brentius/cansat-sync/wiki/references/README.md

# Reference material

[PDR mark scheme](pdr_mark_scheme_reference.pdf) is the retained local reference copy. Confirm its season and applicability before treating it as current competition requirements. The [archived review materials](../history/working_materials/README.md) contain a duplicate PDF and page images, preserved for provenance.

The project's external reference folder is [CANSAT 2027 on Google Drive](https://drive.google.com/drive/folders/1ugYnjOalW-hIZqXO9nSJtGS6KleoJ3KW). It is not a local mount or automatic sync. This housekeeping pass did not fetch or verify its contents.

Keep source documents here and interpretation in the main wiki. Record source dates and applicability when adding references.
