brentius/cansat-sync/wiki/history/working_materials/proposal_body.md

# Mission Proposal: Terrain-Relative Navigation and Wind Profiling

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

## 1. Summary

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

## 2. Motivation and framing

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

## 3. Scientific value

### Questions and hypotheses

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

### Physical model and limits

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

$$
\mathbf w(s)=\mathbf u(s)+\ell_\tau\,\frac{d\mathbf u}{ds}.
$$

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

## 4. Mission objectives and success levels

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

**T4 — stretch:** demonstrate uncertainty-aware safe-target selection without steering or an actual divert.

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

## 5. Ambition ladder

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

## 6. Rules and preliminary compliance

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

## 7. Concept of operations

| Phase | Intended activity | Verification dependency |
|---|---|---|
| Preparation | Obtain launch-site orthoimage, calibrate camera/extrinsics/probe, build maps/prediction tables, configure radio and ground logs | Real imagery, calibrated build and confirmed rules/channel |
| Pad waiting, up to 3 h | STM32 primary/housekeeping logs; Pi idle or controlled startup; independent GNSS and ground anemometer available as planned | Endurance, boot and ground-support rehearsal; no GNSS pose seeding of TRN |
| Ascent | High-rate STM32 IMU/pressure logging and capture; retain event history; camera start policy tested | Firmware/event detection and shock qualification outstanding |
| Ejection and inflation | Trigger camera; log full-field frames and STM32 trigger times; establish swing-averaged tilt reference | Settling/event definitions and frame association measured |
| First fix | Search unknown heading/position, refine pose and confirm agreement over two distinct images | T1 clock starts at defined canopy settling; no promise of a fixed three-image sequence |
| Tracking above 80 m | Fine matcher -> 17-state filter; selected prediction/validity summary to STM32; 1 Hz primary-priority telemetry | Fine matcher, handoff and integrated application remain open |
| Lower altitude | Retain valid available estimates and conservative prediction; proposed visual odometry tested before use | Below-80 m vision is a development item, not an existing switch-over capability |
| Touchdown/recovery | Detect/log candidate touchdown; beacon; save ground records before attempting recovery | Accelerometer/contact and independent GNSS/time evidence cross-checked |
| Analysis | Synchronise records; score primary, acquisition, tracking, wind and prediction; label missing/invalid observations | Raw logs retained; simulation truth never substituted for missing flight measurements |

## 8. System architecture

### Hardware/data path

```mermaid
flowchart TD
  BAT[Protected 2S pack / master switch / protection] --> AON[Independent 3.3 V supply]
  BAT --> PI5[5.1 V buck / controlled Pi load switch]
  AON --> MCU[STM32F405 on MAIN]
  AON --> RF[Top RF: MAX-M10S and E22]
  AON --> TEMP[Quiet 3.0 V: external NTC / OPA333 / ADS1115]
  IMU[BMI088 and MS5611 on MAIN] --> MCU
  TEMP --> MCU
  RF -->|GNSS PVT and PPS; radio interface| MCU
  MCU --> NOR[Independent SPI NOR sensor/event log]
  PI5 --> PI[Side-mounted Pi Zero 2 W]
  MCU -->|Buffered UART 230400; captures/integrals| PI
  PI -->|Selected navigation/prediction and heartbeat| MCU
  MCU -->|Level-shifted XTR; TIM2 capture| CAM[Bottom IMX296 GS camera]
  CAM -->|Zero-specific CSI cable| PI
  PI --> SD[256 GB microSD: images / maps / processed log]
  MCU -->|40-byte primary-priority packet via E22| GROUND[Receiver / laptop / graph and map logs]
```

### Primary software path

```mermaid
flowchart LR
  S[MS5611 and external NTC readout] --> C[STM32: calibration / compensation / timestamps]
  C --> L[Independent sensor log]
  C --> P[1 Hz packet: temperature and pressure]
  P --> R[E22 radio]
  R --> G[Ground decode / CRC / timestamps / save]
  G --> A[Pressure and temperature graphs / altitude analysis]
```

### Secondary software path

```mermaid
flowchart TD
  MAP[Prepared site map and calibrated optics] --> ACQ[Coarse heading/position search / pose solve / confirmation]
  IMG[CSI frames linked to STM32 trigger times] --> ACQ
  ACQ -->|Confirmed first pose; handoff to implement| NAV[17-state ESKF]
  IMG --> MATCH[Fine matcher: integration outstanding]
  MAP --> MATCH
  MATCH --> NAV
  I[STM32 cumulative IMU integrals and pressure] --> NAV
  NAV --> PRED[TRN wind / landing predictor]
  NAV --> LOG[Pi navigation/quality log]
  PRED --> LOG
  LOG --> SCI[Post-flight smoothing / S1 and conditional S2-S4]
  GNSS[Separate GNSS PVT reference] --> COMP[GNSS comparison predictor and truth log]
  COMP --> SCI
  PRED --> TX[Selected summary to STM32 radio packet]
```

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

## 9. Map preparation

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

## 10. Map-relative localisation

### Rectification and optics

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

### Acquisition implementation

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

### Tracking and low altitude

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

## 11. Navigation filter

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

## 12. Error budget and uncertainty

The first-order design model is

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

## 13. Landing prediction

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

## 14. Safe-target selection — stretch

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

## 15. Hardware, mechanics and budgets

| Assembly | Selected parts / function |
|---|---|
| MAIN | STM32F405; BMI088; MS5611; ADS1115/OPA333/150 kOhm temperature readout; independent converters/quiet LDO; Pi switch/buffers; W25Q128; sounder/LEDs |
| RF | MAX-M10S and active GNSS antenna feed; E22-900M22S and FPC radio antenna |
| Bottom | Official IMX296 GS camera, Edmund lens/adapter/lock nut; CSI directly to Pi, XTR from STM32 |
| Side | Pi Zero 2 W, Zero CSI cable and 256 GB microSD; buffered UART and switched power from MAIN |
| Power / harness | Protected KeepPower 2S pack, accessible E-Switch master switch, XT30 harness, GH connectors, MAIN J4 Wuerth 61202021621 and keyed IDC ribbon mates |
| Mechanics / recovery | Enclosure/frame, optics/window/probe shield, fasteners, cable retention, passive canopy/lines/swivel/hardpoint: not completely designed or qualified |

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

## 16. Software and implementation status

| Function | Target / candidate implementation | Status |
|---|---|---|
| STM32 sensor/timing/power/radio firmware | C/C++; captured sensor/PPS/XTR timing, watchdog, independent logging/1 Hz telemetry | Not implemented |
| Pi sensor/time link | `link.py`, cumulative IMU differencing, trigger association; 230400 baud | Python reference/golden vectors; laptop only |
| First fix | `coarse.py`, `firstfix.py`; 1 m/px map and two-image confirmation | Synthetic validation; Pi timing and real terrain outstanding |
| Tracking/navigation | Fine matcher + `eskf.py`; nominal 100 Hz propagation, image updates as budget allows | Filter exists; fine matcher/handoff/full flight application incomplete |
| Wind / landing | `windprofile.py`, `landing.py`; selected predictor to STM32 | Synthetic component/closed-loop studies; hardware untested |
| Radio/ground data | `telemetry.py` defines 40-byte packet | Reference encode/decode; actual radio/ground integration incomplete |
| Capture/logging/ground UI | Camera setup, bounded queues, save raw frames/quality; laptop graphs/maps | Full application and sustained writes unverified |
| Low-altitude odometry / T4 | Optional future modules | Not implemented flight capability |

Python/NumPy is the current candidate navigation stack. OpenCV or a compiled implementation may support calibrated image processing after profiling; they are not evidence of target execution. Capture cadence, matcher latency, filter update timing and logging throughput must be budgeted independently. Temperature readout also has an unresolved constraint: the <=6% excitation goal conflicts with the study's 128 SPS/10 Hz paired-read bench schedule (~19.41% duty). Resolve settling/rate/self-heating before firmware adoption.

## 17. Verification campaign

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

## 18. Risks and degradation

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

## 19. Results analysis

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

## 20. Roles and support

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

## 21. Schedule and decision gates

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

## 22. PDR and outreach evidence

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

## 23. Outstanding decisions and evidence

- Confirm current-season rulebook/rubric/deadlines, regional/final launch sites, channel allocation and parachute mass treatment.
- Obtain representative orthoimages and check permissions/datum/extent; nearest atmospheric reference sources remain to be selected.
- Prove selected lens/adapter infinity focus, retention, envelope and calibrated ray mapping.
- Measure Pi capture/matching/logging worst-case performance; finish firmware, fine matcher and acquisition-filter handoff.
- Choose/qualify passive canopy and complete mechanical/material/access design; weigh full assembly and obtain delivered flight quotes.
- Resolve thermistor pulse/read schedule against <=6% duty, installed response and science precision; no TMP117 substitution without redesign.
- Secure/select the ground reference instrument/support and calibrate any proposed lateral-force airspeed correction.
- Test GNSS receiver dynamics and independent touchdown scoring; a GNSS feed defined by the protocol is not yet integrated hardware.
- Agree actual student ownership, available hours, support and outreach dates.

## Mathematical appendices: interpretation for the current design

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

---
