brentius/cansat-sync/wiki/mainboard_placement.md

# MAIN placement — 4 October 2026

**Historical placement snapshot (4 October 2026).** These coordinates and zero-routing statements describe that saved review state only. The later 11 October inspection recorded discrepancies between this note and the then-saved PCB; consult [the current mass/power report's discrepancy register](mass_power_budget.md) and inspect the current board before using dimensions or coordinates for manufacture. The purchasing authority is the [flight-computer BOM](flight_computer_bom.md); see [design baseline](design_baseline.md).

Updated `pcb/cansat_control/cansat_control.kicad_pcb`. This is component placement only: **zero track segments and zero routed vias**. All 124 original components remain on the front side, with their original footprint assignments, pad geometry, component IDs and net assignments.

## Mechanical arrangement

- Expanded the original 40 × 60 mm board to the authorised **44 × 65 mm** to accommodate the shrouded RF header, harness access, mounting clearances and local circuit groups on one assembly side.
- Outline: X = 78–122 mm, Y = 67.5–132.5 mm. Geometric centre: (100, 100) mm.
- BMI088 U2: **(100, 95) mm**, exactly **5 mm toward the top** from the centre and centred left-to-right, following the user's final correction. Orientation is 270° (KiCad may display −90°); use the final assembly orientation when defining sensor-to-camera/body axes.
- H1/H2/H3/H4: (81, 70.5), (119, 70.5), (81, 129.5), (119, 129.5) mm. Hole centres retain the original **3 mm edge inset**, now symmetric on the enlarged board. The mounting pattern is 38 × 59 mm; update any mating mechanical model to these coordinates.
- Every footprint courtyard is inside the outline, and every copper-pad bounding box has at least 0.5 mm edge clearance. There are no overlapping front-side courtyards.

## Placement intent

The RF ribbon connector spans the top region. Camera and optional compass connectors and the debug pads are accessible above it. The analogue temperature circuit and flash occupy the upper-left region, with the pressure sensor above the IMU. The MCU sits below the IMU, with the crystal to its right and VCAP/decoupling capacitors at their associated pin banks. Clock source resistors remain close to their MCU source pins.

The 3.3 V buck is at the upper right; the 5.1 V buck, input protection and Pi load switch occupy the lower region. Both converters have adjacent inductors and input/output capacitor groups. The Pi harness is on the right and the recovery sounder is on the left. These placements reserve short local power/clock connections; routing and return-current paths still need to be designed.

Small component references are available on F.Fab. Major devices and connectors have visible silkscreen references. No package substitutions or schematic edits were made.
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
