brentius/cansat-sync/wiki/mathematics_simulation_audit.md

# Mathematical simulation and feasibility audit

1 October 2026. All physical results below are **simulated**, unless explicitly labelled as measured host timings. No flight measurements were available.

The tested mathematics is consistent under its stated models. The core estimation calculations are small enough to be credible CanSat candidates, and an excessive-memory reference matcher has been fixed. **Real-flight feasibility is not established:** canopy/suspension response, terrain/map errors, correspondence integrity, sensor timing and compute throughput on the current Raspberry Pi Zero 2 W remain unmeasured. The independent models are not a complete image-to-navigation-to-wind flight pipeline. Current component choices and the distinction between current design targets and unverified
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
