brentius/cansat-sync/sim/maths/attachment_audit/coverage-50.png

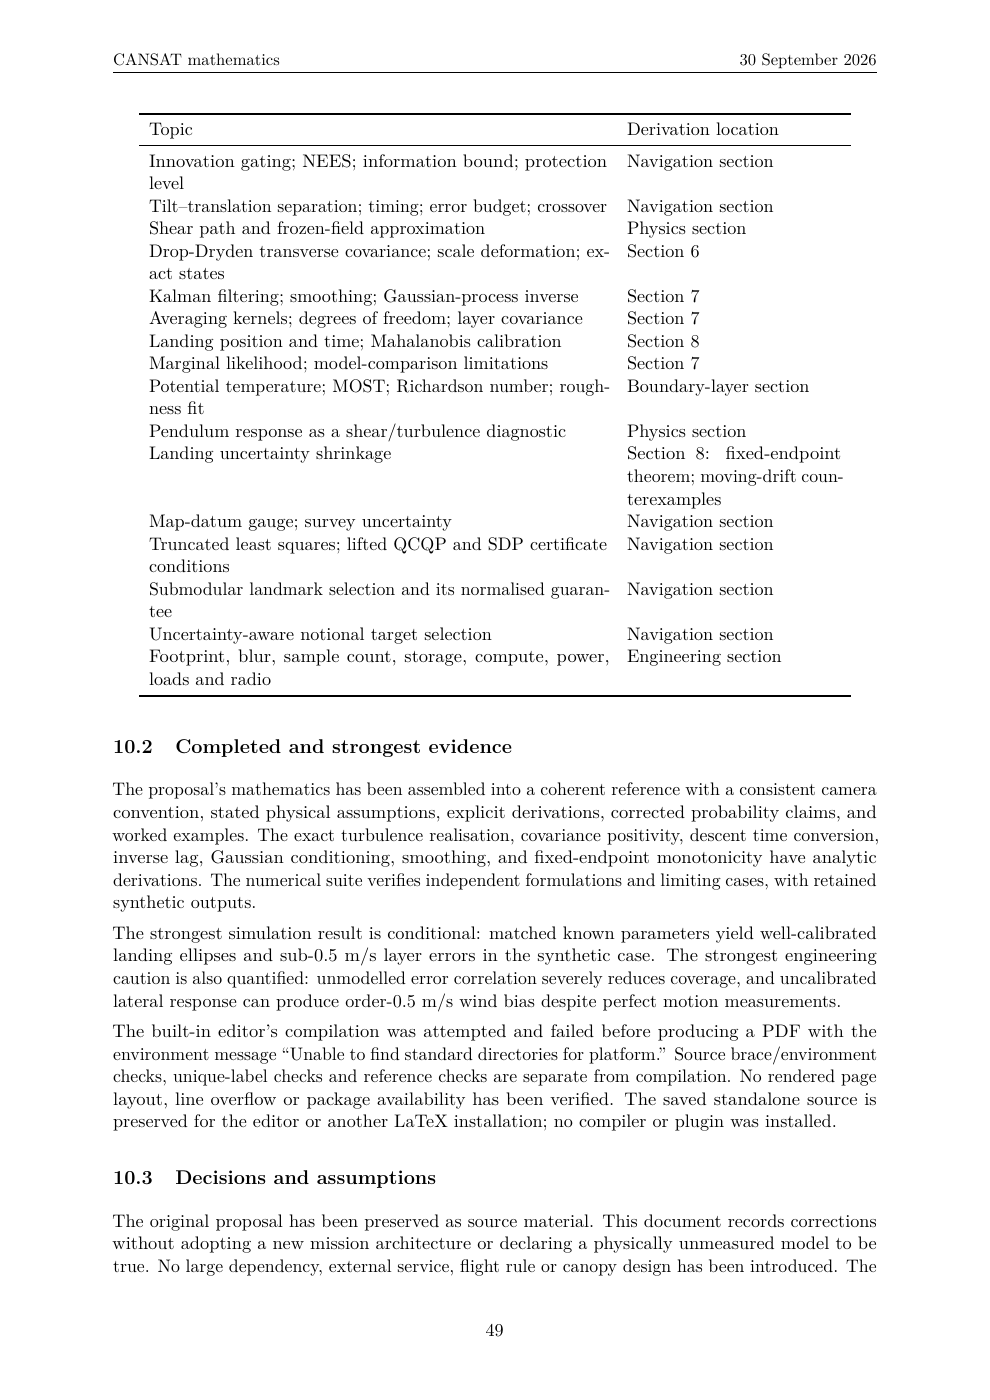
sim/maths/attachment_audit/coverage-50.png
