brentius/cansat-sync/sim/maths/attachment_audit/navigation-22.png

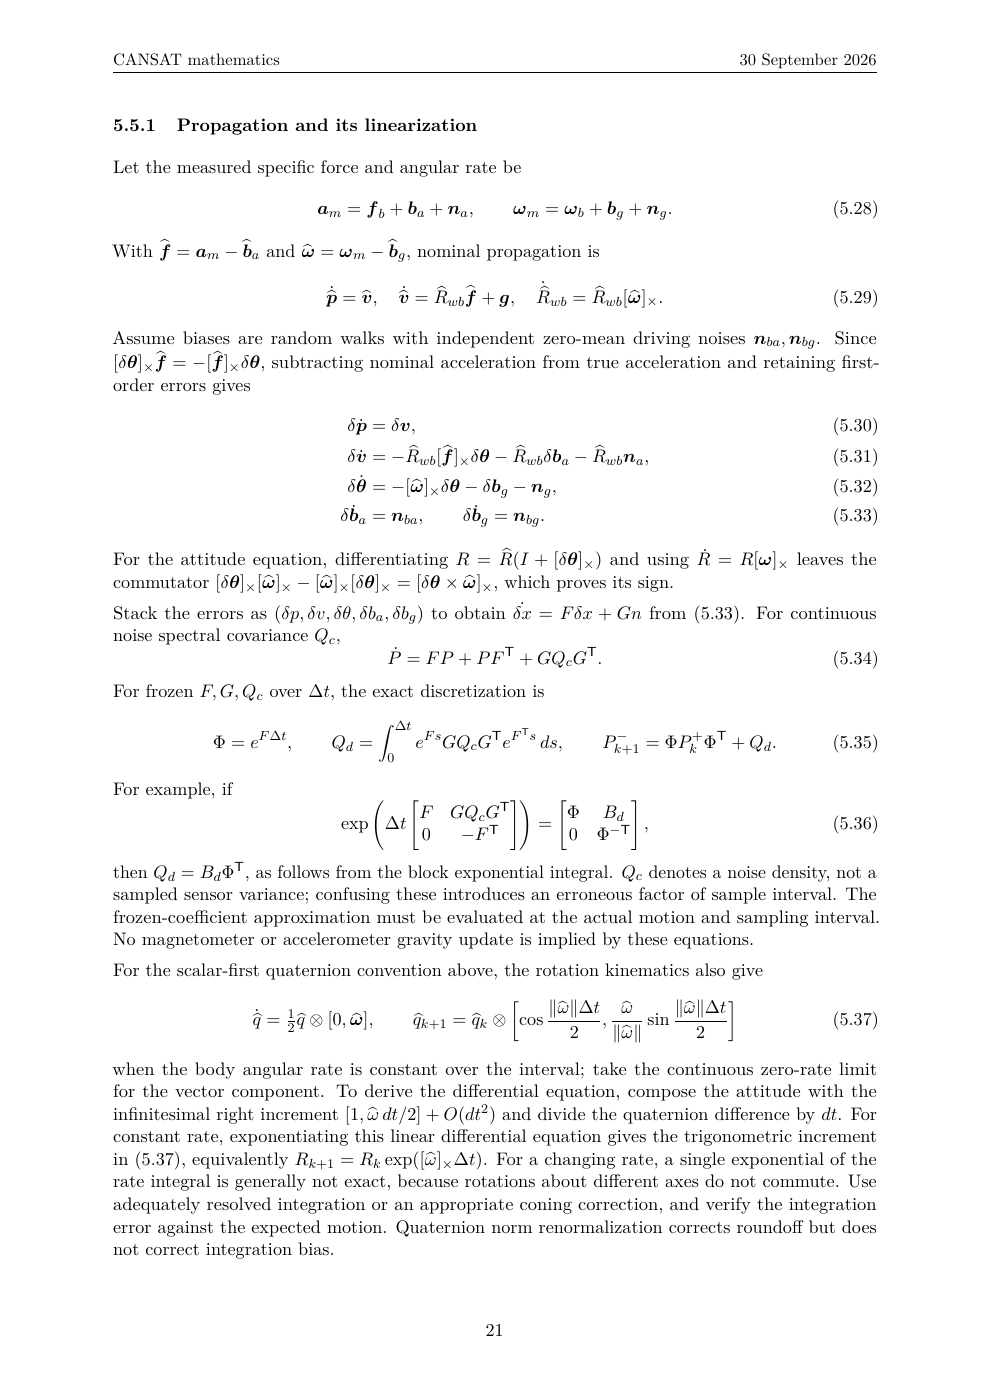
sim/maths/attachment_audit/navigation-22.png
