brentius/cansat-sync/sim/maths/attachment_audit/turbulence-34.png

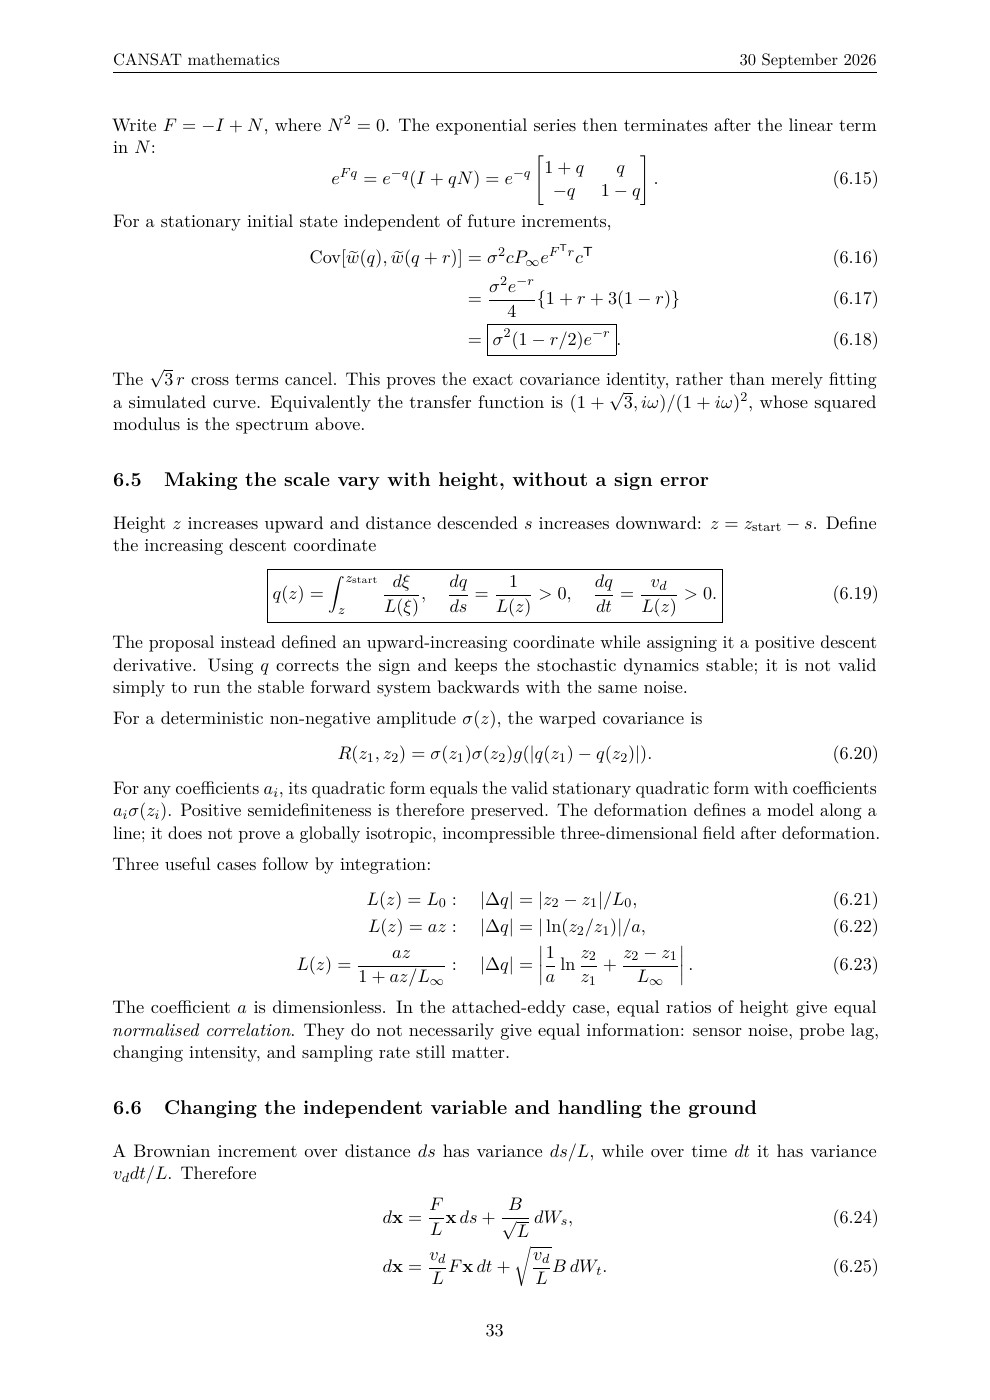
sim/maths/attachment_audit/turbulence-34.png
