brentius/cansat-sync/wiki/history/working_materials/README.md

# Archived working materials

Moved out of the repository-root `tmp/` directory on 26 October 2026. These are retained editorial and review artifacts, not current design authority. All seven original files were moved without changing their bytes; [the relocation manifest](relocation_manifest.json) records their original paths and SHA-256 hashes.

- `proposal_body.md`: retained proposal draft. Its relative links were written for `wiki/` and are preserved as originally saved. Read the [current proposal](../../trn_secondary_mission_proposal.md) for live work.
- `pdfs/pdr_mark_scheme.pdf`: retained review copy, byte-identical at relocation to the [reference PDF](../../references/pdr_mark_scheme_reference.pdf).
- `pdfs/rubric-1.png` through `rubric-5.png`: retained rubric page images.

The archive date describes this relocation, not the creation date or rules season of the source material. The rubric's applicability to the current season still needs confirmation.
