brentius/cansat-sync/wiki/flight_computer_bom.md

# Flight computer component BOM

**Board allocation revised 22 October 2026:** the user selected separate **POWER** and **MAIN** PCBs. The [all-board BOM summary](board_bom_summary.md) assigns every existing fitted control-board component exactly once: POWER 35, MAIN 76, plus the separately planned RF electronics. It defines the required POWER–MAIN signals and additional interconnect allowance. The older "Middle MAIN" component tables below retain their combined-board selections and purchasing allowances; use the summary for the revised per-board allocation and exact saved quantities. The saved KiCad control project has not yet been split into two designs.

Prepared 1 October 2026; revised 3 October 2026 against the **installed KiCad 10.0 stock libraries**. This remains the purchasing baseline; the [design baseline](design_baseline.md) summarises current cross-document authority and status. Dated inventory and price observations below are historical snapshots, not live availability. Main computer: Raspberry Pi Zero 2 W. Timing and primary telemetry controller: STM32F405RGT6.

This is a component-selection BOM for your KiCad design, with the necessary support parts included. It is not an assembly upload or a validated schematic. Quantities marked **allowance** need reconciliation against your final schematic; converter capacitor effective values, crystal loading and optical focus still need checking in the actual layout.

The companion [schematic connection guide](flight_computer_connections.md) groups these parts into functional sheets and specifies IC pins, STM32 allocation, power nets and connector pinouts. The user's chosen physical arrangement is a circular top RF board, middle main board, bottom camera module and Pi mounted separately along the side.

**Temperature budget correction:** FP07 is excluded at the user's approximately $200 quote. The analogue prototype now uses TE GA10K3MCD1 at £12.468 including VAT before shipping, conditional on installed air-response testing. A stocked ~$1 TMP117 digital redesign and other choices are detailed in [budget temperature options](temperature_options.md). The **£400 limit is for the whole CanSat**; sensor cost, PCB assembly fees, optics, mechanics, VAT and delivery all need inclusion.

## Physical board allocation

| Assembly | Parts assigned to it |
|---|---|
| POWER PCB | Input fuse/reverse protection/clamp/TVS, both bucks and support, quiet 3.0 V LDO, Pi load switch and battery-voltage divider/filter; 35 existing fitted parts allocated |
| MAIN PCB | STM32 and support, UART buffers, BMI088 and its ferrite, MS5611, temperature ADC/buffer/excitation circuit, SPI flash, buzzer/LEDs and Pi/camera/probe/RF connectors; 76 existing fitted parts allocated |
| Top RF PCB | MAX-M10S, GNSS ferrite/decoupling, complete antenna bias/DC-block network and U.FL; E22 radio with its local supply capacitors and CS/reset/TXEN/RXEN default resistors |
| Bottom camera module | Existing camera/lens assembly; CSI goes directly to Pi, trigger/GND goes to MAIN |
| Side-mounted Pi | Existing Pi Zero 2 W and microSD; power/buffered UART from MAIN |

The older purchasing tables separate the **combined control-board allowance** from RF. The [all-board BOM summary](board_bom_summary.md) now partitions the saved control quantities into POWER and MAIN; do not add those split quantities again to the older combined allowance. The [RF PCB BOM](#top-rf-pcb-gnss-and-radio-bom) includes its complete local support network. The [PCB and inter-board hardware allowance](#pcb-fabrication-and-inter-board-hardware) now covers three fabricated boards and the additional POWER–MAIN interconnect. MAIN J4 is the selected Würth 61202021621 shrouded 2×10 connector; the compatible RF-side half, stack height/cable, mating details, cost and availability remain **not selected or checked**. Inventory snapshots retain their stated dates.

## Mission basis

The local [secondary mission proposal](trn_secondary_mission_proposal.md) calls for GPS-denied terrain-relative navigation during a roughly 30-second, 300–400 m parachute descent: 5 Hz global-shutter imagery, 100 Hz navigation, independent GNSS truth, and fast air-temperature measurements. The supplied [UK guidelines in Drive](https://drive.google.com/file/d/1LubKeC729i9NbmgHwG-wzu4gwhDO1PfJ/view) require 1 Hz temperature/pressure telemetry, three hours of continuous operation, a 66 mm diameter × 115 mm body, 300–350 g total mass, survival of 20 g, and a £400 flight budget. The document is for 2025–26; confirm the 2026–27 rules before freezing the design.

| Constraint | Design consequence |
|---|---|
| Pi Zero 2 W selected by the user | Pi handles camera, image processing and SD logging; the STM32 handles timing, sensors and radio. Its 512 MB RAM makes bounded image/map buffers essential. Achieving 5 Hz TRN remains a benchmark requirement. |
| Primary mission survives vision failure | Separate battery-fed 3.3 V converter powers the STM32, primary sensors and radio. The STM32 can switch off/restart the Pi branch. A shared battery or STM32 failure remains a common failure mode. |
| Camera/IMU alignment target ≤0.5 ms | Hardware camera trigger, IMU data-ready capture and GNSS PPS capture use STM32 timers. Linux arrival timestamps are insufficient. |
| Three-hour endurance | Approximately 24 Wh protected 2S Li-ion pack; efficient buck conversion. This supports a roughly 6 W average load after a conservative combined 20% energy/conversion derating. Runtime is not established until measured. |
| Scientific temperature profile | A small external NTC probe in ventilated, radiation-shielded air, thermally separated from the Pi. Qualify its installed response and calibration; barometer die temperature is only for pressure compensation. |
| Narrow cylindrical enclosure | Mount the 65 × 30 mm Pi vertically: its rectangular diagonal exceeds 66 mm. Use a welded battery pack, retained cables and mechanically secured optics. Fit must be checked in your mechanical model. |
| Passive descent | No motor, servo or deployment drivers are included. |

Power path: **protected 2S pack → master switch → fuse/reverse protection → independent 5.1 V and 3.3 V bucks**. The 5.1 V branch supplies Pi/camera through a controllable load switch. A 3.0 V LDO from the always-on 3.3 V rail supplies the thermistor ADC and buffer.

## JLCPCB stock-check method

Unless explicitly marked **3 Oct**, counts below were read from the live JLCPCB Assembly Parts Library on **1 October 2026**. The replacement BMI088, AO3401A, CUI buzzer, optional LIS3MDL, added gate-clamp Zener and 47 pF GNSS capacitor were checked on **3 October 2026**. Counts are available inventory snapshots, not reserved quantities. Prices are displayed one-unit USD prices, excluding assembly, extended-part fees, shipping and tax. Use the specified manufacturer as well as the part number: cheaper listings with a similar sensor name were sometimes from a different manufacturer. Every selected electronic component below has a checked JLC code; unselected PCB/inter-board hardware is explicitly marked TBD, and offboard purchased assemblies are listed separately.

## KiCad stock-library selection

I checked the actual files under `C:/Users/b_yee23/AppData/Local/Programs/KiCad/10.0/share/kicad/`, and the configured global symbol table includes those default libraries. All **60 unique stock symbol/footprint identifiers** in the assignments below were verified as present. These names therefore refer to your installed library, rather than an online library version that might differ.

Changes for this revision:

- **BMI088 replaces ICM-42688-P** as the baseline IMU: stock symbol and footprint, lower price, vibration robustness and ±24 g launch measurement. The ICM remains a lower-noise alternative requiring a custom symbol/footprint. BMI088 gyro noise is higher; validate attitude performance rather than assuming equal performance.
- **AO3401A replaces AO3407A** for both P-channel MOSFET positions. It has an exact stock symbol, the same SOT-23 G/S/D pin numbering, and ratings suitable for the expected load after thermal/drop review.
- **CMT-8504-100-SMT-TR replaces MLT8530** for recovery audio: an exact stock footprint is installed. Drive at 4 kHz; its 100 dB rating applies at 5 V, not at the selected 3.3 V supply.
- **LIS3MDLTR replaces MMC5983MA** as the optional compass: exact stock symbol/footprint and sufficient range for a calibrated yaw aid. It does not provide the same resolution/noise as the MMC5983MA.

The **TPS22965** remains a custom-symbol exception to retain the 3 A Pi branch's current headroom and controlled ramp. Its standard TI DSG footprint is installed. The stocked-library TPS22917 is limited to 2 A; TPS22993 cannot switch 5.1 V. The **E22-900M22S** remains a custom-symbol/custom-footprint exception: the stock-library RFM95W-868S2 alternative has **zero JLC stock** in the checked listings on 3 October (including C7279189 and C22365863). Do not replace it with the stock RFM95 symbol; the module pinouts and radio drivers differ.

### MAIN and RF IC symbol and footprint assignments

All listed stock symbol and footprint identifiers below were found in the installed library files. A generic or family symbol is appropriate where its pinout matches; set **Value**, **Manufacturer Part Number** and **JLCPCB Part #** to the purchased component, not to the alias name. Library presence is not a substitute for the final datasheet/land-pattern review.

| Purchased part | Stock schematic symbol | Stock footprint / remaining work |
|---|---|---|
| STM32F405RGT6 | `MCU_ST_STM32F4:STM32F405RGTx` | `Package_QFP:LQFP-64_10x10mm_P0.5mm` |
| TPS62130RGTR | `Regulator_Switching:TPS62130` | `Package_DFN_QFN:VQFN-16-1EP_3x3mm_P0.5mm_EP1.68x1.68mm_ThermalVias` |
| TPS62162DSGR | `Regulator_Switching:TPS62162DSG` | `Package_SON:Texas_DSG0008A_WSON-8-1EP_2x2mm_P0.5mm_EP0.9x1.6mm_ThermalVias` |
| TPS7A2030PDBVR | `Regulator_Linear:TPS7A20xxxDBV` | `Package_TO_SOT_SMD:SOT-23-5`; family symbol, set the 3.0 V MPN explicitly |
| TPS22965DSGR | **No exact stock symbol found; custom symbol required** | `Package_SON:Texas_DSG0008A_WSON-8-1EP_2x2mm_P0.5mm_EP0.9x1.6mm_ThermalVias`; include exposed pad 9 and its datasheet connection in the custom symbol |
| SN74LVC2G125DCUR | `74xGxx:74LVC2G125` | `Package_SO:VSSOP-8_2.3x2mm_P0.5mm`; manually assign this **DCU** footprint—the generic symbol has no default. Place both buffer units and the power unit. |
| BMI088 | `Sensor_Motion:BMI088` | `Package_LGA:Bosch_LGA-16_4.5x3mm_P0.5mm_LayoutBorder7x1y_ClockwisePinNumbering` |
| MS561101BA03-50 | `Sensor_Pressure:MS5611-01BA` | `Package_LGA:LGA-8_3x5mm_P1.25mm`; JLC's package label says QFN, but the manufacturer's leadless land pattern is represented by this LGA footprint |
| ADS1115IDGSR | `Analog_ADC:ADS1115IDGS` | `Package_SO:TSSOP-10_3x3mm_P0.5mm`; TI calls DG(S) VSSOP, whereas KiCad names this body/pitch TSSOP |
| OPA333AIDBVR | `Amplifier_Operational:OPA333xxDBV` | `Package_TO_SOT_SMD:SOT-23-5` |
| MAX-M10S-00B | `RF_GPS:MAX-M10S` | `RF_GPS:ublox_MAX` |
| E22-900M22S | **No exact stock symbol found; custom module symbol required** | **No exact stock footprint found; use the Ebyte module's recommended pad drawing**. Resolve the manufacturer pad-12 discrepancy flagged in the connection guide against the purchased module revision. |
| W25Q128JVSIQ | `Memory_Flash:W25Q128JVS` | `Package_SO:SOIC-8_5.3x5.3mm_P1.27mm`; use this wide-body footprint, not the common 3.9 mm SOIC-8 |
| Optional LIS3MDLTR | `Sensor_Magnetic:LIS3MDL` | `Package_LGA:LGA-12_2x2mm_P0.5mm` |

### Support-part assignments

The generic stock symbols below deliberately retain the exact electrical component selections in the purchasing tables.

| BOM parts | Stock symbol | Stock footprint |
|---|---|---|
| All Yageo 0603 resistors, including precision 150 kΩ | `Device:R` | `Resistor_SMD:R_0603_1608Metric` |
| All 0603 MLCCs, including C0G crystal/RF capacitors | `Device:C` | `Capacitor_SMD:C_0603_1608Metric` |
| All 0805 MLCCs | `Device:C` | `Capacitor_SMD:C_0805_2012Metric` |
| MWSA0402S-2R2MT, both bucks | `Device:L` | `Inductor_SMD:L_Sunlord_MWSA0402S` |
| 0451005.MRL fuse | `Device:Fuse` | `Fuse:Fuse_Littelfuse-NANO2-451_453` |
| AO3401A, both P-channel positions | `Transistor_FET:AO3401A` | `Package_TO_SOT_SMD:SOT-23`; pin 1 gate, 2 source, 3 drain |
| AO3400A buzzer switch | `Transistor_FET:AO3400A` | `Package_TO_SOT_SMD:SOT-23`; pin 1 gate, 2 source, 3 drain |
| SMF9.0A unidirectional TVS | `Device:D_Zener` | `Diode_SMD:D_SOD-123F`; set Value to SMF9.0A and retain correct cathode/anode orientation |
| BZT52C8V2 gate-clamp Zener | `Device:D_Zener` | `Diode_SMD:D_SOD-123`; cathode to reverse-protection MOSFET source, anode to its gate |
| BLM21PG221SN1D ferrites | `Device:L_Ferrite` | `Inductor_SMD:L_0805_2012Metric` |
| X50328MSB2GI two-pin crystal | `Device:Crystal` | `Crystal:Crystal_SMD_5032-2Pin_5.0x3.2mm`; do not select the four-pin variant |
| LQG15HS27NJ02D RF choke | `Device:L` | `Inductor_SMD:L_0402_1005Metric` |
| U.FL-R-SMT-1(80) | `Connector:Conn_Coaxial` | `Connector_Coaxial:U.FL_Hirose_U.FL-R-SMT-1_Vertical` |
| BM08B-GHS-TBT(LF)(SN) | `Connector_Generic:Conn_01x08` | `Connector_JST:JST_GH_BM08B-GHS-TBT_1x08-1MP_P1.25mm_Vertical` |
| BM04B-GHS-TBT(LF)(SN), probe/trigger and optional compass | `Connector_Generic:Conn_01x04` | `Connector_JST:JST_GH_BM04B-GHS-TBT_1x04-1MP_P1.25mm_Vertical` |
| Red 0603 LEDs | `Device:LED` | `LED_SMD:LED_0603_1608Metric` |
| CMT-8504-100-SMT-TR | `Device:Buzzer` | `Buzzer_Beeper:MagneticBuzzer_CUI_CMT-8504-100-SMT` |
| SS14 flyback diode | `Diode:SS14` | `Diode_SMD:D_SMA` |
| SWD/rail/reset test pads | `Connector:TestPoint` | `TestPoint:TestPoint_Pad_D1.0mm`; no purchased header |

Battery, Pi, camera, antennas, master switch and thermistor probe are **offboard assemblies**. Represent the pack with `Device:Battery`, master switch with `Switch:SW_SPDT`, and probe with `Device:Thermistor_NTC`, connected through the harness symbols. They need no invented component footprints on the main PCB. The GH housings/crimp contacts are cable parts, not PCB footprints. XT30U-M/F are cable connectors in this BOM; represent their board wiring with suitable wire pads/test points, rather than silently substituting a board-mount XT30 variant.

## Middle MAIN PCB: processors, converters and sensors

All rows have quantity 1 unless shown otherwise. E = Extended assembly part; B = Basic.

| Function | Exact component / package | JLCPCB code, stock, unit price | Why this component |
|---|---|---|---|
| Timing/telemetry MCU | **ST STM32F405RGT6**, LQFP-64 | [C15742](https://jlcpcb.com/partdetail/STMicroelectronics-STM32F405RGT6/C15742): **4,190**, $5.9532, E | 168 MHz Cortex-M4F, 1 MB flash, 192 KB RAM; timers, DMA, SPI and UART capacity comfortably cover timestamping, sensor acquisition, flash logging and independent radio telemetry. More capable than strictly necessary, but well stocked and inexpensive. Use its independent watchdog. [ST specifications](https://www.st.com/content/st_com/en/products/microcontrollers-microprocessors/stm32-32-bit-arm-cortex-mcus/stm32-high-performance-mcus/stm32f4-series/stm32f405-415/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). |
| Pi/camera supply | **TI TPS62130RGTR**, VQFN-16 | [C43590](https://jlcpcb.com/partdetail/TexasInstruments-TPS62130RGTR/C43590): **30,139**, $1.3071, E | Synchronous buck, up to 3 A, compatible with the complete 2S input range. Set about 5.1 V to allow cable drop. Low loss compared with a linear regulator. [TI reference design](https://www.ti.com/product/TPS62130). |
| Independent digital supply | **TI TPS62162DSGR**, WSON-8 | [C40256](https://jlcpcb.com/partdetail/TexasInstruments-TPS62162DSGR/C40256): **6,697**, $1.2794, E | Fixed 3.3 V, 1 A synchronous buck directly from the battery. Keeps STM32, radio and primary sensing operating when the Pi branch is disabled. [TI specifications](https://www.ti.com/product/TPS62162). |
| Quiet temperature supply | **TI TPS7A2030PDBVR**, SOT-23-5 | [C963429](https://jlcpcb.com/partdetail/TexasInstruments-TPS7A2030PDBVR/C963429): **5,909**, $0.2309, E | Fixed 3.0 V low-noise LDO from 3.3 V; powers the ADC and thermistor buffer with little heat. [TI specifications](https://www.ti.com/product/TPS7A20). |
| Pi restart switch | **TI TPS22965DSGR**, WSON-8 | [C122837](https://jlcpcb.com/partdetail/TexasInstruments-TPS22965DSGR/C122837): **16,055**, $0.2468, E | Low-resistance 6 A load switch with adjustable rise time; STM32 controls Pi power and camera power together. Connect its bias supply within the datasheet limits, not to raw 2S. [TI specifications](https://www.ti.com/product/TPS22965). |
| Pi UART isolation | **TI SN74LVC2G125DCUR**, VSSOP-8 | [C21404](https://jlcpcb.com/partdetail/TexasInstruments-SN74LVC2G125DCUR/C21404): **4,894**, $0.2067, E | Two tri-state buffers, one per UART direction. Disable both while the Pi is off to prevent signal-pin back-powering. [TI specifications](https://www.ti.com/product/SN74LVC2G125). |
| IMU, baseline | **Bosch BMI088**, LGA-16, 4.5 × 3 mm | [C194919](https://jlcpcb.com/partdetail/BoschSensortec-BMI088/C194919): **4,457**, $6.7920, E, **3 Oct** | Exact KiCad stock symbol/footprint, vibration robustness, stable gyro bias and ±24 g acceleration range. Suitable for both descent navigation and nominal 20 g launch measurement. Gyro noise is 0.014°/s/√Hz, higher than the original ICM choice; validate the attitude target. Use gyro at about 1 kHz, timestamp both sensor data-ready signals and fuse at 100 Hz. Accel and gyro have separate chip-selects/ODRs; implement Bosch's synchronisation method or timestamp/resample explicitly. [Bosch specifications](https://www.bosch-sensortec.com/en/products/motion-sensors/imus/bmi088), [datasheet](https://www.bosch-sensortec.com/media/boschsensortec/downloads/datasheets/bst-bmi088-ds001.pdf). |
| Pressure, baseline | **TE MS561101BA03-50**, QFN-8, 5 × 3 mm | [C15639](https://jlcpcb.com/partdetail/TEConnectivity-MS561101BA0350/C15639): **1,700**, $6.7059, E | MS5611-01BA03 supplied in the -50 packaging variant. OSR4096 provides 0.012 mbar RMS resolution, approximately 0.10 m near sea level, with 9.04 ms maximum conversion time. Suitable for 50 Hz pressure with slower temperature-compensation updates. Use factory coefficients, PROM CRC and second-order compensation. Internal temperature does not replace the air probe. [TE datasheet](https://www.te.com/commerce/DocumentDelivery/DDEController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). |
| Thermistor ADC | **TI ADS1115IDGSR**, VSSOP-10 | [C37593](https://jlcpcb.com/partdetail/TexasInstruments-ADS1115IDGSR/C37593): **26,547**, $1.2193, E | 16-bit ADC with PGA and up to 860 conversions/s. Measure both excitation voltage and buffered divider voltage so supply drift largely cancels. Enough resolution and rate for the ≤0.1 K relative-temperature goal after calibration. [TI datasheet](https://www.ti.com/lit/ds/symlink/ads1115.pdf). |
| Thermistor buffer | **TI OPA333AIDBVR**, SOT-23-5 | [C30878](https://jlcpcb.com/partdetail/TexasInstruments-OPA333AIDBVR/C30878): **3,884**, $1.3054, E | Low-offset, low-drift unity-gain buffer stops the ADC's input loading from disturbing the high-resistance thermistor divider. [TI specifications](https://www.ti.com/product/OPA333). |
| Independent flight log | **Winbond W25Q128JVSIQ**, wide SOIC-8, 208 mil | [C97521](https://jlcpcb.com/partdetail/WinbondElec-W25Q128JVSIQ/C97521): **51,390**, $2.5523, B | 16 MB SPI NOR records sensors and fault events independently of Linux. Use a rolling preflight buffer and preserve the descent log; it is not enough for three hours of uncompressed 1 kHz logging. [Winbond family](https://www.winbond.com/hq/product/code-storage-flash-memory/serial-nor-flash/). |

## Middle MAIN PCB: electrical support BOM

Counts in this table are **for MAIN only**. Small resistor/capacitor counts marked allowance include reserve positions for decoupling, straps and damping; remove unused positions when assigning designators. RF quantities are listed separately below; the combined quantities of existing components are unchanged. These are real purchasable MPNs, not generic values.

| Qty | Exact component | Value / role and justification | JLCPCB code / checked stock |
|---|---|---|---|
| 2 | Sunlord **MWSA0402S-2R2MT** | Shielded 2.2 µH, 4.5 A rated, 5 A saturation; one per buck. Check ripple, thermal rise and converter frequency against TI's reference circuits. | [C408335](https://jlcpcb.com/partdetail/Sunlord-MWSA0402S2R2MT/C408335), **20,270**, E |
| 1 | Littelfuse **0451005.MRL** | 5 A fuse, **2410** package, battery input fault protection. Not 1206. | [C48467](https://jlcpcb.com/partdetail/Littelfuse-0451005MRL/C48467), **34,890**, E |
| 2 | AOS **AO3401A** | P-channel SOT-23 MOSFET: one reverse-battery protection device; one pulsed thermistor excitation switch. Exact stock symbol. 30 V rating, ≤60 mΩ at −4.5 V gate drive and ≤85 mΩ at −2.5 V. Check reverse-protection voltage drop and temperature at peak input current; its catalogue 4 A rating is not an unconditional board-level current rating. [AOS datasheet](https://www.aosmd.com/sites/default/files/res/datasheets/AO3401A.pdf). | [C15127](https://jlcpcb.com/partdetail/Alpha_OmegaSemicon-AO3401A/C15127), **764,818**, $0.1017, **B, 3 Oct** |
| 1 | MDD **BZT52C8V2** | 8.2 V gate-to-source clamp for the reverse-protection AO3401A, whose gate limit is ±12 V. SOD-123; cathode to source, anode to gate, with the 100 kΩ gate-to-ground resistor. | [C173432](https://jlcpcb.com/partdetail/184821-BZT52C8V2/C173432), **101,308**, $0.0150, **E, 3 Oct** |
| 1 | MDD **SMF9.0A** | 9 V standoff TVS, SOD-123FL; reduces input transients. Its quoted clamp does not by itself prove the complete input survives every surge. | [C123798](https://jlcpcb.com/partdetail/MDD_Microdiode_Semiconductor-SMF90A/C123798), **410**, E |
| 1 | Murata **BLM21PG221SN1D** | 0805 ferrite, 220 Ω at 100 MHz, 2 A; filtered BMI088 supply branch with local capacitors. | [C85840](https://jlcpcb.com/partdetail/MurataElectronics-BLM21PG221SN1D/C85840), **310,648**, E |
| 1 | YXC **X50328MSB2GI** | 8 MHz, 20 pF load, two-pin 5032 crystal; stable MCU timer reference with PPS calibration. No RTC crystal is needed for this mission. | [C115962](https://jlcpcb.com/partdetail/YXC_CrystalOscillators-X50328MSB2GI/C115962), **167,479**, B |
| 2 | Walsin **0603N330J500CT** | 33 pF C0G, 0603, crystal loading starting value. Two 33 pF capacitors give 16.5 pF plus board stray capacitance; final value requires layout/startup review. | [C302065](https://jlcpcb.com/partdetail/Walsin_TechCorp-0603N330J500CT/C302065), **2,295**, E |
| 23 allowance | Samsung **CL10B104KB8NNNC** | 100 nF, 50 V X7R, 0603; local IC supply decoupling. Include every STM32 VDD and VDDA pin and every module supply specified by its manufacturer. | [C1591](https://jlcpcb.com/partdetail/1943-CL10B104KB8NNNC/C1591), **1,744,951**, E |
| 8 allowance | Samsung **CL10A225KP8NNNC** | 2.2 µF, 10 V X5R, 0603; includes **two dedicated STM32 VCAP capacitors**, LDO output and local bulk. Verify effective LDO output capacitance; VCAP must follow ST's reference circuit. | [C1607](https://jlcpcb.com/partdetail/1959-CL10A225KP8NNNC/C1607), **195,011**, E |
| 1 | Samsung **CL21A475KOFNNNE** | **4.7 µF, 16 V X5R, ±10%, 0805**, actual C5 at STM32 VDD. Added 4 October to correct the earlier 2.2 µF VDD-bulk selection to ST's supply scheme; both VCAP capacitors remain 2.2 µF. [Manufacturer specification](https://product.samsungsem.com/mlcc/CL21A475KOFNNN.do), [ST supply scheme](https://www.st.com/resource/en/datasheet/stm32f405rg.pdf). | [LCSC C1746](https://www.lcsc.com/product-detail/C1746.html); part-code mapping checked 4 October. JLC assembly stock/price not independently confirmed. |
| 4 allowance | Samsung **CL10A105KB8NNNC** | 1 µF, 50 V X5R, 0603; LDO input, ADC/barometer bulk and STM32 VDDA decoupling. | [C15849](https://jlcpcb.com/partdetail/16531-CL10A105KB8NNNC/C15849), **6,286,584**, B |
| 4 allowance | Samsung **CL21A106KAYNNNE** | 10 µF, 25 V X5R, 0805; two input capacitors per buck. Check effective capacitance and input ripple. | [C15850](https://jlcpcb.com/partdetail/16532-CL21A106KAYNNNE/C15850), **5,007,032**, B |
| 6 allowance | Samsung **CL21A226MAYNNNE** | 22 µF, 25 V X5R, 0805; two output capacitors per buck and two on the switched Pi supply. Verify effective capacitance and startup/inrush. | [C602037](https://jlcpcb.com/partdetail/631473-CL21A226MAYNNNE/C602037), **83,259**, E |
| 4 allowance | Samsung **CL10B103KB8NNNC** | 10 nF, 50 V X7R, 0603; TPS62130 soft start, load-switch rise-time control, buffered ADC input and battery ADC filtering. Timing values need checking against the final circuit. | [C1589](https://jlcpcb.com/partdetail/1941-CL10B103KB8NNNC/C1589), **1,907,336**, E |
| 1 optional DNP | Walsin **0603N101J500CT** | 100 pF C0G, 0603; reserve buck feed-forward position only if required by TI. Not the GNSS DC block. | [C335544](https://jlcpcb.com/partdetail/Walsin_TechCorp-0603N101J500CT/C335544), **502,070**, E |
| 1 | Yageo **RC0603FR-07806KL** | 806 kΩ, 1%; upper 5.1 V feedback resistor. | [C185311](https://jlcpcb.com/partdetail/YAGEO-RC0603FR07806KL/C185311), **4,642**, E |
| 1 | Yageo **RC0603FR-07150KL** | 150 kΩ, 1%; lower feedback resistor. With 0.8 V reference: 0.8 × (1 + 806/150) = **5.099 V nominal**, including neither tolerance nor regulator error. | [C114660](https://jlcpcb.com/partdetail/YAGEO-RC0603FR07150KL/C114660), **1,106,977**, E |
| 1 | Yageo **RT0603BRD07150KL** | 150 kΩ, **0.1%, 25 ppm/K**; thermistor divider reference, not the looser regulator resistor. | [C326734](https://jlcpcb.com/partdetail/YAGEO-RT0603BRD07150KL/C326734), **17,891**, E |
| 16 allowance | Yageo **RC0603FR-0710KL** | 10 kΩ, 1%; reset, BOOT0/BOOT1, SPI chip-select/WP/HOLD, power-enable/OE, data-ready and power-good defaults. Select default directions deliberately. | [C98220](https://jlcpcb.com/partdetail/YAGEO-RC0603FR0710KL/C98220), **12,185,377**, E |
| 6 allowance | Yageo **RC0603FR-074K7L** | 4.7 kΩ, 1%; two pull-ups on each I²C bus plus ADC ready pull-up. The optional compass shares the pressure bus and its existing pull-ups. Check rise time for your trace/cable capacitance. | [C99782](https://jlcpcb.com/partdetail/YAGEO-RC0603FR074K7L/C99782), **9,331,383**, E |
| 1 | Yageo **RC0603FR-071K5L** | 1.5 kΩ; camera XTR series divider resistor. | [C114668](https://jlcpcb.com/partdetail/YAGEO-RC0603FR071K5L/C114668), **922,091**, E |
| 1 | Yageo **RC0603FR-071K8L** | 1.8 kΩ; XTR divider to ground: 3.3 × 1.8/(1.5+1.8) = **1.8 V**. | [C185354](https://jlcpcb.com/partdetail/YAGEO-RC0603FR071K8L/C185354), **577,230**, E |
| 4 allowance | Yageo **RC0603FR-0733RL** | 33 Ω; two SPI clock damping resistors, buzzer MOSFET gate resistor and one reserve position. | [C108661](https://jlcpcb.com/partdetail/YAGEO-RC0603FR0733RL/C108661), **822,732**, E |
| 5 allowance | Yageo **RC0603FR-07100KL** | 100 kΩ; reverse, temperature and buzzer MOSFET defaults, battery divider upper leg and Pi-TX buffer input pulldown. | [C14675](https://jlcpcb.com/partdetail/YAGEO-RC0603FR07100KL/C14675), **8,549,274**, E |
| 1 | Yageo **RC0603FR-0747KL** | 47 kΩ; battery divider lower leg. 8.4 V input becomes 2.69 V; RC-filter before STM32 ADC and use adequate sample time. | [C105579](https://jlcpcb.com/partdetail/YAGEO-RC0603FR0747KL/C105579), **363,001**, E |
| 3 | Yageo **RC0603FR-07330RL** | 330 Ω; two LED current limits and one buffer-to-ADC isolation resistor. | [C105881](https://jlcpcb.com/partdetail/YAGEO-RC0603FR07330RL/C105881), **1,720,504**, E |
| 1 | Yageo **RC0603FR-0710RL** | 10 Ω, 0603; STM32 VDDA supply-filter resistor. | [C109318](https://jlcpcb.com/partdetail/YAGEO-RC0603FR0710RL/C109318), **5,941,076**, E |
| 1 | JST **BM08B-GHS-TBT(LF)(SN)** | Locking 8-pin Pi harness: three 5.1 V contacts, three grounds, UART TX/RX. GH is rated 1 A/contact; parallel conductors are intentional, not a claim that one contact carries 3 A. | [C133062](https://jlcpcb.com/partdetail/JST-BM08B_GHS_TBT_LF_SN/C133062), **14,397**, E |
| 2 | JST **BM04B-GHS-TBT(LF)(SN)** | Locking 4-pin connectors for camera trigger and thermistor probe. Spare positions permit clean grounding/strain relief. | [C161692](https://jlcpcb.com/partdetail/JST-BM04B_GHS_TBT_LF_SN/C161692), **14,334**, E |
| 2 | Everlight **19-217/R6C-AL1M2VY/6T** | Red 0603 status LEDs; low forward voltage works comfortably from 3.3 V. Distinct blink patterns avoid a display. | [C2986060](https://jlcpcb.com/partdetail/EverlightElec-19_217_R6C_AL1M2VY6T/C2986060), **251,813**, E |
| 1 | CUI / Same Sky **CMT-8504-100-SMT-TR** | Magnetic **4 kHz** recovery sounder with an exact stock footprint. Operates over 1–6 V, so retain the independent 3.3 V supply. Its 100 dB/150 mA specifications are at 5 V: verify actual loudness and current at 3.3 V. Keep away from the compass and allow its 4.5 mm maximum height. [Manufacturer datasheet](https://www.sameskydevices.com/product/resource/cmt-8504-100-smt-tr.pdf). | [C22359707](https://jlcpcb.com/partdetail/CUI-CMT_8504_100_SMTTR/C22359707), **64**, $2.5214, **E, 3 Oct** |
| 1 | AOS **AO3400A** | Logic-level N-channel SOT-23 buzzer switch; avoids loading the MCU pin with the sounder's drive current. Size the 3.3 V rail and local bulk for buzzer pulses. | [C20917](https://jlcpcb.com/partdetail/Alpha_OmegaSemicon-AO3400A/C20917), **967,679**, B |
| 1 | MDD **SS14** | SMA Schottky flyback diode across the magnetic sounder. | [C2480](https://jlcpcb.com/partdetail/MDD_Microdiode_Semiconductor-SS14/C2480), **1,172,259**, B |

All Yageo RC0603 parts above are 0603, 1%, 0.1 W. Keep manufacturer value/voltage/dielectric specifications when substituting cheaper Basic passives. Exposed SWD, reset, ground and rail **test pads** require no purchased header. Do not omit STM32 analogue supply filtering, VCAP parts, thermal pads, regulator pin straps or GNSS supply decoupling when drawing the schematic.

## Top RF PCB: GNSS and radio BOM

Build **one circular RF PCB** at the top of the CanSat. The following components belong on RF, not on MAIN. The old connection-guide names U11/U12 were proposal designators, not current RF references; the saved RF schematic uses RF U1 MAX-M10S and RF U2 E22-900M22S. Each separate KiCad project should carry its own fabrication BOM. There is no second MCU or converter on RF: MAIN supplies +3V3_AON and the STM32 interface signals through the inter-board connector.

### RF receiver and radio modules

Quantity **1 each**. Stock/price dates follow the JLC method above; moving the modules has not refreshed their 1 October inventory snapshots.

| Function | Exact component / package | JLCPCB code, stock, unit price | Why this component |
|---|---|---|---|
| GNSS truth/PPS | **u-blox MAX-M10S-00B**, LCC module | [C4153167](https://jlcpcb.com/partdetail/UBLOX-MAX_M10S00B/C4153167): **665**, $10.7732, E | Low-power multi-GNSS receiver, UART navigation/velocity output and time pulse. Configure an appropriate airborne dynamic model and capture PPS in the STM32. Log velocity as independent wind truth; do not feed GNSS position into the GPS-denied estimator. Dynamic launch validity and velocity accuracy require checking. [u-blox datasheet](https://content.u-blox.com/sites/default/files/MAX-M10S_DataSheet_UBX-20035208.pdf). |
| Telemetry radio | **Ebyte E22-900M22S**, SX1262 SPI module, 20 × 14 mm | [C411293](https://jlcpcb.com/partdetail/Chengdu_Ebyte_ElecTech-E22900M22S/C411293): **408**, $6.9140, E | Integrates the RF matching and oscillator that otherwise complicate the PCB. STM32 handles BUSY/DIO/TXEN/RXEN according to the module manual. Tunable around UK sub-GHz channels; supply must support its transmit pulses. Send compact data, not images. [Ebyte product information](https://www.ebyte.com/product/435.html). |

### RF local support parts

These are quantities **per RF PCB**, already deducted from MAIN's original whole-set allowances. All RF electronic components in this table were stocked in the stated dated checks; the inter-board connector is still TBD in the hardware table.

| Qty | Exact component | Value / role and justification | JLCPCB code / checked stock |
|---|---|---|---|
| 1 | Murata **BLM21PG221SN1D** | 0805 ferrite, 220 Ω at 100 MHz, 2 A; +3V3_AON → +3V3_GNSS filtering. Keep the GNSS capacitors downstream; do not put a ferrite in GND. | [C85840](https://jlcpcb.com/partdetail/MurataElectronics-BLM21PG221SN1D/C85840), **310,648**, E |
| 3 | Samsung **CL10B104KB8NNNC** | 100 nF, 50 V X7R, 0603; two on MAX-M10S (VCC and V_IO) and one beside E22 VCC. Fit locally on RF rather than relying on MAIN decoupling. | [C1591](https://jlcpcb.com/partdetail/1943-CL10B104KB8NNNC/C1591), **1,744,951**, E |
| 2 | Samsung **CL21A106KAYNNNE** | 10 µF, 25 V X5R, 0805; one GNSS bulk capacitor after its ferrite and one radio bulk capacitor. | [C15850](https://jlcpcb.com/partdetail/16532-CL21A106KAYNNNE/C15850), **5,007,032**, B |
| 1 | Samsung **CL21A226MAYNNNE** | 22 µF, 25 V X5R, 0805; local E22 transmit-burst bulk, in parallel with its 10 µF and 100 nF. Verify supply droop at transmit power. | [C602037](https://jlcpcb.com/partdetail/631473-CL21A226MAYNNNE/C602037), **83,259**, E |
| 1 | Samsung **CL10B103KB8NNNC** | 10 nF, 50 V X7R, 0603; GNSS active-antenna bias decoupling at GNSS_ANT_BIAS. | [C1589](https://jlcpcb.com/partdetail/1941-CL10B103KB8NNNC/C1589), **1,907,336**, E |
| 1 | Walsin **0603N470J500CT** | 47 pF, 50 V C0G/NP0, 0603; GNSS antenna DC block following the u-blox integration manual's reference value. | [C302069](https://jlcpcb.com/partdetail/Walsin_TechCorp-0603N470J500CT/C302069), **19,504**, $0.0089, **E, 3 Oct** |
| 4 | Yageo **RC0603FR-0710KL** | 10 kΩ, 1%; two pull-ups (RADIO_CS_N and RADIO_RESET_N) and two pull-downs (RADIO_TXEN and RADIO_RXEN). Fit on RF so the radio has safe defaults with the connector unplugged. | [C98220](https://jlcpcb.com/partdetail/YAGEO-RC0603FR0710KL/C98220), **12,185,377**, E |
| 1 | Yageo **RC0603FR-0710RL** | 10 Ω, 0603; MAX-M10S VCC_RF active-antenna bias-feed resistor per u-blox reference. It is not complete short-circuit protection. | [C109318](https://jlcpcb.com/partdetail/YAGEO-RC0603FR0710RL/C109318), **5,941,076**, E |
| 1 | Murata **LQG15HS27NJ02D** | 27 nH, 0402 RF choke; GNSS antenna bias network. Follow the u-blox RF layout and verify impedance at GNSS frequencies. | [C12669](https://jlcpcb.com/partdetail/MurataElectronics-LQG15HS27NJ02D/C12669), **139,883**, E |
| 1 | Hirose **U.FL-R-SMT-1(80)** | GNSS antenna connector. Ebyte module already has its own antenna socket; do not add another blindly. | [C88374](https://jlcpcb.com/partdetail/HRS_Hirose-U_FL_R_SMT_1_80/C88374), **84,519**, E |

The GNSS module uses the installed `RF_GPS:MAX-M10S` symbol and `RF_GPS:ublox_MAX` footprint. Its passives, ferrite/choke and U.FL use the installed stock assignments above. The E22 needs its own symbol/footprint; **resolve its pad-12 documentation discrepancy against the purchased revision before fabrication**. The E22 already contains its RF matching network, oscillator and antenna socket; this BOM adds no second radio antenna socket, TCXO or external matching network.

Connect the active GNSS antenna to the new RF-board U.FL and the radio FPC antenna to the E22's existing socket. Those two antenna assemblies are purchased once in the offboard table below. Keep both antenna coax connections on RF; the inter-board connector carries only power, ground and digital signals. Keep a continuous ground reference beneath the GNSS feed, and select a manufacturable stack-up/trace geometry for 50 Ω. The GNSS patch looks upward under an RF-transparent lid; the radio FPC remains against the non-metallic side with clearance from cells/Pi. Validate GNSS reception during radio bursts in the assembled CanSat.

**RF module subtotal: $17.6872 ≈ $17.69**, before these support parts, connectors, fabrication, assembly fees, antennas, VAT and delivery. This is a reallocation of the existing GNSS/radio cost, not an extra $17.69 added to the previous IC total.

## PCB fabrication and inter-board hardware

These are purchasing/quote lines for the selected three-board implementation, not JLC component-stock claims. Keep them in the whole-CanSat £400 budget.

| Qty per flight set | Item / allocation | Specification and justification | Selection / cost status |
|---|---|---|---|
| 1 | POWER bare PCB and its assembly | Input protection, supply conversion, Pi load switch and battery-voltage divider/filter; new outline, retention and POWER–MAIN interconnect required. | New fabrication + assembly quote TBD; separate board charges apply |
| 1 | MAIN bare PCB and its assembly | STM32/sensors/logging/recovery and harness connectors; migrate the retained circuits from the combined control project and review outline/holes. | Fabrication + assembly quote TBD; include extended-part fees and any minimum panel/order quantity |
| 1 | Circular top RF bare PCB and its assembly | GNSS/radio and every RF support part listed above. Diameter must fit the actual internal enclosure clearance; 66 mm is the stated external body limit, not an automatic PCB diameter. Select stack-up for the GNSS feed and ground continuity. | Fabrication + assembly quote TBD; separate board design/assembly charges may apply |
| 1 MAIN header; RF mating half/cable TBD | **Würth 61202021621** shrouded 2×10 MAIN J4 | MAIN footprint `Cansat:WR-BHD_61202021621_2x10_P2.54mm` uses manufacturer-recommended 1.1 mm holes. The saved MAIN contact mapping is in the connection guide and completion record. Current rating, matching RF-side half and complete harness remain to be checked against peak load and mechanical spacing. | MAIN header selected; compatible RF MPN/footprint, assembly, JLC availability, cost and cable TBD |
| 1 assembly | POWER–MAIN interconnect, both board endpoints and cable if used | Carries 3.3 V, quiet 3.0 V, switched 5.1 V, ground, Pi enable, converter power-good and battery ADC signals; see the summary for direction and allocation. | MPNs, pinout, current rating, additional local capacitance and cost TBD |
| 1 installed support set | MAIN-to-RF standoffs / screws / retention | Support RF mechanically under launch loads; the electrical connector is not its only retention. Match spacing to connector height and antenna clearance. Do not double-count these in the offboard materials allowance. | Counts, lengths, material, mass and cost TBD from enclosure design; external hardware |
| No purchased part | RF ground / supply test pads | Add GND, +3V3_AON and +3V3_GNSS probe pads for bring-up. Use stock `Connector:TestPoint` / `TestPoint:TestPoint_Pad_D1.0mm`. | Copper features only; no extra header/assembly purchase |

The [physical connection guide](flight_computer_connections.md) specifies the 20 MAIN J4 contacts. The RF-side mating connector and harness endpoint are still unresolved. Leave the SPI clock's 33 Ω source resistor on MAIN; do not purchase another copy on RF. SPI flash also stays on MAIN. The GH parts below remain the Pi/camera/probe harness only.

## Offboard assemblies and hand-fitted parts

These are purchased separately rather than treated as JLC surface-mount assembly parts. External retail stock is not included in the JLC snapshot.

| Qty | Component | Selection and justification | JLC status |
|---|---|---|---|
| 1 | **Raspberry Pi Zero 2 W**, unheadered | Main computer requested by you. Four Cortex-A53 cores and CSI camera interface; omit a tall 40-pin header and retain the power/UART harness mechanically. [Official product](https://www.raspberrypi.com/products/raspberry-pi-zero-2-w/). | Separate assembled board |
| 1 | **Official Raspberry Pi Global Shutter Camera**, Sony IMX296 | Documented external XTR trigger gives a much clearer timing path than an unspecified OV9281 board. 1456 × 1088 sensor; heavier than the September proposal's ~15 g camera, about 34 g before lens. [Official camera](https://www.raspberrypi.com/products/raspberry-pi-global-shutter-camera/). | Separate assembled board |
| 1 | **Pi Zero camera adapter cable**, 150 mm, 22-pin 0.5 mm to 15-pin 1.0 mm CSI | The standard camera-supplied 15-to-15-pin cable does not connect to Pi Zero. Purchase the Zero-specific cable and secure both latches. [Raspberry Pi camera connection documentation](https://www.raspberrypi.com/documentation/accessories/camera.html). | Separate cable |
| 1 | **Edmund Optics #34-711**, 2.5 mm f/2 high-resolution M12 lens | 6.5 mm image circle covers the approximately 6.3 mm IMX296 diagonal; 18 mm lens length suits the small envelope. The simple pinhole/rectilinear estimate is about 90° horizontal; the manufacturer's 125° figure for a different, unspecified sensor width and the stated -36% TV distortion indicate a strongly barrel-distorted mapping. Current optical analysis estimates roughly 110–115° horizontal on the IMX296; use an appropriate fisheye calibration and measure the installed field rather than treating either estimate as a calibrated result. This is a provisional optical choice until infinity focus and adapter clearance are demonstrated. [Lens specifications](https://www.edmundoptics.com/p/2.5mm-fl-high-resolution-f2-micro-video-lens/3949/?PrintPDF=true). | Separate optics |
| 1 each | **Edmund #53-675 C-to-M12 adapter + #64-102 M12 lock nut** | Fits the M12 lens to the camera's supplied C/CS hardware and mechanically locks focus. Verify insertion depth/back focus with the camera before committing the enclosure. [Adapter and accessories](https://www.edmundoptics.com/f/Micro-Video-Imaging-Lens-Accessories/13898/). | Separate optics |
| 1 | **KeepPower protected NCR18650GA 2S1P pack**, supplier SKU **C3-302** | A finished welded, protected pack with two Sanyo GA cells; supplier specifies 7.2 V, minimum 3.3 Ah, 5 A continuous, about 100 g and maximum 19.5 × 37.5 × 67.8 mm. Approximately 23.8 Wh using minimum pack capacity. Protection circuitry is included; do not separately buy loose cells/holders. Balancing is not established by the listing, so use the supplier-approved charging arrangement. [Exact pack listing](https://illumn.com/batteries/18650-keeppower-2s1p-battery-pack-ncr18650ga-3500mah-7-2v.html), [Panasonic cell specifications](https://energy.panasonic.com/eu/business/products/lithium-ion/models/NCR18650GA). | Separate battery; UK sourcing/landed cost needs confirmation |
| 1 pair | **Amass XT30U-M / XT30U-F**, solder connectors | Positive-latching friction power pair, comfortably above expected battery current. Put recessed female contacts on the battery output and add strain relief/insulation. Connect flight-board side through the accessible switch. | Hand-fitted harness |
| 1 | **E-Switch 100SP1T1B1M2QEH**, SPDT toggle used as SPST | Accessible master battery disconnect. Panel-retain inside the permitted body envelope, not as a protrusion through a side wall. Rated DC switching capacity must cover measured input current. | [C273351](https://jlcpcb.com/partdetail/ESwitch-100SP1T1B1M2QEH/C273351): **only 1**, $5.3517; obtain externally for a batch |
| 1 prototype; flight use conditional on qualification | **TE GA10K3MCD1**, 10 kΩ wired micro NTC probe | Budget replacement for FP07. Small 0.5 mm maximum tip with 152 mm fine leads; TE's **200 ms response is in liquid**, so ≤1 s response in the actual shield/airflow is unverified. Keep the existing 150 kΩ reference/ADC/buffer, and calibrate this probe's R(T). [TE specifications](https://www.te.com/en/product-GA10K3MCD1.html), [response condition](https://www.te.com/en/product-CAT-NTC0065.html). [DigiKey UK](https://www.digikey.co.uk/en/products/detail/te-connectivity-measurement-specialties/GA10K3MCD1/5277239): **£10.39 ex VAT / £12.468 inc VAT**, **6,574** shown, checked 3 Oct; delivery extra. | JLC [C3153883](https://jlcpcb.com/partdetail/TEConnectivity-GA10K3MCD1/C3153883): **4**, **$23.8646**, Extended, checked **3 Oct**; external probe, better priced at the checked UK distributor |
| 1 | **Taoglas AGGP.25F.07.0060A**, active GNSS patch/U.FL | Active 25 mm patch simplifies reception on a small board. Follow its ground-plane and mounting guidance and the u-blox antenna-bias reference. Mount looking upward under an RF-transparent lid, away from the converter/Pi. [Antenna datasheet](https://www.taoglas.com/datasheets/AGGP.25F.07.0060A.pdf). | Separate antenna assembly |
| 1 | **Taoglas FXP895.07.0200C**, 868/915 MHz FPC/U.FL | 69.3 × 20 × 0.2 mm, 2 g flexible antenna with 200 mm cable. Fits vertically against a non-metallic body; it will not work correctly behind a metal can wall. Keep clear of cells/PCB and verify the finished antenna match/link. [Manufacturer datasheet](https://www.taoglas.com/datasheets/FXP895.07.0200C.pdf). | Separate antenna assembly |
| 1 | **SanDisk High Endurance 256 GB**, **SDSQQNR-256G-GN6IA** | Pi OS/maps plus raw frames. Full-frame 5 Hz RAW10 is about 9.9 MB/s tightly packed, or 15.8 MB/s in 16-bit storage, before padding/metadata. Three hours at the latter rate is ~171 GB, so 256 GB covers extended tests. V30 rating is useful, but verify sustained logging through the actual Pi interface. [Manufacturer specifications](https://www.sandisk.com/en-ca/products/memory-cards/microsd-cards/sandisk-high-endurance-uhs-i-microsd?sku=SDSQQNR-256G-GN6IA). | Separate storage |
| 1 + 2 | **JST GHR-08V-S** + **GHR-04V-S** housings | Mates for Pi, trigger and probe connectors; genuine GH housings rather than incompatible lookalikes. | External harness parts; no JLC stock claim |
| 16 + spares | **JST SSHL-002T-P0.2** contacts | Crimped GH harness contacts; use the wire gauge allowed by JST and use equal-length parallel power wires. | External harness parts; no JLC stock claim |
| As needed | 26–28 AWG signal wire, power wire sized to XT30/input current, heat-shrink, cable clamps, non-metallic spacers, battery cradle | Wiring and mechanical retention are part of the flight-computer BOM even though cut lengths and fixing counts depend on your enclosure. Avoid spring battery holders for a 20 g launch. | Local mechanical/harness materials |
| 1 fabricated | White ventilated probe radiation shield | Prevent solar/radiant heating without isolating the bead from airflow. Keep within the allowed envelope; validate response in the final installation. | Local fabrication |

The selected battery is a purchase assembly with included protection, not a proposed DIY battery-management circuit. If its sourcing is impractical, a UK pack assembler can supply an equivalent matched-cell, side-by-side **2S1P GA pack, ≥3.3 Ah minimum, ≥5 A discharge, cell-level protection, approximately ≤70 × 40 × 23 mm**. Obtain the pack's actual charging specification and connector arrangement rather than treating all 2S packs as interchangeable.

Charging is offboard, outside the flight BOM. Use a pack-approved **8.4 V CC/CV lithium-ion charger**, no more than the pack's specified 1.7 A standard charge current. A **SkyRC B6neo** can serve as ground charging equipment if the pack is supplied with an appropriate balance harness and its per-cell settings match the pack specification; the listed two-wire pack does not automatically provide that harness. No charger IC or USB power-sharing circuit is needed on the flight PCB.

## Alternatives considered and optional parts

These replace a baseline part or add a stated capability; do not populate every option by default.

| Part | Checked JLC availability | Assessment |
|---|---|---|
| **MS5611**, selected | TE **C15639: 1,700**, $6.7059 | Good altimeter-oriented choice. Its 0.012 mbar RMS is ~10 cm resolution, but absolute error can be ±1.5 mbar at the specified 25°C point, roughly ±12 m near sea level. Tare before launch; it does not guarantee the mission's ~0.5 m relative altitude target across temperature. Use pressure-temperature calibration and validate the installed port. |
| **Bosch BMP388** | [C779278](https://jlcpcb.com/partdetail/BoschSensortec-BMP388/C779278): **5,788**, $5.7695 | Smaller, FIFO-equipped, 1.2 Pa full-bandwidth noise at highest resolution, broadly comparable with MS5611's 1.2 Pa. Its advertised 0.03 Pa noise uses very low bandwidth and cannot be compared directly with a rapidly updated MS5611. Bosch says it is unavailable for new designs and recommends BMP390, which moves it to fallback status. [Bosch datasheet](https://www.bosch-sensortec.com/media/boschsensortec/downloads/datasheets/bst-bmp388-ds001.pdf), [product/lifecycle notice](https://www.bosch-sensortec.com/products/environmental-sensors/pressure-sensors/bmp388/). |
| **Bosch BMP390 / BMP390L** | Genuine Bosch **C5124834 / C2684802: 0 / 0** | Attractive successor with ±3 Pa typical relative accuracy under its specified conditions; unavailable in the checked JLC inventory. Reconsider if stock appears. [Bosch specifications](https://www.bosch-sensortec.com/en/products/environmental-sensors/pressure-sensors/bmp390). |
| **TDK ICM-42688-P** | [C1850418](https://jlcpcb.com/partdetail/TDKInvenSense-ICM_42688P/C1850418): **4,938**, $19.4364, **1 Oct** | Original IMU option: approximately 2.8 mdps/√Hz gyro noise, FIFO and FSYNC; retain as a performance upgrade if BMI088 misses the attitude target. **No exact symbol or footprint found in the installed stock libraries.** It clips acceleration above ±16 g and uses a different driver/pinout. Specify genuine TDK. [TDK datasheet](https://product.tdk.com/system/files/dam/doc/product/sensor/mortion-inertial/imu/data_sheet/ds-000347-icm-42688-p-v1.6.pdf). |
| **ST LIS3MDLTR** | [C478483](https://jlcpcb.com/partdetail/STMicroelectronics-LIS3MDLTR/C478483): **7,673**, $3.7407, **3 Oct** | Optional yaw aid with exact stock symbol and footprint, on a separate daughterboard away from steel cells, converter inductors and buzzer. Supports ±4/8/12/16 gauss, I²C/SPI and 3.3 V operation. Add one GH 4-pin connector/housing and four contacts. Add two 100 nF CL10B104KB8NNNC capacitors (C1 pin 4 to ground, plus VDD decoupling) and one 1 µF CL10A105KB8NNNC bulk capacitor; verify effective bulk capacitance against ST's application circuit. Calibrate hard/soft-iron distortion in the assembled can; magnetic heading is not guaranteed near launch hardware. [ST datasheet](https://www.st.com/resource/en/datasheet/lis3mdl.pdf). |
| **ADI ADXL375BCCZ** | [C579466](https://jlcpcb.com/partdetail/AnalogDevices-ADXL375BCCZ/C579466): **191**, $22.0179 | Optional ±200 g impact/launch recorder if you need measurements above BMI088's ±24 g range. **No exact stock symbol found.** Add its datasheet decoupling and SPI chip-select. Not needed to measure a nominal 20 g launch with BMI088. [ADI specifications](https://www.analog.com/en/products/adxl375.html). |

A BME280 remains adequate for basic primary telemetry, but adding humidity does not solve fast air-temperature response. The external thermistor is retained whichever barometer you select. A second barometer is not needed for this passive mission unless you explicitly want sensor redundancy. A six-axis IMU cannot establish absolute yaw by itself: initialise yaw from a tested magnetometer, a known starting orientation propagated through launch, or a vision orientation search. Include the LIS3MDL daughterboard if the latter approaches do not meet the first-fix target.

## Connections and operating choices that affect the BOM

1. **Timing:** STM32 timer output drives camera XTR through the 1.5 kΩ/1.8 kΩ divider. The official camera requires 1.8 V trigger logic; exposure duration is trigger-low duration plus 14.26 µs. About 485.74 µs low therefore requests 500 µs exposure. Drive trigger inactive/low as appropriate while camera power is absent to avoid back-powering. Apply the documented R11 change only if the camera revision has Q2 populated. Verify exposure timing/frame association with a scope and an optical timing target. [Official trigger documentation](https://www.raspberrypi.com/documentation/accessories/camera.html).
2. **Sensor buses:** dedicate an SPI bus to BMI088, with **separate accelerometer/gyroscope chip-selects and captured data-ready inputs**. Apply Bosch's data-synchronisation configuration or log the two sample streams with separate timestamps; they are not automatically simultaneous. Use separate chip-selects for top-board radio and middle-board flash on SPI2, and validate the short inter-board SPI connection. Put MS5611 on a 3.3 V I²C bus, ADS1115 on a separate bus pulled to its 3.0 V supply. Optional LIS3MDL shares the MS5611 bus. Capture PPS and maintain sequence-numbered, CRC-protected UART packets to Pi. The [STM32-to-Pi link protocol](stm32_pi_link_protocol.md) defines the current framing and recommends 230400 baud; consider 460800 only after a full-load bench test. This supersedes the guide's earlier 921600-baud example. The [connection guide](flight_computer_connections.md) records proposed RF contact mapping; verify the RF endpoint against its saved schematic.
3. **Thermistor:** 3.0 V pulsed excitation → precision 150 kΩ resistor → TE 10 kΩ probe → ground; buffer the divider node. Measure excitation and divider during each pulse. At 25°C the calculated probe dissipation is **3.52 µW** while on; worst-case over resistance is **15 µW**. Duty cycling to ≤6% reduces average self-heating. Allow actual analogue settling and ADC conversions before switching off; validate the temperature range, installed air response and calibration. This probe needs its own R(T) calibration, not FP07 coefficients. See the linked digital option before populating temperature-only electronics if changing implementation.
4. **Pressure port:** use a static-pressure vent protected from direct flow and light. At 10 m/s, air dynamic pressure is about 60 Pa, equivalent to roughly 5 m altitude near sea level—far larger than sensor noise. An airtight box or ram-facing hole defeats either barometer. Timestamp conversion timing and avoid aggressive filters that lag the descent. Confirm JLC's assembly profile meets MS5611's 250°C/40-second solder limit, keep washing/coating out of the port, and allow post-reflow recovery before pressure calibration.
5. **GNSS RF:** use the active-antenna feed circuit and placement from the [u-blox integration manual](https://content.u-blox.com/sites/default/files/MAX-M10S_IntegrationManual_UBX-20053088.pdf). Confirm antenna current is within VCC_RF capability, logic configuration is 3.3 V, and backup supply wiring follows the manual. No separate backup battery is needed. Maintain GNSS as a separately labelled truth data stream.
6. **Radio:** the earlier proposal used **869.525 MHz, LoRa SF7, BW125 kHz, CR4/5, explicit header, CRC, eight-symbol preamble** with a 32-byte payload at 1 Hz (71.936 ms, 7.1936% duty). Current `code/cansat/telemetry.py` sends a **40-byte downlink packet**. The 11 October power budget calculates **82.176 ms (8.2176% at 1 Hz)** for 40 bytes with SF7/BW125/CR4/5. Treat the old 32-byte figure as a historical sizing assumption; it is not the current radio payload. The 32-byte Nav payload in the [STM32-to-Pi link protocol](stm32_pi_link_protocol.md) is a different field set on a different link. Ofcom IR2030/1/19 (official PDF, checked 13 October 2026) permits airborne use in 869.40–869.65 MHz subject to conditions, with a 500 mW ERP maximum and a ≤10% duty-cycle alternative to equivalent spectrum-access/interference-mitigation techniques. The candidate 1 Hz/40-byte airtime is below 10% before retries, but channel allocation, total airtime, ERP, equipment conditions and event requirements still need verification; do not treat the estimate as evidence of compliance. Obtain the organiser's channel allocation and budget all transmissions/retries. [Ofcom IR2030, published 7 April 2026](https://www.ofcom.org.uk/siteassets/resources/documents/spectrum/interface-requirements/ir-2030.pdf).
7. **Boot and power:** primary logging/telemetry starts on STM32 without waiting for Linux. Power the Pi at system switch-on after supply checks, finish Linux/service startup before loading, and leave it powered throughout pad waiting and launch. Idle image processing does not mean Pi power-off; default firmware does not power-cycle on UART silence. Disable UART buffers before removing Pi power. Request clean shutdown where possible and retain a read-only OS plus separate data partition. Do not connect a second USB 5 V source in parallel with your buck without power-source isolation. Log low battery and stop heavy processing before pack protection trips.
8. **Camera processing:** capture the full field then resize for matching rather than blindly cropping to 1280 × 800 and losing ground coverage. The proposed camera/lens changes the original 600 × 375 m footprint; rebuild intrinsics and undistortion maps. Bound image queues, store the map in tiles and measure worst-case first-fix time on the selected Pi.

## Mass, power and cost checks

**Power:** the later [11 October mass/power budget](mass_power_budget.md) is the current estimate: 23.1/19.6/14.8 Wh usable energy across low/typical/high cases, 4.3 Wh typical use for three hours with the Pi idle plus flight and a one-hour beacon, and 335 g expected mass. These are calculated/assumed, not weighed or metered; the current estimate supersedes the rough sizing here. The three-hour full-load case remains a separate risk.

**Mass:** roughly 100 g battery, 10–15 g Pi, 34 g camera, plus lens/adapter, both custom PCBs, inter-board connector/supports, antennas, wires and retention. These leave a plausible allocation for enclosure and parachute under 350 g, but the complete mechanical BOM is not yet weighed. Target about **330 g total** and add securely fixed ballast only if below 300 g. The original proposal's ~20 g camera addition no longer applies. Verify the whole camera/lens/pack stack inside 115 mm before manufacturing the PCB.

**Cost:** the mandatory IC/module rows sum to about **$45.49** across both boards: **MAIN $27.80 + RF $17.69** at the checked one-unit prices, before support parts, the inter-board connector and both PCB fabrication/assembly quotes. This is approximately **$12.64 less** than the previous IC selection because BMI088 replaces ICM-42688-P; the stock-footprint buzzer adds approximately $2.31 elsewhere in the support BOM. Prices mix the explicitly dated 1/3 October snapshots. Optics are significant: the referenced lens is $87.40 and adapter $32.75 before tax/shipping, with the lock nut extra. Do not claim compliance with £400 from IC prices alone: obtain an assembly quote including extended-part fees and a landed UK quote for the battery and optics, then include enclosure/parachute and all flight hardware. A cheaper lens is possible only after verifying image-circle coverage, focus and distortion; an arbitrary CCTV lens is not an equivalent substitution.

The remaining engineering gates are the **5 Hz Pi processing benchmark, three-hour full-system runtime, actual optical focus/fit/calibration, final mass/cost, and final schematic/layout review**. The dated component stock checks cover the selected PCB electronic parts; MAIN J4 is selected, while its compatible RF mating part/cable and fabrication/assembly costs remain unresolved or unquoted. These checks are not evidence that the engineering gates have already passed.

## Saved MAIN completion — 4 October 2026

The MAIN schematic now contains 124 board components, including four mounting holes and optional DNP J5. Actual references and completed support-part wiring are recorded in [MAIN completion](mainboard_completion.md); use those saved references rather than the earlier proposed U numbering. U10 is SN74LVC2G125DCUR and actual U11 is W25Q128JVSIQ.

The RF connector choice is now a short ribbon harness with **Würth 61202021621**, shrouded 2×10, 2.54 mm, on MAIN J4. Its project footprint uses the manufacturer's 1.1 mm recommended holes. No JLC availability or price is asserted for this newly selected header. The female keyed IDC mates and cable are separate harness purchases. [Manufacturer drawing](https://www.we-online.com/components/products/datasheet/61202021621.pdf).

Added C43 100 nF / Samsung CL10B104KB8NNNC and C44 22 uF / Samsung CL21A226MAYNNNE locally at the sounder supply, beyond the original guide's passive allowance. C43 is 0603; C44 is 0805. J2 uses BM08B-GHS-TBT(LF)(SN), J3 and DNP J5 use BM04B-GHS-TBT(LF)(SN). All new component footprints are assigned.
