brentius/cansat-sync/wiki/history/working_materials/pdfs/rubric-1.png

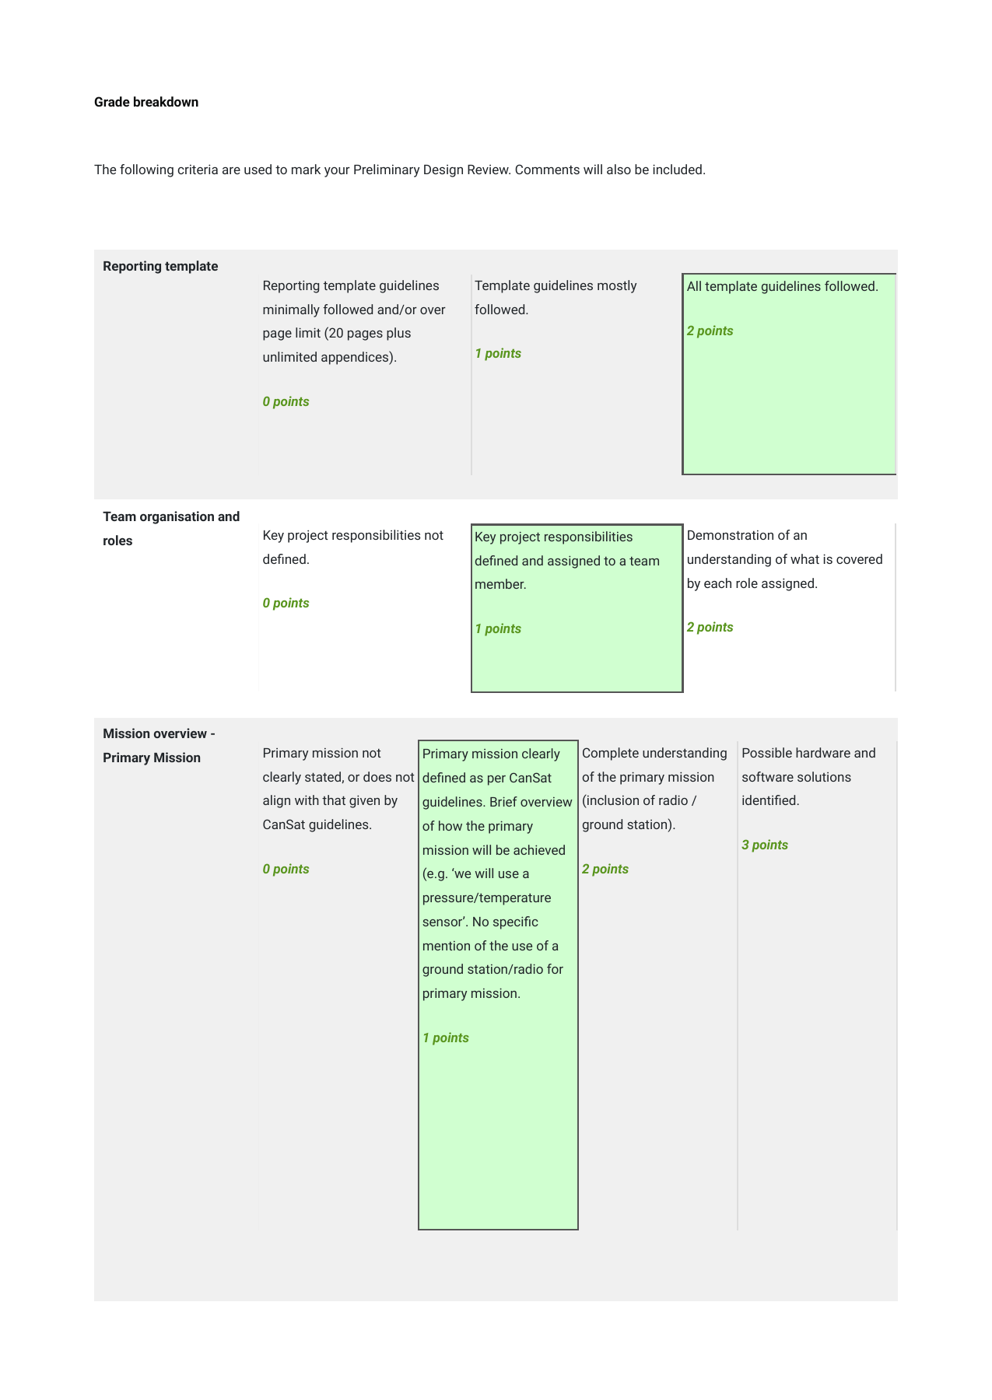
wiki/history/working_materials/pdfs/rubric-1.png
