brentius/cansat-sync/wiki/history/working_materials/pdfs/rubric-2.png

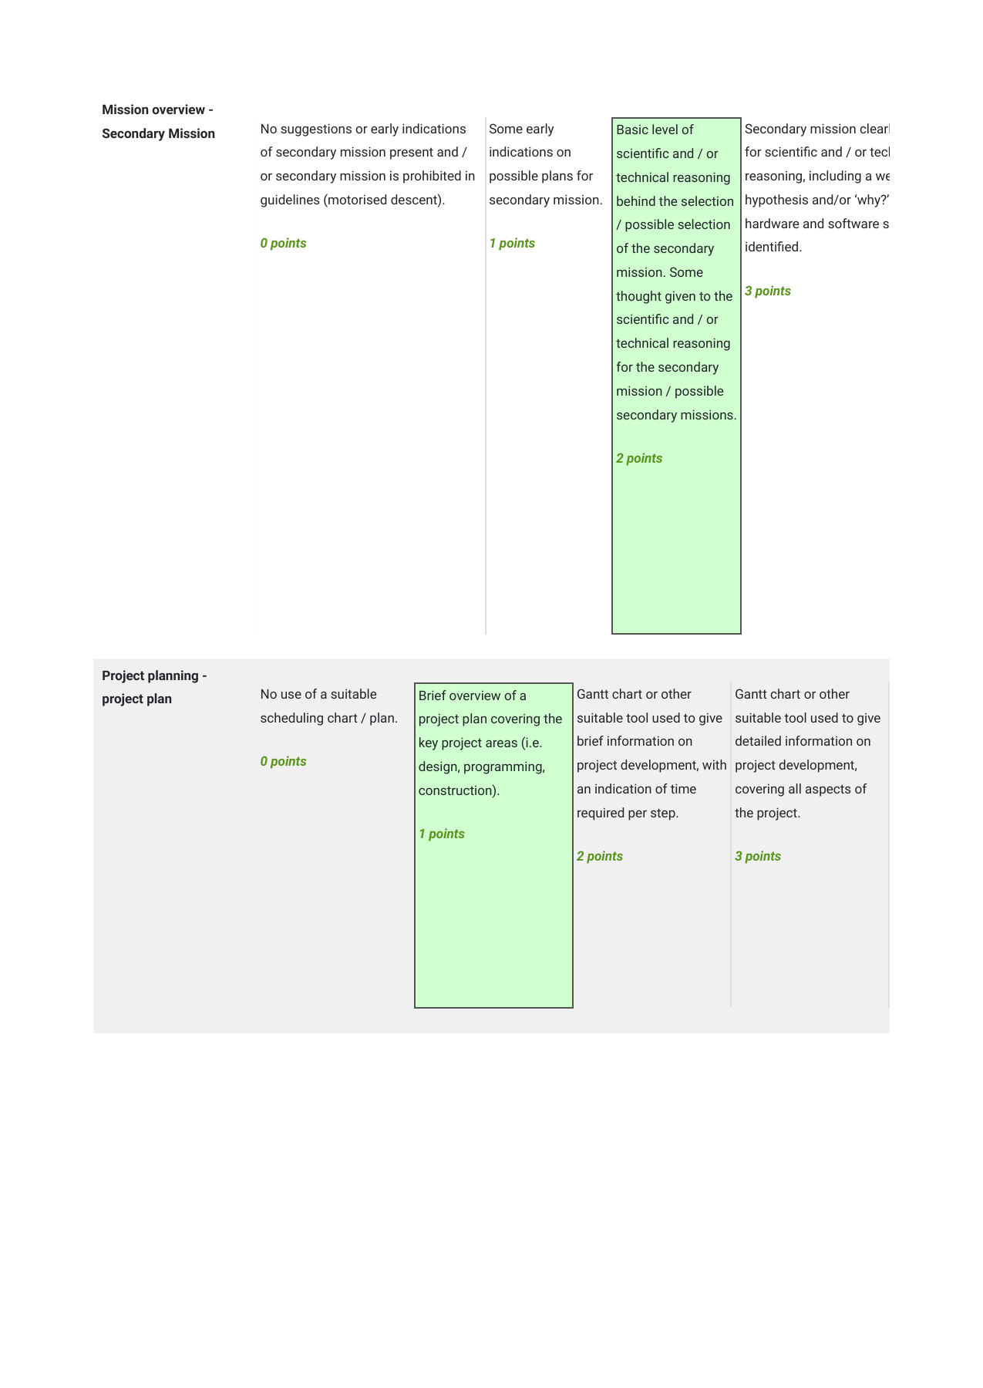
wiki/history/working_materials/pdfs/rubric-2.png
