brentius/cansat-sync/wiki/history/working_materials/pdfs/rubric-3.png

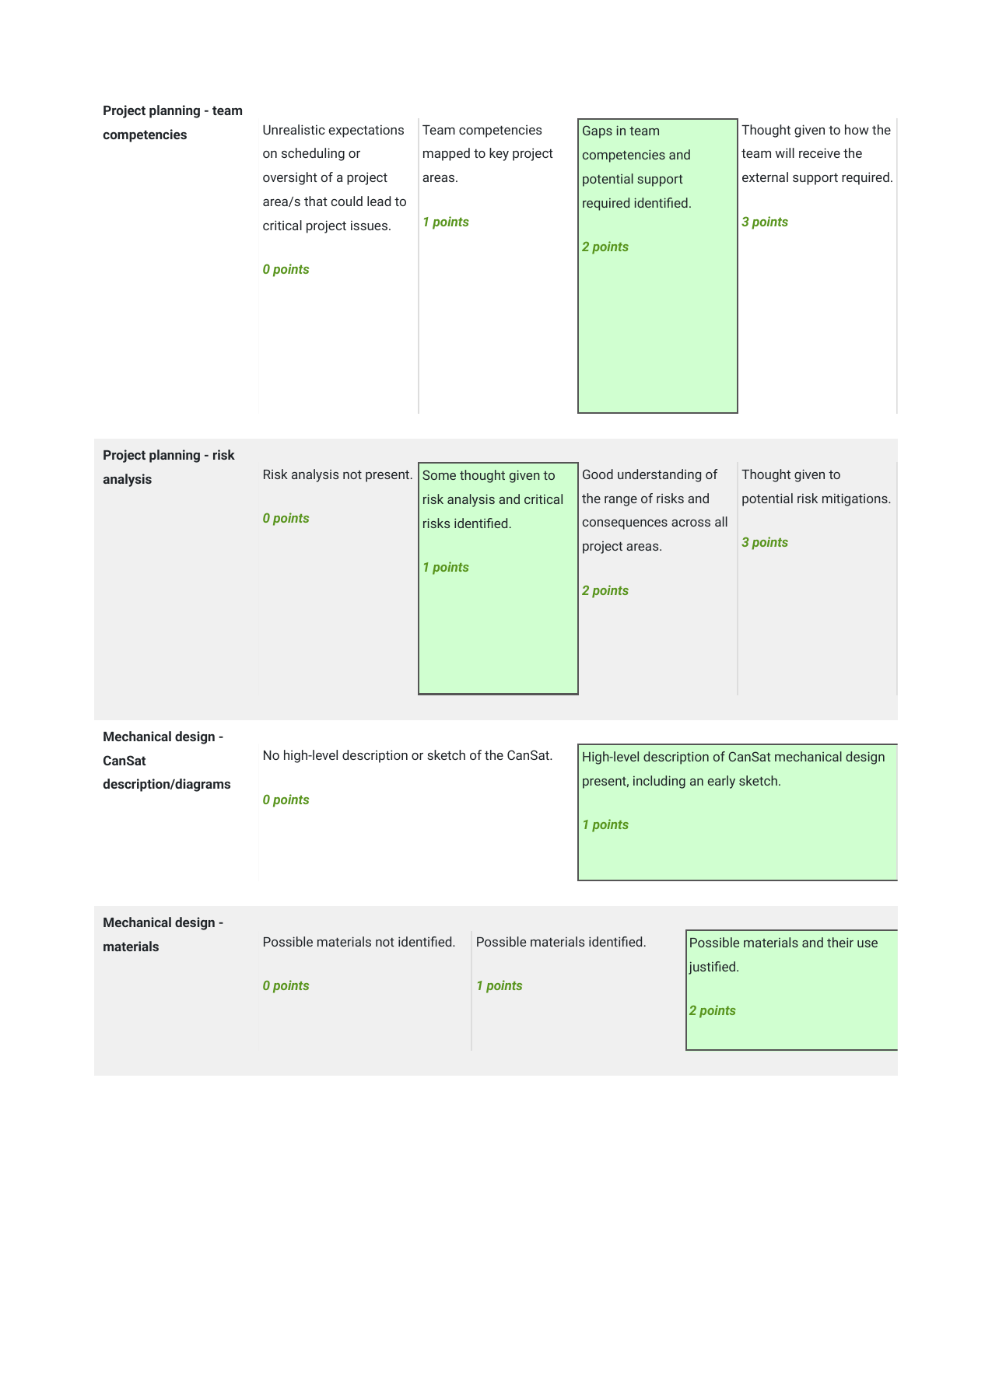
wiki/history/working_materials/pdfs/rubric-3.png
