brentius/cansat-sync/wiki/history/working_materials/pdfs/rubric-4.png

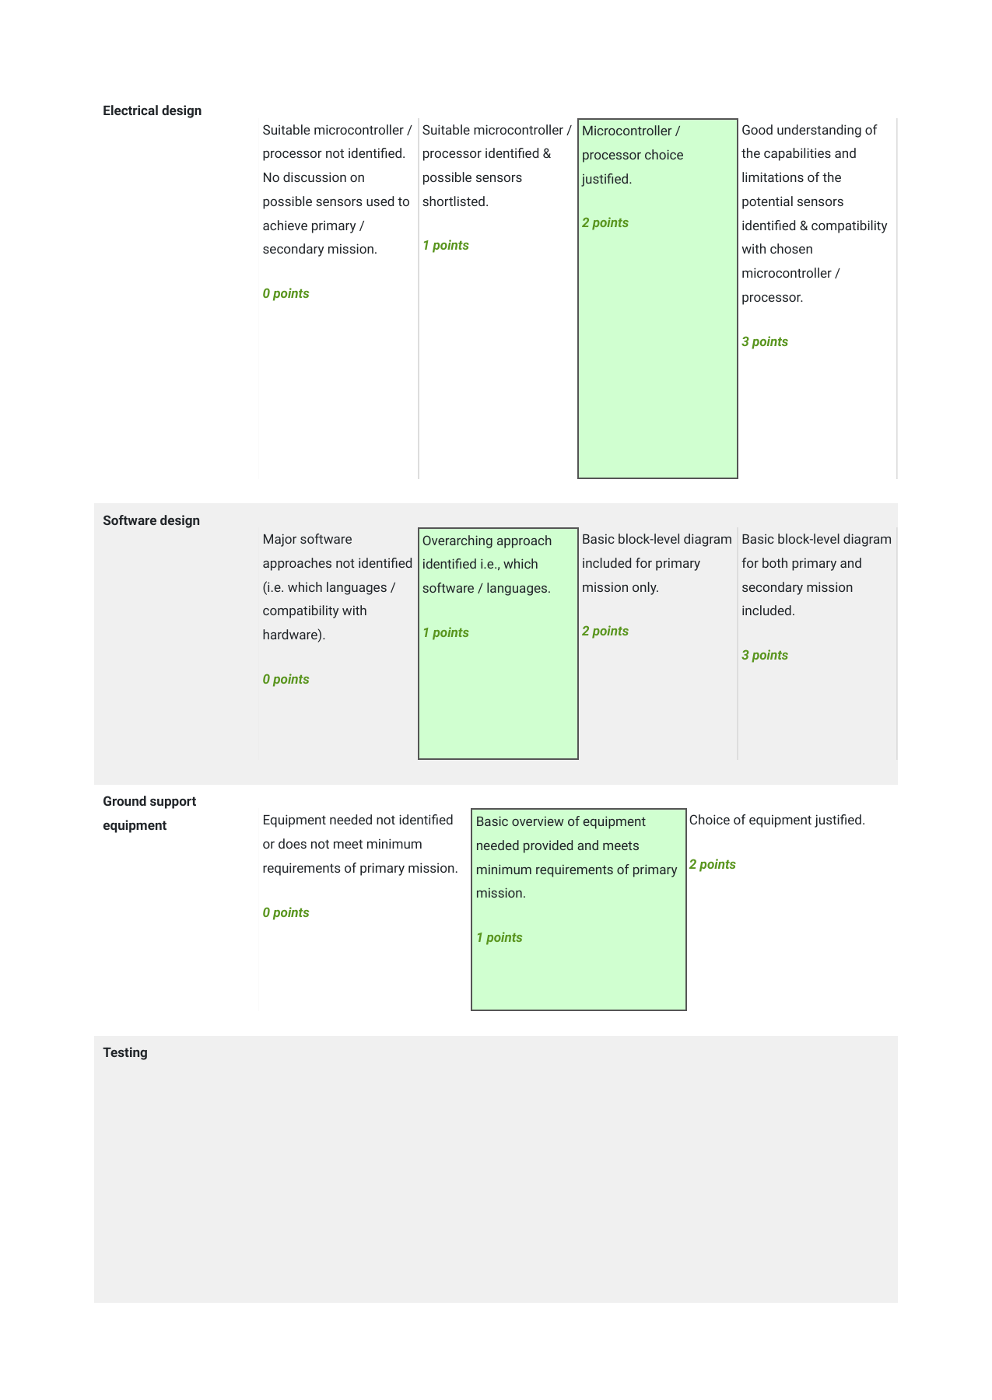
wiki/history/working_materials/pdfs/rubric-4.png
