brentius/cansat-sync/wiki/history/working_materials/pdfs/rubric-5.png

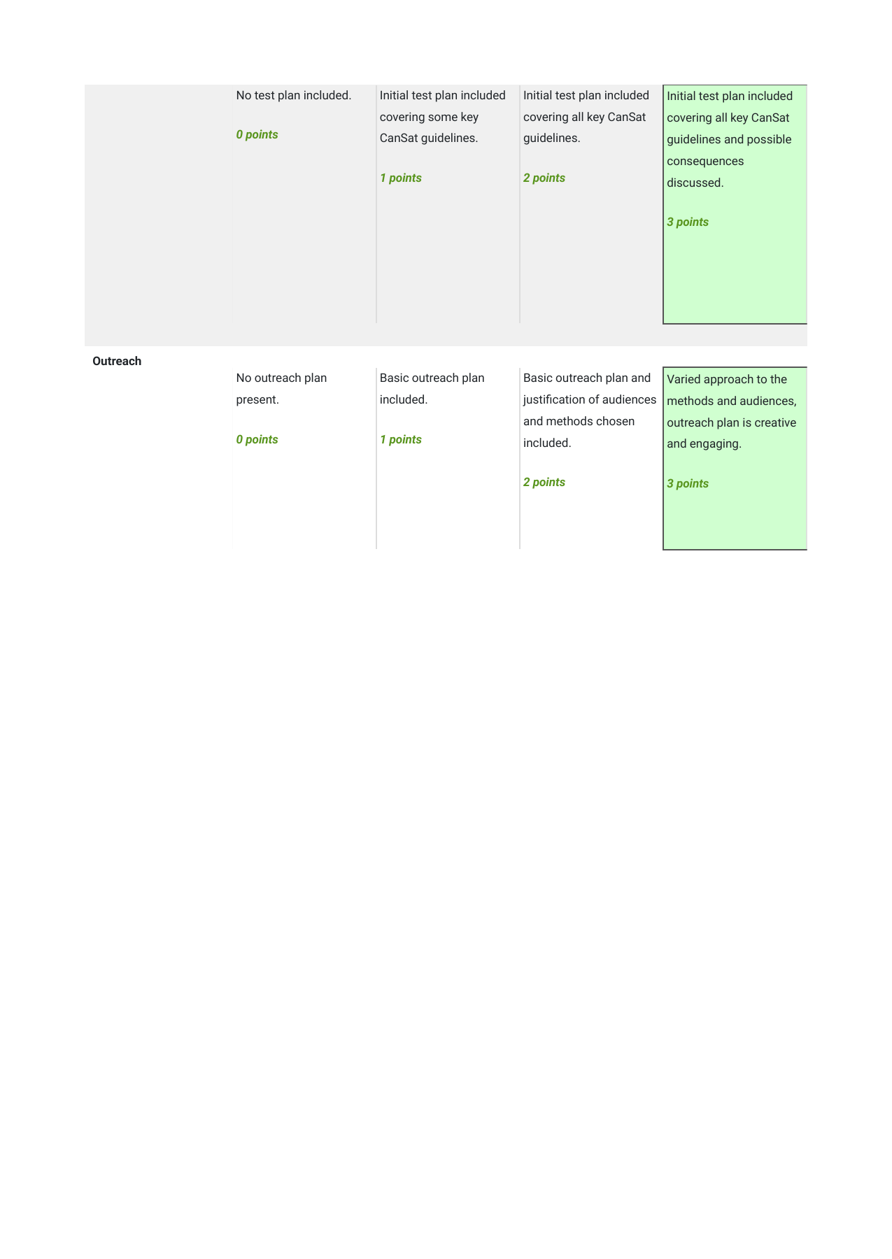
wiki/history/working_materials/pdfs/rubric-5.png
