brentius/cansat-sync/sim/maths/results/attachment_audit/equation_coverage.csv

equation | pdf_page | subsection | family | evidence_level | checks | experiment | restriction
2.1 | 5 | 2.1 Terminal descent and canopy sizing | terminal drag, sizing and sensitivity | representative family check; physical validity conditional | test_feasibility.py:110 test_density_terminal_pressure_and_richardson_jacobians | atmosphere | drag area and mass are uncalibrated
2.2 | 5 | 2.1 Terminal descent and canopy sizing | terminal drag, sizing and sensitivity | representative family check; physical validity conditional | test_feasibility.py:110 test_density_terminal_pressure_and_richardson_jacobians | atmosphere | drag area and mass are uncalibrated
2.3 | 5 | 2.1 Terminal descent and canopy sizing | terminal drag, sizing and sensitivity | representative family check; physical validity conditional | test_feasibility.py:110 test_density_terminal_pressure_and_richardson_jacobians | atmosphere | drag area and mass are uncalibrated
2.4 | 5 | 2.1 Terminal descent and canopy sizing | terminal drag, sizing and sensitivity | representative family check; physical validity conditional | test_feasibility.py:110 test_density_terminal_pressure_and_richardson_jacobians | atmosphere | drag area and mass are uncalibrated
2.5 | 5 | 2.1 Terminal descent and canopy sizing | terminal drag, sizing and sensitivity | representative family check; physical validity conditional | test_feasibility.py:110 test_density_terminal_pressure_and_richardson_jacobians | atmosphere | drag area and mass are uncalibrated
2.6 | 5 | 2.2 Transient and variable descent speed | vertical transient and variable-speed time | representative family check; physical validity conditional | test_models.py:142 test_terminal_descent_vs_ode; test_feasibility.py:196 test_time_height_speed_covariance | atmosphere | instantaneous deployment; quasi-steady density model conditional
2.7 | 5 | 2.2 Transient and variable descent speed | vertical transient and variable-speed time | representative family check; physical validity conditional | test_models.py:142 test_terminal_descent_vs_ode; test_feasibility.py:196 test_time_height_speed_covariance | atmosphere | instantaneous deployment; quasi-steady density model conditional
2.8 | 5 | 2.2 Transient and variable descent speed | vertical transient and variable-speed time | representative family check; physical validity conditional | test_models.py:142 test_terminal_descent_vs_ode; test_feasibility.py:196 test_time_height_speed_covariance | atmosphere | instantaneous deployment; quasi-steady density model conditional
2.9 | 6 | 2.2 Transient and variable descent speed | vertical transient and variable-speed time | representative family check; physical validity conditional | test_models.py:142 test_terminal_descent_vs_ode; test_feasibility.py:196 test_time_height_speed_covariance | atmosphere | instantaneous deployment; quasi-steady density model conditional
2.10 | 6 | 2.2 Transient and variable descent speed | vertical transient and variable-speed time | representative family check; physical validity conditional | test_models.py:142 test_terminal_descent_vs_ode; test_feasibility.py:196 test_time_height_speed_covariance | atmosphere | instantaneous deployment; quasi-steady density model conditional
2.11 | 6 | 2.2 Transient and variable descent speed | vertical transient and variable-speed time | representative family check; physical validity conditional | test_models.py:142 test_terminal_descent_vs_ode; test_feasibility.py:196 test_time_height_speed_covariance | atmosphere | instantaneous deployment; quasi-steady density model conditional
2.12 | 6 | 2.2 Transient and variable descent speed | vertical transient and variable-speed time | representative family check; physical validity conditional | test_models.py:142 test_terminal_descent_vs_ode; test_feasibility.py:196 test_time_height_speed_covariance | atmosphere | instantaneous deployment; quasi-steady density model conditional
2.13 | 6 | 2.3 Pressure altitude: the precise hypsometric equation | hydrostatic height and density | representative family check; physical validity conditional | test_physics_extra.py:100 test_hypsometric_forward_inverse; test_feasibility.py:110 test_density_terminal_pressure_and_richardson_jacobians | atmosphere | hydrostatic dry-air assumptions; common pressure datum
2.14 | 6 | 2.3 Pressure altitude: the precise hypsometric equation | hydrostatic height and density | representative family check; physical validity conditional | test_physics_extra.py:100 test_hypsometric_forward_inverse; test_feasibility.py:110 test_density_terminal_pressure_and_richardson_jacobians | atmosphere | hydrostatic dry-air assumptions; common pressure datum
2.15 | 6 | 2.3 Pressure altitude: the precise hypsometric equation | hydrostatic height and density | representative family check; physical validity conditional | test_physics_extra.py:100 test_hypsometric_forward_inverse; test_feasibility.py:110 test_density_terminal_pressure_and_richardson_jacobians | atmosphere | hydrostatic dry-air assumptions; common pressure datum
2.16 | 6 | 2.3 Pressure altitude: the precise hypsometric equation | hydrostatic height and density | representative family check; physical validity conditional | test_physics_extra.py:100 test_hypsometric_forward_inverse; test_feasibility.py:110 test_density_terminal_pressure_and_richardson_jacobians | atmosphere | hydrostatic dry-air assumptions; common pressure datum
2.17 | 6 | 2.3 Pressure altitude: the precise hypsometric equation | hydrostatic height and density | representative family check; physical validity conditional | test_physics_extra.py:100 test_hypsometric_forward_inverse; test_feasibility.py:110 test_density_terminal_pressure_and_richardson_jacobians | atmosphere | hydrostatic dry-air assumptions; common pressure datum
2.18 | 6 | 2.3 Pressure altitude: the precise hypsometric equation | hydrostatic height and density | representative family check; physical validity conditional | test_physics_extra.py:100 test_hypsometric_forward_inverse; test_feasibility.py:110 test_density_terminal_pressure_and_richardson_jacobians | atmosphere | hydrostatic dry-air assumptions; common pressure datum
2.19 | 7 | 2.3 Pressure altitude: the precise hypsometric equation | hydrostatic height and density | representative family check; physical validity conditional | test_physics_extra.py:100 test_hypsometric_forward_inverse; test_feasibility.py:110 test_density_terminal_pressure_and_richardson_jacobians | atmosphere | hydrostatic dry-air assumptions; common pressure datum
2.20 | 7 | 2.4 Horizontal lag: what follows from isotropic drag | isotropic vector drag and lag | representative family check; physical validity conditional | test_models.py:148 test_nonlinear_horizontal_drag_linear_limit; test_physics_extra.py:63 test_constant_horizontal_lag_against_rk4 | baseline/nonlinear_drag | terminal vertical balance alone does not calibrate lateral lag
2.21 | 7 | 2.4 Horizontal lag: what follows from isotropic drag | isotropic vector drag and lag | representative family check; physical validity conditional | test_models.py:148 test_nonlinear_horizontal_drag_linear_limit; test_physics_extra.py:63 test_constant_horizontal_lag_against_rk4 | baseline/nonlinear_drag | terminal vertical balance alone does not calibrate lateral lag
2.22 | 7 | 2.4 Horizontal lag: what follows from isotropic drag | isotropic vector drag and lag | representative family check; physical validity conditional | test_models.py:148 test_nonlinear_horizontal_drag_linear_limit; test_physics_extra.py:63 test_constant_horizontal_lag_against_rk4 | baseline/nonlinear_drag | terminal vertical balance alone does not calibrate lateral lag
2.23 | 7 | 2.4 Horizontal lag: what follows from isotropic drag | isotropic vector drag and lag | representative family check; physical validity conditional | test_models.py:148 test_nonlinear_horizontal_drag_linear_limit; test_physics_extra.py:63 test_constant_horizontal_lag_against_rk4 | baseline/nonlinear_drag | terminal vertical balance alone does not calibrate lateral lag
2.24 | 7 | 2.5 Why canopy terminal speed does not identify horizontal lag | anisotropic canopy response | representative family check; physical validity conditional | test_physics_extra.py:63 test_constant_horizontal_lag_against_rk4 | baseline/nonlinear_drag | scenario coefficient ratios; no measured canopy law
2.25 | 7 | 2.5 Why canopy terminal speed does not identify horizontal lag | anisotropic canopy response | representative family check; physical validity conditional | test_physics_extra.py:63 test_constant_horizontal_lag_against_rk4 | baseline/nonlinear_drag | scenario coefficient ratios; no measured canopy law
2.26 | 7 | 2.5 Why canopy terminal speed does not identify horizontal lag | anisotropic canopy response | representative family check; physical validity conditional | test_physics_extra.py:63 test_constant_horizontal_lag_against_rk4 | baseline/nonlinear_drag | scenario coefficient ratios; no measured canopy law
2.27 | 8 | 2.6 Frequency response, resolution and pendulum contamination | lag frequency response and sensor lever velocity | representative family check; physical validity conditional | test_feasibility.py:307 test_frequency_lag_response_and_averaging_kernel_eigenvalues; test_feasibility.py:248 test_lever_arm_and_pendulum_specific_force | atmosphere/shared_swing_wind_bias | flexible suspension geometry requires measurement
2.28 | 8 | 2.6 Frequency response, resolution and pendulum contamination | lag frequency response and sensor lever velocity | representative family check; physical validity conditional | test_feasibility.py:307 test_frequency_lag_response_and_averaging_kernel_eigenvalues; test_feasibility.py:248 test_lever_arm_and_pendulum_specific_force | atmosphere/shared_swing_wind_bias | flexible suspension geometry requires measurement
2.29 | 8 | 2.7 Pendulum specific force and the limits of gyro acceleration | pendulum force, forcing and transfer spectrum | representative family check; physical validity conditional | test_feasibility.py:248 test_lever_arm_and_pendulum_specific_force; test_feasibility.py:133 test_forced_pendulum_frequency_response; test_physics_extra.py:149 test_pendulum_constant_forcing_counterexample | atmosphere/shared_swing_wind_bias | linear damping and fixed-pivot model assumed
2.30 | 8 | 2.7 Pendulum specific force and the limits of gyro acceleration | pendulum force, forcing and transfer spectrum | representative family check; physical validity conditional | test_feasibility.py:248 test_lever_arm_and_pendulum_specific_force; test_feasibility.py:133 test_forced_pendulum_frequency_response; test_physics_extra.py:149 test_pendulum_constant_forcing_counterexample | atmosphere/shared_swing_wind_bias | linear damping and fixed-pivot model assumed
2.31 | 8 | 2.7 Pendulum specific force and the limits of gyro acceleration | pendulum force, forcing and transfer spectrum | representative family check; physical validity conditional | test_feasibility.py:248 test_lever_arm_and_pendulum_specific_force; test_feasibility.py:133 test_forced_pendulum_frequency_response; test_physics_extra.py:149 test_pendulum_constant_forcing_counterexample | atmosphere/shared_swing_wind_bias | linear damping and fixed-pivot model assumed
2.32 | 9 | 2.7 Pendulum specific force and the limits of gyro acceleration | pendulum force, forcing and transfer spectrum | representative family check; physical validity conditional | test_feasibility.py:248 test_lever_arm_and_pendulum_specific_force; test_feasibility.py:133 test_forced_pendulum_frequency_response; test_physics_extra.py:149 test_pendulum_constant_forcing_counterexample | atmosphere/shared_swing_wind_bias | linear damping and fixed-pivot model assumed
2.33 | 9 | 2.7 Pendulum specific force and the limits of gyro acceleration | pendulum force, forcing and transfer spectrum | representative family check; physical validity conditional | test_feasibility.py:248 test_lever_arm_and_pendulum_specific_force; test_feasibility.py:133 test_forced_pendulum_frequency_response; test_physics_extra.py:149 test_pendulum_constant_forcing_counterexample | atmosphere/shared_swing_wind_bias | linear damping and fixed-pivot model assumed
2.34 | 9 | 2.8 Shear, the sampling path, and a conditional frozen field | shear trajectory and frozen-field estimates | representative family check; physical validity conditional | test_physics_extra.py:78 test_shear_path_and_lag_are_distinct | baseline/nonlinear_drag | crossing-time scaling is an estimate; not empirical validation
2.35 | 9 | 2.8 Shear, the sampling path, and a conditional frozen field | shear trajectory and frozen-field estimates | representative family check; physical validity conditional | test_physics_extra.py:78 test_shear_path_and_lag_are_distinct | baseline/nonlinear_drag | crossing-time scaling is an estimate; not empirical validation
2.36 | 9 | 2.8 Shear, the sampling path, and a conditional frozen field | shear trajectory and frozen-field estimates | representative family check; physical validity conditional | test_physics_extra.py:78 test_shear_path_and_lag_are_distinct | baseline/nonlinear_drag | crossing-time scaling is an estimate; not empirical validation
2.37 | 9 | 2.8 Shear, the sampling path, and a conditional frozen field | shear trajectory and frozen-field estimates | representative family check; physical validity conditional | test_physics_extra.py:78 test_shear_path_and_lag_are_distinct | baseline/nonlinear_drag | crossing-time scaling is an estimate; not empirical validation
2.38 | 9 | 2.8 Shear, the sampling path, and a conditional frozen field | shear trajectory and frozen-field estimates | representative family check; physical validity conditional | test_physics_extra.py:78 test_shear_path_and_lag_are_distinct | baseline/nonlinear_drag | crossing-time scaling is an estimate; not empirical validation
3.1 | 10 | 3.1 Potential temperature from the first law | potential temperature, buoyancy and sensor lag | representative family check; physical validity conditional | test_physics_extra.py:107 test_dry_adiabatic_potential_temperature_invariant; test_feasibility.py:124 test_thermistor_ramp_and_inverse | atmosphere/thermistor | dry unsaturated parcel model; no thermistor calibration
3.2 | 10 | 3.1 Potential temperature from the first law | potential temperature, buoyancy and sensor lag | representative family check; physical validity conditional | test_physics_extra.py:107 test_dry_adiabatic_potential_temperature_invariant; test_feasibility.py:124 test_thermistor_ramp_and_inverse | atmosphere/thermistor | dry unsaturated parcel model; no thermistor calibration
3.3 | 10 | 3.1 Potential temperature from the first law | potential temperature, buoyancy and sensor lag | representative family check; physical validity conditional | test_physics_extra.py:107 test_dry_adiabatic_potential_temperature_invariant; test_feasibility.py:124 test_thermistor_ramp_and_inverse | atmosphere/thermistor | dry unsaturated parcel model; no thermistor calibration
3.4 | 10 | 3.1 Potential temperature from the first law | potential temperature, buoyancy and sensor lag | representative family check; physical validity conditional | test_physics_extra.py:107 test_dry_adiabatic_potential_temperature_invariant; test_feasibility.py:124 test_thermistor_ramp_and_inverse | atmosphere/thermistor | dry unsaturated parcel model; no thermistor calibration
3.5 | 10 | 3.1 Potential temperature from the first law | potential temperature, buoyancy and sensor lag | representative family check; physical validity conditional | test_physics_extra.py:107 test_dry_adiabatic_potential_temperature_invariant; test_feasibility.py:124 test_thermistor_ramp_and_inverse | atmosphere/thermistor | dry unsaturated parcel model; no thermistor calibration
3.6 | 10 | 3.1 Potential temperature from the first law | potential temperature, buoyancy and sensor lag | representative family check; physical validity conditional | test_physics_extra.py:107 test_dry_adiabatic_potential_temperature_invariant; test_feasibility.py:124 test_thermistor_ramp_and_inverse | atmosphere/thermistor | dry unsaturated parcel model; no thermistor calibration
3.7 | 10 | 3.2 MOST: integration with displacement and the lower boundary | MOST closures and integrated profiles | representative family check; physical validity conditional | test_physics_extra.py:115 test_most_integral_and_derivative; test_physics_extra.py:134 test_most_lower_boundary_and_neutral_limit | atmosphere/roughness | empirical closures; homogeneous constant-flux conditions unverified
3.8 | 10 | 3.2 MOST: integration with displacement and the lower boundary | MOST closures and integrated profiles | representative family check; physical validity conditional | test_physics_extra.py:115 test_most_integral_and_derivative; test_physics_extra.py:134 test_most_lower_boundary_and_neutral_limit | atmosphere/roughness | empirical closures; homogeneous constant-flux conditions unverified
3.9 | 11 | 3.2 MOST: integration with displacement and the lower boundary | MOST closures and integrated profiles | representative family check; physical validity conditional | test_physics_extra.py:115 test_most_integral_and_derivative; test_physics_extra.py:134 test_most_lower_boundary_and_neutral_limit | atmosphere/roughness | empirical closures; homogeneous constant-flux conditions unverified
3.10 | 11 | 3.2 MOST: integration with displacement and the lower boundary | MOST closures and integrated profiles | representative family check; physical validity conditional | test_physics_extra.py:115 test_most_integral_and_derivative; test_physics_extra.py:134 test_most_lower_boundary_and_neutral_limit | atmosphere/roughness | empirical closures; homogeneous constant-flux conditions unverified
3.11 | 11 | 3.2 MOST: integration with displacement and the lower boundary | MOST closures and integrated profiles | representative family check; physical validity conditional | test_physics_extra.py:115 test_most_integral_and_derivative; test_physics_extra.py:134 test_most_lower_boundary_and_neutral_limit | atmosphere/roughness | empirical closures; homogeneous constant-flux conditions unverified
3.12 | 11 | 3.3 Checking the empirical stability corrections | MOST closures and integrated profiles | representative family check; physical validity conditional | test_physics_extra.py:115 test_most_integral_and_derivative; test_physics_extra.py:134 test_most_lower_boundary_and_neutral_limit | atmosphere/roughness | empirical closures; homogeneous constant-flux conditions unverified
3.13 | 11 | 3.3 Checking the empirical stability corrections | MOST closures and integrated profiles | representative family check; physical validity conditional | test_physics_extra.py:115 test_most_integral_and_derivative; test_physics_extra.py:134 test_most_lower_boundary_and_neutral_limit | atmosphere/roughness | empirical closures; homogeneous constant-flux conditions unverified
3.14 | 11 | 3.3 Checking the empirical stability corrections | MOST closures and integrated profiles | representative family check; physical validity conditional | test_physics_extra.py:115 test_most_integral_and_derivative; test_physics_extra.py:134 test_most_lower_boundary_and_neutral_limit | atmosphere/roughness | empirical closures; homogeneous constant-flux conditions unverified
3.15 | 11 | 3.4 Richardson numbers and what the quarter threshold means | Richardson sensitivity and stability theorem algebra | representative family check; physical validity conditional | test_feasibility.py:110 test_density_terminal_pressure_and_richardson_jacobians; test_feasibility.py:159 test_taylor_goldstein_transformation | atmosphere | transformation identity tested; Miles-Howard general proof is analytic, not a simulated physical cutoff
3.16 | 12 | 3.4 Richardson numbers and what the quarter threshold means | Richardson sensitivity and stability theorem algebra | representative family check; physical validity conditional | test_feasibility.py:110 test_density_terminal_pressure_and_richardson_jacobians; test_feasibility.py:159 test_taylor_goldstein_transformation | atmosphere | transformation identity tested; Miles-Howard general proof is analytic, not a simulated physical cutoff
3.17 | 12 | 3.4 Richardson numbers and what the quarter threshold means | Richardson sensitivity and stability theorem algebra | representative family check; physical validity conditional | test_feasibility.py:110 test_density_terminal_pressure_and_richardson_jacobians; test_feasibility.py:159 test_taylor_goldstein_transformation | atmosphere | transformation identity tested; Miles-Howard general proof is analytic, not a simulated physical cutoff
3.18 | 12 | 3.4 Richardson numbers and what the quarter threshold means | Richardson sensitivity and stability theorem algebra | representative family check; physical validity conditional | test_feasibility.py:110 test_density_terminal_pressure_and_richardson_jacobians; test_feasibility.py:159 test_taylor_goldstein_transformation | atmosphere | transformation identity tested; Miles-Howard general proof is analytic, not a simulated physical cutoff
3.19 | 12 | 3.4 Richardson numbers and what the quarter threshold means | Richardson sensitivity and stability theorem algebra | representative family check; physical validity conditional | test_feasibility.py:110 test_density_terminal_pressure_and_richardson_jacobians; test_feasibility.py:159 test_taylor_goldstein_transformation | atmosphere | transformation identity tested; Miles-Howard general proof is analytic, not a simulated physical cutoff
3.20 | 12 | 3.4 Richardson numbers and what the quarter threshold means | Richardson sensitivity and stability theorem algebra | representative family check; physical validity conditional | test_feasibility.py:110 test_density_terminal_pressure_and_richardson_jacobians; test_feasibility.py:159 test_taylor_goldstein_transformation | atmosphere | transformation identity tested; Miles-Howard general proof is analytic, not a simulated physical cutoff
3.21 | 12 | 3.4 Richardson numbers and what the quarter threshold means | Richardson sensitivity and stability theorem algebra | representative family check; physical validity conditional | test_feasibility.py:110 test_density_terminal_pressure_and_richardson_jacobians; test_feasibility.py:159 test_taylor_goldstein_transformation | atmosphere | transformation identity tested; Miles-Howard general proof is analytic, not a simulated physical cutoff
3.22 | 12 | 3.4 Richardson numbers and what the quarter threshold means | Richardson sensitivity and stability theorem algebra | representative family check; physical validity conditional | test_feasibility.py:110 test_density_terminal_pressure_and_richardson_jacobians; test_feasibility.py:159 test_taylor_goldstein_transformation | atmosphere | transformation identity tested; Miles-Howard general proof is analytic, not a simulated physical cutoff
3.23 | 13 | 3.5 Why a temperature lapse does not determine Obukhov length | flux-gradient stability relation | representative family check; physical validity conditional | test_feasibility.py:262 test_stable_most_gradient_relation_and_ill_conditioning | atmosphere | specified Dyer heat closure, gradient Ri not bulk Ri
3.24 | 13 | 3.5 Why a temperature lapse does not determine Obukhov length | flux-gradient stability relation | representative family check; physical validity conditional | test_feasibility.py:262 test_stable_most_gradient_relation_and_ill_conditioning | atmosphere | specified Dyer heat closure, gradient Ri not bulk Ri
3.25 | 13 | 3.5 Why a temperature lapse does not determine Obukhov length | flux-gradient stability relation | representative family check; physical validity conditional | test_feasibility.py:262 test_stable_most_gradient_relation_and_ill_conditioning | atmosphere | specified Dyer heat closure, gradient Ri not bulk Ri
3.26 | 13 | 3.6 Neutral profile fitting and roughness uncertainty | neutral GLS fit and roughness uncertainty | representative family check; physical validity conditional | test_feasibility.py:172 test_neutral_gls_and_roughness_gradient | atmosphere/roughness | known displacement and heights; no actual surface roughness identification
3.27 | 13 | 3.6 Neutral profile fitting and roughness uncertainty | neutral GLS fit and roughness uncertainty | representative family check; physical validity conditional | test_feasibility.py:172 test_neutral_gls_and_roughness_gradient | atmosphere/roughness | known displacement and heights; no actual surface roughness identification
3.28 | 13 | 3.6 Neutral profile fitting and roughness uncertainty | neutral GLS fit and roughness uncertainty | representative family check; physical validity conditional | test_feasibility.py:172 test_neutral_gls_and_roughness_gradient | atmosphere/roughness | known displacement and heights; no actual surface roughness identification
4.1 | 13 | 4.1 Footprint and exposure blur | camera footprint and optical flow blur | representative family check; physical validity conditional | test_physics_extra.py:165 test_storage_and_corner_blur; test_feasibility.py:99 test_optical_flow_against_moving_point_projection | images | rectilinear lens; real photon signal and distortion unmeasured
4.2 | 14 | 4.1 Footprint and exposure blur | camera footprint and optical flow blur | representative family check; physical validity conditional | test_physics_extra.py:165 test_storage_and_corner_blur; test_feasibility.py:99 test_optical_flow_against_moving_point_projection | images | rectilinear lens; real photon signal and distortion unmeasured
4.3 | 14 | 4.1 Footprint and exposure blur | camera footprint and optical flow blur | representative family check; physical validity conditional | test_physics_extra.py:165 test_storage_and_corner_blur; test_feasibility.py:99 test_optical_flow_against_moving_point_projection | images | rectilinear lens; real photon signal and distortion unmeasured
4.4 | 14 | 4.1 Footprint and exposure blur | camera footprint and optical flow blur | representative family check; physical validity conditional | test_physics_extra.py:165 test_storage_and_corner_blur; test_feasibility.py:99 test_optical_flow_against_moving_point_projection | images | rectilinear lens; real photon signal and distortion unmeasured
4.5 | 14 | 4.1 Footprint and exposure blur | camera footprint and optical flow blur | representative family check; physical validity conditional | test_physics_extra.py:165 test_storage_and_corner_blur; test_feasibility.py:99 test_optical_flow_against_moving_point_projection | images | rectilinear lens; real photon signal and distortion unmeasured
4.6 | 14 | 4.2 Frame count, storage and processing capacity | storage and correlated averaging | representative family check; physical validity conditional | test_physics_extra.py:165 test_storage_and_corner_blur; test_retrieval_extra.py:59 test_layer_variance_equal_correlation_closed_form | processing | 8bit storage; no measured storage stalls
4.7 | 14 | 4.2 Frame count, storage and processing capacity | storage and correlated averaging | representative family check; physical validity conditional | test_physics_extra.py:165 test_storage_and_corner_blur; test_retrieval_extra.py:59 test_layer_variance_equal_correlation_closed_form | processing | 8bit storage; no measured storage stalls
4.8 | 15 | 4.3 Battery energy, peak current and mechanical loading | energy, current and loading | representative family check; physical validity conditional | test_feasibility.py:236 test_energy_load_radio_and_binomial_limits | processing | illustrative energy/load inputs; no battery or rail measurements
4.9 | 15 | 4.3 Battery energy, peak current and mechanical loading | energy, current and loading | representative family check; physical validity conditional | test_feasibility.py:236 test_energy_load_radio_and_binomial_limits | processing | illustrative energy/load inputs; no battery or rail measurements
4.10 | 15 | 4.3 Battery energy, peak current and mechanical loading | energy, current and loading | representative family check; physical validity conditional | test_feasibility.py:236 test_energy_load_radio_and_binomial_limits | processing | illustrative energy/load inputs; no battery or rail measurements
4.11 | 15 | 4.4 Radio airtime with explicit parameters | LoRa accounting and free-space link loss | representative family check; physical validity conditional | test_physics_extra.py:160 test_lora_packet_example; test_feasibility.py:236 test_energy_load_radio_and_binomial_limits | processing/radio_sweep | no current-rule compliance or real link-range claim
4.12 | 15 | 4.4 Radio airtime with explicit parameters | LoRa accounting and free-space link loss | representative family check; physical validity conditional | test_physics_extra.py:160 test_lora_packet_example; test_feasibility.py:236 test_energy_load_radio_and_binomial_limits | processing/radio_sweep | no current-rule compliance or real link-range claim
4.13 | 15 | 4.4 Radio airtime with explicit parameters | LoRa accounting and free-space link loss | representative family check; physical validity conditional | test_physics_extra.py:160 test_lora_packet_example; test_feasibility.py:236 test_energy_load_radio_and_binomial_limits | processing/radio_sweep | no current-rule compliance or real link-range claim
4.14 | 15 | 4.4 Radio airtime with explicit parameters | LoRa accounting and free-space link loss | representative family check; physical validity conditional | test_physics_extra.py:160 test_lora_packet_example; test_feasibility.py:236 test_energy_load_radio_and_binomial_limits | processing/radio_sweep | no current-rule compliance or real link-range claim
5.1 | 17 | 5.1 Frames, signs, units, and camera model | camera frames and lever arm | representative family check; physical validity conditional | test_navigation_extra.py:170 test_homography_with_extrinsics_and_lever; test_navigation_extra.py:173 test_right_error_reprojection_with_lever | images | intrinsics/extrinsics assumed known
5.2 | 17 | 5.1 Frames, signs, units, and camera model | camera frames and lever arm | representative family check; physical validity conditional | test_navigation_extra.py:170 test_homography_with_extrinsics_and_lever; test_navigation_extra.py:173 test_right_error_reprojection_with_lever | images | intrinsics/extrinsics assumed known
5.3 | 17 | 5.1 Frames, signs, units, and camera model | camera frames and lever arm | representative family check; physical validity conditional | test_navigation_extra.py:170 test_homography_with_extrinsics_and_lever; test_navigation_extra.py:173 test_right_error_reprojection_with_lever | images | intrinsics/extrinsics assumed known
5.4 | 17 | 5.2 Ground-plane rectification and field of view | homography determinant and footprint | representative family check; physical validity conditional | test_feasibility.py:269 test_homography_determinant_and_datum_gauge; test_feasibility.py:78 test_renderer_ray_plane_and_interpolation | images | single plane fails with terrain relief
5.5 | 17 | 5.2 Ground-plane rectification and field of view | homography determinant and footprint | representative family check; physical validity conditional | test_feasibility.py:269 test_homography_determinant_and_datum_gauge; test_feasibility.py:78 test_renderer_ray_plane_and_interpolation | images | single plane fails with terrain relief
5.6 | 17 | 5.2 Ground-plane rectification and field of view | homography determinant and footprint | representative family check; physical validity conditional | test_feasibility.py:269 test_homography_determinant_and_datum_gauge; test_feasibility.py:78 test_renderer_ray_plane_and_interpolation | images | single plane fails with terrain relief
5.7 | 18 | 5.3 Timing, exposure blur, and tilt–translation separation | timing, tilt geometry and information | representative family check; physical validity conditional | test_feasibility.py:99 test_optical_flow_against_moving_point_projection; test_navigation_extra.py:212 test_tilt_information_degeneracy | images | timing calibration and pose nuisance parameters required
5.8 | 18 | 5.3 Timing, exposure blur, and tilt–translation separation | timing, tilt geometry and information | representative family check; physical validity conditional | test_feasibility.py:99 test_optical_flow_against_moving_point_projection; test_navigation_extra.py:212 test_tilt_information_degeneracy | images | timing calibration and pose nuisance parameters required
5.9 | 18 | 5.3 Timing, exposure blur, and tilt–translation separation | timing, tilt geometry and information | representative family check; physical validity conditional | test_feasibility.py:99 test_optical_flow_against_moving_point_projection; test_navigation_extra.py:212 test_tilt_information_degeneracy | images | timing calibration and pose nuisance parameters required
5.10 | 18 | 5.3 Timing, exposure blur, and tilt–translation separation | timing, tilt geometry and information | representative family check; physical validity conditional | test_feasibility.py:99 test_optical_flow_against_moving_point_projection; test_navigation_extra.py:212 test_tilt_information_degeneracy | images | timing calibration and pose nuisance parameters required
5.11 | 19 | 5.3 Timing, exposure blur, and tilt–translation separation | timing, tilt geometry and information | representative family check; physical validity conditional | test_feasibility.py:99 test_optical_flow_against_moving_point_projection; test_navigation_extra.py:212 test_tilt_information_degeneracy | images | timing calibration and pose nuisance parameters required
5.12 | 19 | 5.3 Timing, exposure blur, and tilt–translation separation | timing, tilt geometry and information | representative family check; physical validity conditional | test_feasibility.py:99 test_optical_flow_against_moving_point_projection; test_navigation_extra.py:212 test_tilt_information_degeneracy | images | timing calibration and pose nuisance parameters required
5.13 | 19 | 5.4 Landmark correlation, peak uncertainty, and consensus | NCC FFT and integral normalization | representative family check; physical validity conditional | test_feasibility.py:10 test_ncc_integrals_against_direct_all_windows; test_feasibility.py:25 test_coarse_ncc_recovers_large_shift | processing/NCC | constant patches rejected; aliases remain possible
5.14 | 19 | 5.4 Landmark correlation, peak uncertainty, and consensus | NCC FFT and integral normalization | representative family check; physical validity conditional | test_feasibility.py:10 test_ncc_integrals_against_direct_all_windows; test_feasibility.py:25 test_coarse_ncc_recovers_large_shift | processing/NCC | constant patches rejected; aliases remain possible
5.15 | 19 | 5.4 Landmark correlation, peak uncertainty, and consensus | NCC FFT and integral normalization | representative family check; physical validity conditional | test_feasibility.py:10 test_ncc_integrals_against_direct_all_windows; test_feasibility.py:25 test_coarse_ncc_recovers_large_shift | processing/NCC | constant patches rejected; aliases remain possible
5.16 | 19 | 5.4 Landmark correlation, peak uncertainty, and consensus | NCC FFT and integral normalization | representative family check; physical validity conditional | test_feasibility.py:10 test_ncc_integrals_against_direct_all_windows; test_feasibility.py:25 test_coarse_ncc_recovers_large_shift | processing/NCC | constant patches rejected; aliases remain possible
5.17 | 19 | 5.4 Landmark correlation, peak uncertainty, and consensus | NCC FFT and integral normalization | representative family check; physical validity conditional | test_feasibility.py:10 test_ncc_integrals_against_direct_all_windows; test_feasibility.py:25 test_coarse_ncc_recovers_large_shift | processing/NCC | constant patches rejected; aliases remain possible
5.18 | 20 | 5.4 Landmark correlation, peak uncertainty, and consensus | subpixel peaks and photometric Fisher information | representative family check; physical validity conditional | test_feasibility.py:85 test_joint_quadratic_peak; test_feasibility.py:90 test_photometric_information_schur | images | curvature-to-covariance needs calibration
5.19 | 20 | 5.4 Landmark correlation, peak uncertainty, and consensus | subpixel peaks and photometric Fisher information | representative family check; physical validity conditional | test_feasibility.py:85 test_joint_quadratic_peak; test_feasibility.py:90 test_photometric_information_schur | images | curvature-to-covariance needs calibration
5.20 | 20 | 5.4 Landmark correlation, peak uncertainty, and consensus | subpixel peaks and photometric Fisher information | representative family check; physical validity conditional | test_feasibility.py:85 test_joint_quadratic_peak; test_feasibility.py:90 test_photometric_information_schur | images | curvature-to-covariance needs calibration
5.21 | 20 | 5.4 Landmark correlation, peak uncertainty, and consensus | subpixel peaks and photometric Fisher information | representative family check; physical validity conditional | test_feasibility.py:85 test_joint_quadratic_peak; test_feasibility.py:90 test_photometric_information_schur | images | curvature-to-covariance needs calibration
5.22 | 20 | 5.4 Landmark correlation, peak uncertainty, and consensus | RANSAC and two-point similarity | representative family check; physical validity conditional | test_navigation_extra.py:240 test_ransac_rounding; test_models.py:134 test_parabola_and_ransac | images | success formula assumes independent valid minimal samples; renderer uses local peak gate rather than RANSAC
5.23 | 21 | 5.4 Landmark correlation, peak uncertainty, and consensus | RANSAC and two-point similarity | representative family check; physical validity conditional | test_navigation_extra.py:240 test_ransac_rounding; test_models.py:134 test_parabola_and_ransac | images | success formula assumes independent valid minimal samples; renderer uses local peak gate rather than RANSAC
5.24 | 21 | 5.4 Landmark correlation, peak uncertainty, and consensus | RANSAC and two-point similarity | representative family check; physical validity conditional | test_navigation_extra.py:240 test_ransac_rounding; test_models.py:134 test_parabola_and_ransac | images | success formula assumes independent valid minimal samples; renderer uses local peak gate rather than RANSAC
5.25 | 21 | 5.4 Landmark correlation, peak uncertainty, and consensus | RANSAC and two-point similarity | representative family check; physical validity conditional | test_navigation_extra.py:240 test_ransac_rounding; test_models.py:134 test_parabola_and_ransac | images | success formula assumes independent valid minimal samples; renderer uses local peak gate rather than RANSAC
5.26 | 21 | 5.5 Error-state navigation filter with a coherent convention | right error and nonlinear ESKF linearization | representative family check; physical validity conditional | test_feasibility.py:32 test_eskf_dynamics_nonlinear_finite_difference; test_navigation_extra.py:189 test_quaternion_exact_propagation | linear_navigation | matched local-linear ensemble; not a full nonlinear flight ESKF
5.27 | 21 | 5.5 Error-state navigation filter with a coherent convention | right error and nonlinear ESKF linearization | representative family check; physical validity conditional | test_feasibility.py:32 test_eskf_dynamics_nonlinear_finite_difference; test_navigation_extra.py:189 test_quaternion_exact_propagation | linear_navigation | matched local-linear ensemble; not a full nonlinear flight ESKF
5.28 | 22 | 5.5 Error-state navigation filter with a coherent convention | right error and nonlinear ESKF linearization | representative family check; physical validity conditional | test_feasibility.py:32 test_eskf_dynamics_nonlinear_finite_difference; test_navigation_extra.py:189 test_quaternion_exact_propagation | linear_navigation | matched local-linear ensemble; not a full nonlinear flight ESKF
5.29 | 22 | 5.5 Error-state navigation filter with a coherent convention | right error and nonlinear ESKF linearization | representative family check; physical validity conditional | test_feasibility.py:32 test_eskf_dynamics_nonlinear_finite_difference; test_navigation_extra.py:189 test_quaternion_exact_propagation | linear_navigation | matched local-linear ensemble; not a full nonlinear flight ESKF
5.30 | 22 | 5.5 Error-state navigation filter with a coherent convention | right error and nonlinear ESKF linearization | representative family check; physical validity conditional | test_feasibility.py:32 test_eskf_dynamics_nonlinear_finite_difference; test_navigation_extra.py:189 test_quaternion_exact_propagation | linear_navigation | matched local-linear ensemble; not a full nonlinear flight ESKF
5.31 | 22 | 5.5 Error-state navigation filter with a coherent convention | right error and nonlinear ESKF linearization | representative family check; physical validity conditional | test_feasibility.py:32 test_eskf_dynamics_nonlinear_finite_difference; test_navigation_extra.py:189 test_quaternion_exact_propagation | linear_navigation | matched local-linear ensemble; not a full nonlinear flight ESKF
5.32 | 22 | 5.5 Error-state navigation filter with a coherent convention | right error and nonlinear ESKF linearization | representative family check; physical validity conditional | test_feasibility.py:32 test_eskf_dynamics_nonlinear_finite_difference; test_navigation_extra.py:189 test_quaternion_exact_propagation | linear_navigation | matched local-linear ensemble; not a full nonlinear flight ESKF
5.33 | 22 | 5.5 Error-state navigation filter with a coherent convention | right error and nonlinear ESKF linearization | representative family check; physical validity conditional | test_feasibility.py:32 test_eskf_dynamics_nonlinear_finite_difference; test_navigation_extra.py:189 test_quaternion_exact_propagation | linear_navigation | matched local-linear ensemble; not a full nonlinear flight ESKF
5.34 | 22 | 5.5 Error-state navigation filter with a coherent convention | 15-state covariance discretization and attitude propagation | representative family check; physical validity conditional | test_feasibility.py:45 test_15state_discretization_covariance_ode; test_navigation_extra.py:189 test_quaternion_exact_propagation | linear_navigation | frozen coefficients and known noise density
5.35 | 22 | 5.5 Error-state navigation filter with a coherent convention | 15-state covariance discretization and attitude propagation | representative family check; physical validity conditional | test_feasibility.py:45 test_15state_discretization_covariance_ode; test_navigation_extra.py:189 test_quaternion_exact_propagation | linear_navigation | frozen coefficients and known noise density
5.36 | 22 | 5.5 Error-state navigation filter with a coherent convention | 15-state covariance discretization and attitude propagation | representative family check; physical validity conditional | test_feasibility.py:45 test_15state_discretization_covariance_ode; test_navigation_extra.py:189 test_quaternion_exact_propagation | linear_navigation | frozen coefficients and known noise density
5.37 | 22 | 5.5 Error-state navigation filter with a coherent convention | 15-state covariance discretization and attitude propagation | representative family check; physical validity conditional | test_feasibility.py:45 test_15state_discretization_covariance_ode; test_navigation_extra.py:189 test_quaternion_exact_propagation | linear_navigation | frozen coefficients and known noise density
5.38 | 23 | 5.5 Error-state navigation filter with a coherent convention | landmark reprojection derivatives | representative family check; physical validity conditional | test_navigation_extra.py:173 test_right_error_reprojection_with_lever; test_feasibility.py:68 test_pose_fit_from_independent_noiseless_projection | images | correct correspondences for local covariance
5.39 | 23 | 5.5 Error-state navigation filter with a coherent convention | landmark reprojection derivatives | representative family check; physical validity conditional | test_navigation_extra.py:173 test_right_error_reprojection_with_lever; test_feasibility.py:68 test_pose_fit_from_independent_noiseless_projection | images | correct correspondences for local covariance
5.40 | 23 | 5.5 Error-state navigation filter with a coherent convention | landmark reprojection derivatives | representative family check; physical validity conditional | test_navigation_extra.py:173 test_right_error_reprojection_with_lever; test_feasibility.py:68 test_pose_fit_from_independent_noiseless_projection | images | correct correspondences for local covariance
5.41 | 23 | 5.5 Error-state navigation filter with a coherent convention | landmark reprojection derivatives | representative family check; physical validity conditional | test_navigation_extra.py:173 test_right_error_reprojection_with_lever; test_feasibility.py:68 test_pose_fit_from_independent_noiseless_projection | images | correct correspondences for local covariance
5.42 | 23 | 5.5 Error-state navigation filter with a coherent convention | navigation update, injection and reset | representative family check; physical validity conditional | test_feasibility.py:57 test_joint_correlated_update_against_batch_gaussian; test_navigation_extra.py:179 test_exact_reset_derivative | linear_navigation | no nonlinear injection in the linear ensemble; reset derivative checked independently
5.43 | 23 | 5.5 Error-state navigation filter with a coherent convention | navigation update, injection and reset | representative family check; physical validity conditional | test_feasibility.py:57 test_joint_correlated_update_against_batch_gaussian; test_navigation_extra.py:179 test_exact_reset_derivative | linear_navigation | no nonlinear injection in the linear ensemble; reset derivative checked independently
5.44 | 23 | 5.5 Error-state navigation filter with a coherent convention | navigation update, injection and reset | representative family check; physical validity conditional | test_feasibility.py:57 test_joint_correlated_update_against_batch_gaussian; test_navigation_extra.py:179 test_exact_reset_derivative | linear_navigation | no nonlinear injection in the linear ensemble; reset derivative checked independently
5.45 | 23 | 5.5 Error-state navigation filter with a coherent convention | navigation update, injection and reset | representative family check; physical validity conditional | test_feasibility.py:57 test_joint_correlated_update_against_batch_gaussian; test_navigation_extra.py:179 test_exact_reset_derivative | linear_navigation | no nonlinear injection in the linear ensemble; reset derivative checked independently
5.46 | 23 | 5.5 Error-state navigation filter with a coherent convention | navigation update, injection and reset | representative family check; physical validity conditional | test_feasibility.py:57 test_joint_correlated_update_against_batch_gaussian; test_navigation_extra.py:179 test_exact_reset_derivative | linear_navigation | no nonlinear injection in the linear ensemble; reset derivative checked independently
5.47 | 23 | 5.5 Error-state navigation filter with a coherent convention | navigation update, injection and reset | representative family check; physical validity conditional | test_feasibility.py:57 test_joint_correlated_update_against_batch_gaussian; test_navigation_extra.py:179 test_exact_reset_derivative | linear_navigation | no nonlinear injection in the linear ensemble; reset derivative checked independently
5.48 | 24 | 5.5 Error-state navigation filter with a coherent convention | navigation update, injection and reset | representative family check; physical validity conditional | test_feasibility.py:57 test_joint_correlated_update_against_batch_gaussian; test_navigation_extra.py:179 test_exact_reset_derivative | linear_navigation | no nonlinear injection in the linear ensemble; reset derivative checked independently
5.49 | 24 | 5.5 Error-state navigation filter with a coherent convention | navigation update, injection and reset | representative family check; physical validity conditional | test_feasibility.py:57 test_joint_correlated_update_against_batch_gaussian; test_navigation_extra.py:179 test_exact_reset_derivative | linear_navigation | no nonlinear injection in the linear ensemble; reset derivative checked independently
5.50 | 24 | 5.5 Error-state navigation filter with a coherent convention | VO signs, scaling and correlated update | representative family check; physical validity conditional | test_navigation_extra.py:253 test_downward_scale_correction_and_signed_velocity; test_navigation_extra.py:264 test_shared_image_velocity_temporal_covariance; test_feasibility.py:57 test_joint_correlated_update_against_batch_gaussian | baseline/correlated_vision_noise_corrected | known rotation/height in signed VO identity
5.51 | 24 | 5.5 Error-state navigation filter with a coherent convention | VO signs, scaling and correlated update | representative family check; physical validity conditional | test_navigation_extra.py:253 test_downward_scale_correction_and_signed_velocity; test_navigation_extra.py:264 test_shared_image_velocity_temporal_covariance; test_feasibility.py:57 test_joint_correlated_update_against_batch_gaussian | baseline/correlated_vision_noise_corrected | known rotation/height in signed VO identity
5.52 | 24 | 5.5 Error-state navigation filter with a coherent convention | VO signs, scaling and correlated update | representative family check; physical validity conditional | test_navigation_extra.py:253 test_downward_scale_correction_and_signed_velocity; test_navigation_extra.py:264 test_shared_image_velocity_temporal_covariance; test_feasibility.py:57 test_joint_correlated_update_against_batch_gaussian | baseline/correlated_vision_noise_corrected | known rotation/height in signed VO identity
5.53 | 24 | 5.5 Error-state navigation filter with a coherent convention | VO signs, scaling and correlated update | representative family check; physical validity conditional | test_navigation_extra.py:253 test_downward_scale_correction_and_signed_velocity; test_navigation_extra.py:264 test_shared_image_velocity_temporal_covariance; test_feasibility.py:57 test_joint_correlated_update_against_batch_gaussian | baseline/correlated_vision_noise_corrected | known rotation/height in signed VO identity
5.54 | 24 | 5.5 Error-state navigation filter with a coherent convention | VO signs, scaling and correlated update | representative family check; physical validity conditional | test_navigation_extra.py:253 test_downward_scale_correction_and_signed_velocity; test_navigation_extra.py:264 test_shared_image_velocity_temporal_covariance; test_feasibility.py:57 test_joint_correlated_update_against_batch_gaussian | baseline/correlated_vision_noise_corrected | known rotation/height in signed VO identity
5.55 | 24 | 5.5 Error-state navigation filter with a coherent convention | VO signs, scaling and correlated update | representative family check; physical validity conditional | test_navigation_extra.py:253 test_downward_scale_correction_and_signed_velocity; test_navigation_extra.py:264 test_shared_image_velocity_temporal_covariance; test_feasibility.py:57 test_joint_correlated_update_against_batch_gaussian | baseline/correlated_vision_noise_corrected | known rotation/height in signed VO identity
5.56 | 24 | 5.5 Error-state navigation filter with a coherent convention | VO signs, scaling and correlated update | representative family check; physical validity conditional | test_navigation_extra.py:253 test_downward_scale_correction_and_signed_velocity; test_navigation_extra.py:264 test_shared_image_velocity_temporal_covariance; test_feasibility.py:57 test_joint_correlated_update_against_batch_gaussian | baseline/correlated_vision_noise_corrected | known rotation/height in signed VO identity
5.57 | 25 | 5.6 Error budget, information bounds, and filter consistency | error budget and shared source covariance | representative family check; physical validity conditional | test_feasibility.py:279 test_truth_difference_and_landing_cross_covariance; test_models.py:114 test_tilt_schur_information | images | design budget not independently additive to joint posterior
5.58 | 25 | 5.6 Error budget, information bounds, and filter consistency | error budget and shared source covariance | representative family check; physical validity conditional | test_feasibility.py:279 test_truth_difference_and_landing_cross_covariance; test_models.py:114 test_tilt_schur_information | images | design budget not independently additive to joint posterior
5.59 | 25 | 5.6 Error budget, information bounds, and filter consistency | error budget and shared source covariance | representative family check; physical validity conditional | test_feasibility.py:279 test_truth_difference_and_landing_cross_covariance; test_models.py:114 test_tilt_schur_information | images | design budget not independently additive to joint posterior
5.60 | 26 | 5.6 Error budget, information bounds, and filter consistency | Fisher bounds, consistency and imperfect truth | representative family check; physical validity conditional | test_feasibility.py:90 test_photometric_information_schur; test_feasibility.py:279 test_truth_difference_and_landing_cross_covariance | linear_navigation | CRLB general theorem analytic; known Gaussian noise and independent descents
5.61 | 26 | 5.6 Error budget, information bounds, and filter consistency | Fisher bounds, consistency and imperfect truth | representative family check; physical validity conditional | test_feasibility.py:90 test_photometric_information_schur; test_feasibility.py:279 test_truth_difference_and_landing_cross_covariance | linear_navigation | CRLB general theorem analytic; known Gaussian noise and independent descents
5.62 | 26 | 5.6 Error budget, information bounds, and filter consistency | Fisher bounds, consistency and imperfect truth | representative family check; physical validity conditional | test_feasibility.py:90 test_photometric_information_schur; test_feasibility.py:279 test_truth_difference_and_landing_cross_covariance | linear_navigation | CRLB general theorem analytic; known Gaussian noise and independent descents
5.63 | 26 | 5.6 Error budget, information bounds, and filter consistency | Fisher bounds, consistency and imperfect truth | representative family check; physical validity conditional | test_feasibility.py:90 test_photometric_information_schur; test_feasibility.py:279 test_truth_difference_and_landing_cross_covariance | linear_navigation | CRLB general theorem analytic; known Gaussian noise and independent descents
5.64 | 26 | 5.6 Error budget, information bounds, and filter consistency | Fisher bounds, consistency and imperfect truth | representative family check; physical validity conditional | test_feasibility.py:90 test_photometric_information_schur; test_feasibility.py:279 test_truth_difference_and_landing_cross_covariance | linear_navigation | CRLB general theorem analytic; known Gaussian noise and independent descents
5.65 | 27 | 5.6 Error budget, information bounds, and filter consistency | Fisher bounds, consistency and imperfect truth | representative family check; physical validity conditional | test_feasibility.py:90 test_photometric_information_schur; test_feasibility.py:279 test_truth_difference_and_landing_cross_covariance | linear_navigation | CRLB general theorem analytic; known Gaussian noise and independent descents
5.66 | 27 | 5.7 Horizontal protection level and integrity limitations | protection probability and empirical bound | representative family check; physical validity conditional | test_navigation_extra.py:232 test_gaussian_radial_PL_and_gating; test_feasibility.py:236 test_energy_load_radio_and_binomial_limits | images | conditional Gaussian PL does not cover wrong associations or systematic bias
5.67 | 27 | 5.7 Horizontal protection level and integrity limitations | protection probability and empirical bound | representative family check; physical validity conditional | test_navigation_extra.py:232 test_gaussian_radial_PL_and_gating; test_feasibility.py:236 test_energy_load_radio_and_binomial_limits | images | conditional Gaussian PL does not cover wrong associations or systematic bias
5.68 | 27 | 5.7 Horizontal protection level and integrity limitations | protection probability and empirical bound | representative family check; physical validity conditional | test_navigation_extra.py:232 test_gaussian_radial_PL_and_gating; test_feasibility.py:236 test_energy_load_radio_and_binomial_limits | images | conditional Gaussian PL does not cover wrong associations or systematic bias
5.69 | 28 | 5.8 Map gauge, robust registration, and certification | TLS lifting and SDP certificate conditions | representative family check; physical validity conditional | test_navigation_extra.py:274 test_TLS_quadratic_lift_exact_cases; test_models.py:186 test_tls_enumeration_global_bound; test_feasibility.py:216 test_tls_lift_and_analytic_dual_certificate | test_feasibility | analytic zero-cost primal/dual numerical certificate exercised; no general noisy SDP solve or onboard certificate
5.70 | 28 | 5.8 Map gauge, robust registration, and certification | TLS lifting and SDP certificate conditions | representative family check; physical validity conditional | test_navigation_extra.py:274 test_TLS_quadratic_lift_exact_cases; test_models.py:186 test_tls_enumeration_global_bound; test_feasibility.py:216 test_tls_lift_and_analytic_dual_certificate | test_feasibility | analytic zero-cost primal/dual numerical certificate exercised; no general noisy SDP solve or onboard certificate
5.71 | 28 | 5.8 Map gauge, robust registration, and certification | TLS lifting and SDP certificate conditions | representative family check; physical validity conditional | test_navigation_extra.py:274 test_TLS_quadratic_lift_exact_cases; test_models.py:186 test_tls_enumeration_global_bound; test_feasibility.py:216 test_tls_lift_and_analytic_dual_certificate | test_feasibility | analytic zero-cost primal/dual numerical certificate exercised; no general noisy SDP solve or onboard certificate
5.72 | 28 | 5.8 Map gauge, robust registration, and certification | TLS lifting and SDP certificate conditions | representative family check; physical validity conditional | test_navigation_extra.py:274 test_TLS_quadratic_lift_exact_cases; test_models.py:186 test_tls_enumeration_global_bound; test_feasibility.py:216 test_tls_lift_and_analytic_dual_certificate | test_feasibility | analytic zero-cost primal/dual numerical certificate exercised; no general noisy SDP solve or onboard certificate
5.73 | 28 | 5.8 Map gauge, robust registration, and certification | TLS lifting and SDP certificate conditions | representative family check; physical validity conditional | test_navigation_extra.py:274 test_TLS_quadratic_lift_exact_cases; test_models.py:186 test_tls_enumeration_global_bound; test_feasibility.py:216 test_tls_lift_and_analytic_dual_certificate | test_feasibility | analytic zero-cost primal/dual numerical certificate exercised; no general noisy SDP solve or onboard certificate
5.74 | 28 | 5.8 Map gauge, robust registration, and certification | TLS lifting and SDP certificate conditions | representative family check; physical validity conditional | test_navigation_extra.py:274 test_TLS_quadratic_lift_exact_cases; test_models.py:186 test_tls_enumeration_global_bound; test_feasibility.py:216 test_tls_lift_and_analytic_dual_certificate | test_feasibility | analytic zero-cost primal/dual numerical certificate exercised; no general noisy SDP solve or onboard certificate
5.75 | 28 | 5.8 Map gauge, robust registration, and certification | TLS lifting and SDP certificate conditions | representative family check; physical validity conditional | test_navigation_extra.py:274 test_TLS_quadratic_lift_exact_cases; test_models.py:186 test_tls_enumeration_global_bound; test_feasibility.py:216 test_tls_lift_and_analytic_dual_certificate | test_feasibility | analytic zero-cost primal/dual numerical certificate exercised; no general noisy SDP solve or onboard certificate
5.76 | 29 | 5.9 Landmark selection: normalized objective and greedy proof | normalized logdet greedy selection | representative family check; physical validity conditional | test_navigation_extra.py:246 test_normalized_logdet_greedy | test_navigation_extra | fixed additive PSD information; theorem proof analytic
5.77 | 29 | 5.9 Landmark selection: normalized objective and greedy proof | normalized logdet greedy selection | representative family check; physical validity conditional | test_navigation_extra.py:246 test_normalized_logdet_greedy | test_navigation_extra | fixed additive PSD information; theorem proof analytic
5.78 | 29 | 5.9 Landmark selection: normalized objective and greedy proof | normalized logdet greedy selection | representative family check; physical validity conditional | test_navigation_extra.py:246 test_normalized_logdet_greedy | test_navigation_extra | fixed additive PSD information; theorem proof analytic
5.79 | 29 | 5.9 Landmark selection: normalized objective and greedy proof | normalized logdet greedy selection | representative family check; physical validity conditional | test_navigation_extra.py:246 test_normalized_logdet_greedy | test_navigation_extra | fixed additive PSD information; theorem proof analytic
5.80 | 29 | 5.9 Landmark selection: normalized objective and greedy proof | normalized logdet greedy selection | representative family check; physical validity conditional | test_navigation_extra.py:246 test_normalized_logdet_greedy | test_navigation_extra | fixed additive PSD information; theorem proof analytic
5.81 | 29 | 5.9 Landmark selection: normalized objective and greedy proof | normalized logdet greedy selection | representative family check; physical validity conditional | test_navigation_extra.py:246 test_normalized_logdet_greedy | test_navigation_extra | fixed additive PSD information; theorem proof analytic
5.82 | 30 | 5.10 Uncertainty-aware notional safe-target selection | expected hazard cost and notional control bound | representative family check; physical validity conditional | test_feasibility.py:206 test_expected_hazard_cost_and_control_bound | test_feasibility | half-plane case exercised; passive canopy has zero commanded divert
5.83 | 30 | 5.10 Uncertainty-aware notional safe-target selection | expected hazard cost and notional control bound | representative family check; physical validity conditional | test_feasibility.py:206 test_expected_hazard_cost_and_control_bound | test_feasibility | half-plane case exercised; passive canopy has zero commanded divert
5.84 | 30 | 5.10 Uncertainty-aware notional safe-target selection | expected hazard cost and notional control bound | representative family check; physical validity conditional | test_feasibility.py:206 test_expected_hazard_cost_and_control_bound | test_feasibility | half-plane case exercised; passive canopy has zero commanded divert
5.85 | 30 | 5.10 Uncertainty-aware notional safe-target selection | expected hazard cost and notional control bound | representative family check; physical validity conditional | test_feasibility.py:206 test_expected_hazard_cost_and_control_bound | test_feasibility | half-plane case exercised; passive canopy has zero commanded divert
6.1 | 32 | 6.1 What is being derived, and what is being assumed? | transverse covariance and incompressibility | representative family check; physical validity conditional | test_feasibility.py:143 test_incompressible_tensor_divergence; test_models.py:10 test_lyapunov_and_covariance | model_selection | isotropy, incompressibility and vertical path assumed
6.2 | 32 | 6.2 Why a horizontal wind component uses the transverse covariance | transverse covariance and incompressibility | representative family check; physical validity conditional | test_feasibility.py:143 test_incompressible_tensor_divergence; test_models.py:10 test_lyapunov_and_covariance | model_selection | isotropy, incompressibility and vertical path assumed
6.3 | 32 | 6.2 Why a horizontal wind component uses the transverse covariance | transverse covariance and incompressibility | representative family check; physical validity conditional | test_feasibility.py:143 test_incompressible_tensor_divergence; test_models.py:10 test_lyapunov_and_covariance | model_selection | isotropy, incompressibility and vertical path assumed
6.4 | 32 | 6.2 Why a horizontal wind component uses the transverse covariance | transverse covariance and incompressibility | representative family check; physical validity conditional | test_feasibility.py:143 test_incompressible_tensor_divergence; test_models.py:10 test_lyapunov_and_covariance | model_selection | isotropy, incompressibility and vertical path assumed
6.5 | 32 | 6.2 Why a horizontal wind component uses the transverse covariance | transverse covariance and incompressibility | representative family check; physical validity conditional | test_feasibility.py:143 test_incompressible_tensor_divergence; test_models.py:10 test_lyapunov_and_covariance | model_selection | isotropy, incompressibility and vertical path assumed
6.6 | 33 | 6.3 Positive definiteness: a direct spectral proof | Fourier positivity and physical spectrum | representative family check; physical validity conditional | test_models.py:17 test_spectrum_fourier_integral; test_feasibility.py:286 test_spectral_variance_and_brownian_time_change | model_selection | PSD proof is spectral; finite grids are checks, not universal proof
6.7 | 33 | 6.3 Positive definiteness: a direct spectral proof | Fourier positivity and physical spectrum | representative family check; physical validity conditional | test_models.py:17 test_spectrum_fourier_integral; test_feasibility.py:286 test_spectral_variance_and_brownian_time_change | model_selection | PSD proof is spectral; finite grids are checks, not universal proof
6.8 | 33 | 6.3 Positive definiteness: a direct spectral proof | Fourier positivity and physical spectrum | representative family check; physical validity conditional | test_models.py:17 test_spectrum_fourier_integral; test_feasibility.py:286 test_spectral_variance_and_brownian_time_change | model_selection | PSD proof is spectral; finite grids are checks, not universal proof
6.9 | 33 | 6.3 Positive definiteness: a direct spectral proof | Fourier positivity and physical spectrum | representative family check; physical validity conditional | test_models.py:17 test_spectrum_fourier_integral; test_feasibility.py:286 test_spectral_variance_and_brownian_time_change | model_selection | PSD proof is spectral; finite grids are checks, not universal proof
6.10 | 33 | 6.3 Positive definiteness: a direct spectral proof | Fourier positivity and physical spectrum | representative family check; physical validity conditional | test_models.py:17 test_spectrum_fourier_integral; test_feasibility.py:286 test_spectral_variance_and_brownian_time_change | model_selection | PSD proof is spectral; finite grids are checks, not universal proof
6.11 | 33 | 6.3 Positive definiteness: a direct spectral proof | Fourier positivity and physical spectrum | representative family check; physical validity conditional | test_models.py:17 test_spectrum_fourier_integral; test_feasibility.py:286 test_spectral_variance_and_brownian_time_change | model_selection | PSD proof is spectral; finite grids are checks, not universal proof
6.12 | 33 | 6.4 Deriving the exact two-state stochastic model | two-state SDE realization | representative family check; physical validity conditional | test_models.py:10 test_lyapunov_and_covariance; test_feasibility.py:152 test_transfer_function_resolvent_not_comma | baseline | PDF transfer numerator contains comma typo; correct1+sqrt(3)*i*omega
6.13 | 33 | 6.4 Deriving the exact two-state stochastic model | two-state SDE realization | representative family check; physical validity conditional | test_models.py:10 test_lyapunov_and_covariance; test_feasibility.py:152 test_transfer_function_resolvent_not_comma | baseline | PDF transfer numerator contains comma typo; correct1+sqrt(3)*i*omega
6.14 | 33 | 6.4 Deriving the exact two-state stochastic model | two-state SDE realization | representative family check; physical validity conditional | test_models.py:10 test_lyapunov_and_covariance; test_feasibility.py:152 test_transfer_function_resolvent_not_comma | baseline | PDF transfer numerator contains comma typo; correct1+sqrt(3)*i*omega
6.15 | 34 | 6.4 Deriving the exact two-state stochastic model | two-state SDE realization | representative family check; physical validity conditional | test_models.py:10 test_lyapunov_and_covariance; test_feasibility.py:152 test_transfer_function_resolvent_not_comma | baseline | PDF transfer numerator contains comma typo; correct1+sqrt(3)*i*omega
6.16 | 34 | 6.4 Deriving the exact two-state stochastic model | two-state SDE realization | representative family check; physical validity conditional | test_models.py:10 test_lyapunov_and_covariance; test_feasibility.py:152 test_transfer_function_resolvent_not_comma | baseline | PDF transfer numerator contains comma typo; correct1+sqrt(3)*i*omega
6.17 | 34 | 6.4 Deriving the exact two-state stochastic model | two-state SDE realization | representative family check; physical validity conditional | test_models.py:10 test_lyapunov_and_covariance; test_feasibility.py:152 test_transfer_function_resolvent_not_comma | baseline | PDF transfer numerator contains comma typo; correct1+sqrt(3)*i*omega
6.18 | 34 | 6.4 Deriving the exact two-state stochastic model | two-state SDE realization | representative family check; physical validity conditional | test_models.py:10 test_lyapunov_and_covariance; test_feasibility.py:152 test_transfer_function_resolvent_not_comma | baseline | PDF transfer numerator contains comma typo; correct1+sqrt(3)*i*omega
6.19 | 34 | 6.5 Making the scale vary with height, without a sign error | height warp and covariance deformation | representative family check; physical validity conditional | test_models.py:24 test_warp_psd_ratio; test_feasibility.py:297 test_warp_integrals_and_intensity_units | model_selection | line deformation not proof of global3D turbulent field
6.20 | 34 | 6.5 Making the scale vary with height, without a sign error | height warp and covariance deformation | representative family check; physical validity conditional | test_models.py:24 test_warp_psd_ratio; test_feasibility.py:297 test_warp_integrals_and_intensity_units | model_selection | line deformation not proof of global3D turbulent field
6.21 | 34 | 6.5 Making the scale vary with height, without a sign error | height warp and covariance deformation | representative family check; physical validity conditional | test_models.py:24 test_warp_psd_ratio; test_feasibility.py:297 test_warp_integrals_and_intensity_units | model_selection | line deformation not proof of global3D turbulent field
6.22 | 34 | 6.5 Making the scale vary with height, without a sign error | height warp and covariance deformation | representative family check; physical validity conditional | test_models.py:24 test_warp_psd_ratio; test_feasibility.py:297 test_warp_integrals_and_intensity_units | model_selection | line deformation not proof of global3D turbulent field
6.23 | 34 | 6.5 Making the scale vary with height, without a sign error | height warp and covariance deformation | representative family check; physical validity conditional | test_models.py:24 test_warp_psd_ratio; test_feasibility.py:297 test_warp_integrals_and_intensity_units | model_selection | line deformation not proof of global3D turbulent field
6.24 | 34 | 6.6 Changing the independent variable and handling the ground | Brownian time change and ground limit | representative family check; physical validity conditional | test_feasibility.py:286 test_spectral_variance_and_brownian_time_change | baseline/sensitivity | positive scale floor is numerical scenario, not calibrated ground physics
6.25 | 34 | 6.6 Changing the independent variable and handling the ground | Brownian time change and ground limit | representative family check; physical validity conditional | test_feasibility.py:286 test_spectral_variance_and_brownian_time_change | baseline/sensitivity | positive scale floor is numerical scenario, not calibrated ground physics
6.26 | 35 | 6.7 Intensity models are competing empirical priors | empirical MIL intensity prescription | representative family check; physical validity conditional | test_feasibility.py:297 test_warp_integrals_and_intensity_units | test_feasibility | feet/metres conversion checked; empirical coefficients not physically validated
7.1 | 35 | 7.1 The forward lag equation, including its initial condition | lag convolution, boundary memory and frequency | representative family check; physical validity conditional | test_models.py:46 test_lag_limits_and_constant_wind; test_feasibility.py:307 test_frequency_lag_response_and_averaging_kernel_eigenvalues | baseline | known lag; uncertain initial velocity must be marginalised
7.2 | 35 | 7.1 The forward lag equation, including its initial condition | lag convolution, boundary memory and frequency | representative family check; physical validity conditional | test_models.py:46 test_lag_limits_and_constant_wind; test_feasibility.py:307 test_frequency_lag_response_and_averaging_kernel_eigenvalues | baseline | known lag; uncertain initial velocity must be marginalised
7.3 | 35 | 7.1 The forward lag equation, including its initial condition | lag convolution, boundary memory and frequency | representative family check; physical validity conditional | test_models.py:46 test_lag_limits_and_constant_wind; test_feasibility.py:307 test_frequency_lag_response_and_averaging_kernel_eigenvalues | baseline | known lag; uncertain initial velocity must be marginalised
7.4 | 36 | 7.1 The forward lag equation, including its initial condition | lag convolution, boundary memory and frequency | representative family check; physical validity conditional | test_models.py:46 test_lag_limits_and_constant_wind; test_feasibility.py:307 test_frequency_lag_response_and_averaging_kernel_eigenvalues | baseline | known lag; uncertain initial velocity must be marginalised
7.5 | 36 | 7.2 Deriving the Gaussian inverse by completing the square | Gaussian inverse and covariance precision | representative family check; physical validity conditional | test_models.py:54 test_retrieval_alternative_precision_and_dfs | baseline | joint Gaussian prior and noise; fixed hyperparameters
7.6 | 36 | 7.2 Deriving the Gaussian inverse by completing the square | Gaussian inverse and covariance precision | representative family check; physical validity conditional | test_models.py:54 test_retrieval_alternative_precision_and_dfs | baseline | joint Gaussian prior and noise; fixed hyperparameters
7.7 | 36 | 7.2 Deriving the Gaussian inverse by completing the square | Gaussian inverse and covariance precision | representative family check; physical validity conditional | test_models.py:54 test_retrieval_alternative_precision_and_dfs | baseline | joint Gaussian prior and noise; fixed hyperparameters
7.8 | 36 | 7.2 Deriving the Gaussian inverse by completing the square | Gaussian inverse and covariance precision | representative family check; physical validity conditional | test_models.py:54 test_retrieval_alternative_precision_and_dfs | baseline | joint Gaussian prior and noise; fixed hyperparameters
7.9 | 36 | 7.2 Deriving the Gaussian inverse by completing the square | Gaussian inverse and covariance precision | representative family check; physical validity conditional | test_models.py:54 test_retrieval_alternative_precision_and_dfs | baseline | joint Gaussian prior and noise; fixed hyperparameters
7.10 | 36 | 7.2 Deriving the Gaussian inverse by completing the square | Gaussian inverse and covariance precision | representative family check; physical validity conditional | test_models.py:54 test_retrieval_alternative_precision_and_dfs | baseline | joint Gaussian prior and noise; fixed hyperparameters
7.11 | 36 | 7.3 Averaging kernels: what did the observations actually resolve? | averaging kernel and resolved modes | representative family check; physical validity conditional | test_feasibility.py:307 test_frequency_lag_response_and_averaging_kernel_eigenvalues | baseline/averaging_kernels | DFS not a count of independent20m bins
7.12 | 36 | 7.3 Averaging kernels: what did the observations actually resolve? | averaging kernel and resolved modes | representative family check; physical validity conditional | test_feasibility.py:307 test_frequency_lag_response_and_averaging_kernel_eigenvalues | baseline/averaging_kernels | DFS not a count of independent20m bins
7.13 | 37 | 7.4 A continuous state model for both wind and drift | continuous wind/velocity/drift and exact steps | representative family check; physical validity conditional | test_models.py:32 test_discretization_independent_ode | baseline/sensitivity | coefficient-freezing checked by refinement
7.14 | 37 | 7.4 A continuous state model for both wind and drift | continuous wind/velocity/drift and exact steps | representative family check; physical validity conditional | test_models.py:32 test_discretization_independent_ode | baseline/sensitivity | coefficient-freezing checked by refinement
7.15 | 37 | 7.5 Discretisation: transition, noise covariance, and forcing | continuous wind/velocity/drift and exact steps | representative family check; physical validity conditional | test_models.py:32 test_discretization_independent_ode | baseline/sensitivity | coefficient-freezing checked by refinement
7.16 | 37 | 7.5 Discretisation: transition, noise covariance, and forcing | continuous wind/velocity/drift and exact steps | representative family check; physical validity conditional | test_models.py:32 test_discretization_independent_ode | baseline/sensitivity | coefficient-freezing checked by refinement
7.17 | 37 | 7.5 Discretisation: transition, noise covariance, and forcing | continuous wind/velocity/drift and exact steps | representative family check; physical validity conditional | test_models.py:32 test_discretization_independent_ode | baseline/sensitivity | coefficient-freezing checked by refinement
7.18 | 37 | 7.5 Discretisation: transition, noise covariance, and forcing | continuous wind/velocity/drift and exact steps | representative family check; physical validity conditional | test_models.py:32 test_discretization_independent_ode | baseline/sensitivity | coefficient-freezing checked by refinement
7.19 | 37 | 7.6 Kalman update derived from joint Gaussian conditioning | Gaussian update and Joseph covariance | representative family check; physical validity conditional | test_models.py:68 test_kalman_gp_and_rts_equivalence | baseline | fixed linear Gaussian model
7.20 | 37 | 7.6 Kalman update derived from joint Gaussian conditioning | Gaussian update and Joseph covariance | representative family check; physical validity conditional | test_models.py:68 test_kalman_gp_and_rts_equivalence | baseline | fixed linear Gaussian model
7.21 | 37 | 7.6 Kalman update derived from joint Gaussian conditioning | Gaussian update and Joseph covariance | representative family check; physical validity conditional | test_models.py:68 test_kalman_gp_and_rts_equivalence | baseline | fixed linear Gaussian model
7.22 | 38 | 7.6 Kalman update derived from joint Gaussian conditioning | Gaussian update and Joseph covariance | representative family check; physical validity conditional | test_models.py:68 test_kalman_gp_and_rts_equivalence | baseline | fixed linear Gaussian model
7.23 | 38 | 7.7 Why a post-flight smoother improves the whole profile | RTS smoothing and wind output | representative family check; physical validity conditional | test_models.py:68 test_kalman_gp_and_rts_equivalence | baseline | offline future data used for smoothing only
7.24 | 38 | 7.7 Why a post-flight smoother improves the whole profile | RTS smoothing and wind output | representative family check; physical validity conditional | test_models.py:68 test_kalman_gp_and_rts_equivalence | baseline | offline future data used for smoothing only
7.25 | 38 | 7.7 Why a post-flight smoother improves the whole profile | RTS smoothing and wind output | representative family check; physical validity conditional | test_models.py:68 test_kalman_gp_and_rts_equivalence | baseline | offline future data used for smoothing only
7.26 | 38 | 7.8 Correlated errors, layer averages, and the S1 comparison | shared-image noise and S1 comparison | representative family check; physical validity conditional | test_navigation_extra.py:264 test_shared_image_velocity_temporal_covariance; test_retrieval_extra.py:59 test_layer_variance_equal_correlation_closed_form | atmosphere/shared_swing_wind_bias | agreement does not exclude shared motion/prior bias
7.27 | 38 | 7.8 Correlated errors, layer averages, and the S1 comparison | shared-image noise and S1 comparison | representative family check; physical validity conditional | test_navigation_extra.py:264 test_shared_image_velocity_temporal_covariance; test_retrieval_extra.py:59 test_layer_variance_equal_correlation_closed_form | atmosphere/shared_swing_wind_bias | agreement does not exclude shared motion/prior bias
7.28 | 38 | 7.8 Correlated errors, layer averages, and the S1 comparison | shared-image noise and S1 comparison | representative family check; physical validity conditional | test_navigation_extra.py:264 test_shared_image_velocity_temporal_covariance; test_retrieval_extra.py:59 test_layer_variance_equal_correlation_closed_form | atmosphere/shared_swing_wind_bias | agreement does not exclude shared motion/prior bias
7.29 | 38 | 7.8 Correlated errors, layer averages, and the S1 comparison | shared-image noise and S1 comparison | representative family check; physical validity conditional | test_navigation_extra.py:264 test_shared_image_velocity_temporal_covariance; test_retrieval_extra.py:59 test_layer_variance_equal_correlation_closed_form | atmosphere/shared_swing_wind_bias | agreement does not exclude shared motion/prior bias
7.30 | 39 | 7.9 Worked remedy: explicitly track correlated velocity error | stationary AR1 augmented-error remedy | representative family check; physical validity conditional | test_retrieval_extra.py:9 test_ar1_stationarity_and_colored_batch_equivalence | baseline/correlated_vision_noise_corrected | known correlation; does not identify real temporal errors
7.31 | 39 | 7.9 Worked remedy: explicitly track correlated velocity error | stationary AR1 augmented-error remedy | representative family check; physical validity conditional | test_retrieval_extra.py:9 test_ar1_stationarity_and_colored_batch_equivalence | baseline/correlated_vision_noise_corrected | known correlation; does not identify real temporal errors
7.32 | 39 | 7.9 Worked remedy: explicitly track correlated velocity error | stationary AR1 augmented-error remedy | representative family check; physical validity conditional | test_retrieval_extra.py:9 test_ar1_stationarity_and_colored_batch_equivalence | baseline/correlated_vision_noise_corrected | known correlation; does not identify real temporal errors
7.33 | 39 | 7.9 Worked remedy: explicitly track correlated velocity error | stationary AR1 augmented-error remedy | representative family check; physical validity conditional | test_retrieval_extra.py:9 test_ar1_stationarity_and_colored_batch_equivalence | baseline/correlated_vision_noise_corrected | known correlation; does not identify real temporal errors
7.34 | 39 | 7.9 Worked remedy: explicitly track correlated velocity error | stationary AR1 augmented-error remedy | representative family check; physical validity conditional | test_retrieval_extra.py:9 test_ar1_stationarity_and_colored_batch_equivalence | baseline/correlated_vision_noise_corrected | known correlation; does not identify real temporal errors
7.35 | 39 | 7.10 Deriving the covariance of a layer average | continuous layer average and smoother cross covariance | representative family check; physical validity conditional | test_feasibility.py:184 test_layer_overlap_integral_and_covariance; test_retrieval_extra.py:9 test_ar1_stationarity_and_colored_batch_equivalence | baseline | baseline metrics remain sample averages; overlap identity separately exercised
7.36 | 40 | 7.10 Deriving the covariance of a layer average | continuous layer average and smoother cross covariance | representative family check; physical validity conditional | test_feasibility.py:184 test_layer_overlap_integral_and_covariance; test_retrieval_extra.py:9 test_ar1_stationarity_and_colored_batch_equivalence | baseline | baseline metrics remain sample averages; overlap identity separately exercised
7.37 | 40 | 7.10 Deriving the covariance of a layer average | continuous layer average and smoother cross covariance | representative family check; physical validity conditional | test_feasibility.py:184 test_layer_overlap_integral_and_covariance; test_retrieval_extra.py:9 test_ar1_stationarity_and_colored_batch_equivalence | baseline | baseline metrics remain sample averages; overlap identity separately exercised
7.38 | 40 | 7.10 Deriving the covariance of a layer average | continuous layer average and smoother cross covariance | representative family check; physical validity conditional | test_feasibility.py:184 test_layer_overlap_integral_and_covariance; test_retrieval_extra.py:9 test_ar1_stationarity_and_colored_batch_equivalence | baseline | baseline metrics remain sample averages; overlap identity separately exercised
7.39 | 40 | 7.10 Deriving the covariance of a layer average | continuous layer average and smoother cross covariance | representative family check; physical validity conditional | test_feasibility.py:184 test_layer_overlap_integral_and_covariance; test_retrieval_extra.py:9 test_ar1_stationarity_and_colored_batch_equivalence | baseline | baseline metrics remain sample averages; overlap identity separately exercised
7.40 | 40 | 7.10 Deriving the covariance of a layer average | continuous layer average and smoother cross covariance | representative family check; physical validity conditional | test_feasibility.py:184 test_layer_overlap_integral_and_covariance; test_retrieval_extra.py:9 test_ar1_stationarity_and_colored_batch_equivalence | baseline | baseline metrics remain sample averages; overlap identity separately exercised
7.41 | 40 | 7.10 Deriving the covariance of a layer average | continuous layer average and smoother cross covariance | representative family check; physical validity conditional | test_feasibility.py:184 test_layer_overlap_integral_and_covariance; test_retrieval_extra.py:9 test_ar1_stationarity_and_colored_batch_equivalence | baseline | baseline metrics remain sample averages; overlap identity separately exercised
7.42 | 40 | 7.10 Deriving the covariance of a layer average | continuous layer average and smoother cross covariance | representative family check; physical validity conditional | test_feasibility.py:184 test_layer_overlap_integral_and_covariance; test_retrieval_extra.py:9 test_ar1_stationarity_and_colored_batch_equivalence | baseline | baseline metrics remain sample averages; overlap identity separately exercised
7.43 | 41 | 7.11 Worked initial-condition marginalisation | joint release-velocity marginalisation | representative family check; physical validity conditional | test_retrieval_extra.py:42 test_initial_velocity_marginal_against_joint_gaussian | baseline/initial_velocity | synthetic valid joint prior; real boundary uncertainty unknown
7.44 | 41 | 7.11 Worked initial-condition marginalisation | joint release-velocity marginalisation | representative family check; physical validity conditional | test_retrieval_extra.py:42 test_initial_velocity_marginal_against_joint_gaussian | baseline/initial_velocity | synthetic valid joint prior; real boundary uncertainty unknown
7.45 | 41 | 7.11 Worked initial-condition marginalisation | joint release-velocity marginalisation | representative family check; physical validity conditional | test_retrieval_extra.py:42 test_initial_velocity_marginal_against_joint_gaussian | baseline/initial_velocity | synthetic valid joint prior; real boundary uncertainty unknown
7.46 | 41 | 7.11 Worked initial-condition marginalisation | joint release-velocity marginalisation | representative family check; physical validity conditional | test_retrieval_extra.py:42 test_initial_velocity_marginal_against_joint_gaussian | baseline/initial_velocity | synthetic valid joint prior; real boundary uncertainty unknown
7.47 | 41 | 7.11 Worked initial-condition marginalisation | joint release-velocity marginalisation | representative family check; physical validity conditional | test_retrieval_extra.py:42 test_initial_velocity_marginal_against_joint_gaussian | baseline/initial_velocity | synthetic valid joint prior; real boundary uncertainty unknown
7.48 | 41 | 7.11 Worked initial-condition marginalisation | joint release-velocity marginalisation | representative family check; physical validity conditional | test_retrieval_extra.py:42 test_initial_velocity_marginal_against_joint_gaussian | baseline/initial_velocity | synthetic valid joint prior; real boundary uncertainty unknown
7.49 | 41 | 7.12 Marginal likelihood and what model selection can establish | marginal likelihood and model comparison | representative family check; physical validity conditional | test_models.py:68 test_kalman_gp_and_rts_equivalence | model_selection | fixed-model likelihood is not a fitted-model Bayes factor
8.1 | 42 | 8.1 The landing point must include uncertainty in the current position | absolute landing covariance with cross terms | representative family check; physical validity conditional | test_feasibility.py:279 test_truth_difference_and_landing_cross_covariance | baseline | requires current-position uncertainty and all cross terms
8.2 | 42 | 8.2 Touchdown time and its uncertainty | touchdown time integral and sensitivity | representative family check; physical validity conditional | test_feasibility.py:196 test_time_height_speed_covariance | atmosphere/touchdown_time | no measured density/vertical-wind/deployment uncertainty
8.3 | 42 | 8.2 Touchdown time and its uncertainty | touchdown time integral and sensitivity | representative family check; physical validity conditional | test_feasibility.py:196 test_time_height_speed_covariance | atmosphere/touchdown_time | no measured density/vertical-wind/deployment uncertainty
8.4 | 42 | 8.2 Touchdown time and its uncertainty | touchdown time integral and sensitivity | representative family check; physical validity conditional | test_feasibility.py:196 test_time_height_speed_covariance | atmosphere/touchdown_time | no measured density/vertical-wind/deployment uncertainty
8.5 | 42 | 8.3 Calibration: a precise probability statement | landing ellipse calibration | representative family check; physical validity conditional | test_navigation_extra.py:232 test_gaussian_radial_PL_and_gating | baseline | independent synthetic descents, not a measured coverage claim
8.6 | 43 | 8.4 A theorem for a fixed landing point | fixed endpoint covariance monotonicity | representative family check; physical validity conditional | test_retrieval_extra.py:68 test_fixed_endpoint_covariance_conditioning_monotonic | baseline | theorem conditional on fixed model, endpoint and nested data
8.7 | 43 | 8.5 Why remaining-drift variance need not shrink | remaining-drift counterexamples and positive prior integral | representative family check; physical validity conditional | test_models.py:202 test_shrinkage_sufficient_condition | baseline/shrinkage_counterexample | negative lobes alone do not prove growing drift uncertainty
8.8 | 43 | 8.5 Why remaining-drift variance need not shrink | remaining-drift counterexamples and positive prior integral | representative family check; physical validity conditional | test_models.py:202 test_shrinkage_sufficient_condition | baseline/shrinkage_counterexample | negative lobes alone do not prove growing drift uncertainty
8.9 | 43 | 8.5 Why remaining-drift variance need not shrink | remaining-drift counterexamples and positive prior integral | representative family check; physical validity conditional | test_models.py:202 test_shrinkage_sufficient_condition | baseline/shrinkage_counterexample | negative lobes alone do not prove growing drift uncertainty
