brentius/cansat-sync/sim/nav/results/acquisition/tables.md

# First-fix acquisition Monte Carlo

SYNTHETIC. Generated by `sim/nav/run_acquisition_mc.py` on 2026-10-11; see its docstring for what is modelled.
A fix is correct within 10 m of truth. Intervals are Wilson 95 %.

A fix is outside capture when it misplaces the ground under some pixel by more than 12 m.

| Scenario | What | Descents | Stage 1 right | Fix per image | False fixes, of fixes | Outside capture, of fixes | Confirmed by 5 s | Confirmed by end | First confirmed fix false | Error RMS / 95 % / max, m | Within 2 sigma |
| --- | --- | ---: | ---: | ---: | ---: | ---: | ---: | ---: | ---: | ---: | ---: |
| baseline | mixed farmland, default season, moderate canopy | 24 | 83 % | 89 % (83-93) | 1 % (0-4) | 1 % (0-4) | 83 % (64-93) | 92 % (74-98) | 5 % (1-22) | 3.48 / 7.23 / 15.39 | 98 % |
| style_arable | large fields | 24 | 63 % | 35 % (27-43) | 14 % (7-26) | 8 % (3-19) | 33 % (18-53) | 38 % (21-57) | 11 % (2-44) | 7.00 / 14.97 / 25.59 | 84 % |
| style_pasture | small fields, many hedges and trees | 24 | 93 % | 97 % (93-99) | 0 % (0-3) | 0 % (0-3) | 83 % (64-93) | 96 % (80-99) | 0 % (0-14) | 1.72 / 3.12 / 3.90 | 100 % |
| style_open | very large fields, few boundaries | 24 | 47 % | 17 % (12-24) | 0 % (0-13) | 0 % (0-13) | 21 % (9-40) | 21 % (9-40) | 0 % (0-43) | 0.76 / 1.38 / 2.20 | 100 % |
| canopy_violent | 19 degree RMS swing | 24 | 67 % | 83 % (76-89) | 2 % (0-6) | 8 % (4-14) | 75 % (55-88) | 92 % (74-98) | 0 % (0-15) | 3.79 / 6.25 / 21.86 | 98 % |

| Scenario | Levelling error RMS, deg | Sites | Matches | Match SD, m | Matches beyond 4 m | Stage-3 error RMS, m | Capture error 95 % / max, m | Error over 20 m, of fixes | Attitude error RMS, deg | Velocity error RMS, m/s | FFTs 256 / 128 (median) | Host s (median) |
| --- | ---: | ---: | ---: | ---: | ---: | ---: | ---: | ---: | ---: | ---: | ---: | ---: |
| baseline | 2.98 | 19 | 25 | 0.93 | 6 % | 6.65 | 6.9 / 12.1 | 0 % (0-3) | 0.58 | 2.74 | 123 / 195 | 1.73 |
| style_arable | 2.98 | 19 | 18 | 0.88 | 16 % | 9.93 | 16.1 / 39.4 | 2 % (0-10) | 0.68 | 3.16 | 123 / 188 | 1.65 |
| style_pasture | 2.98 | 19 | 34 | 0.90 | 5 % | 4.69 | 3.0 / 4.3 | 0 % (0-3) | 0.32 | 1.66 | 123 / 180 | 1.90 |
| style_open | 2.98 | 19 | 27 | 0.27 | 2 % | 3.69 | 1.9 / 2.2 | 0 % (0-13) | 0.16 | 0.85 | 123 / 171 | 1.35 |
| canopy_violent | 4.26 | 19 | 24 | 0.94 | 6 % | 6.92 | 18.1 / 45.8 | 1 % (0-5) | 0.54 | 3.06 | 123 / 204 | 0.60 |

## Why an image gave no fix

- **baseline**: ok 128, too few matches 3, poor residuals 3, refinement: weak consensus 2, refinement: poorly determined 2, did not converge 1, no consensus 1, poorly determined 1, weak consensus 1, tilt disagrees with levelling 1, refinement: too few matches 1
- **style_arable**: ok 50, too few matches 36, weak consensus 15, poorly determined 12, refinement: poorly determined 12, refinement: weak consensus 7, refinement: too few matches 5, no consensus 3, did not converge 2, poor residuals 1, refinement: poor residuals 1
- **style_pasture**: ok 140, poor residuals 3, tilt disagrees with levelling 1
- **style_open**: too few matches 78, ok 25, weak consensus 14, refinement: too few matches 10, no consensus 5, poor residuals 4, did not converge 3, refinement: weak consensus 2, refinement: poorly determined 2, tilt disagrees with levelling 1
- **canopy_violent**: ok 120, too few matches 7, refinement: poorly determined 5, tilt disagrees with levelling 4, weak consensus 3, did not converge 2, poor residuals 1, poorly determined 1, tilt too large 1
