brentius/cansat-sync/sim/nav/results/acquisition_ab/tables.md

# First-fix acquisition Monte Carlo

SYNTHETIC. Generated by `sim/nav/run_acquisition_mc.py` on 2026-10-11; see its docstring for what is modelled.
A fix is correct within 10 m of truth. Intervals are Wilson 95 %.

A fix is outside capture when it misplaces the ground under some pixel by more than 12 m.

| Scenario | What | Descents | Stage 1 right | Fix per image | False fixes, of fixes | Outside capture, of fixes | Confirmed by 5 s | Confirmed by end | First confirmed fix false | Error RMS / 95 % / max, m | Within 2 sigma |
| --- | --- | ---: | ---: | ---: | ---: | ---: | ---: | ---: | ---: | ---: | ---: |
| baseline | mixed farmland, default season, moderate canopy | 96 | 83 % | 87 % (84-89) | 2 % (1-3) | 2 % (1-4) | 78 % (69-85) | 93 % (86-96) | 1 % (0-6) | 3.82 / 6.72 / 33.30 | 98 % |
| style_arable | large fields | 96 | 65 % | 40 % (36-44) | 10 % (7-15) | 8 % (5-12) | 35 % (27-45) | 56 % (46-66) | 6 % (2-15) | 6.14 / 12.14 / 29.68 | 90 % |
| interim_solver | stage 3 by the six-parameter solver instead of the fixed-tilt fit | 96 | 83 % | 90 % (87-92) | 1 % (0-2) | 1 % (0-2) | 82 % (73-89) | 92 % (84-96) | 0 % (0-4) | 3.19 / 5.74 / 25.62 | 99 % |
| interim_solver_arable | the same over large fields | 96 | 65 % | 40 % (36-44) | 8 % (5-12) | 6 % (3-10) | 36 % (28-46) | 54 % (44-64) | 6 % (2-16) | 6.04 / 11.24 / 39.30 | 92 % |
| no_tilt_gate_arable | large fields, no check of the fix against the levelled tilt | 96 | 65 % | 40 % (36-44) | 10 % (7-15) | 8 % (5-12) | 35 % (27-45) | 56 % (46-66) | 6 % (2-15) | 6.14 / 12.14 / 29.68 | 90 % |

| Scenario | Levelling error RMS, deg | Sites | Matches | Match SD, m | Matches beyond 4 m | Stage-3 error RMS, m | Capture error 95 % / max, m | Error over 20 m, of fixes | Attitude error RMS, deg | Velocity error RMS, m/s | FFTs 256 / 128 (median) | Host s (median) |
| --- | ---: | ---: | ---: | ---: | ---: | ---: | ---: | ---: | ---: | ---: | ---: | ---: |
| baseline | 3.30 | 19 | 24 | 0.98 | 7 % | 13.63 | 7.3 / 34.3 | 0 % (0-1) | 0.57 | 2.72 | 123 / 189 | 0.52 |
| style_arable | 3.30 | 19 | 19 | 0.96 | 14 % | 14.52 | 15.1 / 40.3 | 1 % (0-3) | 0.77 | 4.75 | 123 / 198 | 0.39 |
| interim_solver | 3.30 | 19 | 25 | 0.93 | 7 % | 6.13 | 5.3 / 40.5 | 0 % (0-1) | 0.49 | 2.42 | 123 / 183 | 0.52 |
| interim_solver_arable | 3.30 | 19 | 20 | 0.93 | 15 % | 10.31 | 13.6 / 40.0 | 1 % (0-4) | 0.73 | 3.97 | 123 / 178 | 0.51 |
| no_tilt_gate_arable | 3.30 | 19 | 19 | 0.96 | 14 % | 14.52 | 15.1 / 40.3 | 1 % (0-3) | 0.77 | 4.75 | 123 / 198 | 0.57 |

## Why an image gave no fix

- **baseline**: ok 499, refinement: poorly determined 35, no consensus 17, too few matches 11, refinement: weak consensus 7, refinement: too few matches 5, refinement: poor residuals 1, tilt disagrees with levelling 1
- **style_arable**: ok 228, too few matches 102, refinement: poorly determined 92, refinement: weak consensus 64, no consensus 55, refinement: too few matches 23, refinement: poor residuals 12
- **interim_solver**: ok 516, refinement: poorly determined 10, tilt disagrees with levelling 10, too few matches 10, poor residuals 8, refinement: weak consensus 8, poorly determined 6, did not converge 4, weak consensus 3, no consensus 1
- **interim_solver_arable**: ok 228, too few matches 109, refinement: poorly determined 60, weak consensus 56, refinement: weak consensus 36, poorly determined 33, refinement: too few matches 13, did not converge 11, poor residuals 11, refinement: poor residuals 8, no consensus 6, tilt disagrees with levelling 5
- **no_tilt_gate_arable**: ok 228, too few matches 102, refinement: poorly determined 92, refinement: weak consensus 64, no consensus 55, refinement: too few matches 23, refinement: poor residuals 12
