brentius/cansat-sync/sim/nav/results/acquisition_first_run/tables.md

# First-fix acquisition Monte Carlo

SYNTHETIC. Generated by `sim/nav/run_acquisition_mc.py` on 2026-10-11; see its docstring for what is modelled.
A fix is correct within 10 m of truth. Intervals are Wilson 95 %.

| Scenario | What | Descents | Stage 1 right | Fix per image | False fixes, of fixes | Confirmed by 5 s | Confirmed by end | First confirmed fix false | Error RMS / 95 % / max, m | Within 2 sigma |
| --- | --- | ---: | ---: | ---: | ---: | ---: | ---: | ---: | ---: | ---: |
| baseline | mixed farmland, default season, moderate canopy | 96 | 83 % | 91 % (89-93) | 1 % (0-2) | 84 % (76-90) | 94 % (87-97) | 0 % (0-4) | 3.06 / 6.00 / 17.09 | 89 % |
| style_arable | large fields | 96 | 65 % | 41 % (37-45) | 9 % (6-14) | 35 % (27-45) | 51 % (41-61) | 4 % (1-14) | 6.74 / 13.32 / 48.96 | 77 % |
| style_pasture | small fields, many hedges and trees | 96 | 90 % | 97 % (95-98) | 0 % (0-1) | 85 % (77-91) | 97 % (91-99) | 0 % (0-4) | 1.78 / 3.29 / 5.17 | 98 % |
| style_open | very large fields, few boundaries | 96 | 43 % | 20 % (17-23) | 0 % (0-3) | 21 % (14-30) | 22 % (15-31) | 0 % (0-15) | 1.21 / 2.32 / 6.19 | 100 % |
| style_tramline | tramlines strong, boundaries faint | 96 | 22 % | 3 % (2-5) | 5 % (1-24) | 2 % (1-7) | 4 % (2-10) | 0 % (0-49) | 4.59 / 7.54 / 13.87 | 70 % |
| season_identical | map and ground identical | 48 | 88 % | 100 % (99-100) | 0 % (0-1) | 92 % (80-97) | 96 % (86-99) | 0 % (0-8) | 0.24 / 0.40 / 0.62 | 100 % |
| season_shadows_only | only the sun has moved | 48 | 88 % | 100 % (99-100) | 0 % (0-1) | 90 % (78-95) | 96 % (86-99) | 0 % (0-8) | 0.92 / 1.69 / 3.35 | 100 % |
| season_fields_only | every field redrawn, same sun | 48 | 73 % | 83 % (78-87) | 0 % (0-2) | 81 % (68-90) | 94 % (83-98) | 0 % (0-8) | 1.66 / 3.28 / 4.77 | 100 % |
| season_all_fields | every field redrawn, sun moved | 48 | 75 % | 80 % (74-84) | 1 % (0-3) | 83 % (70-91) | 85 % (73-93) | 0 % (0-9) | 4.27 / 7.19 / 35.42 | 83 % |
| season_low_sun | sun at 20 degrees elevation | 48 | 79 % | 66 % (61-72) | 2 % (1-5) | 62 % (48-75) | 73 % (59-83) | 0 % (0-10) | 3.57 / 8.14 / 13.72 | 90 % |
| season_leaf_off | hedges and trees bare | 48 | 77 % | 85 % (81-89) | 1 % (0-3) | 81 % (68-90) | 90 % (78-95) | 0 % (0-8) | 3.43 / 6.04 / 19.18 | 85 % |
| season_exposure | gain 0.7, gamma 1.3, offset 10 | 48 | 81 % | 87 % (82-90) | 1 % (0-3) | 83 % (70-91) | 85 % (73-93) | 0 % (0-9) | 3.19 / 5.91 / 14.08 | 86 % |
| arable_identical | large fields, map and ground identical | 48 | 89 % | 100 % (99-100) | 0 % (0-1) | 94 % (83-98) | 96 % (86-99) | 0 % (0-8) | 0.29 / 0.50 / 0.96 | 100 % |
| arable_all_fields | large fields, every field redrawn | 48 | 64 % | 27 % (23-33) | 15 % (9-25) | 27 % (17-41) | 29 % (18-43) | 7 % (1-31) | 6.47 / 13.67 / 16.41 | 66 % |
| canopy_benign | stable canopy | 48 | 85 % | 88 % (84-91) | 0 % (0-1) | 98 % (89-100) | 98 % (89-100) | 0 % (0-8) | 2.59 / 5.11 / 8.16 | 93 % |
| canopy_severe | 25 degree trim, gliding | 48 | 75 % | 87 % (83-91) | 0 % (0-2) | 85 % (73-93) | 90 % (78-95) | 0 % (0-8) | 3.00 / 6.10 / 12.49 | 90 % |
| canopy_violent | 19 degree RMS swing | 48 | 66 % | 83 % (78-87) | 2 % (1-5) | 69 % (55-80) | 90 % (78-95) | 0 % (0-8) | 3.66 / 6.29 / 21.86 | 92 % |
| violent_arable | 19 degree RMS swing over large fields | 48 | 51 % | 34 % (28-39) | 10 % (6-18) | 19 % (10-32) | 29 % (18-43) | 7 % (1-31) | 7.01 / 12.02 / 35.50 | 73 % |
| compass | yaw known to 5 degrees (magnetometer), searched +/-15 | 48 | 83 % | 89 % (84-92) | 0 % (0-2) | 88 % (75-94) | 94 % (83-98) | 0 % (0-8) | 3.23 / 6.21 / 15.39 | 84 % |
| compass_arable | the same over large fields | 48 | 72 % | 39 % (34-45) | 11 % (6-18) | 31 % (20-45) | 44 % (31-58) | 0 % (0-15) | 7.18 / 15.76 / 27.44 | 75 % |
| level_perfect | tilt known exactly | 48 | 92 % | 90 % (86-93) | 1 % (0-3) | 98 % (89-100) | 100 % (93-100) | 0 % (0-7) | 3.20 / 6.09 / 19.58 | 88 % |
| level_none_violent | no levelling (gyro only), violent canopy | 48 | 12 % | 47 % (41-52) | 0 % (0-3) | 54 % (40-67) | 60 % (46-73) | 0 % (0-12) | 3.08 / 5.65 / 9.55 | 90 % |
| height_error_8pct | barometric height 8 % out (1 sigma) | 48 | 69 % | 76 % (70-80) | 1 % (0-3) | 75 % (61-85) | 83 % (70-91) | 0 % (0-9) | 3.13 / 6.20 / 13.02 | 91 % |
| edge_of_prior | descents up to 280 m from the pad | 48 | 77 % | 84 % (80-88) | 1 % (0-3) | 81 % (68-90) | 90 % (78-95) | 2 % (0-12) | 3.36 / 5.70 / 25.66 | 91 % |
| blurred_noisy | blur 1.5 px and 4 grey levels of noise | 48 | 83 % | 79 % (74-83) | 2 % (1-5) | 81 % (68-90) | 88 % (75-94) | 5 % (1-16) | 4.10 / 7.26 / 17.57 | 82 % |
| map_2m_only | 2 m/px map: no stage 4 | 48 | 80 % | 57 % (51-62) | 2 % (1-6) | 58 % (44-71) | 67 % (53-78) | 3 % (1-16) | 5.04 / 8.79 / 22.81 | 85 % |
| feature_intensity | brightness correlated instead of edges | 48 | 20 % | 27 % (23-33) | 0 % (0-5) | 21 % (12-34) | 33 % (22-47) | 0 % (0-19) | 2.57 / 5.55 / 8.81 | 89 % |
| feature_intensity_identical | brightness, map and ground identical | 48 | 89 % | 100 % (99-100) | 0 % (0-1) | 92 % (80-97) | 96 % (86-99) | 0 % (0-8) | 0.23 / 0.44 / 0.59 | 100 % |
| yaw_step_10 | yaw hypotheses every 10 degrees | 48 | 81 % | 86 % (81-89) | 1 % (0-3) | 83 % (70-91) | 92 % (80-97) | 0 % (0-8) | 3.63 / 6.52 / 25.83 | 84 % |
| yaw_step_15 | yaw hypotheses every 15 degrees | 48 | 74 % | 84 % (79-88) | 0 % (0-2) | 83 % (70-91) | 94 % (83-98) | 0 % (0-8) | 3.13 / 5.81 / 14.83 | 85 % |
| one_candidate | only the best stage-1 peak is tried | 48 | 80 % | 83 % (78-87) | 0 % (0-2) | 83 % (70-91) | 92 % (80-97) | 0 % (0-8) | 3.21 / 6.16 / 15.39 | 87 % |
| strict_interim | stage 3 under the full solver checks, large fields | 48 | 62 % | 13 % (9-17) | 5 % (1-18) | 6 % (2-17) | 12 % (6-25) | 0 % (0-39) | 4.59 / 9.96 / 12.05 | 81 % |
| strict_interim_mixed | stage 3 under the full solver checks | 48 | 80 % | 56 % (50-62) | 1 % (0-3) | 60 % (46-73) | 67 % (53-78) | 3 % (1-16) | 2.77 / 4.87 / 15.39 | 92 % |
| low_200m | attempts at 205-165 m | 48 | 77 % | 64 % (58-70) | 5 % (3-10) | - | 69 % (55-80) | 3 % (1-15) | 6.73 / 10.24 / 56.24 | 88 % |
| low_130m | attempts at 142-100 m | 48 | 30 % | 15 % (11-21) | 5 % (1-18) | - | 17 % (9-30) | 0 % (0-32) | 4.38 / 9.69 / 10.18 | 84 % |
| low_200m_arable | attempts at 205-165 m over large fields | 48 | 55 % | 18 % (13-23) | 7 % (2-19) | - | 17 % (9-30) | 0 % (0-32) | 7.01 / 13.39 / 29.94 | 74 % |

| Scenario | Levelling error RMS, deg | Sites | Matches | Match SD, m | Matches beyond 4 m | Stage-3 error RMS, m | Attitude error RMS, deg | Velocity error RMS, m/s | FFTs 256 / 128 (median) | Host s (median) |
| --- | ---: | ---: | ---: | ---: | ---: | ---: | ---: | ---: | ---: | ---: |
| baseline | 3.30 | 19 | 25 | 0.93 | 6 % | 6.21 | 0.51 | 2.46 | 123 / 183 | 1.10 |
| style_arable | 3.30 | 19 | 19 | 0.94 | 14 % | 9.77 | 0.73 | 4.44 | 123 / 178 | 0.94 |
| style_pasture | 3.30 | 19 | 33 | 0.92 | 5 % | 4.37 | 0.32 | 1.75 | 123 / 183 | 0.91 |
| style_open | 3.30 | 19 | 26 | 0.26 | 2 % | 5.57 | 0.27 | 1.63 | 123 / 171 | 0.76 |
| style_tramline | 3.30 | 19 | 25 | 0.76 | 18 % | 5.92 | 0.67 | 2.31 | 123 / 162 | 0.73 |
| season_identical | 3.30 | 19 | 41 | 0.14 | 0 % | 1.64 | 0.05 | 0.43 | 123 / 180 | 0.92 |
| season_shadows_only | 3.30 | 19 | 39 | 0.46 | 1 % | 2.62 | 0.14 | 0.85 | 123 / 180 | 0.83 |
| season_fields_only | 3.30 | 19 | 24 | 0.49 | 4 % | 4.92 | 0.34 | 1.81 | 123 / 180 | 0.77 |
| season_all_fields | 3.30 | 19 | 22 | 1.10 | 9 % | 6.46 | 0.64 | 3.31 | 123 / 180 | 0.75 |
| season_low_sun | 3.30 | 19 | 21 | 0.86 | 10 % | 8.24 | 0.65 | 3.49 | 123 / 180 | 0.75 |
| season_leaf_off | 3.30 | 19 | 24 | 1.00 | 5 % | 6.03 | 0.55 | 2.56 | 123 / 180 | 0.76 |
| season_exposure | 3.30 | 19 | 25 | 0.96 | 6 % | 6.48 | 0.56 | 2.48 | 123 / 180 | 0.76 |
| arable_identical | 3.30 | 19 | 41 | 0.17 | 0 % | 1.84 | 0.06 | 0.45 | 123 / 183 | 0.76 |
| arable_all_fields | 3.30 | 19 | 16 | 1.04 | 22 % | 9.81 | 0.84 | 4.57 | 123 / 176 | 0.68 |
| canopy_benign | 3.42 | 18 | 25 | 0.96 | 6 % | 6.51 | 0.47 | 2.04 | 123 / 177 | 0.73 |
| canopy_severe | 4.24 | 19 | 24 | 0.96 | 5 % | 5.44 | 0.50 | 2.43 | 123 / 180 | 0.74 |
| canopy_violent | 4.28 | 19 | 24 | 0.97 | 6 % | 7.18 | 0.54 | 3.19 | 123 / 186 | 0.72 |
| violent_arable | 4.28 | 19 | 21 | 1.00 | 14 % | 9.43 | 0.99 | 6.62 | 123 / 180 | 0.68 |
| compass | 3.30 | 19 | 25 | 0.94 | 6 % | 6.44 | 0.57 | 2.46 | 17 / 180 | 0.48 |
| compass_arable | 3.30 | 19 | 20 | 0.91 | 15 % | 8.80 | 0.73 | 4.59 | 17 / 177 | 0.45 |
| level_perfect | 0.00 | 19 | 25 | 0.93 | 6 % | 6.07 | 0.53 | 3.00 | 123 / 183 | 0.76 |
| level_none_violent | 13.31 | 19 | 24 | 1.05 | 6 % | 10.63 | 0.65 | 3.28 | 123 / 180 | 0.67 |
| height_error_8pct | 3.30 | 19 | 25 | 0.93 | 6 % | 6.85 | 0.55 | 2.38 | 123 / 180 | 0.65 |
| edge_of_prior | 3.30 | 19 | 25 | 0.96 | 6 % | 7.18 | 0.54 | 3.16 | 123 / 180 | 0.63 |
| blurred_noisy | 3.30 | 19 | 20 | 1.11 | 10 % | 6.04 | 0.63 | 3.11 | 123 / 182 | 0.72 |
| map_2m_only | 3.30 | 19 | 14 | 1.16 | 12 % | - | 0.83 | 4.27 | 123 / 60 | 0.55 |
| feature_intensity | 3.30 | 19 | 26 | 0.76 | 5 % | 6.17 | 0.46 | 2.38 | 123 / 168 | 0.63 |
| feature_intensity_identical | 3.30 | 19 | 41 | 0.14 | 0 % | 1.66 | 0.05 | 0.43 | 123 / 180 | 0.79 |
| yaw_step_10 | 3.30 | 19 | 25 | 0.97 | 6 % | 6.93 | 0.58 | 2.57 | 75 / 180 | 0.72 |
| yaw_step_15 | 3.30 | 19 | 25 | 0.94 | 6 % | 6.50 | 0.56 | 2.57 | 51 / 180 | 0.79 |
| one_candidate | 3.30 | 19 | 25 | 0.95 | 6 % | 6.43 | 0.56 | 2.50 | 123 / 177 | 1.06 |
| strict_interim | 3.30 | 19 | 21 | 0.83 | 16 % | 5.15 | 0.78 | 2.67 | 123 / 162 | 0.85 |
| strict_interim_mixed | 3.30 | 19 | 27 | 0.93 | 6 % | 4.88 | 0.44 | 1.91 | 123 / 174 | 1.08 |
| low_200m | 1.98 | 18 | 23 | 0.95 | 6 % | 8.91 | 0.86 | 2.81 | 123 / 180 | 1.02 |
| low_130m | 1.90 | 18 | 26 | 0.84 | 5 % | 8.37 | 1.61 | 2.59 | 123 / 162 | 0.65 |
| low_200m_arable | 1.98 | 18 | 24 | 0.90 | 12 % | 8.85 | 1.26 | 2.52 | 123 / 171 | 0.75 |

## Why an image gave no fix

- **baseline**: ok 525, too few matches 10, refinement: poorly determined 10, poor residuals 8, refinement: weak consensus 7, poorly determined 6, did not converge 4, weak consensus 3, refinement: too few matches 2, no consensus 1
- **style_arable**: ok 236, too few matches 109, weak consensus 56, refinement: poorly determined 54, refinement: weak consensus 35, poorly determined 33, refinement: too few matches 16, did not converge 11, poor residuals 11, refinement: poor residuals 9, no consensus 6
- **style_pasture**: ok 559, poor residuals 15, refinement: poorly determined 1, weak consensus 1
- **style_open**: too few matches 281, ok 115, refinement: too few matches 48, weak consensus 44, no consensus 20, refinement: poorly determined 20, poor residuals 15, refinement: weak consensus 14, did not converge 13, poorly determined 4, implausible pose 1, disagrees with the search 1
- **style_tramline**: too few matches 454, weak consensus 42, ok 20, did not converge 19, no consensus 14, poorly determined 11, refinement: poorly determined 5, refinement: weak consensus 3, refinement: poor residuals 2, poor residuals 2, refinement: too few matches 2, disagrees with the search 2
- **season_identical**: ok 288
- **season_shadows_only**: ok 288
- **season_fields_only**: ok 238, too few matches 24, refinement: poorly determined 12, weak consensus 8, poor residuals 3, refinement: too few matches 1, poorly determined 1, refinement: weak consensus 1
- **season_all_fields**: ok 229, too few matches 24, refinement: poorly determined 13, refinement: weak consensus 6, weak consensus 4, poorly determined 3, poor residuals 3, did not converge 3, refinement: poor residuals 1, no consensus 1, refinement: too few matches 1
- **season_low_sun**: ok 191, weak consensus 20, too few matches 16, refinement: weak consensus 16, refinement: poorly determined 15, refinement: poor residuals 7, poor residuals 7, poorly determined 5, did not converge 4, no consensus 3, refinement: did not converge 2, refinement: too few matches 2
- **season_leaf_off**: ok 246, too few matches 15, refinement: poorly determined 6, weak consensus 5, poor residuals 5, did not converge 4, poorly determined 2, refinement: weak consensus 2, refinement: too few matches 2, no consensus 1
- **season_exposure**: ok 250, too few matches 8, poor residuals 8, refinement: poorly determined 7, weak consensus 4, refinement: weak consensus 4, did not converge 3, refinement: too few matches 2, poorly determined 1, refinement: did not converge 1
- **arable_identical**: ok 288
- **arable_all_fields**: ok 79, too few matches 78, weak consensus 29, refinement: poorly determined 29, refinement: weak consensus 28, poorly determined 13, refinement: too few matches 11, refinement: poor residuals 7, did not converge 4, poor residuals 4, no consensus 3, refinement: did not converge 2, disagrees with the search 1
- **canopy_benign**: ok 254, too few matches 9, refinement: poorly determined 7, weak consensus 7, did not converge 3, poor residuals 3, refinement: weak consensus 2, poorly determined 1, refinement: poor residuals 1, refinement: too few matches 1
- **canopy_severe**: ok 251, too few matches 10, refinement: poorly determined 9, weak consensus 6, refinement: weak consensus 3, did not converge 3, poorly determined 2, poor residuals 2, no consensus 1, refinement: poor residuals 1
- **canopy_violent**: ok 238, refinement: poorly determined 14, too few matches 13, weak consensus 6, poorly determined 5, poor residuals 4, refinement: weak consensus 3, did not converge 2, tilt too large 2, no consensus 1
- **violent_arable**: ok 97, too few matches 72, refinement: poorly determined 31, weak consensus 31, poorly determined 15, refinement: weak consensus 10, poor residuals 8, refinement: poor residuals 7, did not converge 6, refinement: too few matches 4, no consensus 4, tilt too large 2, disagrees with the search 1
- **compass**: ok 255, too few matches 8, refinement: poorly determined 5, refinement: weak consensus 5, poor residuals 4, weak consensus 3, refinement: too few matches 3, did not converge 2, poorly determined 2, no consensus 1
- **compass_arable**: ok 113, too few matches 48, refinement: poorly determined 33, weak consensus 27, poorly determined 21, refinement: weak consensus 14, did not converge 8, refinement: too few matches 8, refinement: poor residuals 7, poor residuals 5, no consensus 3, degenerate geometry 1
- **level_perfect**: ok 258, too few matches 9, weak consensus 6, refinement: poorly determined 6, poorly determined 3, poor residuals 3, refinement: poor residuals 2, refinement: weak consensus 1
- **level_none_violent**: ok 134, too few matches 39, refinement: poorly determined 21, weak consensus 18, disagrees with the search 16, tilt too large 15, poorly determined 14, did not converge 12, poor residuals 9, no consensus 3, refinement: weak consensus 3, refinement: too few matches 2, implausible pose 1, refinement: did not converge 1
- **height_error_8pct**: ok 218, too few matches 27, weak consensus 15, poor residuals 8, refinement: weak consensus 5, did not converge 4, refinement: poorly determined 4, poorly determined 3, refinement: too few matches 3, no consensus 1
- **edge_of_prior**: ok 243, too few matches 16, weak consensus 7, did not converge 7, refinement: poorly determined 5, poor residuals 4, refinement: weak consensus 3, poorly determined 2, no consensus 1
- **blurred_noisy**: ok 228, refinement: poorly determined 19, refinement: weak consensus 9, weak consensus 8, too few matches 7, refinement: too few matches 6, poorly determined 4, refinement: poor residuals 3, did not converge 3, poor residuals 1
- **map_2m_only**: ok 163, poorly determined 59, weak consensus 44, too few matches 14, poor residuals 4, did not converge 3, no consensus 1
- **feature_intensity**: too few matches 126, ok 79, did not converge 31, weak consensus 24, no consensus 19, refinement: too few matches 5, poorly determined 3, refinement: poorly determined 1
- **feature_intensity_identical**: ok 288
- **yaw_step_10**: ok 247, too few matches 11, refinement: poorly determined 9, refinement: weak consensus 6, weak consensus 4, poorly determined 4, poor residuals 3, did not converge 2, refinement: too few matches 1, no consensus 1
- **yaw_step_15**: ok 242, too few matches 17, refinement: poorly determined 7, weak consensus 6, poor residuals 5, refinement: weak consensus 4, did not converge 3, poorly determined 2, refinement: too few matches 1, refinement: poor residuals 1
- **one_candidate**: ok 238, too few matches 16, weak consensus 8, poorly determined 6, refinement: weak consensus 5, poor residuals 4, refinement: poorly determined 4, did not converge 3, refinement: too few matches 2, no consensus 1, implausible pose 1
- **strict_interim**: weak consensus 95, too few matches 79, poorly determined 54, ok 37, no consensus 6, did not converge 4, refinement: weak consensus 3, poor residuals 3, refinement: too few matches 2, refinement: poor residuals 2, refinement: poorly determined 2, degenerate geometry 1
- **strict_interim_mixed**: ok 162, poorly determined 59, weak consensus 44, too few matches 14, poor residuals 4, did not converge 3, no consensus 1, refinement: weak consensus 1
- **low_200m**: ok 154, too few matches 34, refinement: poorly determined 16, weak consensus 13, did not converge 5, poorly determined 5, refinement: weak consensus 4, refinement: too few matches 2, no consensus 2, disagrees with the search 2, poor residuals 2, implausible pose 1
- **low_130m**: tilt too large 77, too few matches 61, ok 37, refinement: poorly determined 19, poorly determined 14, weak consensus 9, did not converge 9, refinement: weak consensus 6, refinement: too few matches 4, no consensus 2, refinement: did not converge 1, implausible pose 1
- **low_200m_arable**: too few matches 100, ok 42, weak consensus 23, did not converge 19, poorly determined 17, refinement: poorly determined 16, refinement: too few matches 10, refinement: weak consensus 4, no consensus 3, refinement: did not converge 3, poor residuals 2, implausible pose 1
