brentius/cansat-sync/sim/nav/results/nav_mc/tables.md

# Navigation Monte Carlo tables (SYNTHETIC)

Horizontal error is against simulated truth, over frames above the map floor and at least 2 s after the first fix; 160 descents per scenario. "≤10 m" is the fraction of descents whose worst such error met T1. NEES expectations are 2 and 16 (the 16 excludes the time-offset state, and is inflated by errors the filter absorbs into its bias states, so position NEES is the meaningful consistency figure). "recovered" is the fraction of descents in which the filter widened its prior at least once. "Δt err" is the camera time-offset estimate error. "search 99 %" is the 99th percentile over frames of the largest good-landmark prediction residual on the ground: what the matcher's search window must cover.

## Verification: the filter model equals the simulation

| Scenario | RMS m | 95 % m | worst m | filter 1σ m | ≤10 m | tilt ° | yaw ° | vel m/s | NEES pos (2) | NEES all (16) | PL exceeded | good rejected | bad accepted | recovered | Δt err ms | search 99 % m |
|---|---:|---:|---:|---:|---:|---:|---:|---:|---:|---:|---:|---:|---:|---:|---:|---:|
| matched_benign | 0.09 | 0.15 | 0.3 | 0.08 | 1.000 | 0.025 | 0.012 | 0.059 | 2.0 | 16 | 0.040 | 0.003 | n/a | 0.00 | 0.00 | 0.73 |
| matched_moderate | 0.08 | 0.15 | 0.3 | 0.08 | 1.000 | 0.024 | 0.012 | 0.059 | 2.0 | 16 | 0.040 | 0.003 | n/a | 0.00 | 0.00 | 0.73 |
| matched_severe | 0.08 | 0.15 | 0.3 | 0.08 | 1.000 | 0.026 | 0.012 | 0.058 | 2.1 | 16 | 0.039 | 0.003 | n/a | 0.00 | 0.00 | 0.73 |
| matched_violent | 0.06 | 0.11 | 0.3 | 0.06 | 1.000 | 0.017 | 0.010 | 0.053 | 2.1 | 16 | 0.036 | 0.003 | n/a | 0.00 | 0.00 | 0.79 |
| matched_time_state | 0.08 | 0.15 | 0.3 | 0.08 | 1.000 | 0.024 | 0.013 | 0.060 | 2.1 | 17 | 0.042 | 0.004 | n/a | 0.00 | 0.08 | 1.42 |
| matched_full_filter | 0.08 | 0.15 | 0.3 | 0.08 | 1.000 | 0.024 | 0.012 | 0.059 | 2.0 | 16 | 0.041 | 0.004 | n/a | 0.00 | 0.00 | 0.72 |
| matched_single_benign | 1.41 | 0.16 | 42.4 | 0.25 | 0.994 | 0.037 | 0.029 | 0.284 | 2.7 | 26 | 0.056 | 0.012 | n/a | 0.00 | 0.00 | 0.81 |
| matched_single_moderate | 2.69 | 0.16 | 53.2 | 0.58 | 0.994 | 0.081 | 0.130 | 0.348 | 2.8 | 29 | 0.064 | 0.017 | n/a | 0.00 | 0.00 | 12.98 |
| matched_single_severe | 0.10 | 0.15 | 3.6 | 0.08 | 1.000 | 0.027 | 0.012 | 0.078 | 2.3 | 24 | 0.054 | 0.005 | n/a | 0.00 | 0.00 | 0.74 |
| matched_single_violent | 0.07 | 0.12 | 0.3 | 0.06 | 1.000 | 0.017 | 0.010 | 0.068 | 2.3 | 25 | 0.053 | 0.005 | n/a | 0.00 | 0.00 | 0.81 |
| matched_single_tight_start | 0.08 | 0.15 | 0.3 | 0.08 | 1.000 | 0.024 | 0.012 | 0.057 | 2.0 | 16 | 0.041 | 0.003 | n/a | 0.00 | 0.00 | 0.72 |

## Fragility of the plain filter: one unmodelled error at a time

| Scenario | RMS m | 95 % m | worst m | filter 1σ m | ≤10 m | tilt ° | yaw ° | vel m/s | NEES pos (2) | NEES all (16) | PL exceeded | good rejected | bad accepted | recovered | Δt err ms | search 99 % m |
|---|---:|---:|---:|---:|---:|---:|---:|---:|---:|---:|---:|---:|---:|---:|---:|---:|
| matched_moderate | 0.08 | 0.15 | 0.3 | 0.08 | 1.000 | 0.024 | 0.012 | 0.059 | 2.0 | 16 | 0.040 | 0.003 | n/a | 0.00 | 0.00 | 0.73 |
| plain_accel_scale | 0.08 | 0.15 | 0.3 | 0.08 | 1.000 | 0.024 | 0.012 | 0.059 | 2.0 | 1744 | 0.040 | 0.003 | n/a | 0.00 | 0.00 | 0.73 |
| plain_calibration | 0.23 | 0.44 | 1.2 | 0.08 | 1.000 | 0.090 | 0.051 | 0.164 | 15.2 | 863 | 0.557 | 0.006 | n/a | 0.00 | 0.00 | 0.78 |
| plain_map_xy | 0.24 | 0.45 | 0.8 | 0.13 | 1.000 | 0.060 | 0.031 | 0.094 | 7.1 | 44 | 0.361 | 0.003 | n/a | 0.00 | 0.00 | 1.38 |
| plain_relief | 0.28 | 0.50 | 1.0 | 0.16 | 1.000 | 0.091 | 0.013 | 0.100 | 6.2 | 40 | 0.330 | 0.003 | n/a | 0.00 | 0.00 | 3.04 |
| plain_gyro_cross_axis | 1.02 | 0.69 | 29.4 | 0.09 | 0.988 | 0.239 | 0.022 | 0.291 | 34.7 | 865 | 0.432 | 0.023 | n/a | 0.00 | 0.00 | 1.78 |
| plain_gyro_scale | 7.92 | 0.43 | 103.8 | 1.07 | 0.956 | 0.213 | 0.482 | 0.757 | 12.0 | 689 | 0.147 | 0.063 | n/a | 0.00 | 0.00 | 46.98 |
| plain_outliers_5pct | 19.85 | 32.86 | 220.3 | 2.88 | 0.912 | 0.890 | 0.957 | 2.101 | 38.4 | 423 | 0.211 | 0.106 | 0.013 | 0.00 | 0.00 | 111.17 |
| plain_delay_1ms | 26.23 | 66.62 | 189.5 | 5.07 | 0.750 | 0.618 | 0.497 | 2.495 | 19.4 | 119 | 0.280 | 0.251 | n/a | 0.00 | 1.00 | 127.74 |
| plain_all_errors | 24.53 | 32.62 | 223.4 | 3.18 | 0.919 | 0.542 | 0.833 | 2.110 | 68.7 | 2653 | 0.709 | 0.088 | 0.022 | 0.00 | 1.00 | 144.40 |
| proposal_all_errors | 22.70 | 22.07 | 212.4 | 2.91 | 0.925 | 0.512 | 0.879 | 1.934 | 68.1 | 2662 | 0.708 | 0.085 | 0.022 | 0.00 | 1.00 | 141.14 |

## Full filter, baseline errors, by canopy class

| Scenario | RMS m | 95 % m | worst m | filter 1σ m | ≤10 m | tilt ° | yaw ° | vel m/s | NEES pos (2) | NEES all (16) | PL exceeded | good rejected | bad accepted | recovered | Δt err ms | search 99 % m |
|---|---:|---:|---:|---:|---:|---:|---:|---:|---:|---:|---:|---:|---:|---:|---:|---:|
| nominal_benign | 0.61 | 1.10 | 1.8 | 0.74 | 1.000 | 0.214 | 0.081 | 0.263 | 1.4 | 780 | 0.018 | 0.000 | 0.081 | 0.00 | 0.14 | 3.21 |
| nominal_moderate | 0.61 | 1.11 | 2.7 | 0.72 | 1.000 | 0.219 | 0.087 | 0.271 | 1.5 | 762 | 0.032 | 0.000 | 0.083 | 0.00 | 0.17 | 3.35 |
| nominal_severe | 0.62 | 1.10 | 2.3 | 0.71 | 1.000 | 0.214 | 0.083 | 0.268 | 1.6 | 812 | 0.031 | 0.000 | 0.080 | 0.00 | 0.14 | 3.32 |
| nominal_violent | 0.40 | 0.72 | 1.3 | 0.67 | 1.000 | 0.144 | 0.068 | 0.237 | 0.7 | 536 | 0.000 | 0.000 | 0.092 | 0.00 | 0.08 | 4.83 |
| proposal_all_errors_violent | 12.53 | 14.36 | 169.1 | 1.34 | 0.906 | 0.526 | 0.743 | 1.406 | 83.8 | 2348 | 0.760 | 0.192 | 0.023 | 0.00 | 1.00 | 76.62 |

## What each addition buys (moderate canopy)

| Scenario | RMS m | 95 % m | worst m | filter 1σ m | ≤10 m | tilt ° | yaw ° | vel m/s | NEES pos (2) | NEES all (16) | PL exceeded | good rejected | bad accepted | recovered | Δt err ms | search 99 % m |
|---|---:|---:|---:|---:|---:|---:|---:|---:|---:|---:|---:|---:|---:|---:|---:|---:|
| nominal_moderate | 0.61 | 1.11 | 2.7 | 0.72 | 1.000 | 0.219 | 0.087 | 0.271 | 1.5 | 762 | 0.032 | 0.000 | 0.083 | 0.00 | 0.17 | 3.35 |
| without_iteration | 0.61 | 1.11 | 2.7 | 0.72 | 1.000 | 0.220 | 0.087 | 0.272 | 1.5 | 762 | 0.032 | 0.000 | 0.083 | 0.00 | 0.18 | 3.35 |
| without_post_fit_rejection | 0.61 | 1.12 | 2.8 | 0.72 | 1.000 | 0.220 | 0.087 | 0.278 | 1.5 | 763 | 0.033 | 0.000 | 0.097 | 0.00 | 0.18 | 3.36 |
| without_recovery | 0.61 | 1.11 | 2.7 | 0.72 | 1.000 | 0.219 | 0.087 | 0.271 | 1.5 | 762 | 0.032 | 0.000 | 0.083 | 0.00 | 0.17 | 3.35 |
| without_time_state | 0.61 | 1.10 | 2.8 | 0.72 | 1.000 | 0.220 | 0.096 | 0.272 | 1.5 | 762 | 0.030 | 0.000 | 0.082 | 0.00 | 1.00 | 3.35 |
| without_scale_noise | 1.04 | 2.13 | 10.6 | 0.45 | 0.994 | 0.377 | 0.246 | 0.407 | 17.2 | 1546 | 0.342 | 0.001 | 0.079 | 0.01 | 0.38 | 3.86 |
| without_map_inflation | 0.66 | 1.24 | 2.8 | 0.32 | 1.000 | 0.265 | 0.076 | 0.262 | 8.7 | 1203 | 0.415 | 0.002 | 0.010 | 0.00 | 0.16 | 3.28 |
| map_inflation_3 | 0.61 | 1.11 | 2.3 | 0.47 | 1.000 | 0.231 | 0.077 | 0.248 | 3.4 | 931 | 0.138 | 0.000 | 0.027 | 0.00 | 0.16 | 3.27 |
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
| violent_fov_half | 0.93 | 1.64 | 3.7 | 1.62 | 1.000 | 0.289 | 0.147 | 0.393 | 0.6 | 423 | 0.000 | 0.000 | 0.068 | 0.00 | 0.09 | 3.07 |
| violent_landmarks_8 | 0.53 | 0.96 | 2.0 | 1.00 | 1.000 | 0.167 | 0.076 | 0.315 | 0.5 | 436 | 0.000 | 0.000 | 0.110 | 0.00 | 0.11 | 4.66 |
| violent_rate_1hz | 0.71 | 1.28 | 2.8 | 1.37 | 1.000 | 0.217 | 0.121 | 0.379 | 0.5 | 341 | 0.000 | 0.000 | 0.099 | 0.00 | 0.44 | 6.28 |
| violent_gap_3s | 0.51 | 0.93 | 3.4 | 0.84 | 1.000 | 0.164 | 0.098 | 0.265 | 0.7 | 446 | 0.000 | 0.000 | 0.092 | 0.00 | 0.09 | 4.96 |
| violent_relief_2m | 0.60 | 1.06 | 1.8 | 1.01 | 1.000 | 0.202 | 0.077 | 0.315 | 0.7 | 482 | 0.000 | 0.000 | 0.152 | 0.00 | 0.08 | 7.69 |

## Cheaper processing: fewer landmarks at a lower image rate

| Scenario | RMS m | 95 % m | worst m | filter 1σ m | ≤10 m | tilt ° | yaw ° | vel m/s | NEES pos (2) | NEES all (16) | PL exceeded | good rejected | bad accepted | recovered | Δt err ms | search 99 % m |
|---|---:|---:|---:|---:|---:|---:|---:|---:|---:|---:|---:|---:|---:|---:|---:|---:|
| nominal_moderate | 0.61 | 1.11 | 2.7 | 0.72 | 1.000 | 0.219 | 0.087 | 0.271 | 1.5 | 762 | 0.032 | 0.000 | 0.083 | 0.00 | 0.17 | 3.35 |
| landmarks_12 | 0.64 | 1.18 | 3.0 | 0.90 | 1.000 | 0.220 | 0.091 | 0.307 | 1.2 | 704 | 0.020 | 0.000 | 0.088 | 0.00 | 0.24 | 3.33 |
| landmarks_8 | 0.68 | 1.24 | 2.9 | 1.02 | 1.000 | 0.226 | 0.094 | 0.329 | 1.0 | 687 | 0.014 | 0.000 | 0.091 | 0.00 | 0.26 | 3.16 |
| landmarks_4 | 0.84 | 1.62 | 3.3 | 1.29 | 1.000 | 0.258 | 0.111 | 0.404 | 1.0 | 666 | 0.014 | 0.001 | 0.107 | 0.00 | 0.38 | 3.13 |
| rate_2p5hz | 0.66 | 1.22 | 3.2 | 0.91 | 1.000 | 0.230 | 0.102 | 0.304 | 1.1 | 712 | 0.019 | 0.000 | 0.082 | 0.00 | 0.34 | 3.68 |
| rate_1hz | 0.78 | 1.47 | 4.2 | 1.27 | 1.000 | 0.248 | 0.137 | 0.365 | 0.8 | 672 | 0.012 | 0.000 | 0.082 | 0.00 | 0.59 | 4.74 |
| landmarks_12_at_2p5hz | 0.73 | 1.35 | 3.2 | 1.14 | 1.000 | 0.238 | 0.108 | 0.343 | 0.9 | 676 | 0.015 | 0.000 | 0.094 | 0.00 | 0.42 | 3.71 |
| landmarks_8_at_2p5hz | 0.79 | 1.49 | 3.3 | 1.29 | 1.000 | 0.250 | 0.116 | 0.367 | 0.9 | 665 | 0.012 | 0.000 | 0.099 | 0.00 | 0.47 | 3.53 |
| landmarks_8_at_1hz | 1.04 | 2.07 | 5.1 | 1.77 | 1.000 | 0.293 | 0.156 | 0.441 | 0.8 | 644 | 0.008 | 0.001 | 0.135 | 0.00 | 0.72 | 4.90 |
| landmarks_4_at_1hz | 1.40 | 2.75 | 8.7 | 2.20 | 1.000 | 0.358 | 0.193 | 0.541 | 0.8 | 630 | 0.005 | 0.001 | 0.207 | 0.00 | 0.93 | 5.78 |
| violent_landmarks_8_at_1hz | 1.03 | 1.91 | 6.1 | 1.96 | 1.000 | 0.269 | 0.138 | 0.480 | 0.5 | 309 | 0.001 | 0.000 | 0.153 | 0.00 | 0.49 | 6.29 |

## End to end: started by the first-fix solver with unknown yaw

| Scenario | RMS m | 95 % m | worst m | filter 1σ m | ≤10 m | tilt ° | yaw ° | vel m/s | NEES pos (2) | NEES all (16) | PL exceeded | good rejected | bad accepted | recovered | Δt err ms | search 99 % m |
|---|---:|---:|---:|---:|---:|---:|---:|---:|---:|---:|---:|---:|---:|---:|---:|---:|
| first_fix_start | 0.60 | 1.09 | 2.6 | 0.72 | 1.000 | 0.217 | 0.088 | 0.276 | 1.5 | 767 | 0.028 | 0.000 | 0.077 | 0.00 | 0.22 | 3.37 |
| first_fix_start_violent | 0.41 | 0.73 | 1.3 | 0.67 | 1.000 | 0.145 | 0.067 | 0.246 | 0.7 | 540 | 0.000 | 0.000 | 0.091 | 0.00 | 0.09 | 4.87 |
| first_fix_start_50pct_wrong | 0.60 | 1.08 | 2.6 | 0.72 | 1.000 | 0.217 | 0.088 | 0.278 | 1.5 | 758 | 0.027 | 0.000 | 0.078 | 0.00 | 0.23 | 3.36 |
| first_fix_start_8_matches | 0.61 | 1.10 | 2.6 | 0.72 | 1.000 | 0.219 | 0.089 | 0.275 | 1.5 | 753 | 0.031 | 0.000 | 0.075 | 0.00 | 0.24 | 3.33 |
| first_fix_start_proposal_filter | 39.84 | 85.15 | 385.7 | 6.43 | 0.894 | 0.492 | 0.589 | 3.211 | 58.5 | 2526 | 0.698 | 0.108 | 0.010 | 0.00 | 1.00 | 207.84 |

| Scenario | fix on first image | fix within 5 s | never | refusals per descent | fix error RMS m | fix error worst m | fix 1σ m | ≤10 m from the fix on | tracking RMS m | tracking worst m |
|---|---:|---:|---:|---:|---:|---:|---:|---:|---:|---:|
| first_fix_start | 0.963 | 1.000 | 0.000 | 0.04 | 1.66 | 4.13 | 1.72 | 1.000 | 0.60 | 2.6 |
| first_fix_start_violent | 0.956 | 1.000 | 0.000 | 0.04 | 1.59 | 3.73 | 1.69 | 1.000 | 0.41 | 1.3 |
| first_fix_start_50pct_wrong | 0.650 | 1.000 | 0.000 | 0.51 | 1.94 | 5.29 | 2.04 | 1.000 | 0.60 | 2.6 |
| first_fix_start_8_matches | 0.581 | 1.000 | 0.000 | 0.65 | 2.15 | 5.78 | 2.14 | 1.000 | 0.61 | 2.6 |
| first_fix_start_proposal_filter | 0.963 | 1.000 | 0.000 | 0.04 | 1.66 | 4.13 | 1.72 | 0.894 | 39.84 | 385.7 |

## Horizontal velocity error as the wind retrieval would see it

Per axis, 300 m to 80 m. "20 m layer" is the RMS over descents and layers of the layer-mean error. "ρ₁" is the lag-1 autocorrelation at 5 Hz and "τ" the 1/e time of the error autocorrelation.

| Scenario | sample RMS m/s | 20 m layer RMS m/s | ρ₁ | τ s |
|---|---:|---:|---:|---:|
| matched_moderate | 0.042 | 0.034 | 0.81 | 1.00 |
| nominal_benign | 0.186 | 0.175 | 0.94 | 1.80 |
| nominal_moderate | 0.192 | 0.179 | 0.93 | 1.60 |
| nominal_severe | 0.190 | 0.178 | 0.94 | 1.60 |
| nominal_violent | 0.168 | 0.156 | 0.91 | 1.60 |
| relief_0p3m | 0.156 | 0.146 | 0.93 | 1.60 |
| gyro_icm42688 | 0.191 | 0.179 | 0.93 | 1.60 |
| rate_1hz | 0.258 | 0.243 | 0.93 | 1.80 |
| landmarks_8_at_1hz | 0.312 | 0.295 | 0.93 | 1.80 |
| first_fix_start | 0.196 | 0.184 | 0.94 | 1.60 |
| proposal_all_errors | 1.368 | 1.365 | 0.93 | 1.60 |
