brentius/cansat-sync/sim/nav/results/wind_mc/tables.md

# Wind Monte Carlo tables

SYNTHETIC. Generated by `sim/nav/analyse_wind_mc.py` from `summary.json`.
Wind errors are RMS per horizontal axis of 20 m layer means, layers from 80 m to 300 m, against the
simulated wind. 160 descents per canopy class.

## Canopy classes as flown here

| Class | Mean glide speed | Air-relative speed per axis | Yaw turned (median) | Navigation velocity error per axis |
| --- | ---: | ---: | ---: | ---: |
| benign | 0.19 m/s | 0.45 m/s | 1.3 turns | 0.18 m/s |
| mild | 0.31 m/s | 0.60 m/s | 1.3 turns | 0.18 m/s |
| moderate | 1.48 m/s | 1.32 m/s | 1.2 turns | 0.18 m/s |
| severe | 4.22 m/s | 3.07 m/s | 1.5 turns | 0.18 m/s |
| violent | 0.44 m/s | 0.91 m/s | 1.3 turns | 0.16 m/s |

## Wind error against truth, 80-300 m (m/s; requirement 0.5)

| Retrieval | benign | mild | moderate | severe | violent |
| --- | ---: | ---: | ---: | ---: | ---: |
| GPS velocity, proposal J.1 | 0.06 | 0.40 | 1.25 | 3.03 | 0.89 |
| TRN velocity, proposal J.1 | 0.22 | 0.43 | 1.26 | 3.04 | 0.83 |
| TRN velocity, error taken as white | 0.23 | 0.45 | 1.27 | 3.05 | 0.88 |
| GPS, glide state but no airspeed | 0.79 | 0.88 | 1.46 | 2.83 | 1.57 |
| GPS + airspeed, offset found from spin only | 0.22 | 0.24 | 0.32 | 0.47 | 0.40 |
| GPS + airspeed, offset from a hang test | 0.18 | 0.20 | 0.26 | 0.38 | 0.33 |
| TRN + airspeed, offset from a hang test | 0.27 | 0.28 | 0.32 | 0.41 | 0.39 |
| GPS + airspeed, no canopy model | 0.22 | 0.22 | 0.26 | 0.37 | 0.31 |
| GPS, direct inversion u + tau du/dt | 0.08 | 0.41 | 1.26 | 3.03 | 0.94 |

## Share of layer errors inside the stated 95 % interval, 80-300 m

| Retrieval | benign | mild | moderate | severe | violent |
| --- | ---: | ---: | ---: | ---: | ---: |
| GPS velocity, proposal J.1 | 92 % | 26 % | 11 % | 2 % | 11 % |
| TRN velocity, proposal J.1 | 96 % | 60 % | 26 % | 6 % | 42 % |
| TRN velocity, error taken as white | 71 % | 36 % | 17 % | 4 % | 21 % |
| GPS, glide state but no airspeed | 100 % | 100 % | 99 % | 84 % | 98 % |
| GPS + airspeed, offset found from spin only | 100 % | 99 % | 96 % | 82 % | 89 % |
| GPS + airspeed, offset from a hang test | 100 % | 100 % | 97 % | 87 % | 90 % |
| TRN + airspeed, offset from a hang test | 99 % | 98 % | 97 % | 89 % | 90 % |
| GPS + airspeed, no canopy model | 99 % | 99 % | 98 % | 89 % | 95 % |

## S1: image-derived minus GPS-derived wind, 80-300 m (m/s)

| Canopy | TRN minus GPS (J.1) | True error of the TRN wind | True error of the GPS wind | Trend of the difference per 100 m of height |
| --- | ---: | ---: | ---: | ---: |
| benign | 0.23 | 0.22 | 0.06 | +0.096 |
| mild | 0.22 | 0.43 | 0.40 | +0.093 |
| moderate | 0.28 | 1.26 | 1.25 | +0.157 |
| severe | 0.27 | 3.04 | 3.03 | +0.155 |
| violent | 0.33 | 0.83 | 0.89 | +0.177 |

## Airspeed from lateral specific force (m/s per axis, per 2 s window)

| Canopy | True air-relative speed | Error, offset from a hang test | Error, offset not removed |
| --- | ---: | ---: | ---: |
| benign | 0.45 | 0.19 | 2.65 |
| mild | 0.60 | 0.22 | 2.51 |
| moderate | 1.32 | 0.29 | 2.64 |
| severe | 3.07 | 0.35 | 2.54 |
| violent | 0.91 | 0.38 | 2.45 |

## Landing prediction, benign canopy

| Predictor | Quantity | 250 m | 200 m | 150 m | 100 m | 80 m | 50 m | 20 m |
| --- | --- | ---: | ---: | ---: | ---: | ---: | ---: | ---: |
| GPS | radial RMS (m) | 17.6 | 14.6 | 10.2 | 6.9 | 5.6 | 3.5 | 2.3 |
| | stated 1-sigma (m) | 18.6 | 14.6 | 10.7 | 7.0 | 5.6 | 3.7 | 2.4 |
| | inside 95 % ellipse | 98 % | 96 % | 97 % | 95 % | 97 % | 93 % | 95 % |
| TRN | radial RMS (m) | 17.9 | 14.5 | 10.0 | 6.3 | 5.4 | 4.2 | 3.0 |
| | stated 1-sigma (m) | 19.0 | 14.6 | 10.5 | 6.8 | 5.4 | 4.4 | 3.6 |
| | inside 95 % ellipse | 96 % | 96 % | 98 % | 98 % | 97 % | 96 % | 97 % |
| dead reckoning | radial RMS (m) | 34.5 | 35.6 | 48.7 | 64.9 | 72.7 | 84.7 | 96.0 |
| | stated 1-sigma (m) | 29.2 | 36.4 | 50.9 | 68.6 | 76.0 | 86.9 | 97.9 |
| | inside 95 % ellipse | 92 % | 97 % | 96 % | 96 % | 94 % | 95 % | 95 % |
| GPS, glide state | radial RMS (m) | 18.4 | 16.3 | 11.3 | 8.5 | 6.8 | 4.3 | 2.4 |
| | stated 1-sigma (m) | 52.1 | 39.9 | 27.8 | 16.4 | 12.1 | 6.4 | 2.6 |
| | inside 95 % ellipse | 100 % | 100 % | 100 % | 100 % | 100 % | 99 % | 96 % |
| TRN, glide state | radial RMS (m) | 18.1 | 16.2 | 11.0 | 7.8 | 6.8 | 5.4 | 3.4 |
| | stated 1-sigma (m) | 52.7 | 39.9 | 27.7 | 16.3 | 12.4 | 10.3 | 5.6 |
| | inside 95 % ellipse | 100 % | 100 % | 100 % | 100 % | 100 % | 100 % | 100 % |
| all | touchdown time RMS (s) | 1.04 | 0.76 | 0.61 | 0.40 | 0.34 | 0.20 | 0.08 |

## Landing prediction, mild canopy

| Predictor | Quantity | 250 m | 200 m | 150 m | 100 m | 80 m | 50 m | 20 m |
| --- | --- | ---: | ---: | ---: | ---: | ---: | ---: | ---: |
| GPS | radial RMS (m) | 19.1 | 14.5 | 10.9 | 7.2 | 5.7 | 3.5 | 2.1 |
| | stated 1-sigma (m) | 18.6 | 14.6 | 10.7 | 7.0 | 5.6 | 3.7 | 2.4 |
| | inside 95 % ellipse | 96 % | 96 % | 94 % | 94 % | 93 % | 96 % | 98 % |
| TRN | radial RMS (m) | 18.9 | 14.3 | 10.5 | 6.7 | 5.4 | 4.2 | 3.1 |
| | stated 1-sigma (m) | 19.0 | 14.6 | 10.6 | 6.8 | 5.4 | 4.3 | 3.3 |
| | inside 95 % ellipse | 98 % | 96 % | 95 % | 92 % | 94 % | 96 % | 96 % |
| dead reckoning | radial RMS (m) | 34.8 | 36.6 | 49.7 | 68.2 | 76.8 | 89.5 | 102.0 |
| | stated 1-sigma (m) | 29.2 | 36.6 | 51.4 | 69.9 | 77.7 | 89.2 | 100.9 |
| | inside 95 % ellipse | 89 % | 95 % | 95 % | 94 % | 93 % | 94 % | 95 % |
| GPS, glide state | radial RMS (m) | 21.0 | 15.8 | 12.4 | 9.1 | 7.5 | 4.3 | 2.2 |
| | stated 1-sigma (m) | 52.2 | 40.0 | 27.9 | 16.5 | 12.1 | 6.4 | 2.6 |
| | inside 95 % ellipse | 100 % | 100 % | 100 % | 100 % | 100 % | 99 % | 98 % |
| TRN, glide state | radial RMS (m) | 20.2 | 15.6 | 11.7 | 8.7 | 7.1 | 5.5 | 3.5 |
| | stated 1-sigma (m) | 52.7 | 40.0 | 27.8 | 16.3 | 12.3 | 10.3 | 5.4 |
| | inside 95 % ellipse | 100 % | 100 % | 100 % | 100 % | 100 % | 100 % | 99 % |
| all | touchdown time RMS (s) | 1.00 | 0.75 | 0.62 | 0.41 | 0.30 | 0.19 | 0.08 |

## Landing prediction, moderate canopy

| Predictor | Quantity | 250 m | 200 m | 150 m | 100 m | 80 m | 50 m | 20 m |
| --- | --- | ---: | ---: | ---: | ---: | ---: | ---: | ---: |
| GPS | radial RMS (m) | 30.1 | 22.4 | 15.8 | 9.7 | 7.6 | 4.7 | 2.5 |
| | stated 1-sigma (m) | 18.3 | 14.5 | 10.8 | 7.1 | 5.7 | 3.8 | 2.5 |
| | inside 95 % ellipse | 62 % | 68 % | 73 % | 80 % | 84 % | 88 % | 94 % |
| TRN | radial RMS (m) | 30.6 | 22.5 | 15.6 | 9.6 | 7.8 | 6.3 | 3.8 |
| | stated 1-sigma (m) | 18.7 | 14.6 | 10.6 | 6.8 | 5.5 | 4.4 | 3.4 |
| | inside 95 % ellipse | 66 % | 68 % | 78 % | 79 % | 80 % | 78 % | 88 % |
| dead reckoning | radial RMS (m) | 48.6 | 46.8 | 56.0 | 74.2 | 82.5 | 97.1 | 113.1 |
| | stated 1-sigma (m) | 28.6 | 36.0 | 50.7 | 69.4 | 77.6 | 90.2 | 103.0 |
| | inside 95 % ellipse | 59 % | 84 % | 94 % | 92 % | 93 % | 94 % | 92 % |
| GPS, glide state | radial RMS (m) | 29.1 | 21.1 | 14.6 | 9.2 | 7.7 | 5.0 | 2.6 |
| | stated 1-sigma (m) | 51.3 | 39.8 | 28.0 | 16.6 | 12.3 | 6.5 | 2.7 |
| | inside 95 % ellipse | 100 % | 100 % | 100 % | 100 % | 100 % | 98 % | 96 % |
| TRN, glide state | radial RMS (m) | 28.3 | 21.1 | 13.9 | 9.2 | 7.8 | 6.1 | 4.0 |
| | stated 1-sigma (m) | 51.8 | 39.8 | 27.9 | 16.4 | 12.5 | 10.4 | 5.5 |
| | inside 95 % ellipse | 100 % | 100 % | 100 % | 100 % | 100 % | 100 % | 99 % |
| all | touchdown time RMS (s) | 1.18 | 0.80 | 0.63 | 0.37 | 0.32 | 0.22 | 0.09 |

## Landing prediction, severe canopy

| Predictor | Quantity | 250 m | 200 m | 150 m | 100 m | 80 m | 50 m | 20 m |
| --- | --- | ---: | ---: | ---: | ---: | ---: | ---: | ---: |
| GPS | radial RMS (m) | 64.4 | 46.3 | 33.2 | 20.2 | 15.4 | 8.8 | 3.1 |
| | stated 1-sigma (m) | 18.5 | 15.2 | 11.2 | 7.4 | 5.9 | 3.9 | 2.5 |
| | inside 95 % ellipse | 2 % | 6 % | 7 % | 9 % | 22 % | 31 % | 90 % |
| TRN | radial RMS (m) | 66.2 | 46.9 | 33.1 | 20.2 | 15.9 | 13.1 | 6.4 |
| | stated 1-sigma (m) | 18.9 | 15.2 | 11.0 | 7.1 | 5.7 | 4.5 | 3.5 |
| | inside 95 % ellipse | 2 % | 5 % | 7 % | 8 % | 14 % | 8 % | 52 % |
| dead reckoning | radial RMS (m) | 105.8 | 86.9 | 79.0 | 85.6 | 91.8 | 101.5 | 118.0 |
| | stated 1-sigma (m) | 29.0 | 37.4 | 53.0 | 73.3 | 82.2 | 96.1 | 110.3 |
| | inside 95 % ellipse | 2 % | 25 % | 70 % | 88 % | 91 % | 94 % | 92 % |
| GPS, glide state | radial RMS (m) | 52.5 | 34.1 | 22.4 | 12.2 | 8.8 | 5.1 | 2.5 |
| | stated 1-sigma (m) | 51.8 | 41.6 | 29.1 | 17.2 | 12.7 | 6.7 | 2.8 |
| | inside 95 % ellipse | 99 % | 100 % | 100 % | 99 % | 100 % | 100 % | 96 % |
| TRN, glide state | radial RMS (m) | 52.7 | 34.1 | 21.9 | 12.0 | 9.1 | 7.8 | 4.6 |
| | stated 1-sigma (m) | 52.2 | 41.6 | 28.9 | 17.0 | 13.0 | 10.8 | 5.7 |
| | inside 95 % ellipse | 99 % | 100 % | 100 % | 99 % | 100 % | 100 % | 99 % |
| all | touchdown time RMS (s) | 1.47 | 0.85 | 0.65 | 0.46 | 0.38 | 0.22 | 0.09 |

## Landing prediction, violent canopy

| Predictor | Quantity | 250 m | 200 m | 150 m | 100 m | 80 m | 50 m | 20 m |
| --- | --- | ---: | ---: | ---: | ---: | ---: | ---: | ---: |
| GPS | radial RMS (m) | 25.0 | 19.6 | 14.0 | 9.4 | 8.0 | 5.4 | 2.6 |
| | stated 1-sigma (m) | 18.2 | 14.1 | 10.4 | 6.8 | 5.4 | 3.6 | 2.4 |
| | inside 95 % ellipse | 83 % | 79 % | 81 % | 78 % | 74 % | 72 % | 91 % |
| TRN | radial RMS (m) | 23.9 | 19.5 | 14.0 | 9.4 | 8.1 | 5.6 | 3.1 |
| | stated 1-sigma (m) | 18.6 | 14.1 | 10.2 | 6.5 | 5.2 | 4.3 | 3.6 |
| | inside 95 % ellipse | 81 % | 79 % | 84 % | 76 % | 67 % | 83 % | 97 % |
| dead reckoning | radial RMS (m) | 33.6 | 34.6 | 46.9 | 62.5 | 69.5 | 80.2 | 92.1 |
| | stated 1-sigma (m) | 28.4 | 34.7 | 47.5 | 62.9 | 69.6 | 79.8 | 90.4 |
| | inside 95 % ellipse | 87 % | 95 % | 96 % | 96 % | 96 % | 98 % | 96 % |
| GPS, glide state | radial RMS (m) | 33.6 | 28.0 | 21.1 | 14.5 | 12.1 | 7.6 | 3.0 |
| | stated 1-sigma (m) | 50.9 | 38.5 | 27.0 | 15.8 | 11.7 | 6.2 | 2.6 |
| | inside 95 % ellipse | 100 % | 100 % | 100 % | 98 % | 95 % | 86 % | 89 % |
| TRN, glide state | radial RMS (m) | 31.3 | 28.3 | 21.9 | 15.3 | 12.9 | 8.8 | 4.1 |
| | stated 1-sigma (m) | 51.4 | 38.6 | 26.9 | 15.6 | 11.9 | 9.9 | 5.4 |
| | inside 95 % ellipse | 100 % | 100 % | 99 % | 95 % | 93 % | 98 % | 98 % |
| all | touchdown time RMS (s) | 1.05 | 0.78 | 0.58 | 0.38 | 0.30 | 0.21 | 0.09 |
