brentius/cansat-sync/sim/maths/results/attachment_audit/baseline/synthetic_profile.csv

source | height_m | true_wind_mps | smoothed_wind_mps | true_probe_velocity_mps | posterior_sd_mps
GPS | 300.0 | 4.619842036109457 | 4.334686964397749 | 4.3187450785694885 | 0.2033124171932516
GPS | 297.9 | 4.910268252526136 | 4.3299416734691185 | 4.3961824491116195 | 0.18648780800883313
GPS | 295.79999999999995 | 4.896433433946228 | 4.355971079703474 | 4.491431702232698 | 0.17212129962772751
GPS | 293.69999999999993 | 4.567441367949695 | 4.352079274516676 | 4.527963207709017 | 0.16474627345893744
GPS | 291.5999999999999 | 4.542101919816354 | 4.292519324888235 | 4.5396604337590105 | 0.16245112385888372
GPS | 289.4999999999999 | 4.3069997428768385 | 4.2323252057096195 | 4.513530546339749 | 0.16229676388663064
GPS | 287.39999999999986 | 4.072797263063655 | 4.248228560872085 | 4.4574763505259245 | 0.1626798412061367
GPS | 285.29999999999984 | 4.246381847414792 | 4.319896604198761 | 4.4139751672987675 | 0.1631042156747407
GPS | 283.1999999999998 | 4.2059560907949916 | 4.3462952138949085 | 4.394346122551684 | 0.16351065002522394
GPS | 281.0999999999998 | 4.181625615695235 | 4.296528135091781 | 4.373190249967698 | 0.1639228008866488
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
