brentius/cansat-sync/sim/maths/results/attachment_audit/image_matches.csv

scenario | trial | landmark | accepted | reason | score | gap | shift_x_m | shift_y_m
flat | 0 | 0 | True | accepted | 0.9969395141725211 | 0.36488131388053724 | -0.9317220236802655 | 0.9674719289656455
flat | 0 | 1 | True | accepted | 0.9976671436364566 | 0.2980057338889308 | -1.0066039216581304 | 1.0701404225446698
flat | 0 | 2 | True | accepted | 0.9911675766558511 | 0.27228163502731717 | -1.0594711747891346 | 1.2602956003847936
flat | 0 | 3 | True | accepted | 0.9898298592207226 | 0.2939805075128058 | -0.7385305861933098 | 0.98439447279973
flat | 0 | 4 | True | accepted | 0.9867770687520921 | 0.30359991829027555 | -0.7404490840071318 | 1.09179584927222
flat | 0 | 5 | True | accepted | 0.9815041552529966 | 0.28064243414669543 | -0.7520128734568194 | 1.2596788701696457
flat | 0 | 6 | True | accepted | 0.9973661309431242 | 0.34927326774335365 | -0.574978581585202 | 1.01702274708353
flat | 0 | 7 | True | accepted | 0.9966673221664849 | 0.3389346049458877 | -0.5345093557879954 | 1.1027594359176014
flat | 0 | 8 | False | out_of_view
photometric | 0 | 0 | True | accepted | 0.9951278734443987 | 0.36443721752999736 | -0.9340681143599658 | 0.9669815703663325
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
