brentius/cansat-sync/sim/maths/results/attachment_audit/image_trials.csv

scenario | trial | height_m | matches | fixed | initial_horizontal_error_m | error_x_m | error_y_m | radial_error_m | attitude_error_deg | local95_contains | mahalanobis2 | local_axis_sd_m | host_elapsed_s
flat | 0 | 80.0 | 8 | True | 0.7627668003430395 | -0.022433558490723815 | -0.05210447408151264 | 0.05672865912277276 | 0.037053751493183795 | True | 0.0051747648977991025 | 0.6793856666363765 | 0.07017780000023777
photometric | 0 | 80.0 | 8 | True | 0.7627668003430395 | -0.026119426707822413 | -0.057762241306262396 | 0.06339322497135 | 0.04186600930606208 | True | 0.0065250296542949384 | 0.6793539686480109 | 0.07070250000106171
relief_2m | 0 | 80.0 | 8 | True | 0.7627668003430395 | 3.5354512584611753 | 1.131326464062739 | 3.7120499955204544 | 2.6868847889718555 | False | 45.288117164726444 | 0.6593909896813381 | 0.17068170000129612
relief_5m | 0 | 80.0 | 8 | True | 0.7627668003430395 | 8.688145758875697 | 2.563740494213933 | 9.058512132195997 | 6.608903428891063 | False | 298.6191422071443 | 0.6210578506140777 | 0.16186609999567736
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
