brentius/cansat-sync/sim/maths/results/attachment_audit/linear_navigation.csv

time_s | height_m | full_nees_mean | full_nees_standard_error | horizontal_rmse_m | horizontal95_coverage
0.0 | 300.0 | 15.09329039039073 | 0.17320508075688773 | 0.5906927851554551 | 0.953
10.0 | 195.0 | 15.066186506209007 | 0.17320508075688773 | 0.17062398488952327 | 0.941
20.0 | 90.0 | 14.7076290105139 | 0.17320508075688773 | 0.08387477729504607 | 0.954
28.0 | 6.0 | 14.879213301702983 | 0.17320508075688773 | 0.7788170183223715 | 0.951
28.560000000000002 | 0.12000000000000455 | 14.762992138168817 | 0.17320508075688773 | 0.8320819261392436 | 0.953
