brentius/cansat-sync/sim/maths/results/attachment_audit/landing_coverage.png

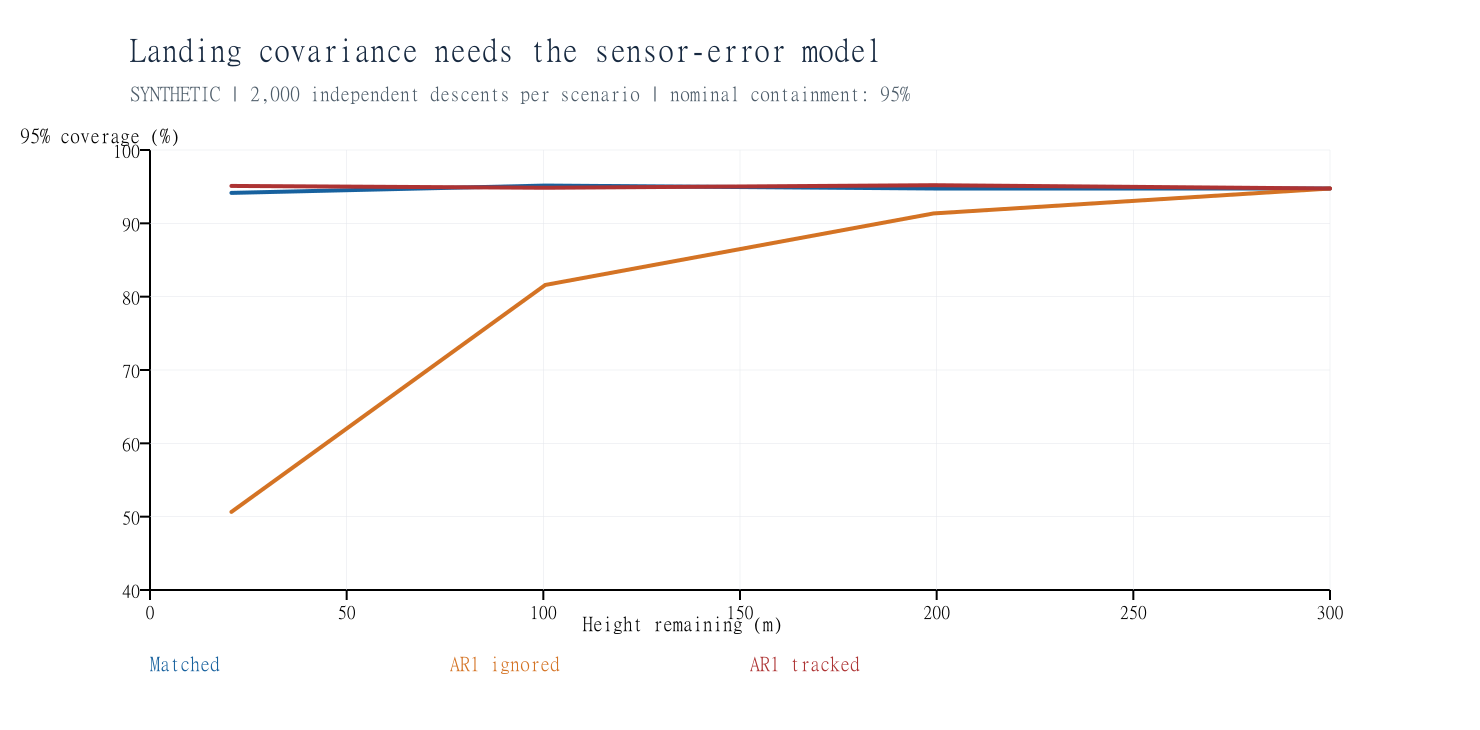
sim/maths/results/attachment_audit/landing_coverage.png
