brentius/cansat-sync/sim/maths/results/attachment_audit/rendered_scenes.png

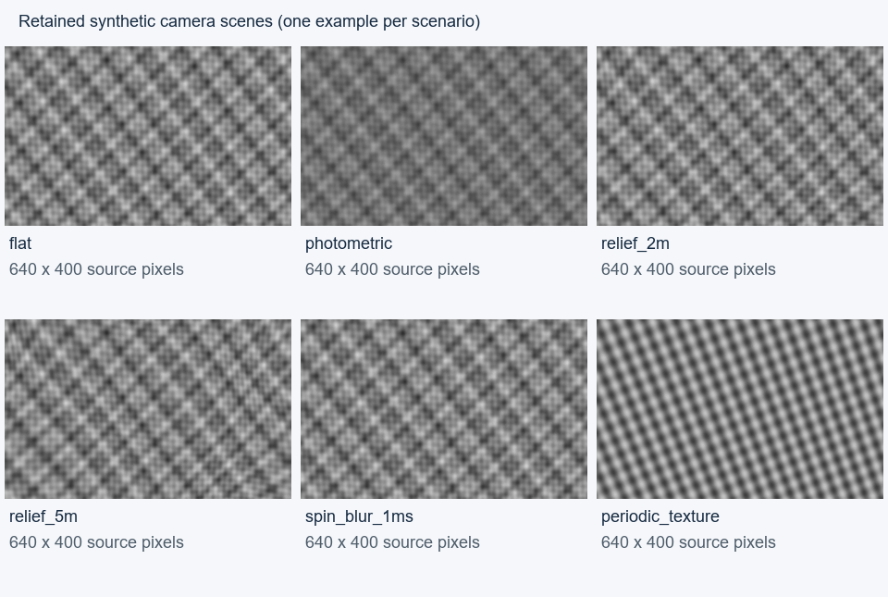
sim/maths/results/attachment_audit/rendered_scenes.png
