brentius/cansat-sync/sim/maths/results/attachment_audit/shared_swing.png

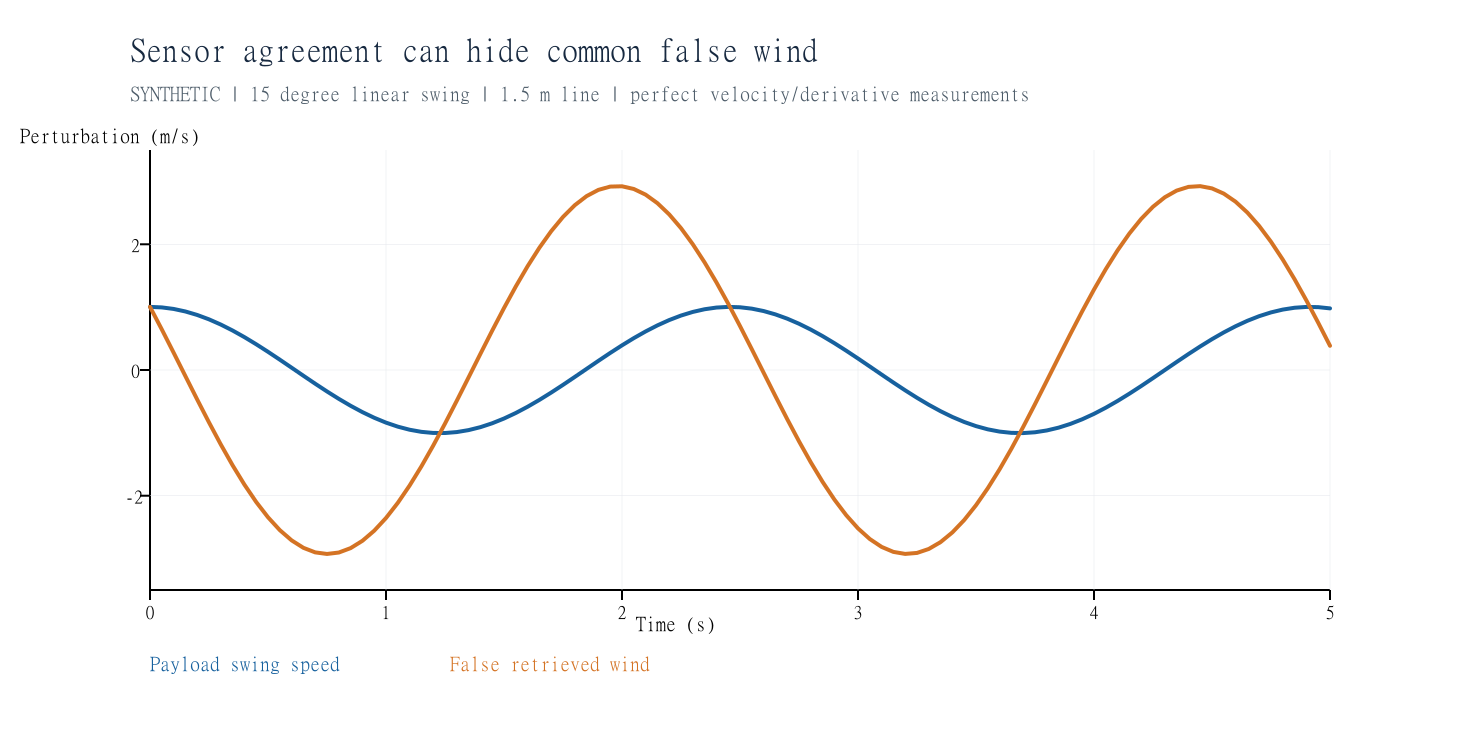
sim/maths/results/attachment_audit/shared_swing.png
