brentius/cansat-sync/sim/maths/results/attachment_audit/terrain_error.png

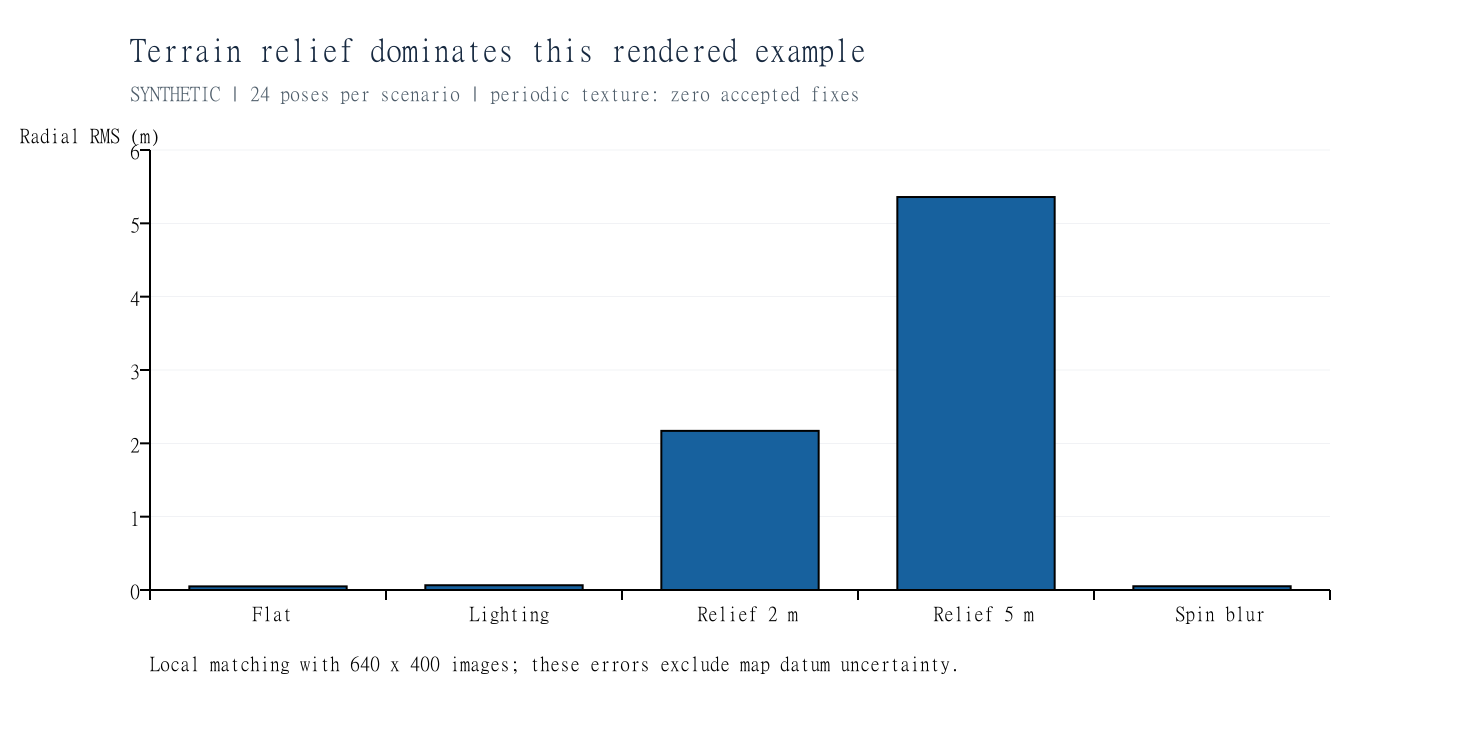
sim/maths/results/attachment_audit/terrain_error.png
