brentius/cansat-sync/sim/nav/results/acquisition/by_season.png

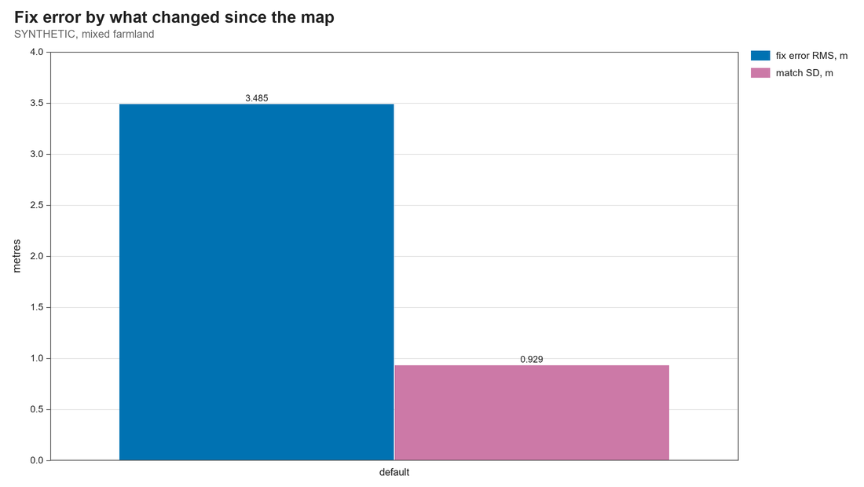
sim/nav/results/acquisition/by_season.png
