brentius/cansat-sync/sim/nav/results/acquisition/by_terrain.png

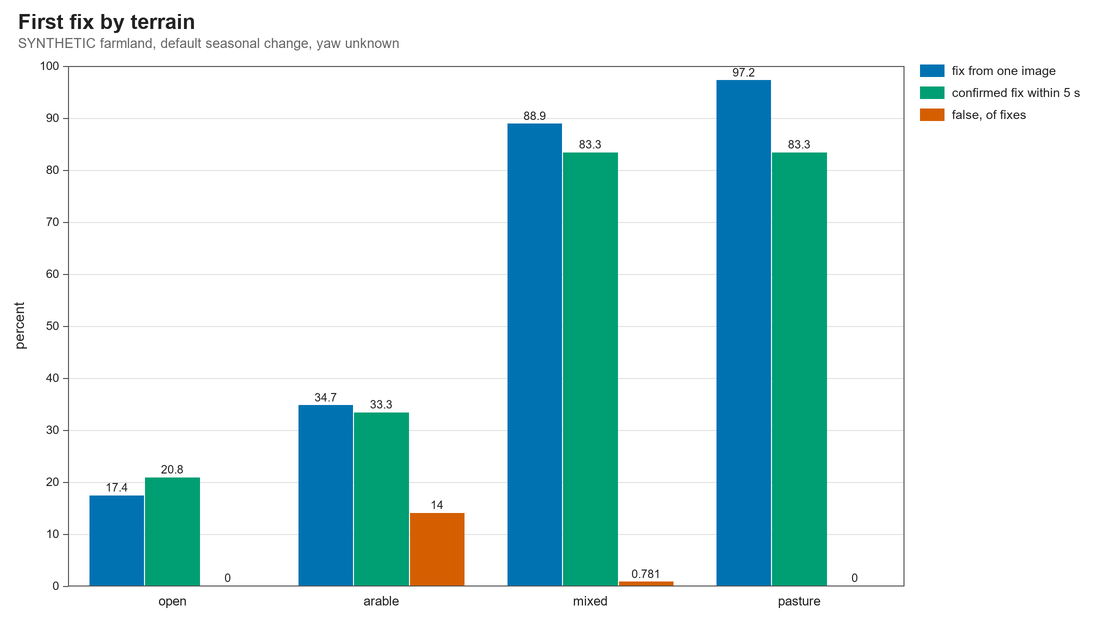
sim/nav/results/acquisition/by_terrain.png
