brentius/cansat-sync/sim/nav/results/acquisition/confirmed_by_time.png

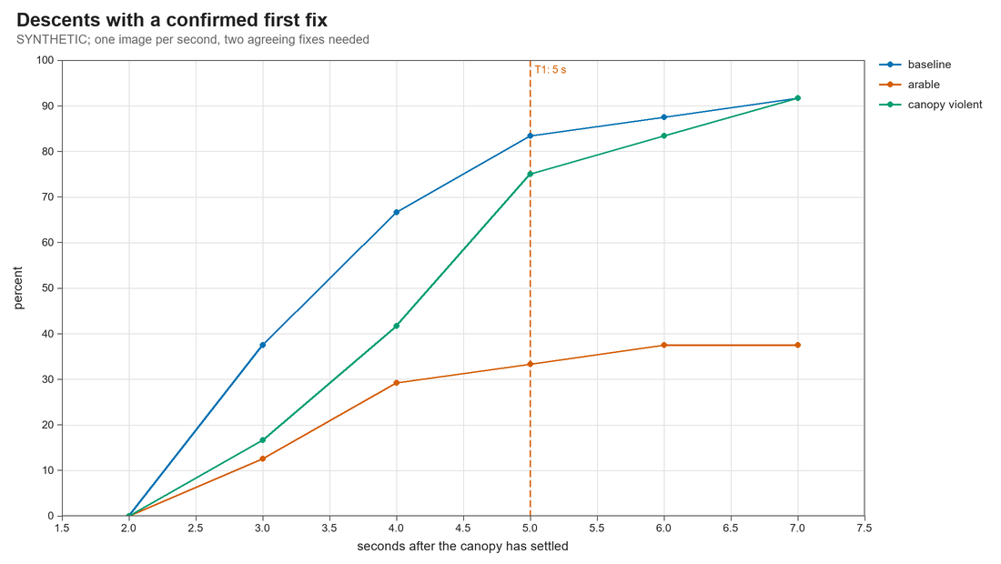
sim/nav/results/acquisition/confirmed_by_time.png
