brentius/cansat-sync/sim/nav/results/acquisition_ab/by_terrain.png

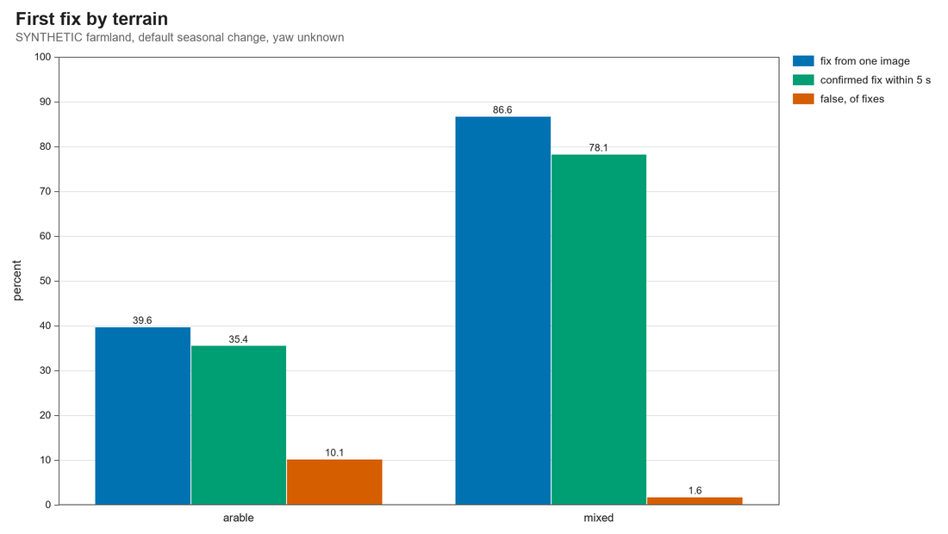
sim/nav/results/acquisition_ab/by_terrain.png
