brentius/cansat-sync/sim/nav/results/acquisition_ab/confirmed_by_time.png

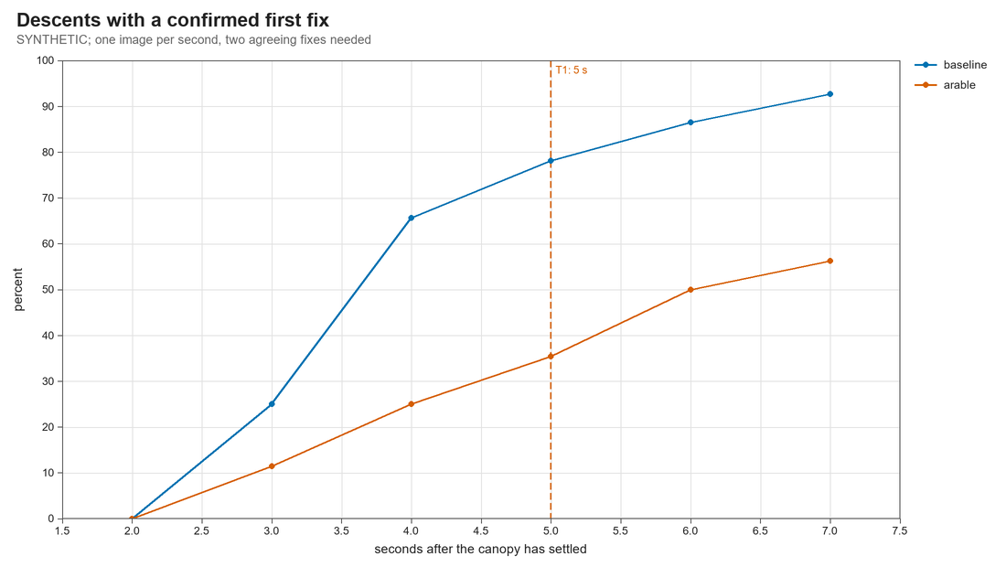
sim/nav/results/acquisition_ab/confirmed_by_time.png
