brentius/cansat-sync/sim/nav/results/farmland/arable_flight.png

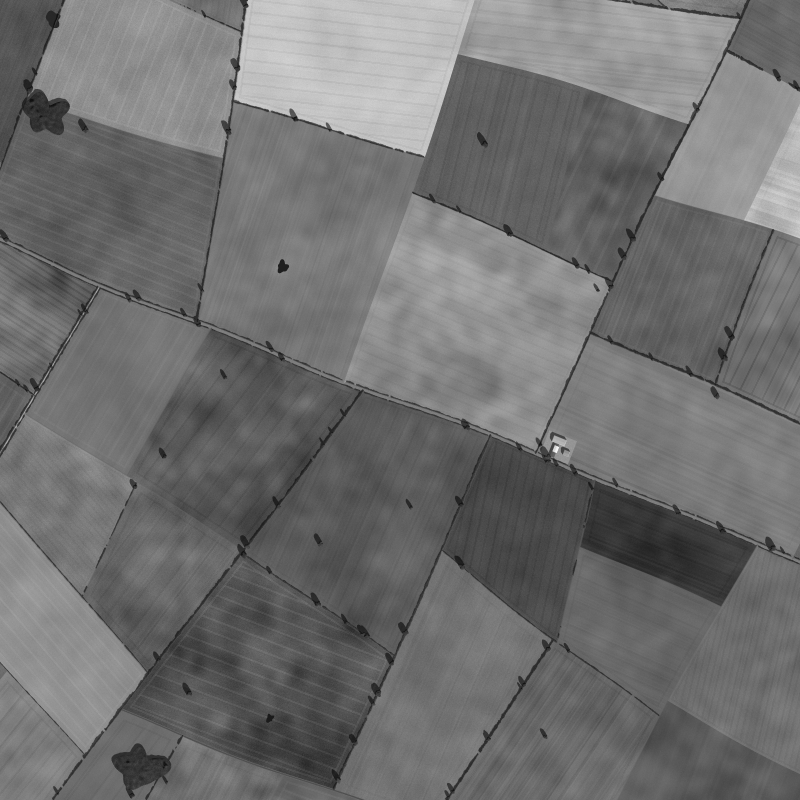
sim/nav/results/farmland/arable_flight.png
