brentius/cansat-sync/sim/nav/results/farmland/arable_kind.png

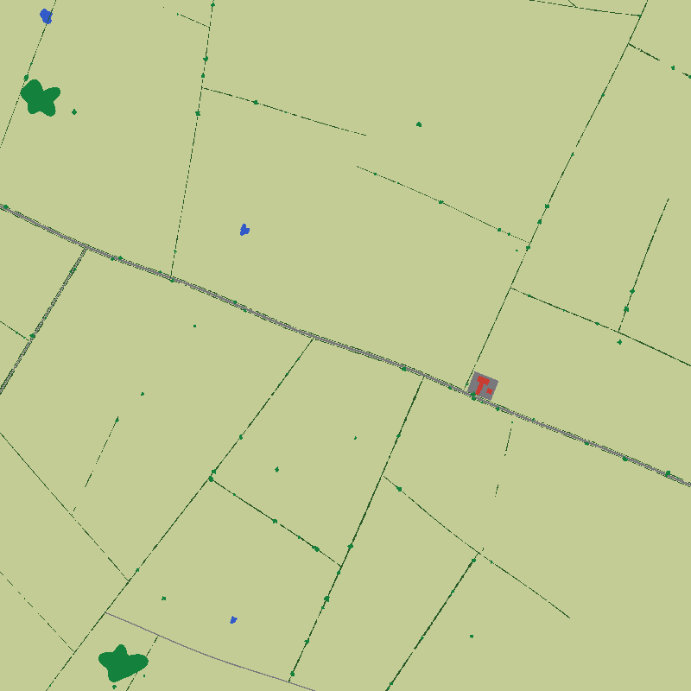
sim/nav/results/farmland/arable_kind.png
