brentius/cansat-sync/sim/nav/results/farmland/arable_map.png

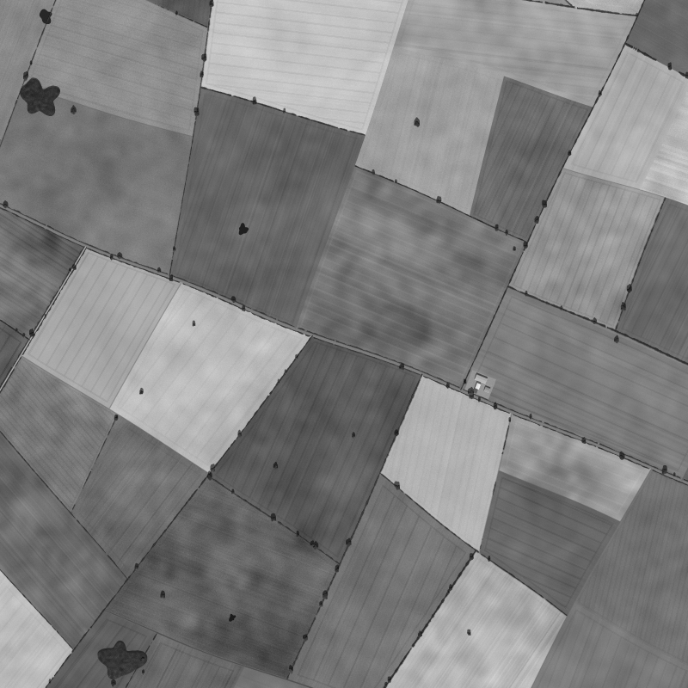
sim/nav/results/farmland/arable_map.png
