brentius/cansat-sync/sim/nav/results/farmland/mixed_flight.png

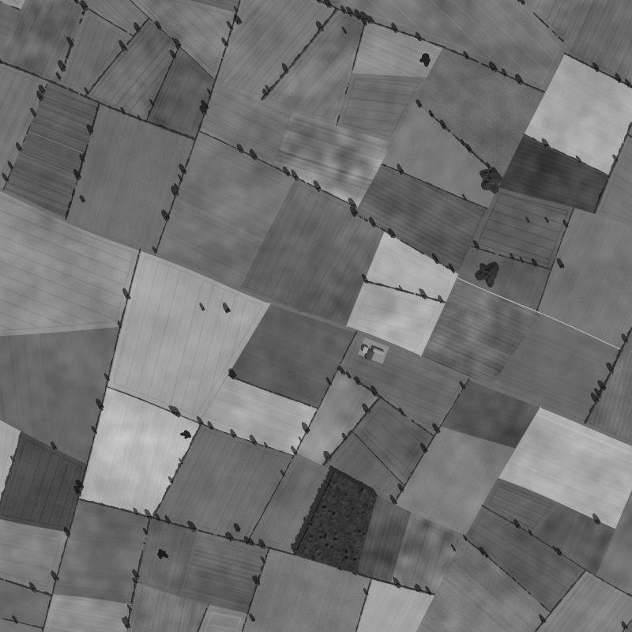
sim/nav/results/farmland/mixed_flight.png
