brentius/cansat-sync/sim/nav/results/farmland/mixed_kind.png

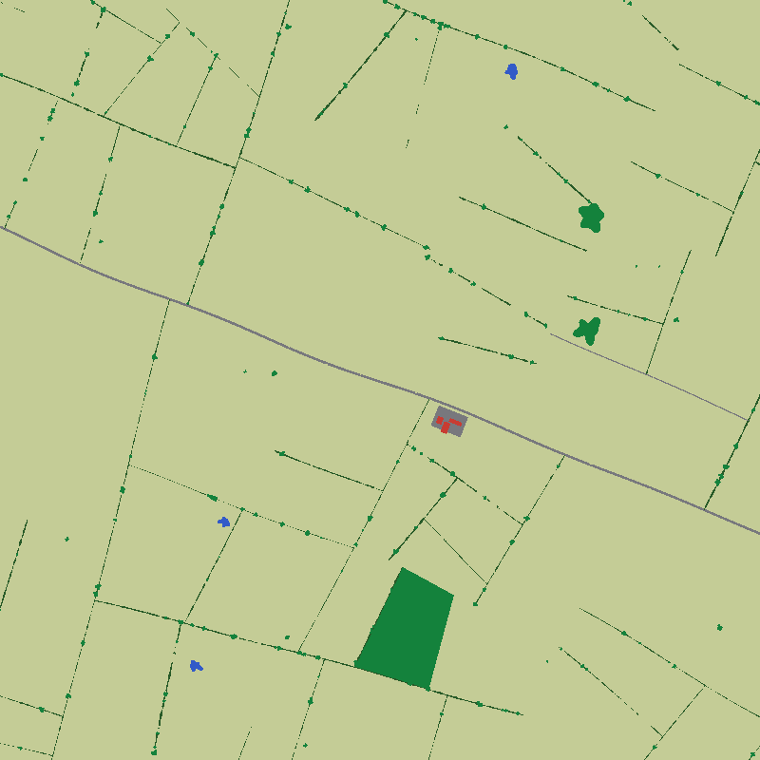
sim/nav/results/farmland/mixed_kind.png
