brentius/cansat-sync/sim/nav/results/farmland/open_flight.png

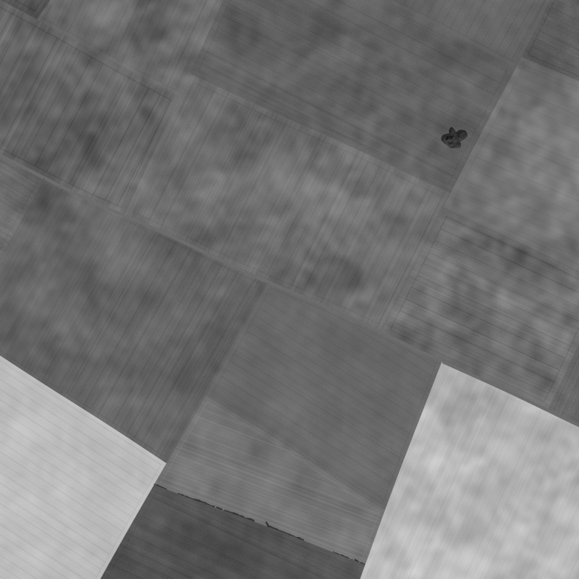
sim/nav/results/farmland/open_flight.png
