brentius/cansat-sync/sim/nav/results/farmland/open_kind.png

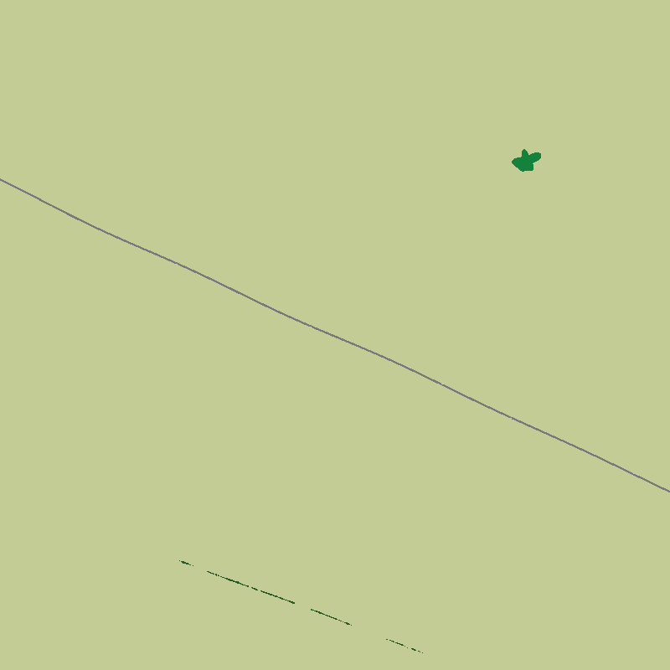
sim/nav/results/farmland/open_kind.png
