brentius/cansat-sync/sim/nav/results/farmland/open_map.png

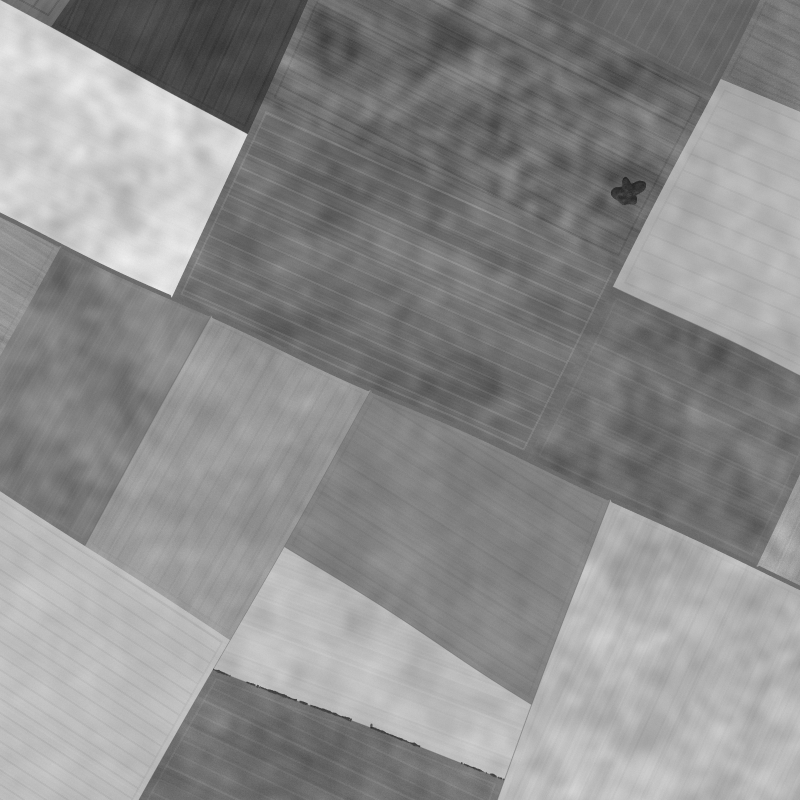
sim/nav/results/farmland/open_map.png
