brentius/cansat-sync/sim/nav/results/farmland/pasture_crop400m_map_flight.png

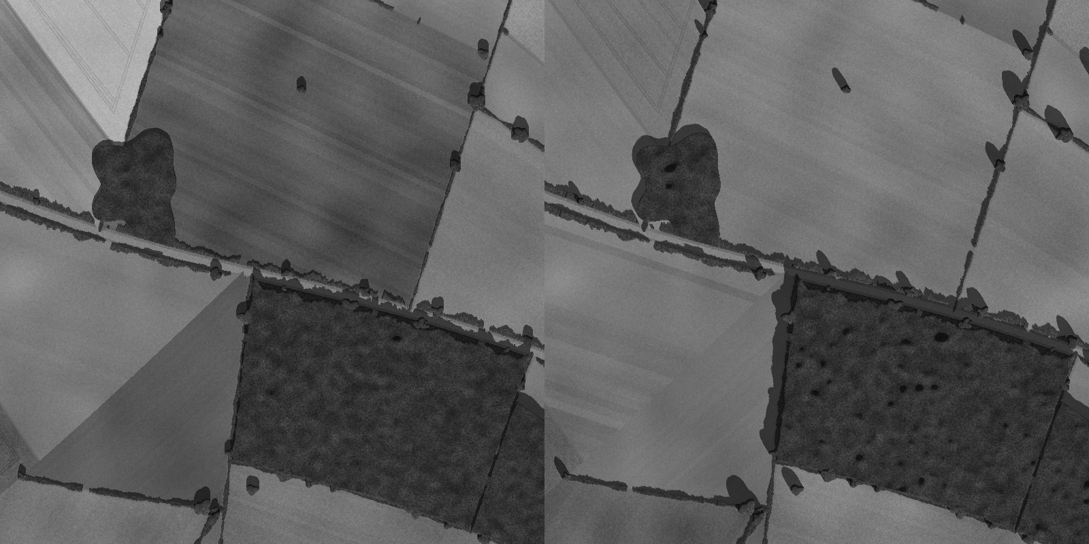
sim/nav/results/farmland/pasture_crop400m_map_flight.png
