brentius/cansat-sync/sim/nav/results/farmland/pasture_flight.png

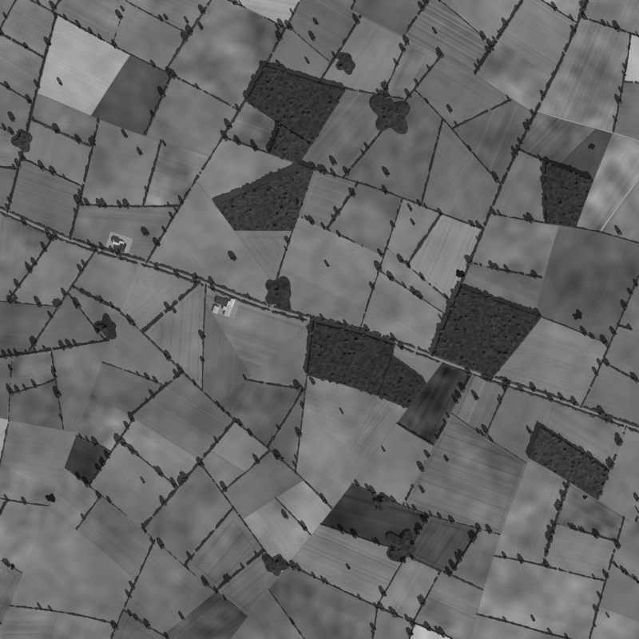
sim/nav/results/farmland/pasture_flight.png
