brentius/cansat-sync/sim/nav/results/farmland/pasture_kind.png

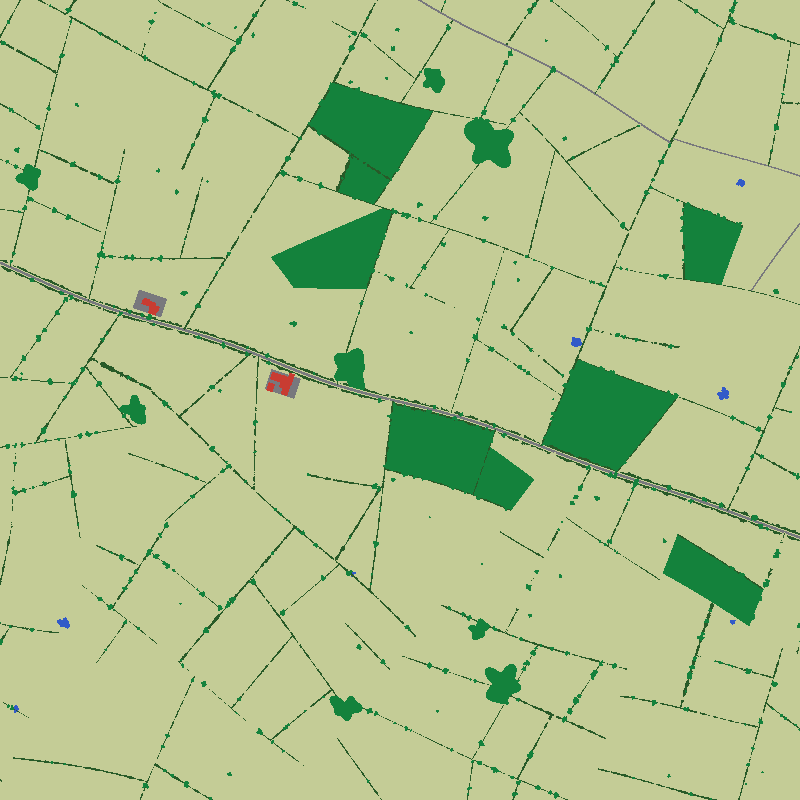
sim/nav/results/farmland/pasture_kind.png
