brentius/cansat-sync/sim/nav/results/farmland/pasture_map.png

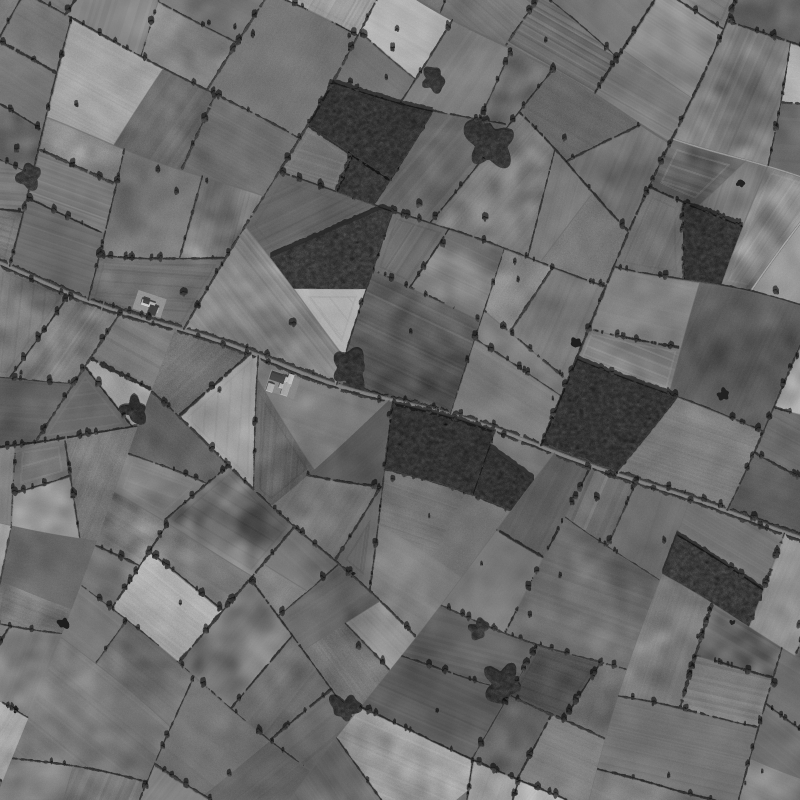
sim/nav/results/farmland/pasture_map.png
