brentius/cansat-sync/sim/nav/results/farmland/tramline_flight.png

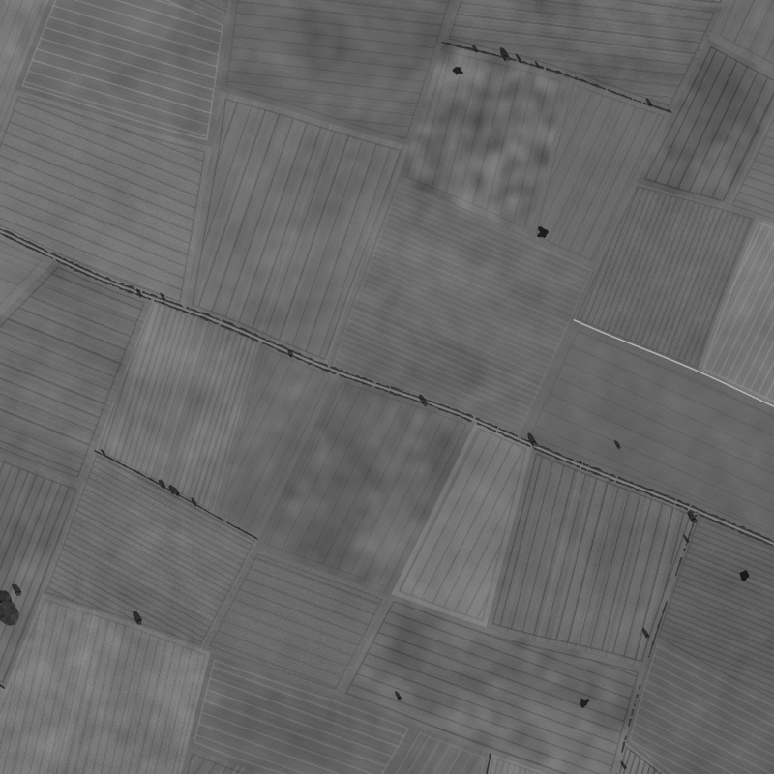
sim/nav/results/farmland/tramline_flight.png
