brentius/cansat-sync/sim/nav/results/farmland/tramline_kind.png

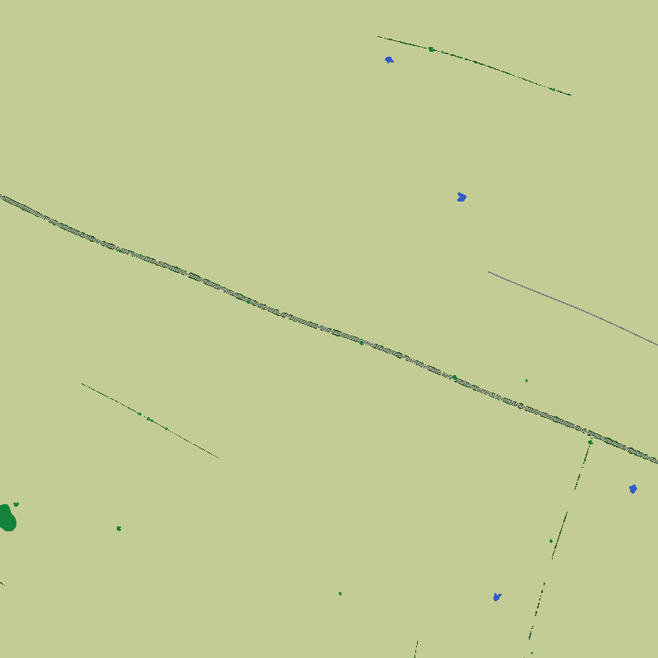
sim/nav/results/farmland/tramline_kind.png
