brentius/cansat-sync/sim/nav/results/farmland/tramline_map.png

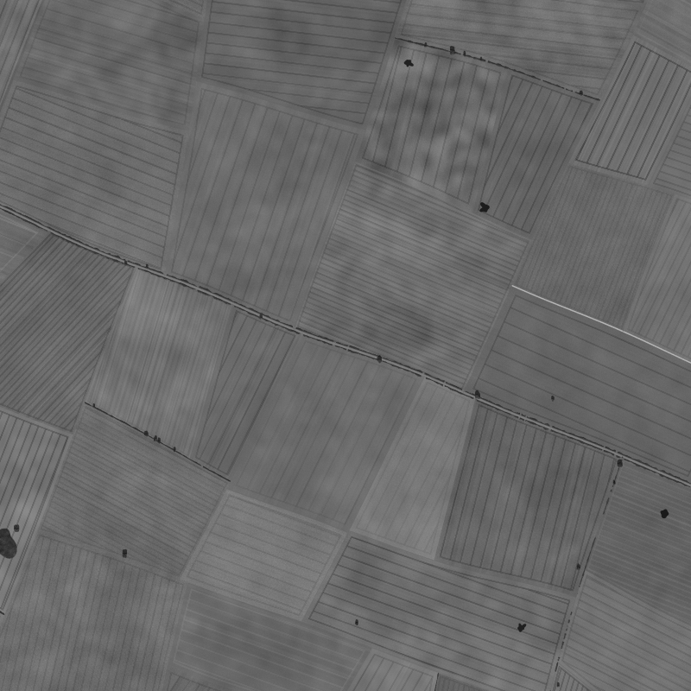
sim/nav/results/farmland/tramline_map.png
