brentius/cansat-sync/sim/nav/results/fine_tracking_20261023/figures/seasonal_tracking.png

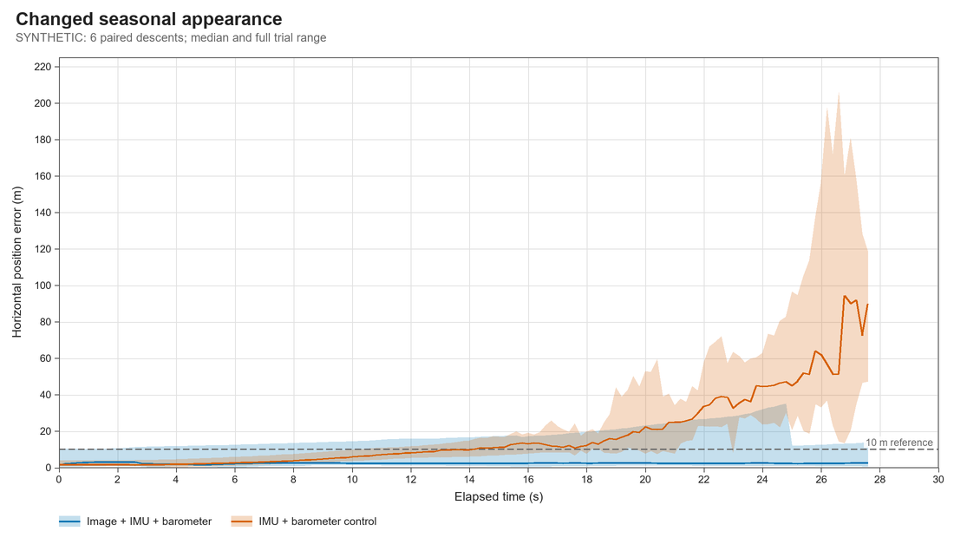
sim/nav/results/fine_tracking_20261023/figures/seasonal_tracking.png
