brentius/cansat-sync/sim/nav/results/image_in_loop_horizontal_error.png

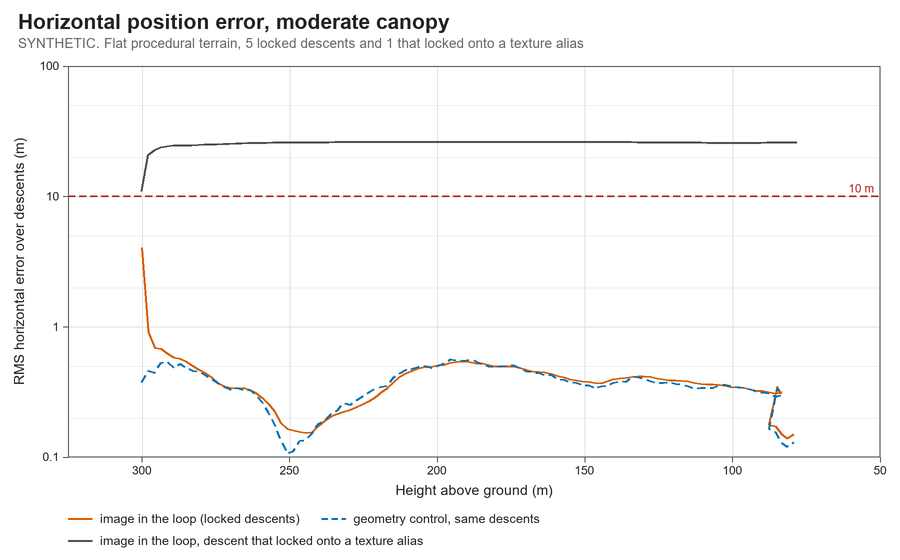
sim/nav/results/image_in_loop_horizontal_error.png
