brentius/cansat-sync/sim/nav/results/image_in_loop_pixel_error.png

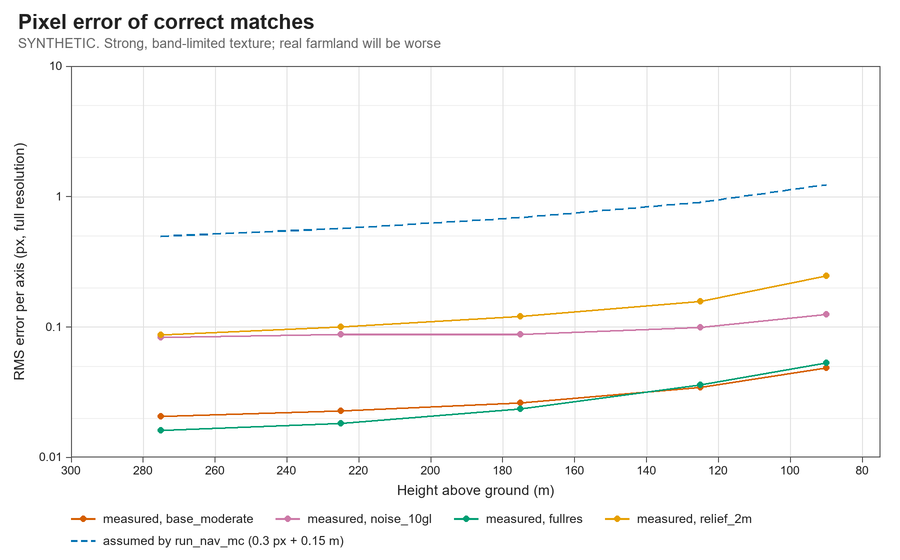
sim/nav/results/image_in_loop_pixel_error.png
