brentius/cansat-sync/sim/nav/results/nav_mc/additions.png

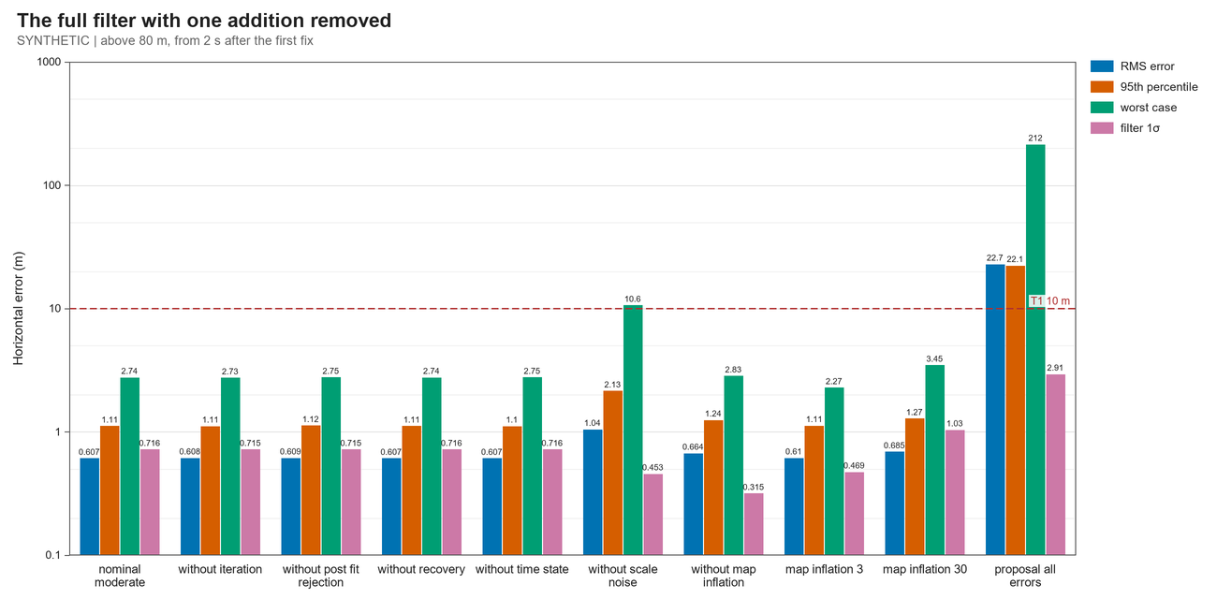
sim/nav/results/nav_mc/additions.png
