brentius/cansat-sync/sim/nav/results/nav_mc/attitude_vs_height.png

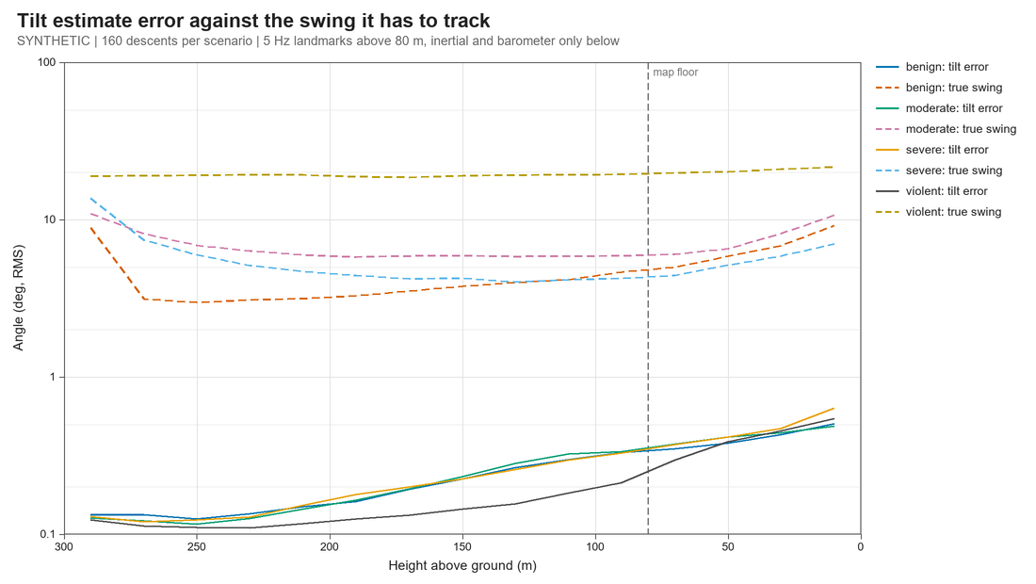
sim/nav/results/nav_mc/attitude_vs_height.png
