brentius/cansat-sync/sim/nav/results/nav_mc/cheaper.png

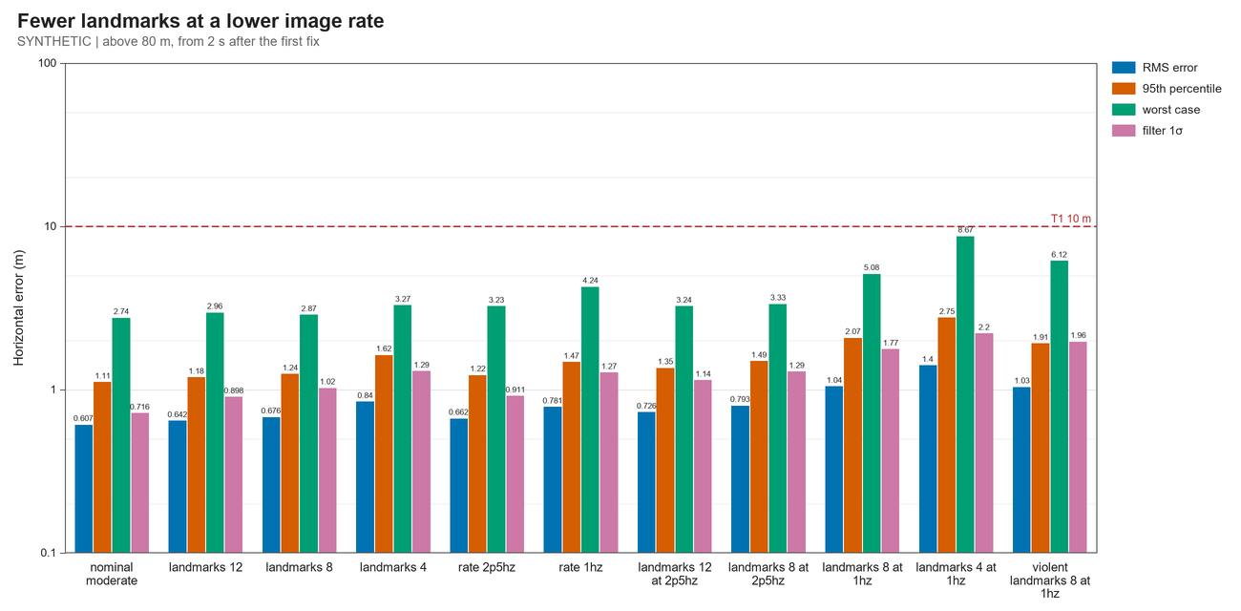
sim/nav/results/nav_mc/cheaper.png
