brentius/cansat-sync/sim/nav/results/nav_mc/consistency_nees.png

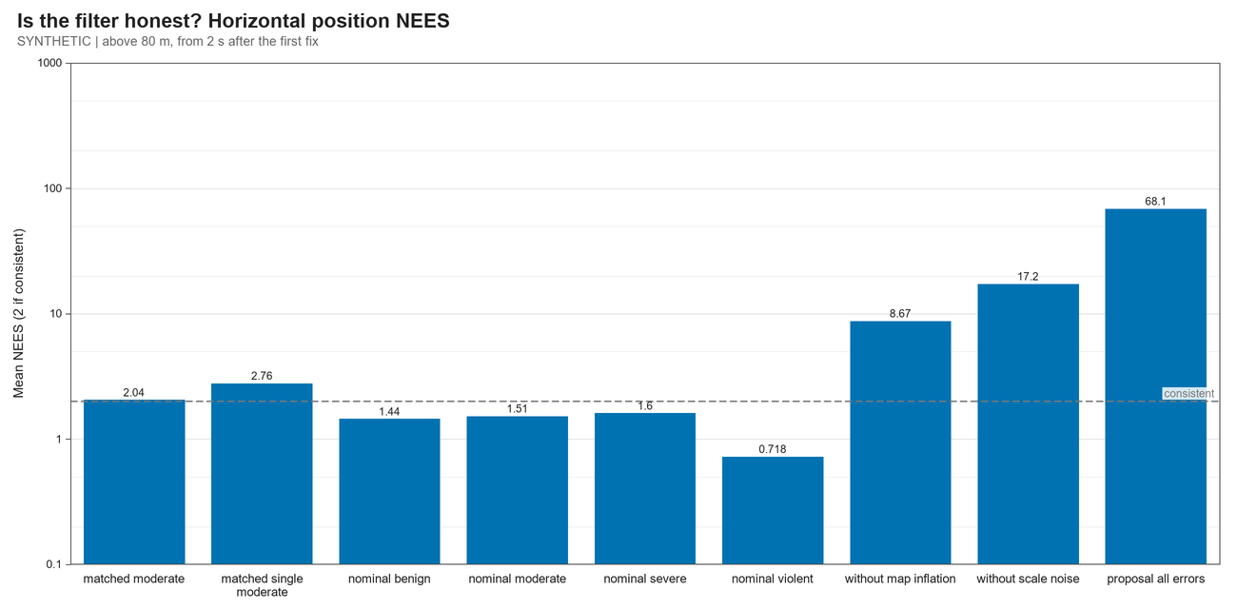
sim/nav/results/nav_mc/consistency_nees.png
