brentius/cansat-sync/sim/nav/results/nav_mc/consistency_protection.png

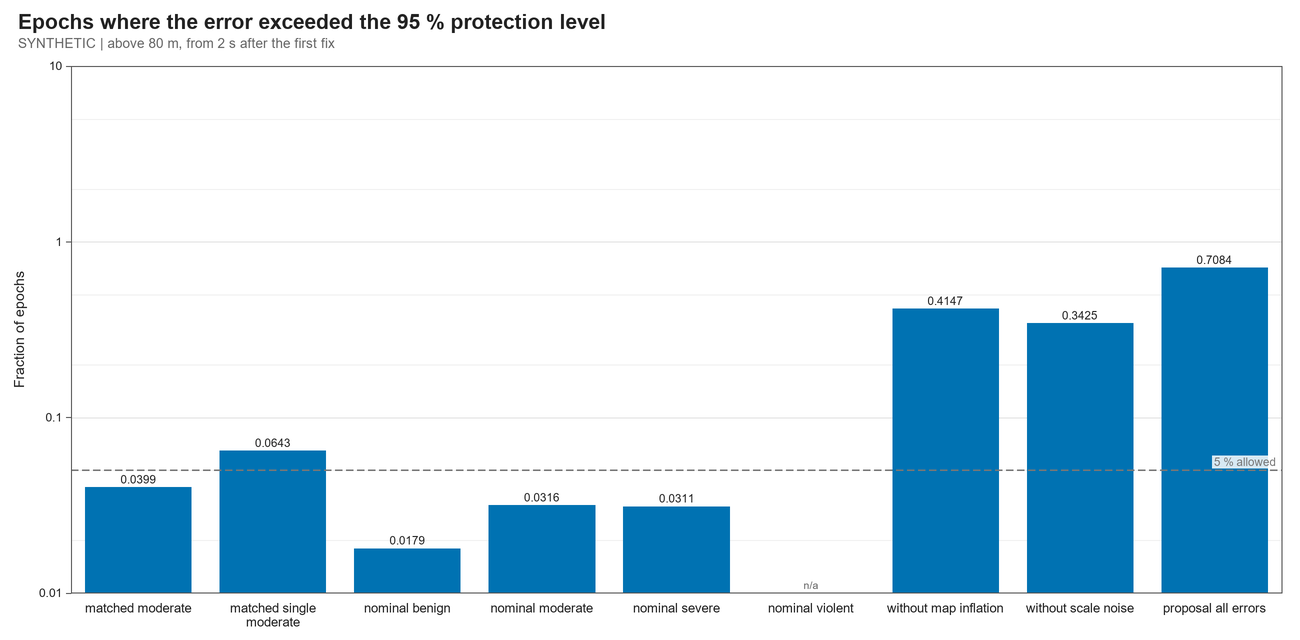
sim/nav/results/nav_mc/consistency_protection.png
