brentius/cansat-sync/sim/nav/results/nav_mc/error_vs_budget.png

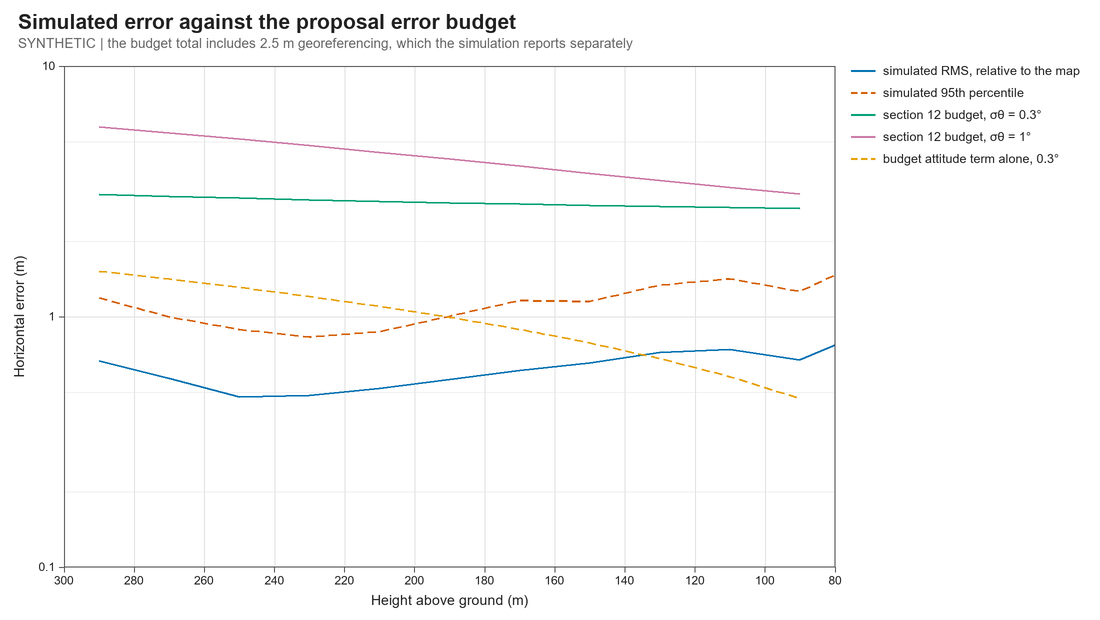
sim/nav/results/nav_mc/error_vs_budget.png
