brentius/cansat-sync/sim/nav/results/nav_mc/error_vs_height.png

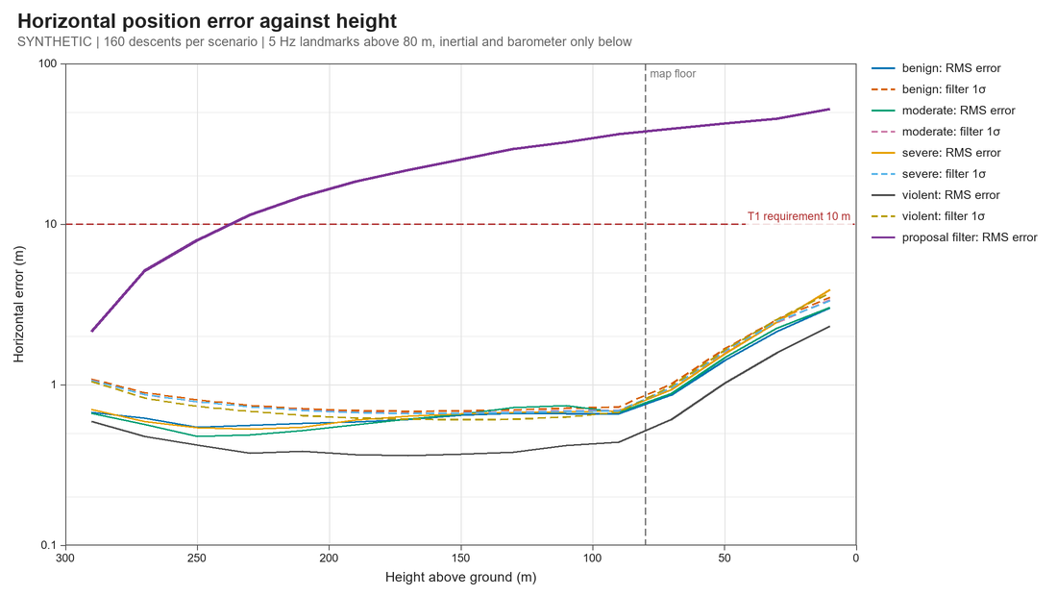
sim/nav/results/nav_mc/error_vs_height.png
