brentius/cansat-sync/sim/nav/results/nav_mc/fragility.png

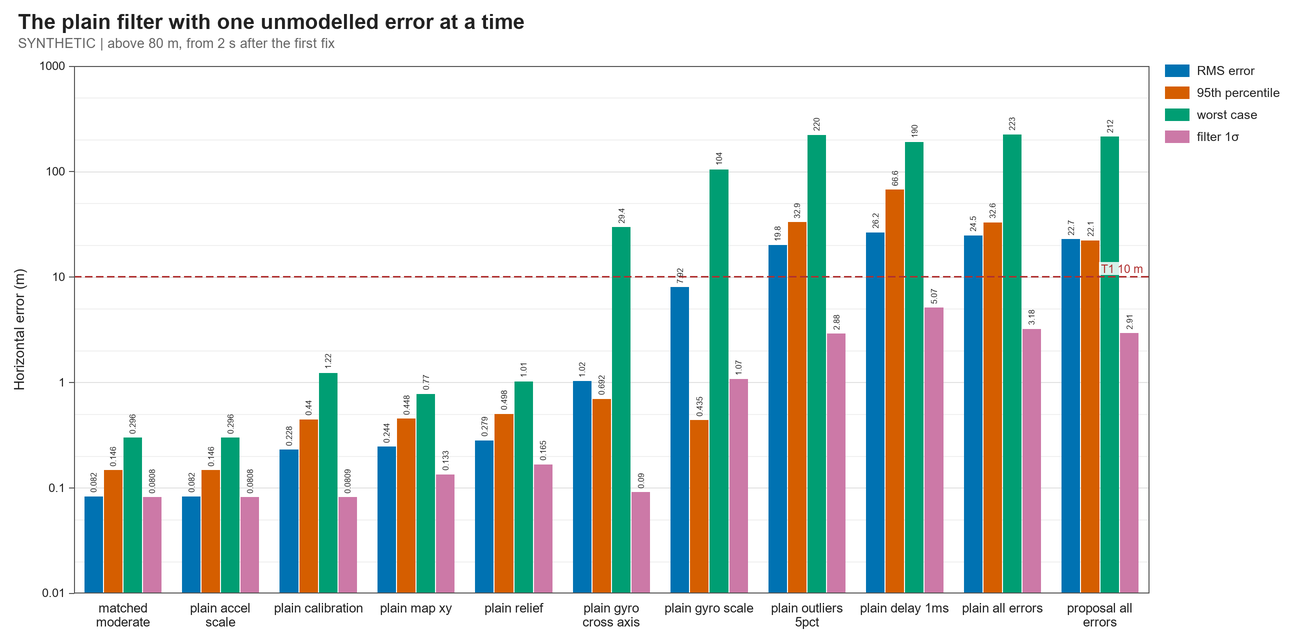
sim/nav/results/nav_mc/fragility.png
