brentius/cansat-sync/sim/nav/results/nav_mc/geometry.png

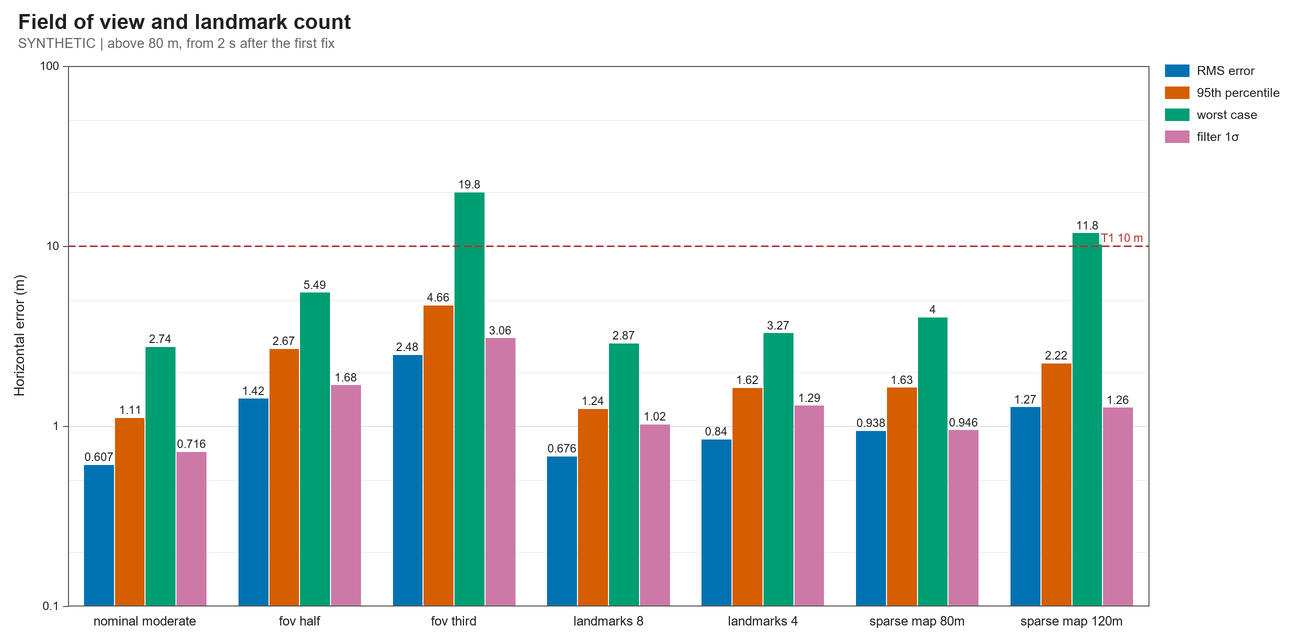
sim/nav/results/nav_mc/geometry.png
