brentius/cansat-sync/sim/nav/results/nav_mc/imu.png

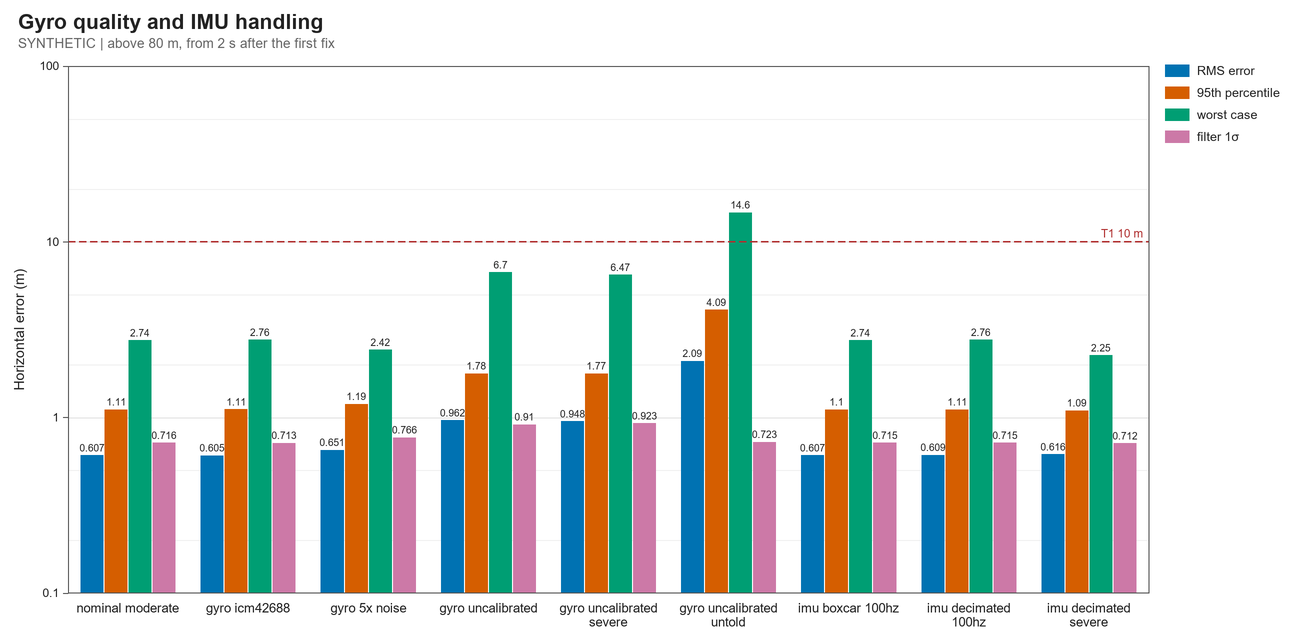
sim/nav/results/nav_mc/imu.png
