brentius/cansat-sync/sim/nav/results/nav_mc/matches.png

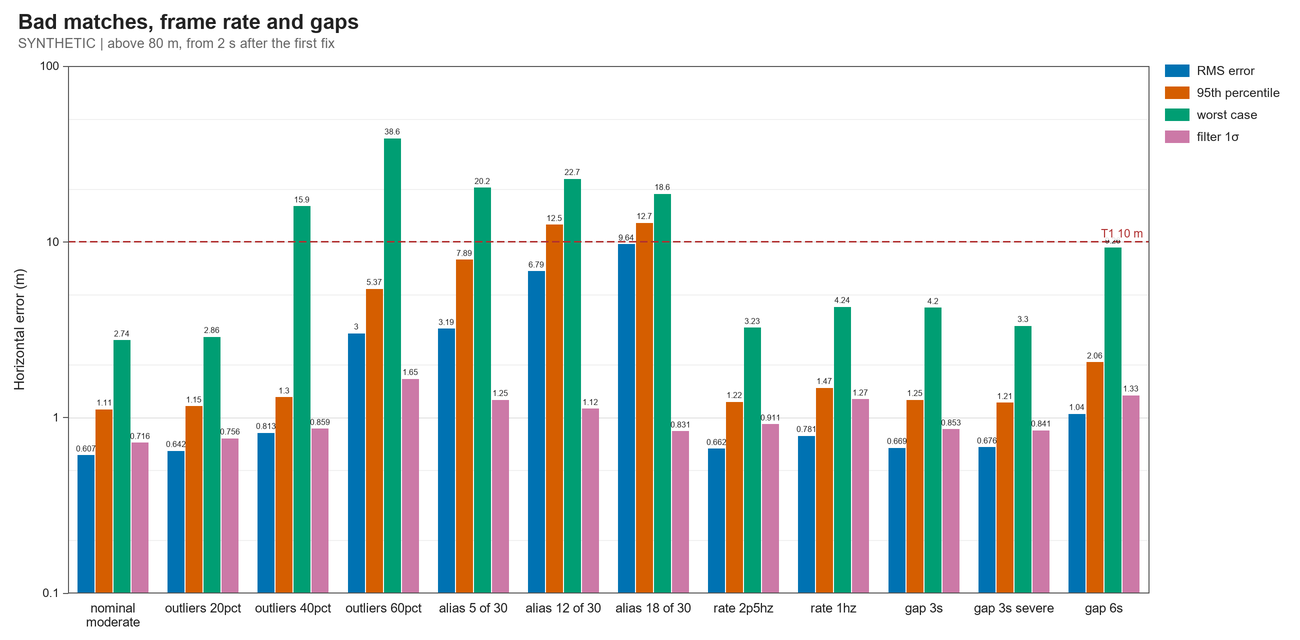
sim/nav/results/nav_mc/matches.png
