brentius/cansat-sync/sim/nav/results/nav_mc/relief.png

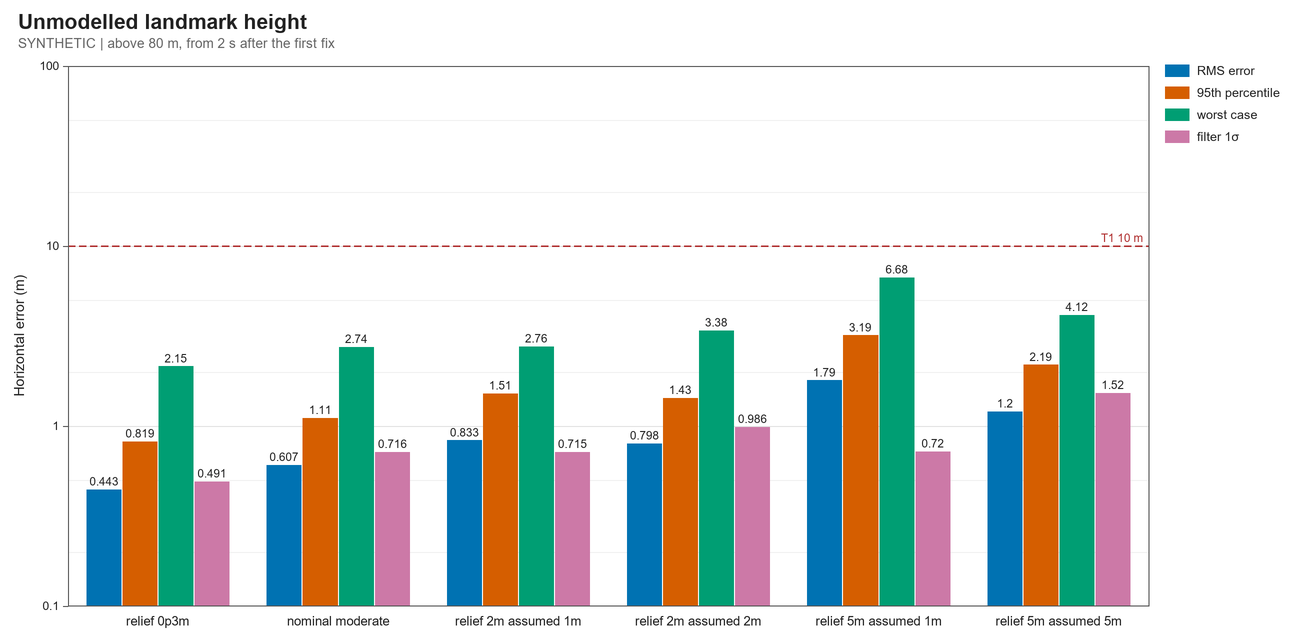
sim/nav/results/nav_mc/relief.png
