brentius/cansat-sync/sim/nav/results/nav_mc/under_load.png

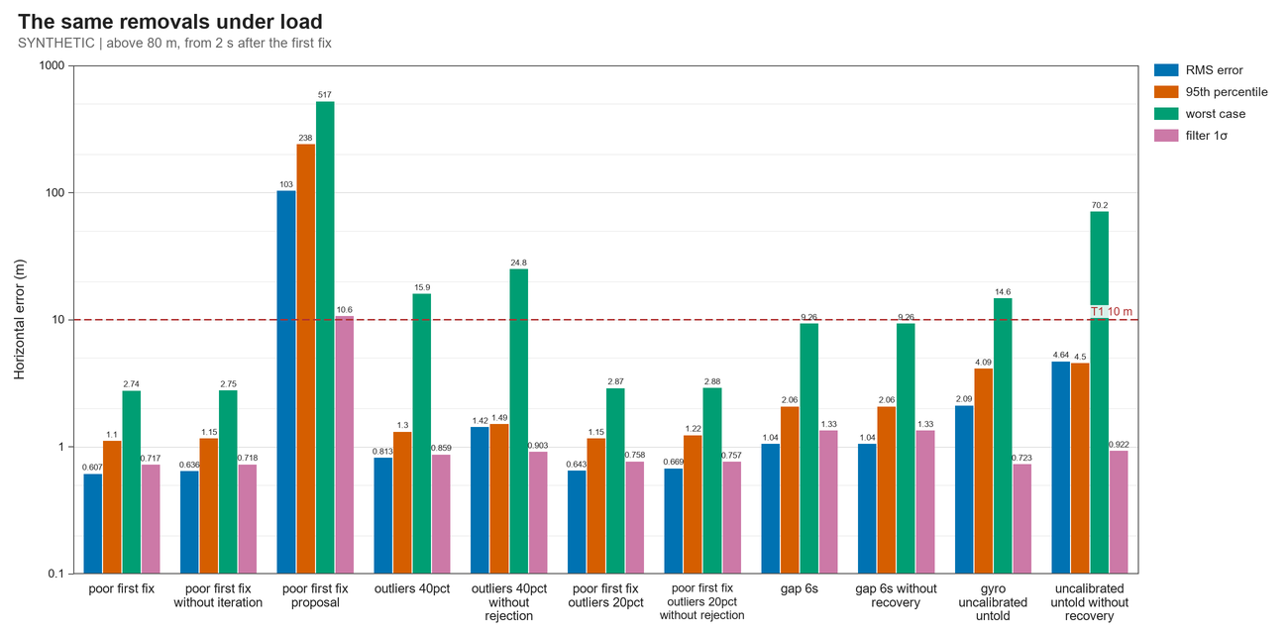
sim/nav/results/nav_mc/under_load.png
