brentius/cansat-sync/sim/nav/results/nav_mc/velocity_vs_height.png

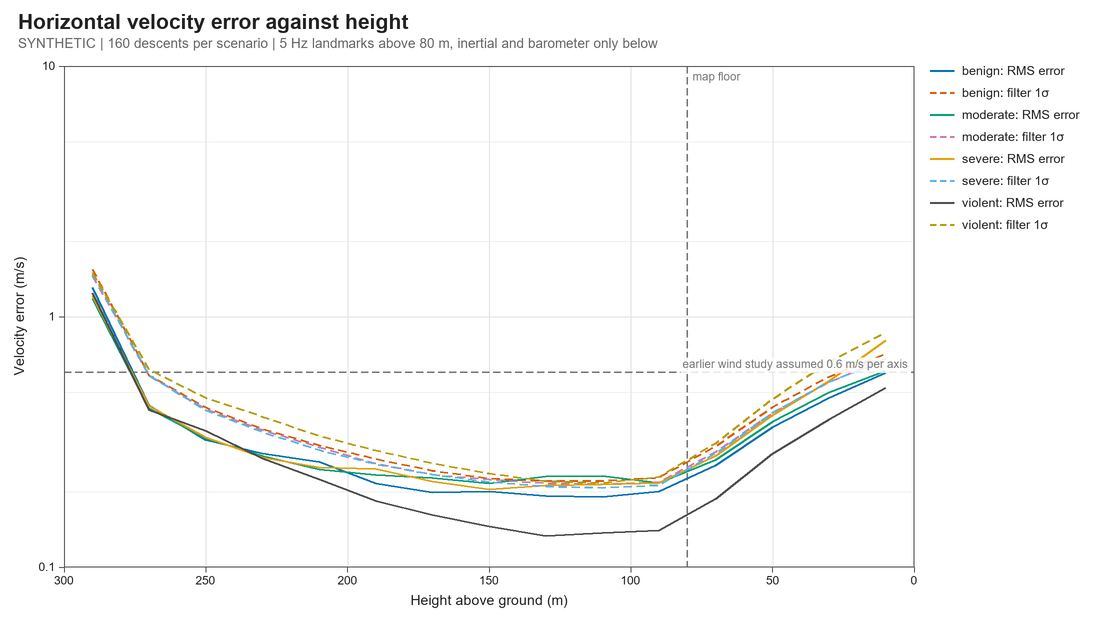
sim/nav/results/nav_mc/velocity_vs_height.png
