brentius/cansat-sync/sim/nav/results/nav_mc/violent.png

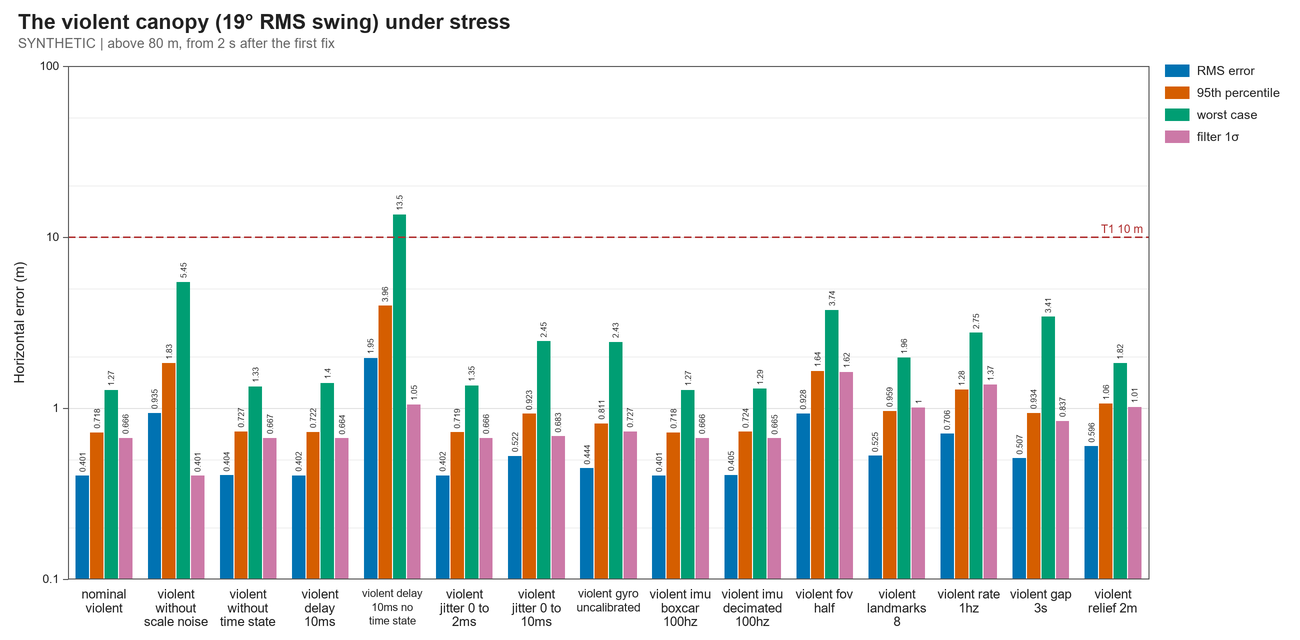
sim/nav/results/nav_mc/violent.png
