brentius/cansat-sync/sim/nav/results/plotting_demo.png

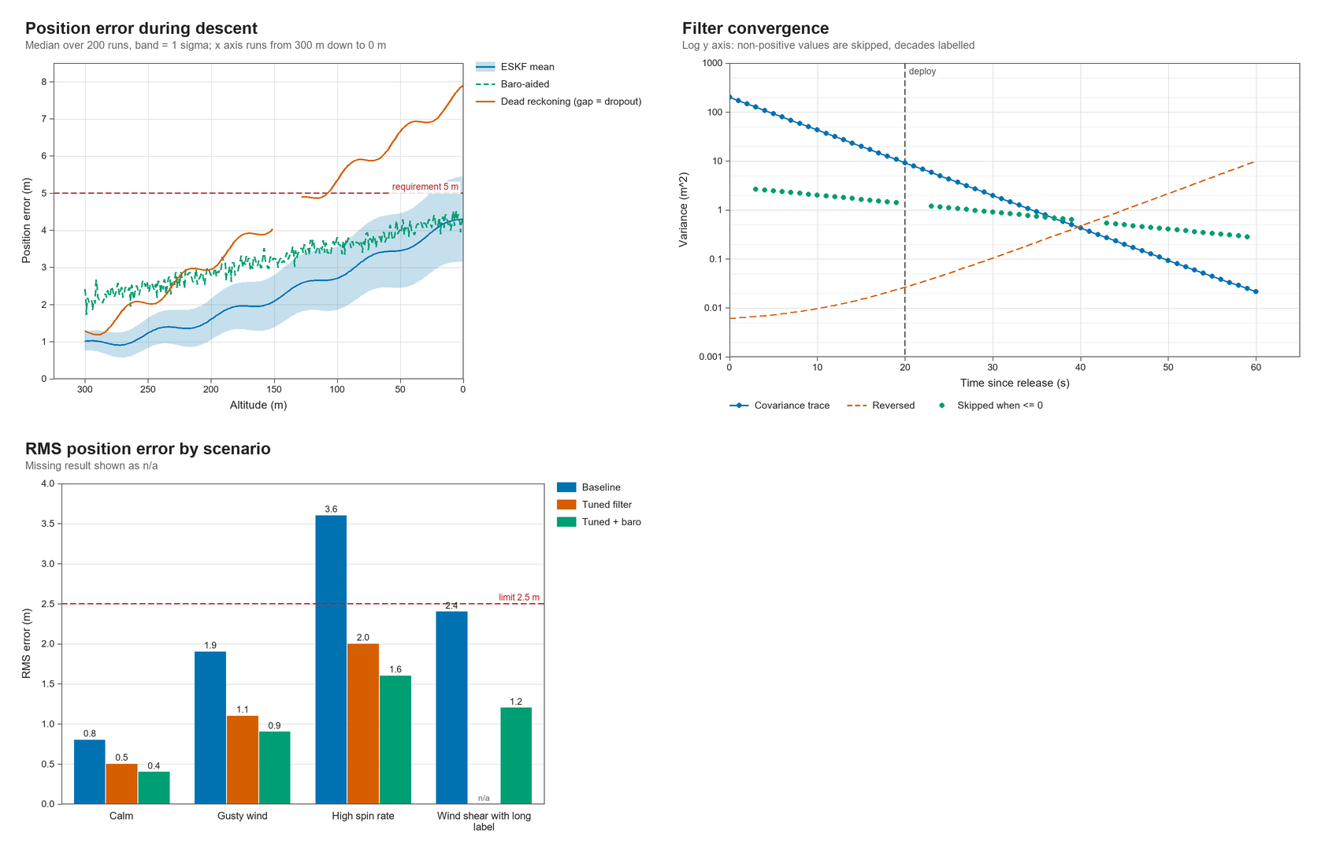
sim/nav/results/plotting_demo.png
