brentius/cansat-sync/sim/nav/results/similarity_fit/fig0_cdf_gls.png

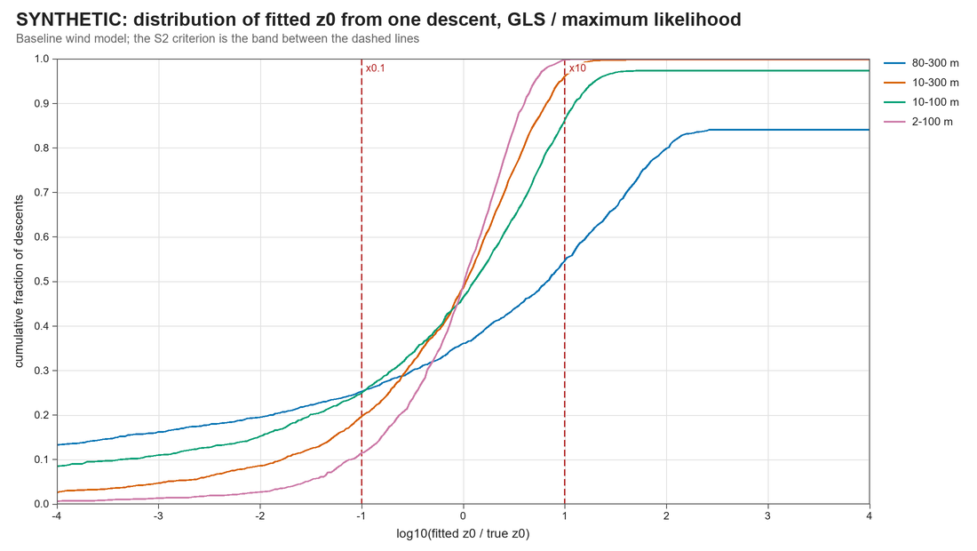
sim/nav/results/similarity_fit/fig0_cdf_gls.png
