brentius/cansat-sync/sim/nav/results/similarity_fit/fig1_fraction_within.png

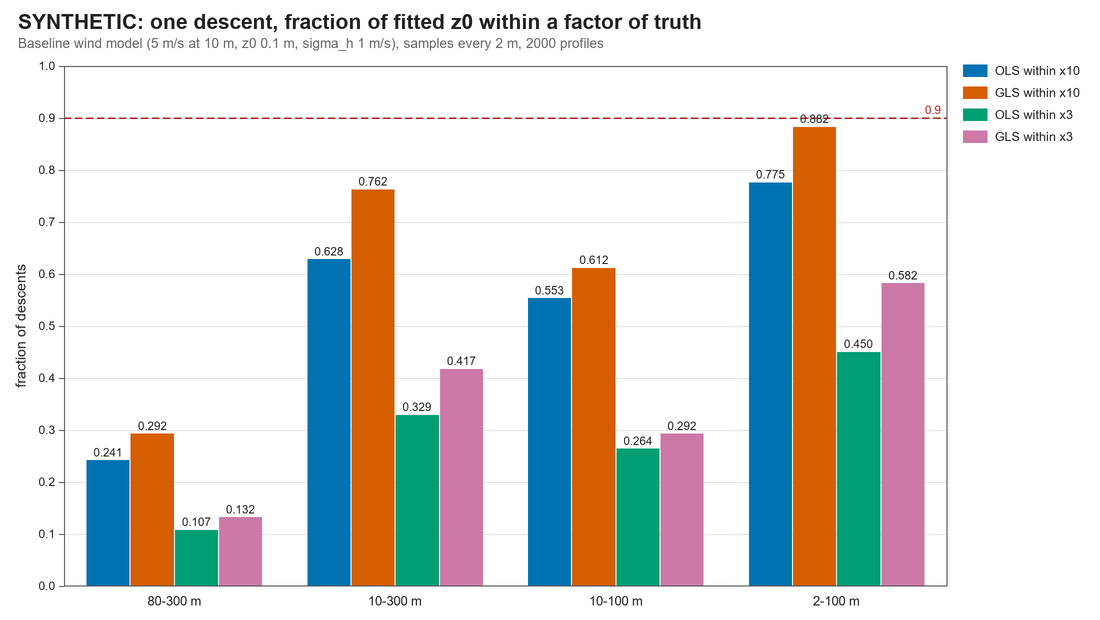
sim/nav/results/similarity_fit/fig1_fraction_within.png
