brentius/cansat-sync/sim/nav/results/similarity_fit/fig2_coverage.png

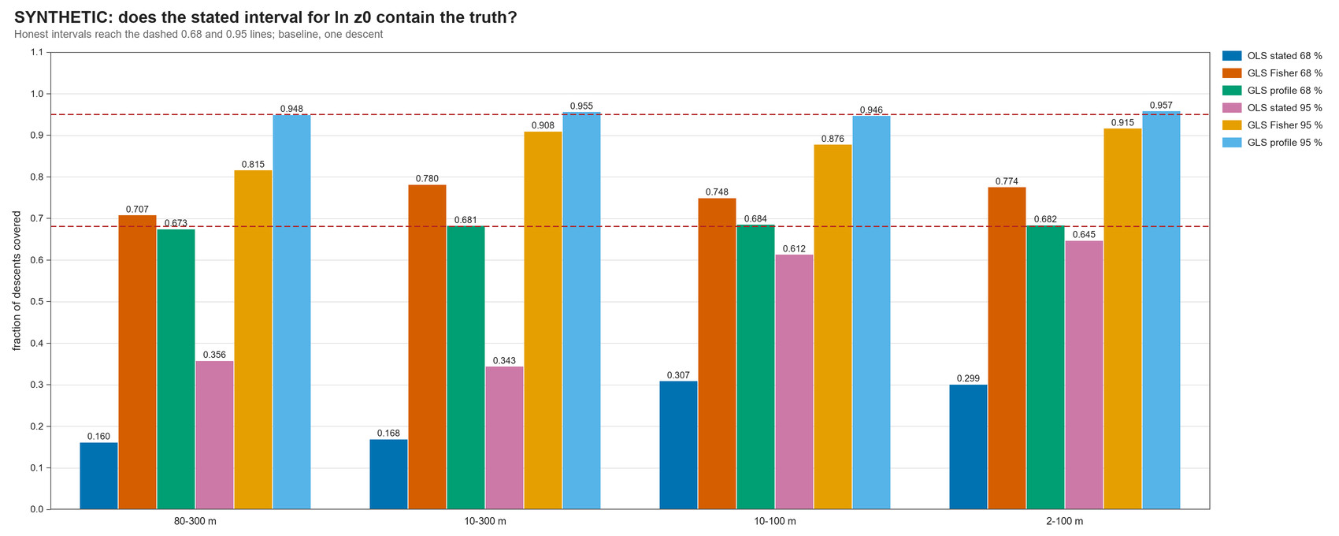
sim/nav/results/similarity_fit/fig2_coverage.png
