brentius/cansat-sync/sim/nav/results/similarity_fit/fig3a_options_80-300.png

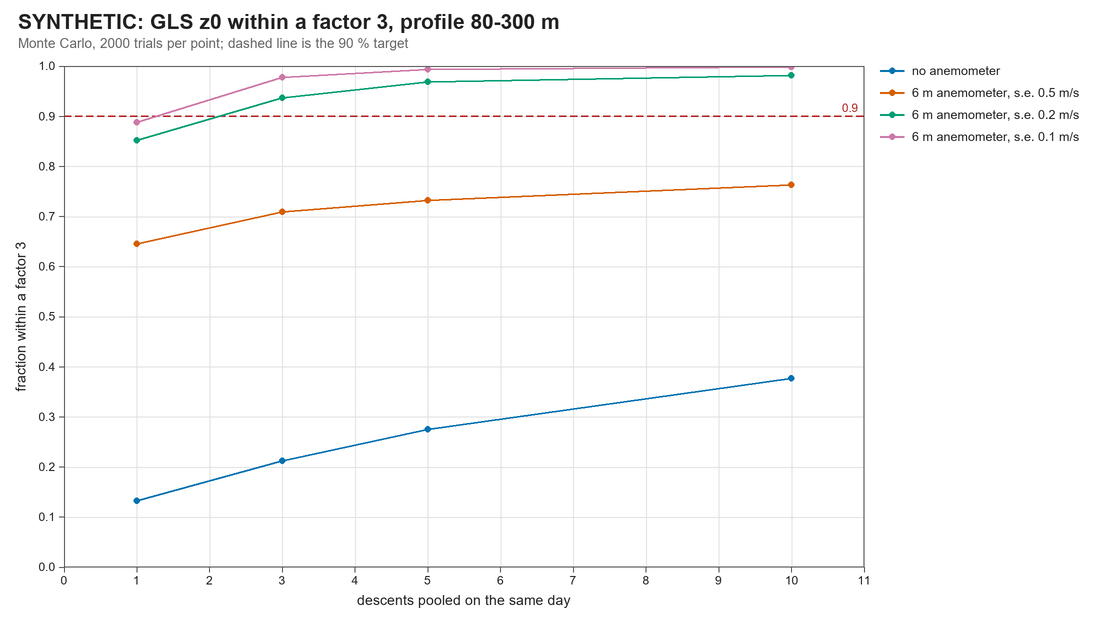
sim/nav/results/similarity_fit/fig3a_options_80-300.png
