brentius/cansat-sync/sim/nav/results/similarity_fit/fig3b_options_10-300.png

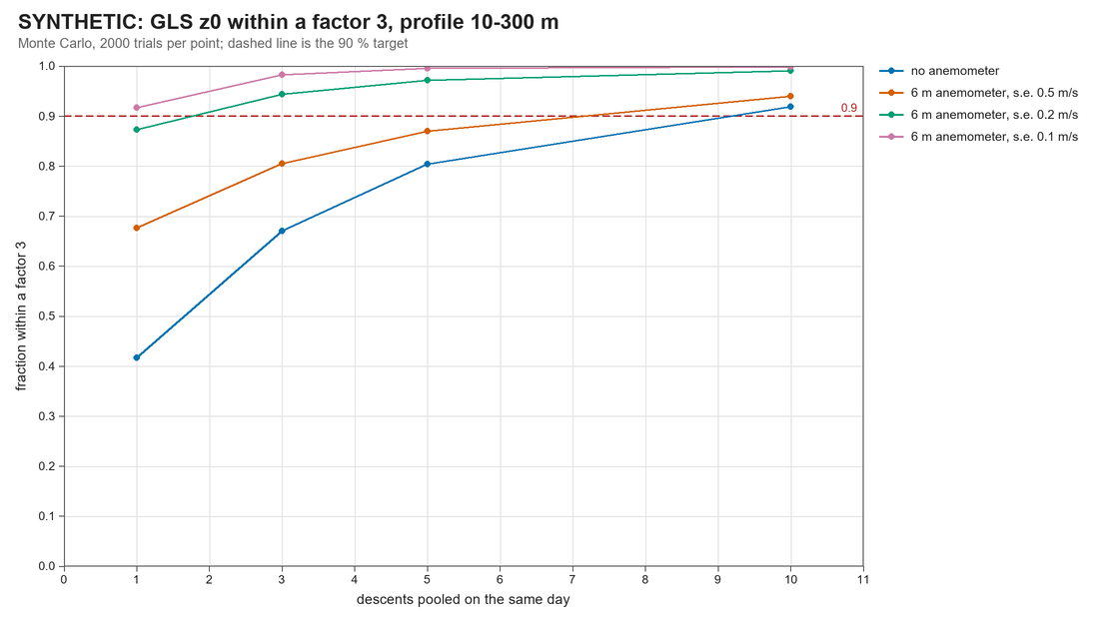
sim/nav/results/similarity_fit/fig3b_options_10-300.png
