brentius/cansat-sync/sim/nav/results/similarity_fit/fig4_anemometer_bound.png

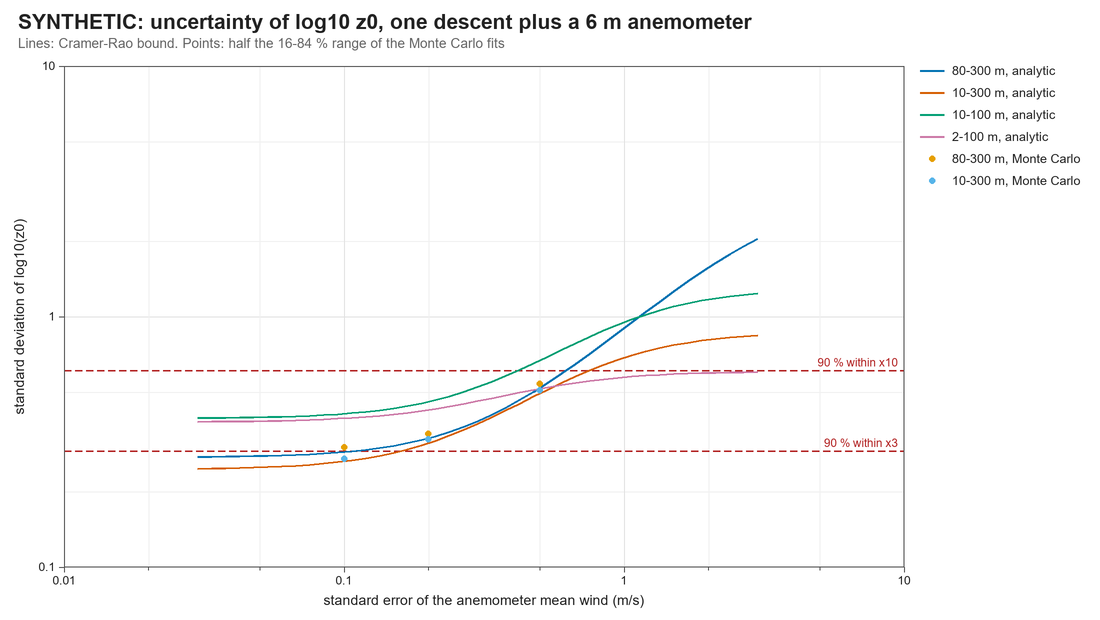
sim/nav/results/similarity_fit/fig4_anemometer_bound.png
