brentius/cansat-sync/sim/nav/results/similarity_fit/fig5_sensitivity.png

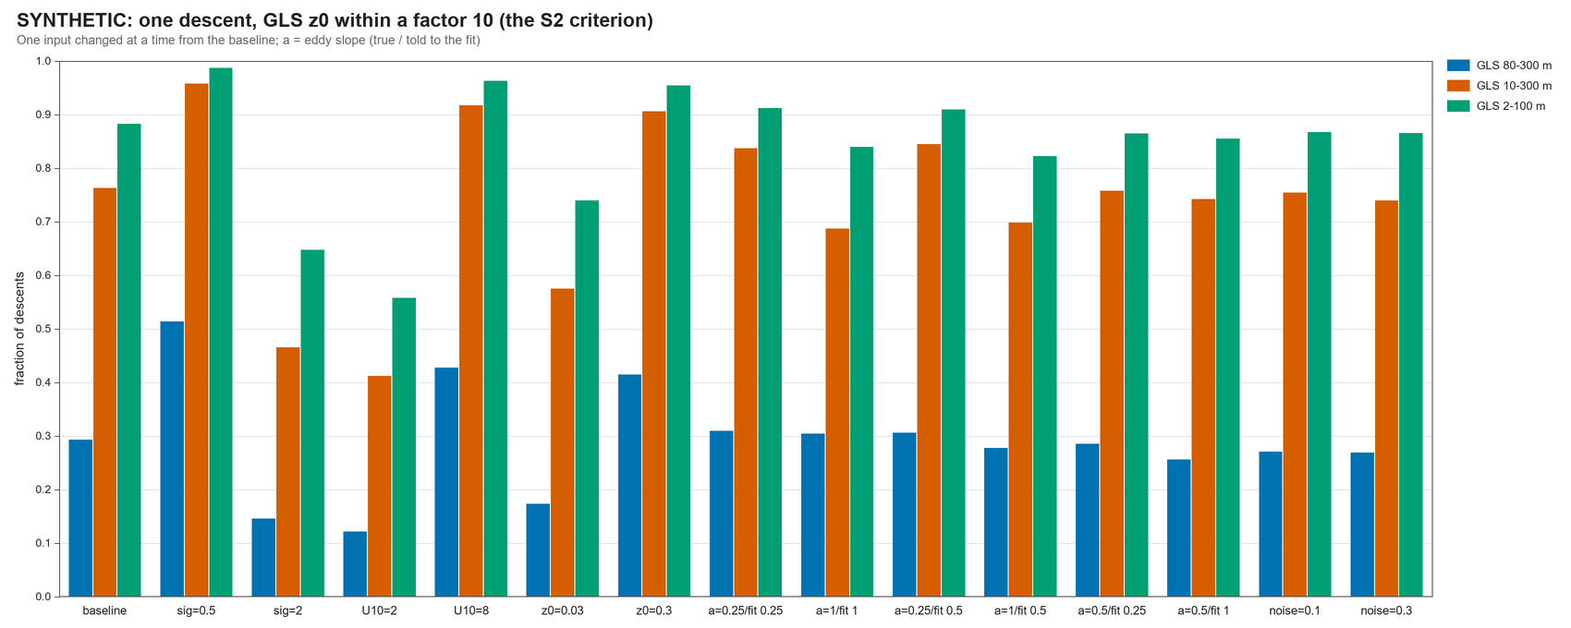
sim/nav/results/similarity_fit/fig5_sensitivity.png
