brentius/cansat-sync/sim/nav/results/wind_mc/landing_coverage.png

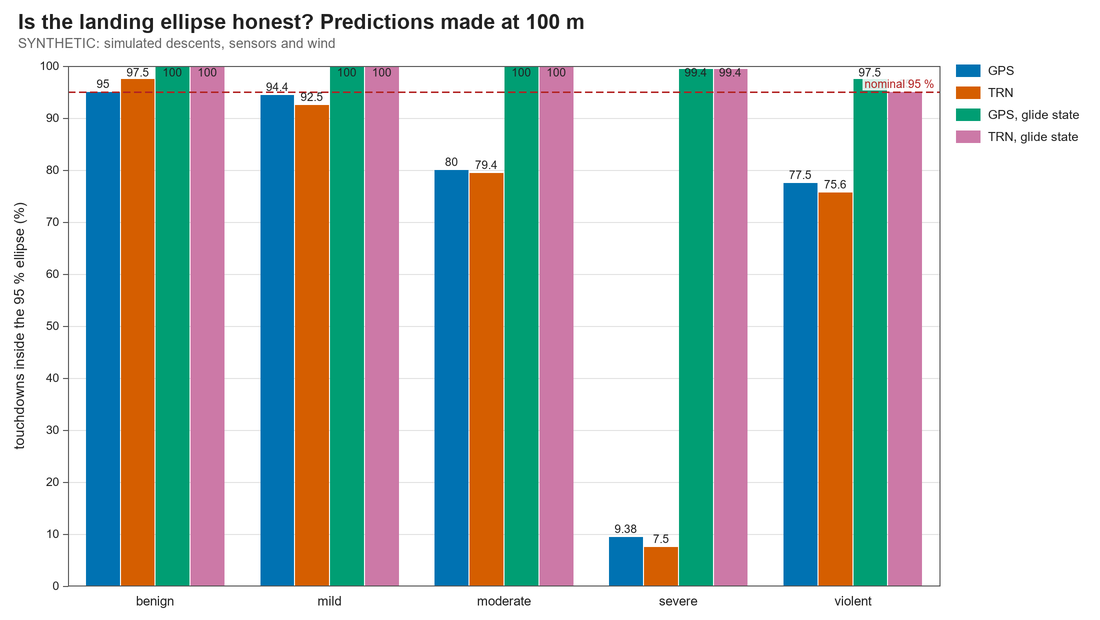
sim/nav/results/wind_mc/landing_coverage.png
