brentius/cansat-sync/sim/nav/results/wind_mc/landing_error_benign.png

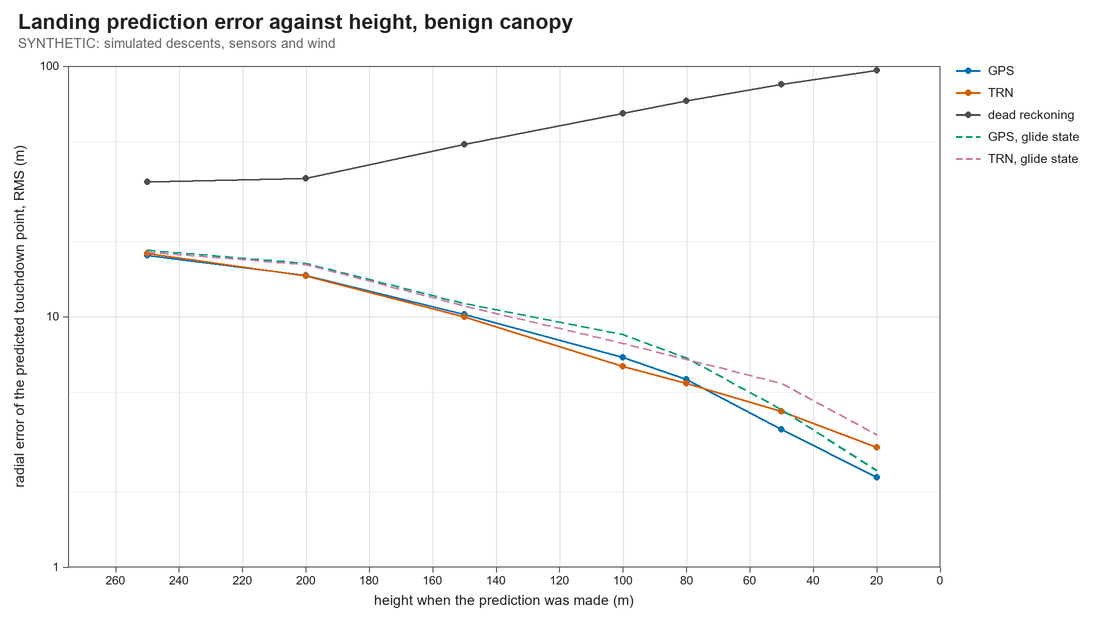
sim/nav/results/wind_mc/landing_error_benign.png
