brentius/cansat-sync/sim/nav/results/wind_mc/landing_error_moderate.png

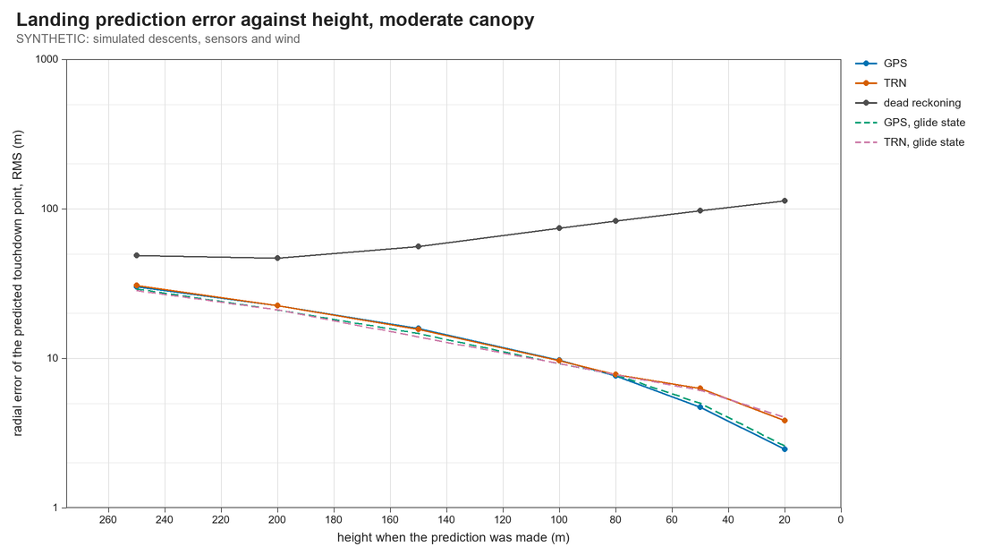
sim/nav/results/wind_mc/landing_error_moderate.png
