brentius/cansat-sync/sim/nav/results/wind_mc/s1_blind.png

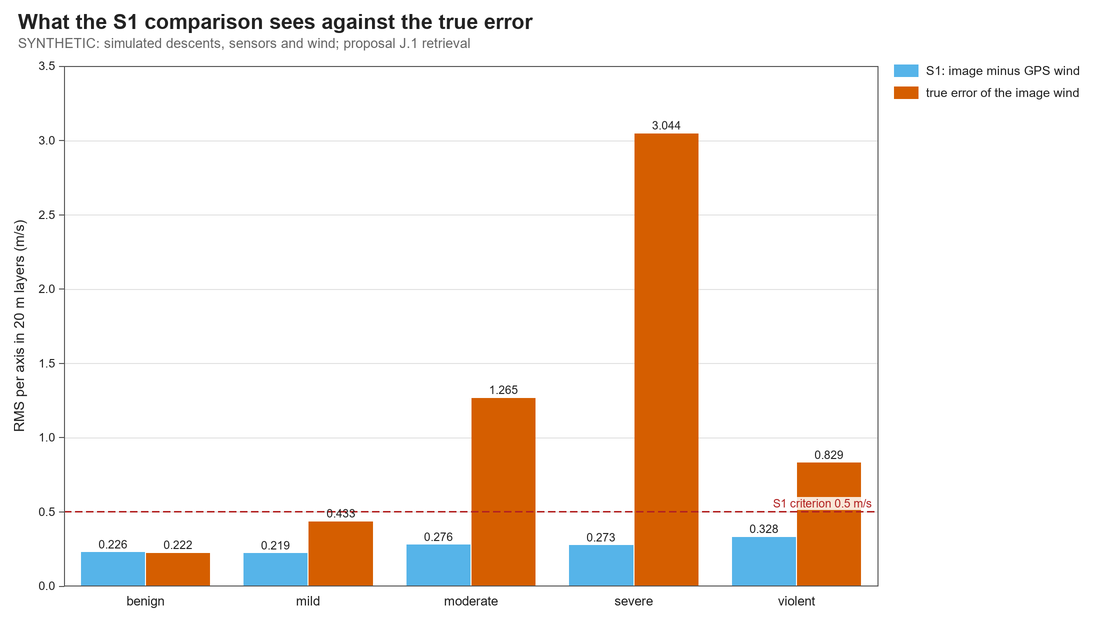
sim/nav/results/wind_mc/s1_blind.png
