brentius/cansat-sync/sim/nav/results/wind_mc/wind_coverage.png

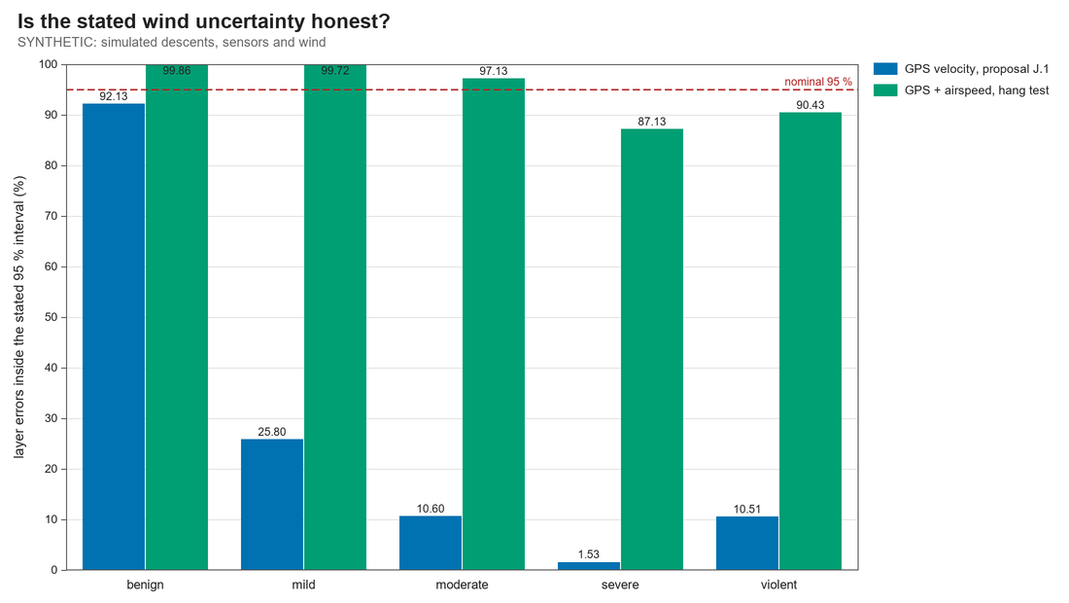
sim/nav/results/wind_mc/wind_coverage.png
