brentius/cansat-sync/sim/nav/results/wind_mc/wind_error.png

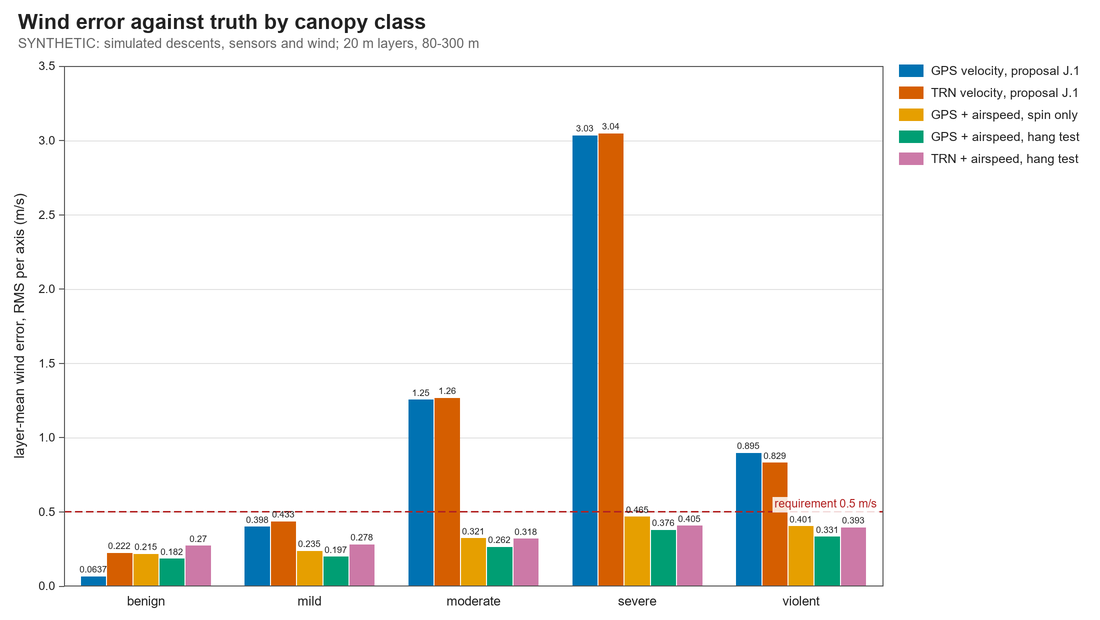
sim/nav/results/wind_mc/wind_error.png
