brentius/cansat-sync/sim/nav/results/wind_mc/wind_error_vs_height_benign.png

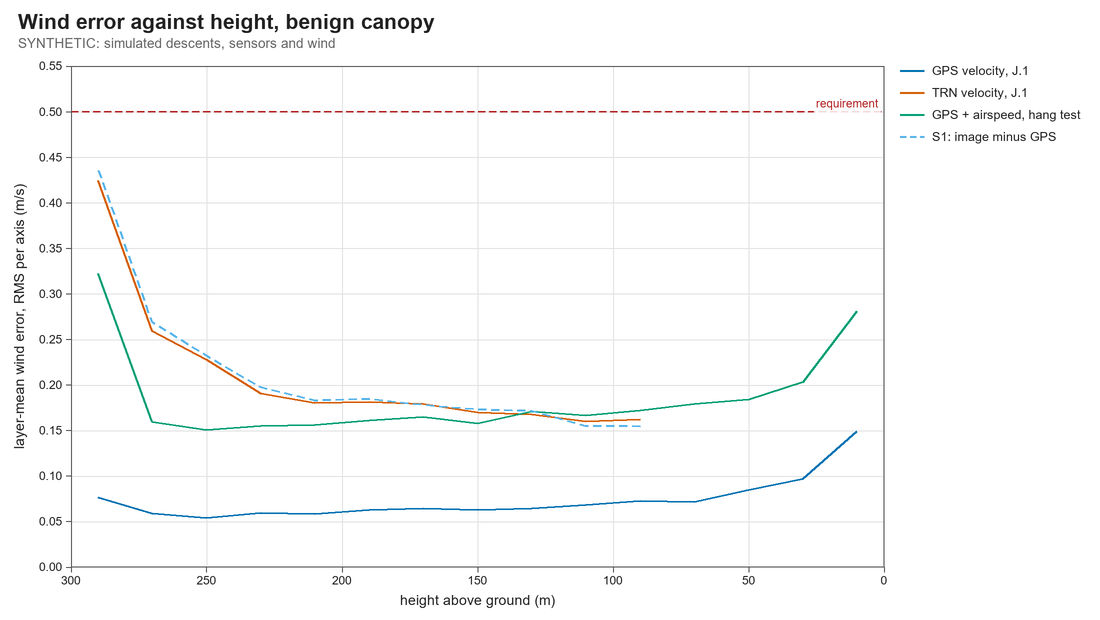
sim/nav/results/wind_mc/wind_error_vs_height_benign.png
