brentius/cansat-sync/sim/systems/results/2026-10-11-budget/canopy_area_vs_speed.png

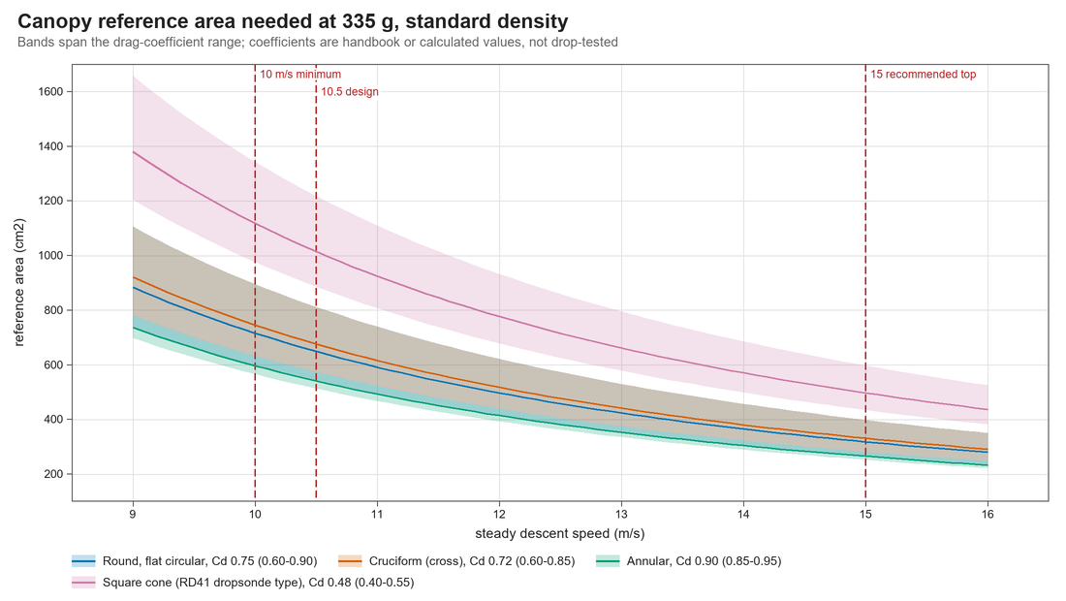
sim/systems/results/2026-10-11-budget/canopy_area_vs_speed.png
