brentius/cansat-sync/sim/systems/results/2026-10-11-budget/endurance_by_phase.png

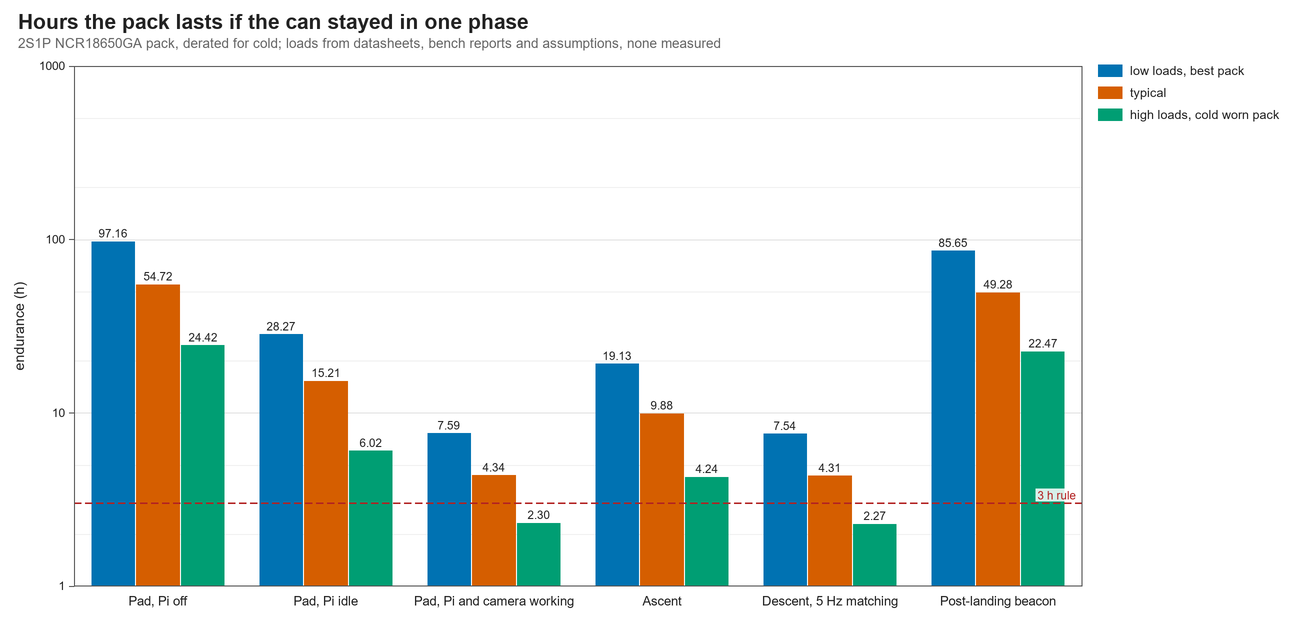
sim/systems/results/2026-10-11-budget/endurance_by_phase.png
