brentius/cansat-sync/sim/systems/results/2026-10-11-budget/mass_total_distribution.png

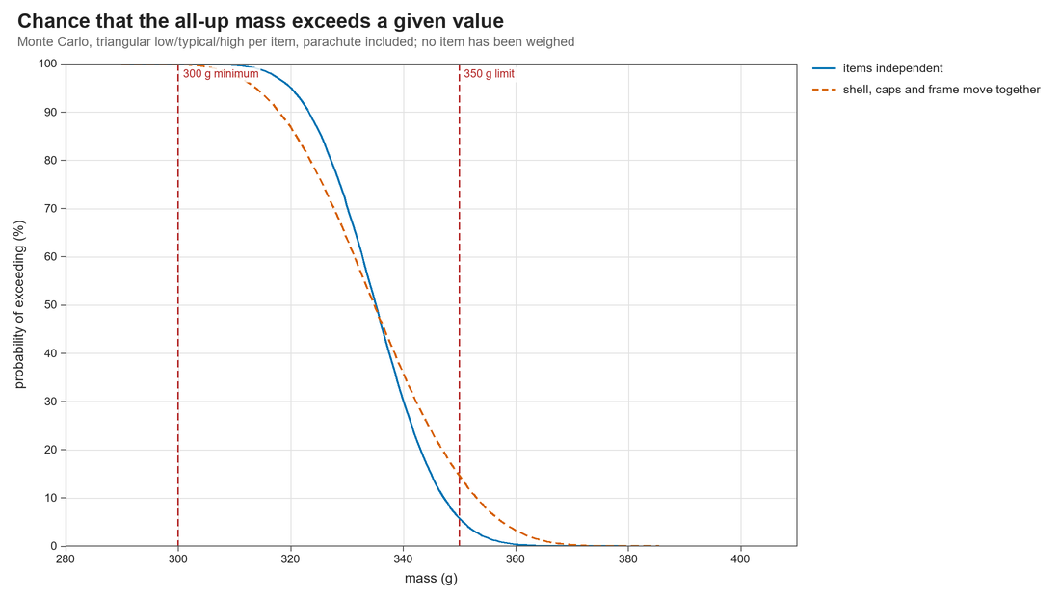
sim/systems/results/2026-10-11-budget/mass_total_distribution.png
