brentius/cansat-sync/sim/temperature/results/2026-10-09-verified/conversion_bias.png

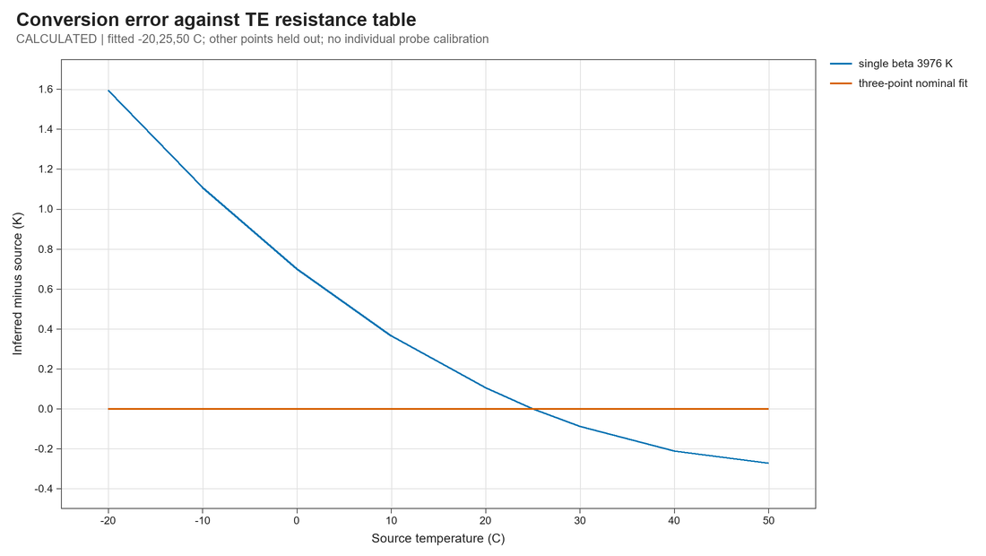
sim/temperature/results/2026-10-09-verified/conversion_bias.png
