brentius/cansat-sync/wiki/history/README.md

# Historical proposal sources

`trn_secondary_mission_proposal_2026-09-27.md` is the byte-preserved proposal as it stood before the authorised 13 October 2026 rewrite. It describes superseded Orange Pi/H618, OV9281, sensor and performance assumptions. It is retained so existing mathematical derivations and study comparisons have a dated source, not as a current design recommendation.

Relative links in the unchanged snapshot were written for its original `wiki/` location. Use the current [mission proposal](../trn_secondary_mission_proposal.md), [design baseline](../design_baseline.md) and [BOM](../flight_computer_bom.md) for live design work. Raw measurement/simulation artifacts remain in their original locations and retain original run parameters.
