brentius/cansat-sync/sim/nav/results/nav_mc/first_fix.png

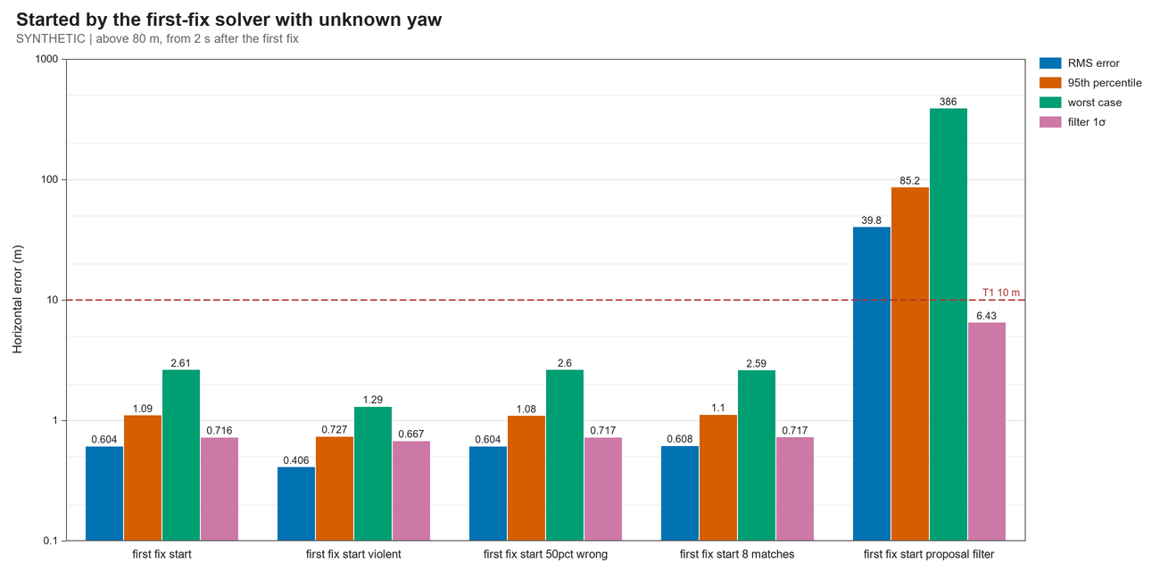
sim/nav/results/nav_mc/first_fix.png
