brentius/cansat-sync/pcb/cansat_main/cansat_main.kicad_pcb

## KiCad design pcb/cansat_main/cansat_main.kicad_pcb (2026-10-30)

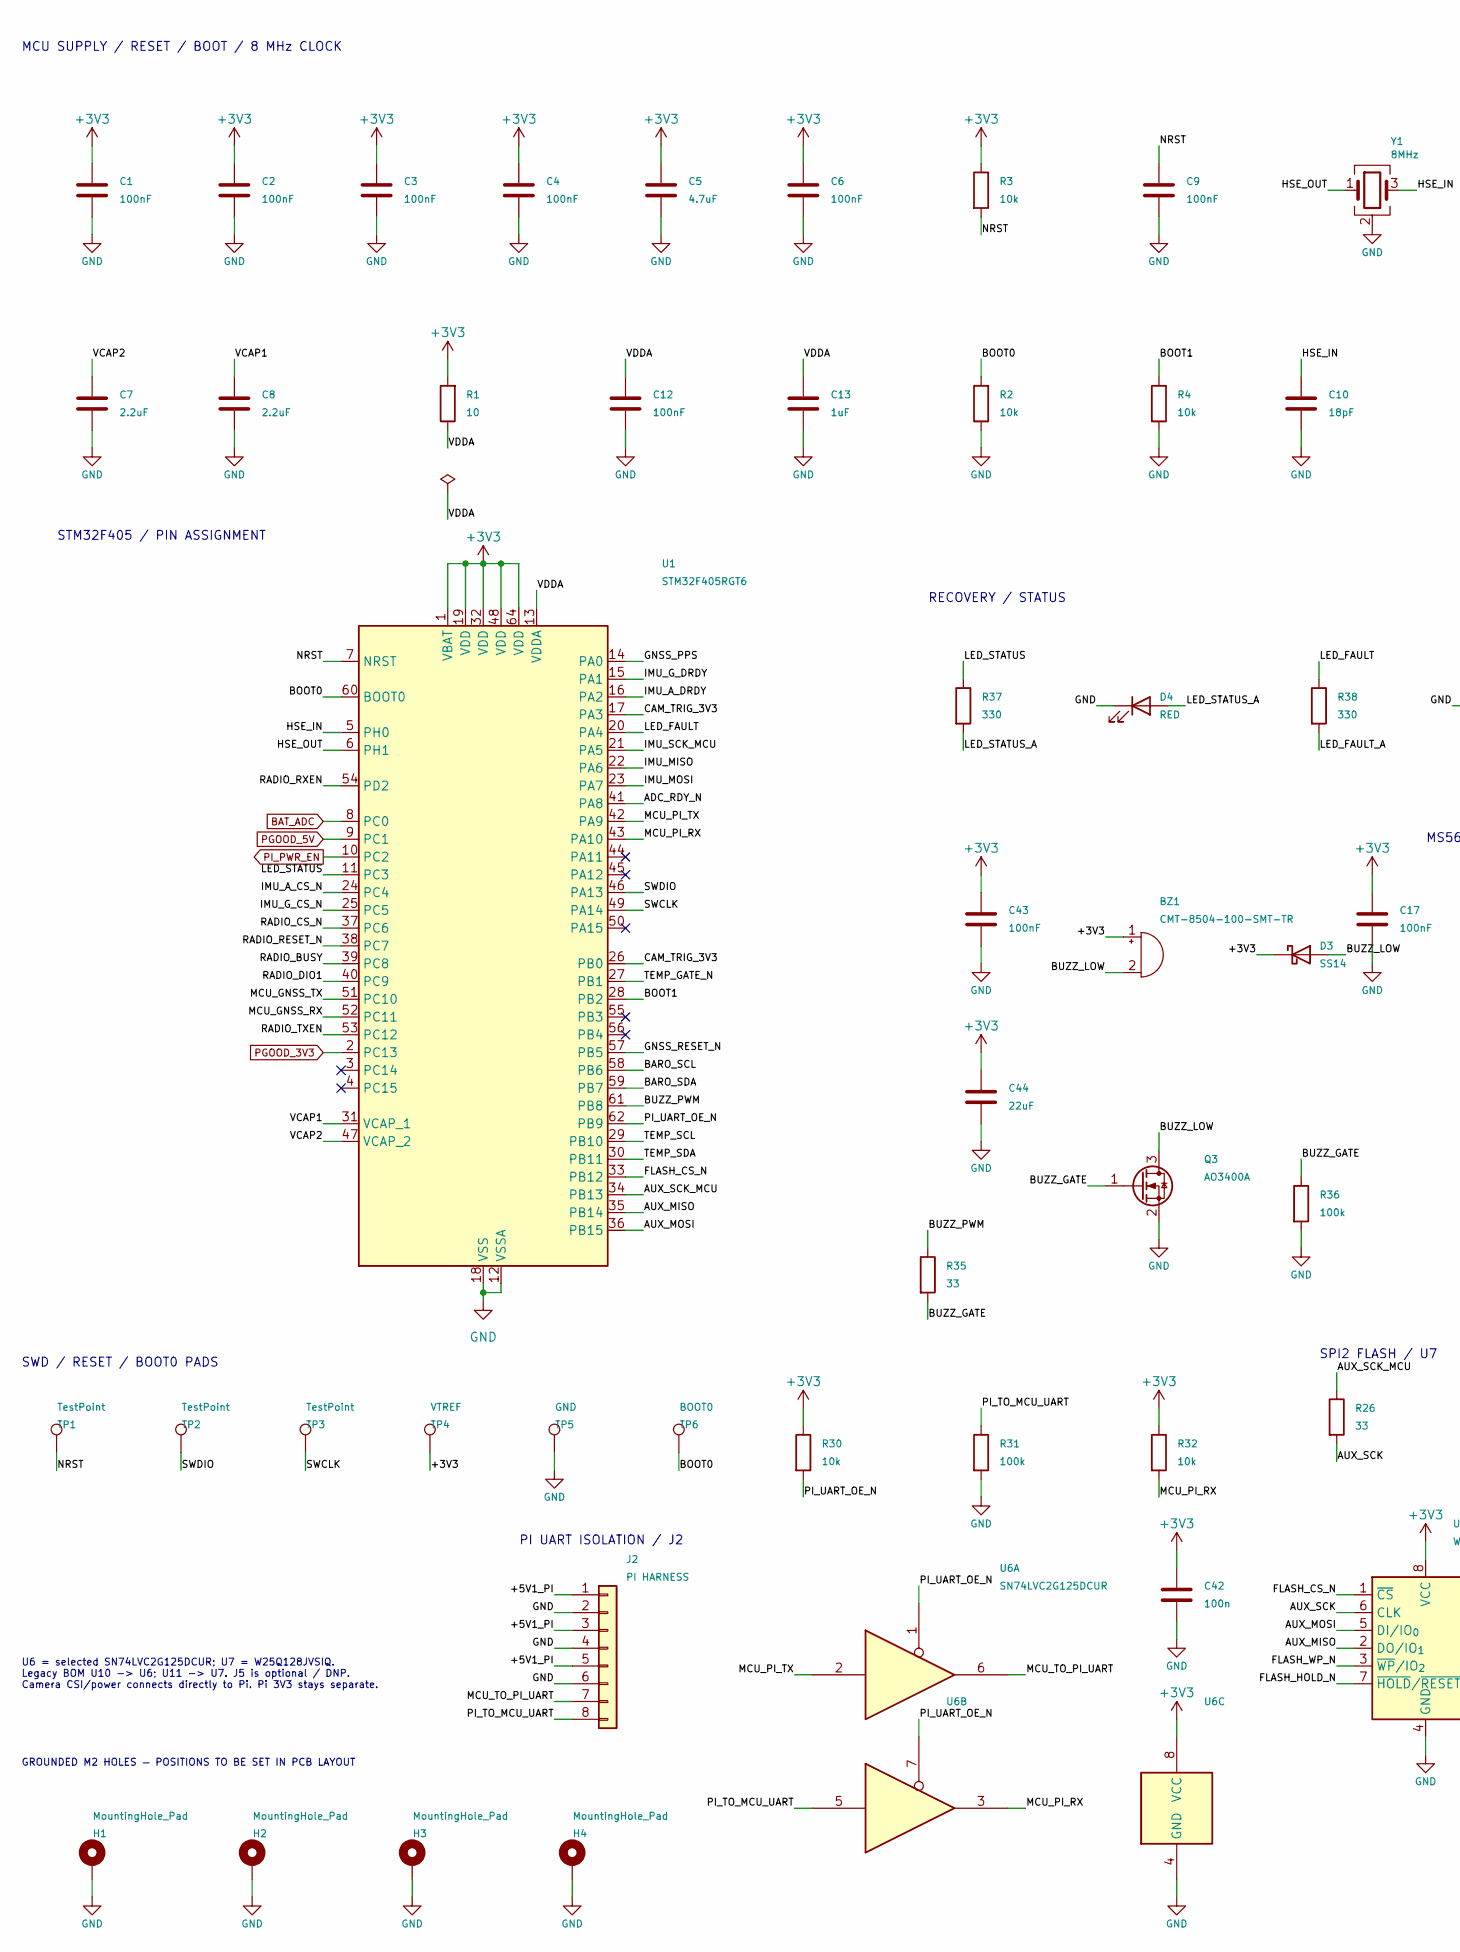
[picture p86: schematic cansat_main.kicad_sch, CANSAT MAIN — MCU, sensors and interfaces, part in row 1, column 1]

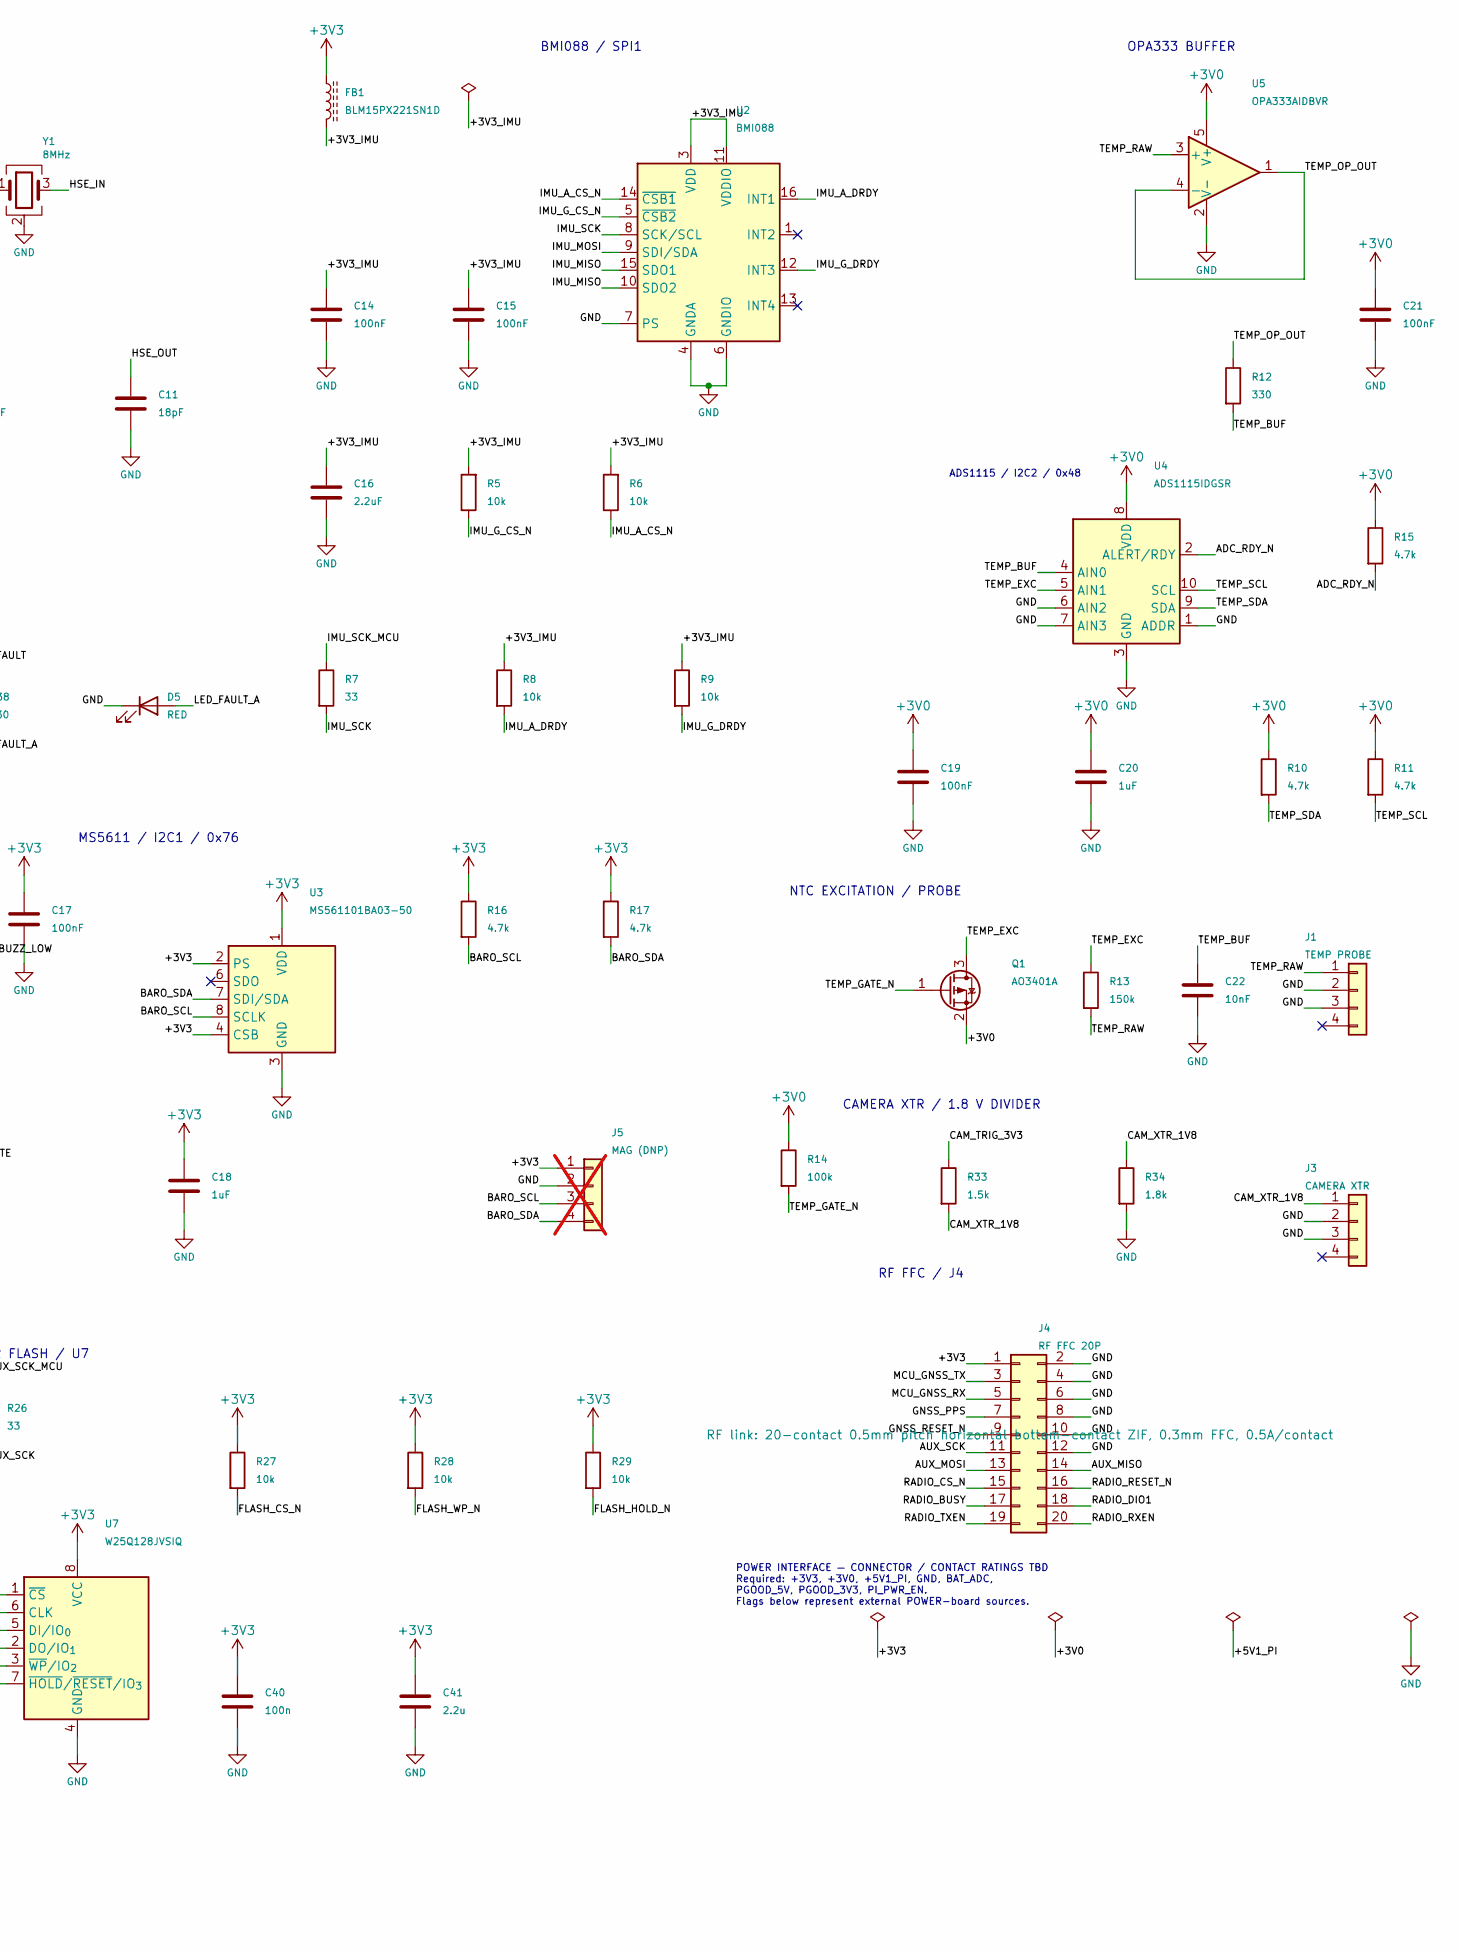
[picture p87: schematic cansat_main.kicad_sch, CANSAT MAIN — MCU, sensors and interfaces, part in row 1, column 2]

Parts:
BZ1: CMT-8504-100-SMT-TR; MagneticBuzzer_CUI_CMT-8504-100-SMT; MPN CMT-8504-100-SMT-TR; JLCPCB C22359707
C1, C2, C3, C4, C6, C9, C12, C14, C15: 100nF; C_0402_1005Metric; MPN CL05B104KO5NNNC; LCSC C1525
C5: 4.7uF; C_0805_2012Metric; Voltage Rating 16V; Tolerance 10%; Manufacturer Part Number CL21A475KOFNNNE; JLCPCB Part # C1746
C7, C8: 2.2uF; C_0603_1608Metric; MPN CL10A225KP8NNNC; LCSC C1607
C10, C11: 18pF; C_0402_1005Metric; MPN CL05C180JB5NNNC; LCSC C307443
C13: 1uF; C_0402_1005Metric; MPN CL05A105KA5NQNC; LCSC C52923
C16: 2.2uF; C_0402_1005Metric; Manufacturer Part Number CL05A225KA5NUNC; JLCPCB Part # C307418
C17, C19, C21: 100nF; C_0402_1005Metric; Manufacturer Part Number CL05B104KO5NNNC; JLCPCB Part # C1525
C18, C20: 1uF; C_0402_1005Metric; Manufacturer Part Number CL05A105KA5NQNC; JLCPCB Part # C52923
C22: 10nF; C_0402_1005Metric; Manufacturer Part Number CL05B103KB5NNNC; JLCPCB Part # C15195
C40, C42: 100n; C_0402_1005Metric; MPN CL05B104KO5NNNC; JLCPCB C1525
C41: 2.2u; C_0402_1005Metric; MPN CL05A225KA5NUNC; JLCPCB C307418
C43: 100nF; C_0402_1005Metric; MPN CL05B104KO5NNNC; JLCPCB C1525
C44: 22uF; C_0805_2012Metric; MPN CL21A226MAYNNNE; JLCPCB C602037
D3: SS14; D_SMA; MPN SS14; JLCPCB C2480
D4, D5: RED; LED_0402_1005Metric; MPN 16-213SDRC/S530-A3/TR8; JLCPCB C71911
FB1: BLM15PX221SN1D; L_0402_1005Metric; Manufacturer Part Number BLM15PX221SN1D; JLCPCB Part # C160973
H1, H2, H3, H4: MountingHole_Pad; MountingHole_2.2mm_M2_DIN965_Pad
J1: TEMP PROBE; JST_GH_BM04B-GHS-TBT_1x04-1MP_P1.25mm_Vertical; MPN BM04B-GHS-TBT(LF)(SN); LCSC C161692
J2: PI HARNESS; JST_GH_BM08B-GHS-TBT_1x08-1MP_P1.25mm_Vertical; MPN BM08B-GHS-TBT(LF)(SN); JLCPCB C133062
J3: CAMERA XTR; JST_GH_BM04B-GHS-TBT_1x04-1MP_P1.25mm_Vertical; MPN BM04B-GHS-TBT(LF)(SN); JLCPCB C161692
J4: RF FFC 20P; Hirose_FH12-20S-0.5SH_1x20-1MP_P0.50mm_Horizontal; MPN FH12-20S-0.5SH(55); JLCPCB C596730
J5: MAG (DNP); JST_GH_BM04B-GHS-TBT_1x04-1MP_P1.25mm_Vertical; MPN BM04B-GHS-TBT(LF)(SN); JLCPCB C161692; not fitted
Q1: AO3401A; SOT-23; MPN AO3401A; LCSC C15127
Q3: AO3400A; SOT-23; MPN AO3400A; JLCPCB C20917
R1: 10; R_0402_1005Metric; MPN RC0402FR-0710RL; LCSC C138066
R2, R3, R4, R5, R6: 10k; R_0402_1005Metric; MPN RC0402FR-0710KL; LCSC C60490
R7: 33; R_0402_1005Metric; MPN RC0402FR-0733RL; LCSC C138002
R8, R9: 10k; R_0402_1005Metric; Manufacturer Part Number RC0402FR-0710KL; JLCPCB Part # C60490
R10, R11: 4.7k; R_0402_1005Metric; MPN RC0402FR-074K7L; LCSC C105871
R12: 330; R_0402_1005Metric; Manufacturer Part Number RC0402FR-07330RL; JLCPCB Part # C105875
R13: 150k; R_0402_1005Metric; Manufacturer Part Number RT0402BRD07150KL; JLCPCB Part # C852538
R14: 100k; R_0402_1005Metric; Manufacturer Part Number RC0402FR-07100KL; JLCPCB Part # C60491
R15, R16, R17: 4.7k; R_0402_1005Metric; Manufacturer Part Number RC0402FR-074K7L; JLCPCB Part # C105871
R26, R35: 33; R_0402_1005Metric; MPN RC0402FR-0733RL; JLCPCB C138002
R27, R28, R29, R30, R32: 10k; R_0402_1005Metric; MPN RC0402FR-0710KL; JLCPCB C60490
R31, R36: 100k; R_0402_1005Metric; MPN RC0402FR-07100KL; JLCPCB C60491
R33: 1.5k; R_0402_1005Metric; MPN RC0402FR-071K5L; JLCPCB C114759
R34: 1.8k; R_0402_1005Metric; MPN RC0402FR-071K8L; JLCPCB C163481
R37, R38: 330; R_0402_1005Metric; MPN RC0402FR-07330RL; JLCPCB C105875
TP1, TP2, TP3: TestPoint; TestPoint_Pad_D1.0mm
TP4: VTREF; TestPoint_Pad_D1.0mm
TP5: GND; TestPoint_Pad_D1.0mm
TP6: BOOT0; TestPoint_Pad_D1.0mm
U1: STM32F405RGT6; LQFP-64_10x10mm_P0.5mm_CoreSilk; MPN STM32F405RGT6; LCSC C15742
U2: BMI088; Bosch_LGA-16_4.5x3mm_P0.5mm_LayoutBorder7x1y_ClockwisePinNu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; MPN BMI088; LCSC C194919
U3: MS561101BA03-50; LGA-8_3x5mm_P1.25mm; MPN MS561101BA03-50; LCSC C15639
U4: ADS1115IDGSR; TSSOP-10_3x3mm_P0.5mm; MPN ADS1115IDGSR; LCSC C37593
U5: OPA333AIDBVR; SOT-23-5; Manufacturer Part Number OPA333AIDBVR; JLCPCB Part # C30878
U6: SN74LVC2G125DCUR; VSSOP-8_2.3x2mm_P0.5mm; MPN SN74LVC2G125DCUR; JLCPCB C21404
U7: W25Q128JVSIQ; SOIC-8_5.3x5.3mm_P1.27mm; MPN W25Q128JVSIQ; LCSC C97521
Y1: 8MHz; Crystal_SMD_3225-4Pin_3.2x2.5mm; Manufacturer Part Number X32258MOB4SI; JLCPCB Part # C2682775

Connections:
+3V0: C19.1, C20.1, C21.1, Q1.2 (S), R10.1, R11.1, R14.1, R15.1, U4.8 (VDD), U5.5 (V+)
+3V3: BZ1.1 (+), C1.1, C2.1, C3.1, C4.1, C5.1, C6.2, C17.1, C18.1, C40.1, C41.1, C42.1, C43.1, C44.1, D3.1 (K), FB1.1, J4.1, J5.1, R1.2, R3.1, R16.1, R17.1, R27.1, R28.1, R29.1, R30.1, R32.1, TP4.1 (1_1), U1.1 (VBAT), U1.19 (VDD), U1.32 (VDD), U1.48 (VDD), U1.64 (VDD), U3.1 (VDD), U3.2 (PS), U3.4 (CSB), U3.5 (CSB), U6.8 (VCC), U7.8 (VCC)
/+3V3_IMU: C14.1, C15.1, C16.1, FB1.2, R5.2, R6.2, R8.1, R9.1, U2.3 (VDD), U2.11 (VDDIO)
/+5V1_PI: J2.1, J2.3, J2.5
/ADC_RDY_N: R15.2, U1.41 (PA8), U4.2 (ALERT/RDY)
/AUX_MISO: J4.14, U1.35 (PB14), U7.2 (DO/IO_{1})
/AUX_MOSI: J4.13, U1.36 (PB15), U7.5 (DI/IO_{0})
/AUX_SCK: J4.11, R26.2, U7.6 (CLK)
/AUX_SCK_MCU: R26.1, U1.34 (PB13)
/BARO_SCL: J5.3, R16.2, U1.58 (PB6), U3.8 (SCLK)
/BARO_SDA: J5.4, R17.2, U1.59 (PB7), U3.7 (SDI/SDA)
/BOOT0: R2.2, TP6.1 (1_1), U1.60 (BOOT0)
/BOOT1: R4.1, U1.28 (PB2)
/BUZZ_GATE: Q3.1 (G), R35.2, R36.1
/BUZZ_LOW: BZ1.2 (-), D3.2 (A), Q3.3 (D)
/BUZZ_PWM: R35.1, U1.61 (PB8)
/CAM_TRIG_3V3: R33.1, U1.17 (PA3), U1.26 (PB0)
/CAM_XTR_1V8: J3.1, R33.2, R34.1
/FLASH_CS_N: R27.2, U1.33 (PB12), U7.1 (~CS)
/FLASH_HOLD_N: R29.2, U7.7 (~HOLD/~RESET/IO_{3})
/FLASH_WP_N: R28.2, U7.3 (~WP/IO_{2})
/GNSS_PPS: J4.7, U1.14 (PA0)
/GNSS_RESET_N: J4.9, U1.57 (PB5)
/HSE_IN: C10.1, U1.5 (PH0), Y1.3
/HSE_OUT: C11.1, U1.6 (PH1), Y1.1
/IMU_A_CS_N: R6.1, U1.24 (PC4), U2.14 (~CSB1)
/IMU_A_DRDY: R8.2, U1.16 (PA2), U2.16 (INT1)
/IMU_G_CS_N: R5.1, U1.25 (PC5), U2.5 (~CSB2)
/IMU_G_DRDY: R9.2, U1.15 (PA1), U2.12 (INT3)
/IMU_MISO: U1.22 (PA6), U2.10 (SDO2), U2.15 (SDO1)
/IMU_MOSI: U1.23 (PA7), U2.9 (SDI/SDA)
/IMU_SCK: R7.2, U2.8 (SCK/SCL)
/IMU_SCK_MCU: R7.1, U1.21 (PA5)
/LED_FAULT: R38.1, U1.20 (PA4)
/LED_FAULT_A: D5.2 (A), R38.2
/LED_STATUS: R37.1, U1.11 (PC3)
/LED_STATUS_A: D4.2 (A), R37.2
/MCU_GNSS_RX: J4.5, U1.52 (PC11)
/MCU_GNSS_TX: J4.3, U1.51 (PC10)
/MCU_PI_RX: R32.2, U1.43 (PA10), U6.3
/MCU_PI_TX: U1.42 (PA9), U6.2
/MCU_TO_PI_UART: J2.7, U6.6
/NRST: C9.1, R3.2, TP1.1 (1_1), U1.7 (NRST)
/PI_TO_MCU_UART: J2.8, R31.1, U6.5
/PI_UART_OE_N: R30.2, U1.62 (PB9), U6.1, U6.7
/RADIO_BUSY: J4.17, U1.39 (PC8)
/RADIO_CS_N: J4.15, U1.37 (PC6)
/RADIO_DIO1: J4.18, U1.40 (PC9)
/RADIO_RESET_N: J4.16, U1.38 (PC7)
/RADIO_RXEN: J4.20, U1.54 (PD2)
/RADIO_TXEN: J4.19, U1.53 (PC12)
/SWCLK: TP3.1 (1_1), U1.49 (PA14)
/SWDIO: TP2.1 (1_1), U1.46 (PA13)
/TEMP_BUF: C22.1, R12.2, U4.4 (AIN0)
/TEMP_EXC: Q1.3 (D), R13.1, U4.5 (AIN1)
/TEMP_GATE_N: Q1.1 (G), R14.2, U1.27 (PB1)
/TEMP_OP_OUT: R12.1, U5.1, U5.4 (-)
/TEMP_RAW: J1.1, R13.2, U5.3 (+)
/TEMP_SCL: R11.2, U1.29 (PB10), U4.10 (SCL)
/TEMP_SDA: R10.2, U1.30 (PB11), U4.9 (SDA)
/VCAP1: C8.1, U1.31 (VCAP_1)
/VCAP2: C7.1, U1.47 (VCAP_2)
/VDDA: C12.2, C13.2, R1.1, U1.13 (VDDA)
BAT_ADC: U1.8 (PC0)
GND: C1.2, C2.2, C3.2, C4.2, C5.2, C6.1, C7.2, C8.2, C9.2, C10.2, C11.2, C12.1, C13.1, C14.2, C15.2, C16.2, C17.2, C18.2, C19.2, C20.2, C21.2, C22.2, C40.2, C41.2, C42.2, C43.2, C44.2, D4.1 (K), D5.1 (K), H1.1 (1_1), H2.1 (1_1), H3.1 (1_1), H4.1 (1_1), J1.2, J1.3, J2.2, J2.4, J2.6, J3.2, J3.3, J4.2, J4.4, J4.6, J4.8, J4.10, J4.12, J5.2, Q3.2 (S), R2.1, R4.2, R31.2, R34.2, R36.2, TP5.1 (1_1), U1.12 (VSSA), U1.18 (VSS), U1.63 (VSS), U2.2 (GNDA), U2.4 (GNDA), U2.6 (GNDIO), U2.7 (PS), U3.3 (GND), U4.1 (ADDR), U4.3 (GND), U4.6 (AIN2), U4.7 (AIN3), U5.2 (V-), U6.4 (GND), U7.4 (GND), Y1.2 (G), Y1.4 (G)
PGOOD_3V3: U1.2 (PC13)
PGOOD_5V: U1.9 (PC1)
PI_PWR_EN: U1.10 (PC2)

Notes on the sheet:
STM32F405 / PIN ASSIGNMENT
POWER INTERFACE — CONNECTOR / CONTACT RATINGS TBD Required: +3V3, +3V0, +5V1_PI, GND, BAT_ADC, PGOOD_5V, PGOOD_3V3, PI_PWR_EN. Flags below represent external POWER-board sources.
U6 = selected SN74LVC2G125DCUR; U7 = W25Q128JVSIQ. Legacy BOM U10 -> U6; U11 -> U7. J5 is optional / DNP. Camera CSI/power connects directly to Pi. Pi 3V3 stays separate.
SPI2 FLASH / U7
MS5611 / I2C1 / 0x76
CAMERA XTR / 1.8 V DIVIDER
GROUNDED M2 HOLES — POSITIONS TO BE SET IN PCB LAYOUT
OPA333 BUFFER
PI UART ISOLATION / J2
RF FFC / J4
RECOVERY / STATUS
BMI088 / SPI1
NTC EXCITATION / PROBE
MCU SUPPLY / RESET / BOOT / 8 MHz CLOCK
ADS1115 / I2C2 / 0x48
SWD / RESET / BOOT0 PADS

Board: 4 copper layers, 87 parts (0 on the bottom side), 64 nets, no tracks yet.
